pekeppp/2D_Rendering_Acceleration-deprecated-v3.2/doc/赛题二_设计实现与测试报告.md

# 【赛题二】基于 RISC-V 与 FPGA 异构架构的 2D 图形渲染加速引擎
## —— 设计、实现与测试报告

> **作品名称**：《芯绘 · CHIPPAINT》
> **目标平台**：易灵思 Titanium **Ti60F225I3**（16nm，60K LE，F225 BGA）+ Sapphire RISC-V SoC + 256MB DDR3
> **报告口径**：本文所有数字都标了来源 —— **【板测】** = 已在真板上量到；**【仿真】** = 只有 iverilog/QEMU 数据；
> **【模型】** = 由板测数据拟合出来的推算值。凡是"应该"、没有证据的，一律写进第 11 章"已知限制"，不混进结论。

---

## 0. 摘要

本作品在 RISC-V + FPGA 异构平台上实现了一款**自研的 2D 位块传输（BitBlt）硬件加速引擎**，
把"逐像素搬运"这件事从 CPU 手里彻底拿走：RISC-V 只负责高层逻辑与指令下发，
像素级的搬运、Alpha 混合、颜色键控抠图全部由 FPGA 硬件完成。

工程从 v1 迭代到 **v3.2**，中间经历了 **14 次板级问题定位与修复**（非对齐 lane、
指令 FIFO 满丢字、Alpha 定点抽头取错、写仲裁器 AW 握手漏计数、扫描输出饿死 CPU、
读仲裁 `cnt_s` 泄漏、引擎"假完成"导致的 z 序乱跳……），
每一步都留下了 testbench 与 A/B 对照，最终 **44 项 RTL 回归 0 失败**。

三项赛题高阶挑战全部落地：

| 挑战 | 实现 | 证据 |
| --- | --- | --- |
| **硬件 Alpha 混合** | `pixel_path.v` 用 DSP 做定点乘加，支持 alpha / 加算 / 乘法三种混合模式 + 逐像素 ARGB4444/1555 + 全局 alpha | `tb_attr_blend` 32 条判据（含 7 条手算期望值）全过 |
| **颜色键控去背** | 16bit 比较器，整词全键色不提交（省写）；另有 4×4 透明块掩码进一步跳过整块 | `tb_px_path` / `tb_dl_mask` 逐像素比对金标准 |
| **高负载互动游戏 Demo** | `GameDemo`：纵版弹幕游戏，同屏元素（弹+机+火花+星空）全部由引擎绘制；串口 `g` 自动爬坡量化 60FPS 下的同屏极限 | 主机全固件仿真 74 项 + 上位机协议 53 项，0 失败；**基础版已上板跑通** |

**关键性能（板测，v2.16 单 lane 口径）**：

| 精灵尺寸 | FILL | KEY（色键） | ALPHA（混合） |
| --- | --- | --- | --- |
| 16×16 | **514.3** 拍/精灵 | **719.1** | **856.4** |
| 32×32 | 1263.8 | 1617.4 | 1969.0 |
| 64×64 | 4450.0 | 5537.5 | 6742.7 |

拟合式 `每块 = A + B×像素`：FILL `252 + 1.025·px`、KEY `398 + 1.255·px`、ALPHA `464 + 1.533·px`。
60fps 帧预算 1,666,667 拍（core 100MHz）⇒ 16×16 ALPHA 理论 **1946 只/帧**，
取 70% 预算做安全余量 **1362 只/帧**【模型】。

**与纯 CPU 的差距**：同一场景、同一份图集，CPU 逐像素直写 vs 引擎 BitBlt，
同屏几百个精灵时帧率差 **1~2 个数量级**（`FinalDemo` 左右分屏实时对比，`HW=` / `CPU=` 两个数同屏显示）。

---

## 1. 项目概述与交付清单

### 1.1 一句话架构

```
┌───────────────────────────────┐        ┌──────────────────────────────────────────┐
│  RISC-V（Sapphire SoC, 100MHz）│        │  FPGA 2D 加速引擎（自研 RTL）             │
│                               │        │                                          │
│  游戏 / GUI 逻辑              │        │  ① blt_regs_axi_lite  AXI-Lite 寄存器组   │
│  碰撞、生成、AI（只算不画）   │        │  ② cmd_fifo            256 条指令队列     │
│  ↓                            │  8 字  │  ③ blt_engine_fsm      主控状态机         │
│  下发渲染指令 ────────────────┼───────►│  ④ pixel_path         像素通路（双 lane） │
│                               │ APB→   │      · FILL / COPY / ALPHA / KEY          │
│  ↑                            │ AXI    │      · DSP 定点混合 + 色键抠图            │
│  FPS / 寄存器回读 ◄───────────┼───────►│  ⑤ axi_rd_master / axi_wr_master          │
│                               │        │  ⑥ dl_fetch           显示列表取指器       │
│  C 驱动 + 双/三缓冲           │        │                                          │
└───────────────────────────────┘        └──────────────┬───────────────────────────┘
         ▲                                              │ AXI4 突发
         │ UART 115200（串口上位机遥控）                 ▼
         │                                    ┌────────────────────┐
    PC（Web Serial 上位机）                    │ DDR3 256MB 16bit   │
                                              │  帧缓冲 / 图集 /  DL │
                                              └─────────┬──────────┘
                                                        │ 扫描输出
                                              ┌─────────▼──────────┐
                                              │ fb_scanout → HDMI   │
                                              │ 1920×1080 @60.1Hz   │
                                              └────────────────────┘
```

### 1.2 交付清单

| 类别 | 内容 | 位置 |
| --- | --- | --- |
| **加速器 RTL** | 12 个模块（≈4,000 行）+ **30 个 testbench**（≈13,600 行） | `rtl/`、`ARC_2DRA/rtl/video/tb/` |
| **板级集成 RTL** | APB 外设顶层、写仲裁器、扫描输出、HDMI 编码 | `ARC_2DRA/rtl/` |
| **位流** | v3.2 位流 + 两个"位流+应用"合一镜像 | `firmware/v3.2/` |
| **应用固件** | 7 个 demo（FinalDemo / AdDemo / GameDemo / fulltest / comptest / comptest2 / FBtest） | `ARC_2DRA/.../standalone/` |
| **上位机** | 4 个单文件 Web Serial 上位机（无外部依赖） | `tools/*.html` |
| **验证工具** | 主机全固件仿真（QEMU）、协议自检（Node）、一键流水线 | `tools/host_selfcheck_game/`、`tools/build_gamedemo.ps1` |
| **文档** | 设计/性能/问题记录/日志共 20+ 篇 | `doc/`、`rtl/功能清单.md` |

---

## 2. 赛题要求逐条对照

### 2.1 基础要求

#### 要求 1：硬件 2D 位块传输（BitBlt）引擎设计

| 赛题原文 | 本作品实现 | 证据 |
| --- | --- | --- |
| FPGA 端解析 RISC-V 发送的渲染指令（**操作类型、源地址、目的地址、宽度、高度**） | 每条形如 **8 个 32bit 字** 写 `CMD_FIFO_DATA(0x08)`：`op / src / dst / src_stride / dst_stride / {H,W} / alpha / color`。`op`：`0=COPY 1=FILL 2=ALPHA 3=KEY` | `rtl/cmd_fifo.v`、`rtl/blt_engine_fsm.v`；`tb_cmd_fifo`、`tb_blt_top` |
| 支持**图像块拷贝（Block Copy）** | `op=0`，源/目的各自带行距，支持任意地址、任意尺寸、非 16B 对齐 | `tb_blt_burst` / `tb_blt_unalign`（U1~U12，lane 0..7 全扫） |
| 支持**纯色填充（Solid Fill）** | `op=1`，`w7` 直接给 RGB565 填充色 | `tb_blt_top`、`tb_perf_probe` |
| 生成**标准 VGA/HDMI 时序**，输出到显示器（**≥640×480@60Hz**） | `fb_scanout.v` + `video_timing_1080p.v` 生成 CEA-861 **1920×1080** 时序（H 总 2200、V 总 1125）⇒ **实际 60.10Hz**，远高于 640×480@60Hz 的下限；帧缓冲 960×540 由扫描输出侧 `SCALE_SH` 放大到 1080p | `ARC_2DRA/rtl/video/video_timing_1080p.v`、`dvi_tx/`；`tb_fb_scanout`、`tb_scanout_scale` |

> **关于"最低分辨率"**：赛题下限是 640×480@60Hz。本作品用 **960×540 RGB565** 帧缓冲，
> 扫描输出到 **1080p@60.1Hz**。放大放在扫描输出侧（`SCALE_SH`），**DDR 带宽零增量**；
> 若把帧缓冲直接做成 1080p，DDR 流量会从 62MB/s 翻到 124MB/s —— 这是刻意避免的。

#### 要求 2：总线读写与存储器优化

| 赛题原文 | 本作品实现 | 证据 |
| --- | --- | --- |
| 加速器通过**系统总线**直接访问内存 | AXI4 主机读写（`axi_rd_master` / `axi_wr_master`），寄存器面走 **AXI-Lite**，板级经 `blt_apb_top.v` 挂在 APB 上（`0xF8100000`） | `rtl/blt_top.v`、`ARC_2DRA/rtl/blt/blt_apb_top.v` |
| 合理使用**突发传输（Burst Transfer）** | 内部按 **16B（128bit）一个词** 打包，`MAX_BURST=16` 的 AXI 突发；写主机做了**突发合并**（`burst_max` 从 1 提到 16，`burst_avg=16.0`） | `rtl/axi_wr_master.v`；`tb_perf_probe` 探针输出 `burst_max=16 burst_avg=16.0` |
| 使用**内部 FIFO 缓存**提高带宽利用率 | ① 256 条指令 FIFO（BRAM 可推断，见 §10 资源修复）；② 写数据 FIFO 深度 16；③ 源读取器**双词槽预取**；④ 扫描输出**四行缓冲环** | `rtl/cmd_fifo.v`、`rtl/sync_fifo.v`、`rtl/stream_reader.v`、`fb_scanout.v` |
| 提高内存带宽利用率 | 整屏 FILL 实测 **0.9958 px/拍**【板测，单 lane】；v3.1 双 lane 仿真 **1.983 px/拍**（**2.0×**） | `tb_perf_probe`：`cyc/px=0.504257 px/cyc=1.983114`（v3.1/v3.2） |

> **DDR 不是瓶颈，读延迟才是**。实测 DDR 占用只有峰值的 9%~28.5%，
> 但"非引擎读流"曾等待 **39,998 拍** —— 所以工程的优化重点一直放在**读仲裁公平性**上（见 §10 第 5、6 条）。

#### 要求 3：软件驱动与基础 Demo

| 赛题原文 | 本作品实现 | 证据 |
| --- | --- | --- |
| RISC-V 端 **C 语言驱动程序**配置寄存器 | `blt_wr/blt_rd` 薄封装 + 语义化 `e_fill/e_key/e_alpha/e_glow`，**所有绘制收敛到唯一出口 `blt_emit()`**（保证"每条命令恰好一个属性字"的配对纪律） | `FinalDemo.c` / `AdDemo.c` / `GameDemo.c` |
| 实现**双缓冲机制**避免画面撕裂 | v2.6 实现 **FLIP**（`FB_SEL` 请求 / `FB_STAT` 已生效，帧边界锁存）；v2.7 升级为**三缓冲**（显示 A / 画 B / 预清 C）+ 并发清屏引擎 + 帧边界中断 | `rtl/blt_regs_axi_lite.v:0x24/0x28/0x2C~0x48`；`tb_scanout_flip`、`tb_clear_engine` |
| 提供**基础测试 Demo**（大量方块随机移动 / 大图快速切换） | `FinalDemo`：N 可达 6000 个方块随机运动 + 弹跳，三条渲染路径任意切换 | `standalone/FinalDemo/src/FinalDemo.c`（2252 行） |
| 实时对比显示**纯软件 CPU 渲染**与**硬件加速渲染**的频率差异 | `FinalDemo`：**同屏分屏**——上半屏硬件引擎画、下半屏 CPU 逐像素画，同一颗种子、同一套推进规则 ⇒ 目标坐标逐位相同，差异只体现在"谁跟得上"；屏幕顶部同屏显示 `HW=nnn CPU=nnn SCR=nn` | 同上；`s/c/h` 三个键切换 SPLIT / 纯 CPU / 纯硬件 |

> **口径诚实性**是这一条的关键：CPU 侧**故意保留**"先擦后画 + 逐块擦旧矩形"的朴素语义、
> 不跟随硬件侧的"每趟整片重铺"优化 —— 否则对比就变成"两种不同工作量的对比"。

### 2.2 高阶挑战

#### 挑战 1：硬件 Alpha 混合

**赛题公式**：`输出像素 = 前景像素 × Alpha + 背景像素 × (1 – Alpha)`

**实现**（`rtl/pixel_path.v`）：

```verilog
// 通道 5/6/5 → 8bit 位复制展开
R8 = {fg[15:11], fg[13:11]};   // 5→8，位复制
G8 = {fg[10: 5], fg[ 8: 5]};   // 6→8
B8 = {fg[ 4: 0], fg[ 2: 0]};   // 5→8
// 定点混合（两积之和必须 18bit）
out = (fg8 * A + bg8 * (255 - A) + 127) >> 8;   // 再量化回 5/6/5
```

**三个层次的可编程性**（v3.2 属性侧口，`0x8C ATTR_PORT`）：

| 项 | 位域 | 说明 |
| --- | --- | --- |
| `blend_mode` | `[3:0]` | `0`=按算子默认 / `1`=alpha 混合 / `2`=加算饱和 / `3`=乘法 |
| `src_format` | `[5:4]` | `0`=RGB565 / `1`=ARGB1555 / `2`=**ARGB4444（逐像素 4bit alpha）** |
| `global_alpha` | `[13:6]` | 整条命令的全局淡入淡出系数 |
| `flags` | `[31:24]` | bit0 = alpha 测试（跳过完全透明像素）/ bit1 = 强制不透明 |

有效 alpha：`A = ⌊sprite_alpha · global_alpha / 255⌋`，
其中 `sprite_alpha` 可以来自**命令字**（`w6`，8bit）、**描述符**（`dw2[23:16]`，8bit）、
**属性字**（`global_alpha`，8bit）或**像素本身**（ARGB4444 的 4bit）。

**验证**：`tb_attr_blend.v`（545 行）32 条判据全过，其中 **7 条手算期望值**：

| 用例 | 输入 | 期望输出 |
| --- | --- | --- |
| L1 | `7BEF/C618 @ ga=128` | `A4F4` |
| L2 | 乘法模式 | `5AEB` |
| L3 | 加算 `1082/2945` | `39C7` |
| L4 | ARGB4444 `8ABC @ ga=128` | `BE18` |
| L5 | ARGB1555 `87E0 @ ga=64` | `B692` |
| L6 | `α=0` + alpha 测试 | 留孔（不写） |

> ★ L1~L6 这 7 条手算值**抓到过 TB 作者自己的位抽取错误**（把 `R8={r,r[4:2]}` 写成 `{r,r[2:0]}`）——
> 纠正后与 RTL 逐位一致。"表与 RTL 不一致时先怀疑表"这条经验也是那次留下的。

#### 挑战 2：颜色键控去背（Color Keying）

| 层 | 做法 | 收益 |
| --- | --- | --- |
| 像素级 | 16bit 比较器 `keep = (fg != key)`，键色由 `w7` 每命令可编程（软件约定洋红 `0xF81F`） | 不规则边缘精灵完美抠图 |
| **整词级** | 一个 128bit 词（8 个像素）**全部**等于键色 ⇒ **不提交这次写** | 省写带宽 |
| **块级（S3，v2.12）** | 4×4 网格覆盖整颗精灵，位 `rt*4+ct=1` 表示"这一块一个像素都不用碰"（不取数、不 blend、不写）。判据：该块**每一个**像素都等于色键才置 1 | 只收缩行两端 |

掩码生效条件（RTL 里显式限定）：`MASK_EN && OP==KEY && W≥4 && H≥4`；
FILL/ALPHA/COPY **显式忽略**掩码（测试台用全 1 掩码反证过）。

**实测收益**（`tb_dl_mask`）：收益完全取决于美术 —— 圆盘精灵 **0%**（每个 4×4 块都压着实体像素），
典型弹幕 **−4.5% / −21.4%**，小尺寸弹 **−68.1%**。

#### 挑战 3：高负载互动游戏 Demo

见第 7 章（完整展开）。

### 2.3 技术提示对照

| 提示 | 本作品 |
| --- | --- |
| 总线推荐 AXI4 或 Wishbone | **AXI4** 主机读写 + AXI-Lite 寄存器面（板级经 APB 桥） |
| 显存组织建议双帧缓冲 | 双缓冲 → **三缓冲 FLIP**（v2.7），上屏零 DDR 搬运 |
| 指令队列：设计指令 FIFO 允许批量下发 | `cmd_fifo` **256 条**；另有 **显示列表**（DDR 描述符表，硬件取指展开）作为更高阶的替代 |
| 性能测量：显示实时 FPS 并对比纯软件 | `FinalDemo` 同屏 `HW=` / `CPU=` / `SCR=` 三个数；成本行 `EV cmd path done: n=.. cycles=.. cyc/sprite=..`（1Hz 门控） |

---

## 3. 硬件平台与系统架构

### 3.1 平台参数

| 项 | 参数 |
| --- | --- |
| FPGA | 易灵思 Titanium **Ti60F225I3**，16nm FinFET，**60K LE**，F225 BGA，VCC 0.95V，4 个 PLL + 内置 OSC |
| DDR3 | **MT41J128M16JT-125**，256MB (2Gb)，**16bit**，最高 800Mbps |
| Flash | GD25LQ64，8MB QSPI（位流 ~3.5MB + 应用） |
| 视频 | HDMI TX（HSIO 直出 TMDS，支持 1080p@60）；另有 HDMI RX / MIPI D-PHY / LVDS |
| 下载调试 | 板载 FT4232HL Type-C 一线通（供电 / 下载 / **UART**） |
| 主频 | core_clk = **100MHz**（`pt.sdc: create_clock -period 10.000`），pclk = 148.75MHz |
| 时序余量 | V3.0 P&R：setup slack **1.063ns**、hold slack 0.026ns、最高可分析频率 **111.894MHz** |

> **为什么不做 112.5MHz**：V3.0 的 P&R 硬证据给出上限 111.894MHz，hold slack 只剩 0.026ns ⇒ 不可行。
> 本工程的所有优化都建立在 100MHz 之上，不依赖超频。

### 3.2 时钟与视频时序

```
25MHz 板载晶振 ──► PLL_BR0 ──► pclk = 148.75MHz = 25 × 119 ÷ 20
                                   │
                              1920×1080 CEA-861
                              H: 1920 + 88 + 44 + 148 = 2200
                              V: 1080 +  4 +  5 +  36 = 1125
                              ⇒ 148.75MHz / (2200×1125) = 60.10 Hz
                              行周期 2200 / 148.75MHz = 14.81µs = 1481 core 拍 @100MHz
```

扫描输出的取数预算：一行 1920B = **120 拍 128bit**。
优化前占行周期 73%（1080 拍），v2.5 后降到 **≈250~400 拍（约 20%）**，
余量从 0 提到约 27%。这是"左侧黑三角闪烁"问题的根因，见 §10 第 5 条。

### 3.3 DDR3 内存映射

`DDR_BASE = 0x00001000`（`soc.h: SYSTEM_DDR_BMB`）；解码窗 `0xE0000000`。

| 偏移 | 用途 | 大小 |
| --- | --- | --- |
| `+0x000000` | 程序镜像（bootloader 从 SPI Flash 搬入） | 1MB（linker `default.ld`） |
| `+0x100000` | （保留 / 备用精灵区） | 2MB |
| `+0x200000` | **精灵图集** `ATLAS_BASE` | 8KB 级 |
| `+0x300000` | **显示缓冲 0** `FB_BASE`（只由引擎/扫描输出写） | ~1.04MB |
| `+0x500000` | **后台缓冲 1** `FB_BACK` | ~1.04MB |
| `+0x600000` | 缓存写穿屏障临时区 `FLUSH_SCRATCH` | 8KB |
| `+0x700000` | **第三块缓冲 2** `FB_BUF2`（三缓冲用） | ~1.04MB |
| `+0x800000` | **显示列表几何表** `DL_GEOM` | 176B |
| `+0x820000` / `+0x840000` | **显示列表缓冲 A / B** | 各 128KB |

**选址的四条理由**：① 避开程序镜像与堆；② **1MB 对齐** ⇒ 自动满足 16B DDR 突发、64B D\$ 行、
AXI 突发；③ 行距 1920B = 120×16B ⇒ 行首 16B 对齐、无跨行碎块；
④ 两块缓冲隔 1MB ⇒ 减少 DRAM 行/bank 冲突。

### 3.4 读/写通路与仲裁

**优先级：扫描输出 > BitBlt 引擎 > CPU**（两级级联 `axi_rd_arb`）。
写通路经 `axi_wr_arb`，B 通道按 owner 分路。

这个优先级不是随便定的：扫描输出有**硬死线**（一行 1481 拍），错过就出黑行；
引擎次之（有帧预算）；CPU 没有死线（慢一点只是游戏逻辑慢）。实测最长等待：

| 场景 | 最长等待 | 出处 |
| --- | --- | --- |
| 优化前，扫描输出抢不到读通道 | **16,071 拍 ≈ 80 行** | `功能清单.md §13` |
| 加 `S_PRIO` 后 | **211 拍** | `功能清单.md §13.6` |

---

## 4. 加速器 RTL 设计

### 4.1 模块划分（`rtl/`，12 个模块 ≈4,000 行）

| 模块 | 行数 | 职责 |
| --- | --- | --- |
| `blt_top.v` | 446 | 引擎顶层：三块子模块 + 写仲裁 + 完成判据合成 |
| `blt_regs_axi_lite.v` | 660 | AXI-Lite 从机 + **完整寄存器组**（0x00~0xB0）+ 属性 FIFO + scissor + LUT 端口 |
| `blt_engine_fsm.v` | 524 | 主控状态机：`S_DEC → S_CHUNK → S_GEOM → S_FILL/S_PUSH → S_WDWAIT → S_DRAIN` |
| `blt_addr_gen.v` | 37 | 纯组合行地址 + 覆盖突发计算 |
| `axi_rd_master.v` | 156 | AXI4 主机读（含 `LEAK_TO` 泄漏看门狗、`AGE_MAX` 老化提权） |
| `axi_wr_master.v` | 219 | AXI4 主机写（突发合并 + `b_pending` 写提交屏障） |
| `pixel_path.v` | 825 | **像素通路**：FILL/COPY/ALPHA/KEY 四算子 + 双 lane + 三种混合模式 + 色键 + 掩码 |
| `stream_reader.v` | 131 | 源读取器：两词槽 + 载入即弹词（`0.889 → 2.0 px/拍`） |
| `cmd_fifo.v` | 75 | 指令 FIFO（BRAM 可推断，深 256 条） |
| `sync_fifo.v` | 76 | 参数化通用 FIFO |
| `clr_engine.v` | 280 | **并发清屏引擎**：后台把目标缓冲铺成背景色；与"正在显示/正在画"的缓冲**硬件互斥** |
| `dl_fetch.v` | 574 | **显示列表取指器（DFU）**：16B 描述符 → 展开成 8 字命令 → 推进同一个 cmd_fifo |

板级集成（`ARC_2DRA/rtl/`）：
`blt/blt_apb_top.v`（APB 外设）、`video/axi_wr_arb.v`、`video/axi_rd_arb.v`、
`video/fb_scanout.v`（666 行，含四行缓冲环 + 3×2×256 LUT）、`video/video_timing_1080p.v`、`video/dvi_tx/`。

### 4.2 指令与寄存器接口

#### 4.2.1 引擎指令：8 个 32bit 字

| 字 | 位 | 含义 |
| --- | --- | --- |
| `w0` | `[1:0]` | **op：0=COPY 1=FILL 2=ALPHA 3=KEY**（>3 ⇒ `STATUS.ERR`） |
| | `[2]` | `MASK_EN`（S3 透明块掩码使能） |
| | `[31:16]` | `MASK[15:0]`：4×4 透明块位图 |
| `w1` | `[31:0]` | `src` 源字节地址（FILL 忽略） |
| `w2` | `[31:0]` | `dst` 目的字节地址 |
| `w3` | `[31:0]` | 源字节行距 `src_stride` |
| `w4` | `[31:0]` | 目的字节行距 `dst_stride`（屏幕 = 1920） |
| `w5` | `[15:0]` / `[31:16]` | **W / H（像素）** |
| `w6` | `[7:0]` | alpha（仅 ALPHA） |
| `w7` | `[15:0]` | FILL 填充色 / KEY 键色（RGB565） |

写入方式：连续 8 次写 `0x08`。**不看 WSTRB**（整字入队）；FIFO 满时反压不丢字。

#### 4.2.2 寄存器映射（`BLT_BASE = 0xF8100000`，12bit 窗口）

| 偏移 | 名称 | R/W | 位域 / 说明 |
| --- | --- | --- | --- |
| `0x00` | `CTRL` | RW | bit0=GO，bit1=IRQ_EN(DONE)，bit2=**SOFT_RST**（脉冲；**会清空属性 FIFO**） |
| `0x04` | `STATUS` | R | bit0=BUSY，bit1=DONE（电平=FIFO空&&IDLE），bit2=**ERR（电平锁存，只有 SOFT_RST 能清）**，bit3=FIFO_EMPTY |
| `0x08` | `CMD_FIFO_DATA` | W | 连写 8 字 = 一条命令；满时 `awready/wready` 反压 |
| `0x0C` | `CMD_FIFO_COUNT` | R | **单位 = 指令条数**（`word_count/8`），深度 256 |
| `0x10` | `IRQ_STATUS` | W1C | bit0=DONE，bit1=**FRAME（每个场边界 1 拍）**，bit2=DL_DONE |
| `0x14` | `IRQ_EN` | RW | 同上三位 |
| `0x18` | `DBG_CUR_CMD` | R | 当前命令 `w0` |
| `0x1C` | `PERF` | R | **上一条命令的引擎周期数** |
| `0x20` | `SCAN_DBG` | R | `[15:0]` 扫描欠载行数，`[31:16]` 取数看门狗中止（正常恒 0） |
| `0x24` | `FB_SEL` | W | `[1:0]` **请求**显示缓冲（0/1/2），帧边界锁存 |
| `0x28` | `FB_STAT` | R | `[1:0]` **已生效**选择，`[31:16]` 场计数 |
| `0x2C` | `CLR_ADDR` | RW | 并发清屏引擎：起始字节地址 |
| `0x30` | `CLR_STRIDE` | RW | 字节/行 |
| `0x34` | `CLR_WH` | RW | `{h[31:16], w[15:0]}` |
| `0x38` | `CLR_COLOR` | RW | RGB565 背景色 |
| `0x3C` | `CLR_CTRL` | W | bit0=GO(脉冲)，`[3:2]`=目标缓冲，bit4=ERR_CLR(脉冲) |
| `0x40` | `CLR_STAT` | R | bit0=BUSY，bit1=目标已清，`[5:2]`=**四块 clean 位图**，bit6=ERR(sticky)，`[31:16]`=AW 突发数 |
| `0x44` | `DRAW_SEL` | RW | `[1:0]` 引擎正在画的缓冲（**写它会清该缓冲的 clean 位**） |
| `0x48` | `CLR_CYC` | R | 上次 clear 的周期数 |
| `0x4C`/`0x50` | `DL_BASE0/1` | RW | `[31:4]` 列表 A/B 基址（16B 对齐；**BUSY 期间写入被静默忽略**） |
| `0x54` | `DL_COUNT` | RW | `[15:0]` 描述符条数（0 = 合法空表，>4095 报错） |
| `0x58` | `DL_CTRL` | W | bit0=GO(脉冲)，bit1=ABORT，bit2=BUF_SEL，bit3=IRQ_EN，**bit4=AUTO_GO / bit5=STRICT_BOUNDS（复位为 1，每次写都要写回 1）** |
| `0x5C` | `DL_STATUS` | R | bit0=BUSY，bit1=DONE，bit2=ERR，bit3=ABORTED，bit4=**STALL（组合位）**，`[9:8]`=ACTIVE_BUF，`[31:16]`=CONSUMED |
| `0x60` | `DL_ERR` | W1C | `[0]`DESC_RANGE `[1]`GEOM_INDEX `[2]`GEOM_RANGE `[3]`SPRITE_BOUNDS `[4]`WATCHDOG `[5]`AXI_RRESP `[6]`DESC_COUNT `[7]`ZERO_SIZE `[23:16]`序号 `[24]`UNSUPPORTED |
| `0x64` | `DL_FAULT_ADDR` | R | 出错地址 |
| `0x68` | `DL_GEOM_BASE` | RW | `[31:4]` 几何表基址（16B/条） |
| `0x6C` | `DL_GEOM_MAX` | RW | `[15:0]` 条目数（**完整 16bit**；0 = 关表） |
| `0x70` | `DL_DST_BASE` | RW | 本列表目标缓冲基址 |
| `0x74` | `DL_CFG` | RW | bit0=PREFETCH_EN，bit1=GEOM_CACHE_EN，`[7:4]`=CHUNK(8)，`[11:8]`=FIFO_WM(4)；复位 `0x483` |
| `0x78` | `DL_TIMEOUT` | RW | `[15:0]` **单描述符看门狗，单位 core 拍**，复位 4096(≈41µs)，0=关 |
| `0x7C` | `DL_PERF` | R | 上次列表 GO→DONE 周期数（**仅 BUSY=0 后有效**） |
| `0x80` | `DL_VERSION` | R | 读回 `32'h0210_0002` |
| `0x84` | `DL_DST_STRIDE` | RW | `[15:0]` 目标字节行距 |
| `0x88` | `DL_FB_WH` | RW | `{h[31:16], w[15:0]}` |
| **`0x8C`** | **`ATTR_PORT`** | W | **属性 FIFO**（深 16 FWFT）。见 §2.2 挑战 1 的位域表；**只写不可读** |
| `0x90`/`0x94` | `CLIP_X0/X1` | RW | scissor 左(含)/右(**不含**)，**本条命令目的矩形的局部坐标** |
| `0x98`/`0x9C` | `CLIP_Y0/Y1` | RW | 上(含)/下(不含) |
| `0xA0` | `CLIP_CTRL` | RW | bit0=ENABLE（复位 0，**可回读**）；命令起始锁存 |
| `0xA4` | `LUT_ADDR` | RW | `[9:8]`=通道(0=R 1=G 2=B)，`[7:0]`=下标 |
| `0xA8` | `LUT_DATA` | W | `[7:0]`，写它产生 1 拍脉冲 |
| `0xAC` | `LUT_CTRL` | RW | bit0=ENABLE(立即生效)，bit1=**写 bank**（显示读的是帧边界锁存值的**反相**） |
| `0xB0` | `LUT_STAT` | R | bit0=正在显示的 bank |

### 4.3 像素通路

```
                ┌──────────── 双 lane（v3.1，只在 dst 偶 lane 上配对）─────────────┐
  16B/词 ──► 源读取器（两词槽预取，2.0 px/拍）
                │
                ├─► 色键比较器  keep = (fg != key)  ──► 整词全键色则不提交
                ├─► 4×4 块掩码（仅 KEY）           ──► 整块透明则跳过
                │
                └─► 【混合通路】唯一一份乘加单元，按 blend_mode 选式：
                        α混合   out = (fg·A + bg·(255−A) + 127) >> 8
                        加算     out = min(255, ⌊fg·A/255⌋ + bg)
                        乘法     out = (fg·bg) >> 8
                     └─► 量化回 5/6/5：{r8[7:3], g8[7:2], b8[7:3]}
                                    │
                            ┌───────▼────────┐
                            │ 128bit 打包器  │（打包乒乓：藏掉每词专属冲刷拍）
                            └───────┬────────┘
                                    ▼  AXI4 写突发（合并后 burst_max=16）
```

**关键性能改造（v3.x 三步走）**：

| 步 | 改动 | 收益 |
| --- | --- | --- |
| ① 像素打包乒乓 | 藏掉每 16B 词的专属冲刷拍 | 每词 9 拍 → 8 拍（**+11%**）**但依赖写主机也提到 8 拍/词** |
| ② 写突发合并真正生效 | 合并判据换口径 + `S_BUF` 愿意等 | 写主机从 **8 拍/词 → 1.13 拍/词** |
| ③ 命令末尾冲刷提示 | 给写主机"命令结束"显式输入 | 尾延迟三段收敛 |

> ★ 第 ① 步有一个值得记的教训：仿真里 `wd_full=0`、写主机 idle 66,988 拍，
> 看起来"写通路与像素通路打平、余量=0"；**板上 B 往返只要比仿真多 1 拍，这 11% 收益就会被吃光**。
> 所以第 ②③ 步不是"锦上添花"，而是第 ① 步能否兑现的前提。

### 4.4 显示列表（DFU 取指器，v2.11）

**动机**：板测"每块一次 CPU 下发"≈**190 拍/块**（1 读 COUNT + 8 写 DATA 走 APB 桥），
把 16×16 FILL 从引擎自身能到的 367 拍/块抬到 561 拍/块。

**做法**：DDR 里放**紧凑描述符表**，硬件取指器自己展开成与 CPU 逐位相同的 8 字命令，
推进**同一个** `cmd_fifo`（引擎 FSM / 像素通路一行未改）。

```
描述符 = 16B = 4 字 = 恰好 1 个 128bit AXI beat（小端）
  dw0 [15:0]=X(signed)  [31:16]=Y(signed)
  dw1 [15:0]=SPR_ID     [31:16]=FLAGS
  dw2 [15:0]=KEY(0xFFFF=用几何表默认) [23:16]=ALPHA [31:24]=PRIO
  dw3 [15:0]=MASK_ID    [23:16]=W_OVR [31:24]=H_OVR

FLAGS：[1:0]OP [2]MIRROR_X [3]MIRROR_Y [4]CLIP_EN [5]SIZE_OVR [6]SRC_OFF_EN
       [7]MASK_EN [9:8]MASK_MODE [10]END_OF_LIST [11]IRQ_AFTER [12]CHAIN
       （MIRROR / SRC_OFF / CHAIN / MASK_MODE≠01 未实现 ⇒ 报 DL_ERR.UNSUPPORTED）

几何表 = 16B/条（16 条直接映射 cache）
  gw0=ATLAS_BASE   gw1=[15:0]ATLAS_STRIDE [31:16]KEY_DEFAULT
  gw2=[15:0]W [31:16]H   gw3=[15:0]SX [31:16]SY
```

**板级现实**：ALPHA/KEY 场景的描述符取指会被 DDR 争用饿过 `DL_TIMEOUT`
（即使把看门狗从 4096 拍提到 65535 拍仍触发，`stall_seen=1`）。
固件写了**三条硬上界**的自动重试（一次事件最多 1 次、1s 窗口内第二次即停用、重试自身失败即停用），
避免退化成"同一帧反复重画整趟"的永久重试环。**结论：演示主力用逐条下发，列表路径作为可选加速。**

### 4.5 属性侧口 / scissor / 扫描输出 LUT（v3.2 / S5）

| 功能 | 关键设计 | 为什么这么做 |
| --- | --- | --- |
| **属性侧口** | 深 16 的 **FWFT** 属性 FIFO；引擎在**每条命令起始**（`S_DEC`，8 个命令字弹完后）按序弹一个 | 刻意**不用** `sync_fifo` 那种"同步读 + 假空窗口"——属性与命令按序配对，任何一次假空都会让后续属性整体错位（**静默错模式**） |
| **scissor** | 与 S3 的行窗口**求交**；整行在外则走"空窗口跳过"（不取数、不算、不写）。坐标是**本条命令目的矩形的局部坐标**，半开区间 `[x0,x1)×[y0,y1)`，命令起始锁存 | 完全不碰像素通路 ⇒ 关闭时**逐位原样返回**，零代价 |
| **扫描输出 LUT** | 3 通道 × 2 bank × 256 项 8bit→8bit，插在行缓冲之后、输出级之前；读地址由 `px1` 级组合给出 ⇒ **不新增流水级、不产生 1 像素相移** | 全屏淡入淡出/白闪**零 DDR 带宽** |

**兼容档保证**：`blend=0` 时属性字**整字惰性** ⇒ 四种算子与 v3.1 逐位相同。
默认字 `0x0000_3FC0` = 位域精确的"blend 0 / RGB565 / ga 255 / flags 0"。
**最强证据**：`tb_perf_probe` 的 310 行 `PROBE *` 输出与 v3.1 的日志**逐行完全一致**
（整屏 FILL 261,407 拍、`burst_max=16`/`burst_avg=16.0`、`wd_full_cyc=0`）⇒ **未使用时吞吐代价为零**。

### 4.6 资源与实现

| 项 | 数值 |
| --- | --- |
| 新增触发器（v3.2 S5） | ≈ +250（引擎侧属性/scissor ≈132，寄存器组侧 ≈99，scanout ≈8，**像素通路 0 个**，全是组合逻辑） |
| 新增存储 | 3 块 512×8 双口 RAM（LUT 三通道，各 1 个 18Kb BRAM 量级）+ 属性 FIFO 的 16×32 分布式 RAM |
| 时序 | V3.0 P&R 最紧路径**不在像素通路**（`u_eng.issue_r → u_dl.rd_beats`，slack 1.063ns @100MHz），上限 111.894MHz |

---

## 5. 软件层设计

### 5.1 驱动与 BSP

| 项 | 说明 |
| --- | --- |
| BSP | Efinity Sapphire SoC BSP（`bsp.h` → `soc.h/uart.h/clint.h/print.h`） |
| 时钟口径 | `SYSTEM_CLINT_HZ = 100000000`（core 域），`tick32()` 只读 CLINT mtime 低 32 位（1 次总线读，而不是 `clint_getTime` 的 3 次） |
| 寄存器访问 | `blt_wr(off,v) / blt_rd(off)` 两个薄封装（`BLT_BASE = 0xF8100000`） |
| 唯一命令出口 | `blt_emit(attr, op, src, dst, ss, ds, w, h, alpha, color)` —— 属性配对纪律靠它保证 |
| 缓存一致性 | `cache_evict()`：向 `FLUSH_SCRATCH` 写 8KB（**store 有序屏障**，D\$ 是写穿）。**禁用 `data_cache_invalidate_all()` 代替 flush**（写回模式下会丢脏行） |
| UART | 非阻塞轮询；**RX 占用 = `status[31:24]`**，TX 余量 = `status[23:16]`（早期用错 `>>16` 导致串口指令完全无效） |

### 5.2 双缓冲 → 三缓冲 → FLIP

| 版本 | 方案 | 代价 |
| --- | --- | --- |
| 早期 | 后台缓冲 → **整帧 COPY** → 显示缓冲 | 实测 ≈**1.89M 核拍 ≈ 19ms**/帧，**超过 16.7ms 场周期** ⇒ 上限被钉在 ~53fps |
| v2.6 | **FLIP**：写 `FB_SEL` 请求，扫描输出在帧边界锁存基址 | 一次 DDR 搬运都不做（省下 19ms 给内容） |
| v2.7 | **三缓冲**（显示 A / 画 B / 预清 C）+ **并发清屏引擎** + **帧边界中断** | 背景重铺也不进关键路径 |

**"不撕裂"的保证链**（每一条都有独立机理）：

1. 写 `FB_SEL` 只是**请求**，扫描输出在**垂直消隐起点**锁存 ⇒ 一场之内只读一个缓冲；
2. `FB_STAT[1:0]` 是**已生效**的选择，软件等它变成请求值才认为"这一帧上屏了"；
3. 有界超时（100ms ≈6 场）后**重发请求继续等**，绝不退化成"往可能正在上屏的缓冲里画"；
4. **硬件互斥**：清屏引擎的目标 == 正在显示 / 正在画的缓冲 ⇒ 一个像素都不写并置 ERR ——
   "清屏不会破坏正在上屏的缓冲"是**硬件保证**，不依赖软件正确性。

### 5.3 Demo 家族

| Demo | 行数 | 定位 |
| --- | --- | --- |
| **FinalDemo** | 2252 | **硬件 vs 纯 CPU 同屏实时对比**（赛题基础要求 3）。三条路径 SPLIT/纯CPU/纯硬件；场景 FILL/ALPHA/KEY；N 25~6000；三种精灵尺寸 16/32/64 运行时可切；显示列表路径开关 |
| **AdDemo** | 1980 | **纯硬件渲染**：屏幕上每一个像素（含信息条）都由引擎画。5 个场景：GLOW（ARGB4444 + 加算）/ FADE（LUT 淡入淡出，零带宽）/ CLIP（scissor）/ LAYER（COPY 背景 + 辉光 + 白闪）/ THRU（顶到帧预算） |
| **GameDemo** | 1886 | **高负载互动弹幕游戏**（赛题高阶挑战 3），输入全走串口，见第 7 章 |
| fulltest | 1916 | 引擎裸机功能/压测（上板自测簇 2/3/4 的载体） |
| comptest2 / comptest | 794 / 637 | CPU-vs-HW 对比的早期版本 |
| FBtest | 133 | 纯 CPU 写 DDR + HDMI 扫描输出（不用加速器） |

### 5.4 上位机与工具链

| 工具 | 说明 |
| --- | --- |
| `serial_console.html` | FinalDemo 上位机（单文件 Web Serial，离线可用） |
| `ad_demo_console.html` | AdDemo 上位机 |
| `game_console.html` | GameDemo 上位机：**PC 键盘 → `@HH\n` 按键包**（板载按键一个都不用）+ 虚拟手柄 + 4Hz 记分板 |
| `game_console1.html` | 上一项的**增强版**：多一个「敌弹显示模式」面板（FILL/ALPHA/ADD/KEY 切换）+ `OP=` 记分板格 |
| `host_selfcheck/` | AdDemo 主机自检（抽标记段 + 手写期望值） |
| `host_selfcheck_game/` | **GameDemo 主机全固件仿真**：把 `GameDemo.c` 原样 `#include` 进仿真宿主，只覆盖三个基址，在 QEMU riscv32 上跑真主循环 |
| `build_gamedemo.ps1` | 一键流水线：编固件 → 主机自检 → 协议自检 → 位流+应用合一镜像 |
| `make_soc_image.ps1` | 位流 + 应用 → 单个可直接烧写的 `.hex`（带回读校验） |

---

## 6. 性能测试与实测数据

### 6.1 测量口径（**先立口径，再看数字**）

| 指标 | 口径 |
| --- | --- |
| 单位 | **core 拍**（`DL_PERF` 是取指器在 core 域数的周期；逐条路径的秒表是 CLINT mtime，同在 core 域） |
| "每精灵拍数" | 该帧引擎总周期 ÷ 精灵数。**只数精灵**，但周期里含整片重铺；N 大时重铺占比 <3% |
| 帧预算 | 60fps = **1,666,667 拍** @100MHz |
| 报出的三个帧率 | `HW=` 纯硬件渲染趟率 / `CPU=` 纯 CPU 渲染趟率 / `SCR=` **真正上屏帧率**（整帧 COPY 或 FLIP 完成次数）。三者共用同一个 1Hz 窗口、同一次清零 |
| 1Hz 成本行 | `EV cmd path done: n=.. cycles=.. cyc/sprite=..`（逐条）/ `EV dl list done: ...`（列表），同口径可直接比大小 |

### 6.2 板级实测（v2.16 口径，`e` 开、逐条下发）【板测】

**每精灵拍数**：

| 尺寸 | N | FILL | ALPHA | KEY |
| --- | --- | --- | --- | --- |
| 16×16 | 2725 / 1725 / 2025 | **514.3** | **856.4** | **719.1** |
| 32×32 | 1200 / 775 / 950 | 1263.8 | 1969.0 | 1617.4 |
| 64×64 | 350 / 225 / 275 | 4450.0 | 6742.7 | 5537.5 |

（测量粒度：16/32 档 ±0.9%~±4%，64 档 ±7%~±11%）

**拟合式 `每块 = A + B×像素`**：

| 算子 | A（固定开销，拍） | B（每像素，拍） | 渐近吞吐 |
| --- | --- | --- | --- |
| FILL | **252** | **1.025** | 97.6 Mpx/s |
| KEY | 398 | 1.255 | 79.7 Mpx/s |
| ALPHA | 464 | 1.533 | 65.2 Mpx/s |

拟合残差：16×16 与 64×64 **逐拍精确**；32×32 有 **+3.3%** 残差（文档已如实记录 −2.9%/−3.9%/−3.2%）。

**结构性事实**：

- `A_FILL = 252` 拍在 64×64 只占 **5.7%**、在 16×16 占 **49%** ⇒ **尺寸档的杠杆已经用尽**；
- **命令之间零重叠**（`ST_WDWAIT` 写屏障；64 块背靠背只藏 63 拍 = 0.075%）⇒ 固定开销是**串行累加**的；
- 每条命令残留 **19 拍**合并固有代价（16×16 时占 4.4%，调 `TAIL_GRACE` 6~8 可解）。

**带宽**：DDR 实测占用只有峰值的 **9%~28.5%**（线速外推 37.5%）⇒ **带宽不是墙，像素通路才是**。

### 6.3 60FPS 容量表（v2.16 单 lane 板测口径）【模型】

| 场景 | 每精灵拍 | 理论满帧 | **建议 ≤70% 预算** |
| --- | --- | --- | --- |
| 16×16 FILL | 514 | ~3240 | **2270** |
| 16×16 KEY | 719 | ~2318 | **1622** |
| 16×16 ALPHA | 856 | ~1946 | **1362** |
| 32×32 FILL | 1264 | ~1319 | **920** |
| 32×32 KEY | 1617 | ~1030 | **720** |
| 32×32 ALPHA | 1969 | ~846 | **590** |
| 64×64 FILL | 4450 | ~375 | **260** |
| 64×64 ALPHA | 6743 | ~247 | **170** |

**v3.1 双 lane 之后按仿真倍数外推**【仿真】：
整屏 FILL **1.99×**、整屏 COPY **2.48×**、32×32 各算子 1.67~1.80×、16×16 FILL 1.53×
⇒ 上表可保守乘 1.5~1.8×。**但 v3.1/v3.2 未在板上复测，这个外推必须上板确认。**

### 6.4 优化项与实测收益汇总

| # | 优化 | 收益 | 口径 |
| --- | --- | --- | --- |
| 1 | 行级重叠 + 突发流水（§7） | 见 `功能清单.md §7.3` A/B | 仿真 |
| 2 | FIFO 改 BRAM 可推断（§9） | **解决了 PnR 资源爆掉**（改前 PnR 不过） | 板测 |
| 3 | 扫描输出取数加速 + 优先级（§13/§15） | 最长等读通道 **16,071 → 211 拍**；单行占用 **73% → 20%** | 板测 |
| 4 | 写提交顺序屏障（§19） | 重叠区 z 序乱跳消失；代价 = 命令尾一次写往返（T4a +2 / T4b +0 / T4d +38 拍） | 板测+仿真 |
| 5 | 整屏 COPY → FLIP（§20） | 省下 **1.89M 拍/帧**（≈19ms > 16.7ms 场周期） | 仿真 + 板测 |
| 6 | 三缓冲 + 清屏引擎 + 帧中断（§21） | 背景重铺（≈2.1ms）移出关键路径 | 仿真 |
| 7 | 像素打包乒乓（§22） | 每词 9→8 拍（+11%）**前提是写主机也 8 拍/词** | 仿真 |
| 8 | 写突发合并（§23） | 写主机 **8 → 1.13 拍/词** | 仿真 |
| 9 | 显示列表（§25） | 板测"列表 1231 vs 逐条 1286 拍/精灵"（**单次、非严格 A/B**） | 板测（弱证据） |
| 10 | 透明块掩码（§26） | 取决于美术：圆盘 0%、典型弹 −4.5%/−21.4%、小弹 **−68.1%** | 仿真 |
| 11 | 双 lane（§27） | 整屏 FILL **1.99×**、COPY **2.48×** | 仿真 |
| 12 | 属性侧口 / scissor / LUT（§28） | **未使用时吞吐零代价**（310 行探针逐行一致）；scissor 省拍 **1199→212 拍（−82.3%）** | 仿真 |

### 6.5 版本演进与性能轨迹

| 版本 | 主要内容 | 状态 |
| --- | --- | --- |
| v1.0 | 基础 BitBlt（COPY/FILL/ALPHA/KEY）+ 扫描输出 | 板测 |
| v2.5 | 显示通路修复（取数快 + 归属钉住 + 有界公平） | 板测 |
| v2.6 | **FLIP** 翻页 | 仿真 + 板测 |
| v2.7 | **三缓冲 + 帧边界中断 + 并发清屏引擎** | 仿真 |
| v2.8~v2.10 | 打包乒乓 / 写合并 / 命令尾冲刷 | 仿真 |
| v2.11 | **显示列表（DFU）** | 仿真 + 板测 |
| v2.12 | 透明块掩码（S3） | 仿真 |
| v2.13~v2.16 | 软件侧：待生效切换 / 看门狗诊断 / 止住重试风暴 / 64×64 档 | **板测（性能基线）** |
| v3.1 | **双 lane 像素通路（2 px/拍）** | **仅仿真** |
| **v3.2** | **属性侧口 + scissor + 扫描输出 LUT** | **仅仿真**（位流已生成并归档） |

---

## 7. 高负载互动游戏 Demo（高阶挑战 3）

### 7.1 与赛题的对应

| 赛题要求 | 实现 |
| --- | --- |
| 极高同屏元素数量 | 同屏 = 敌弹 + 自机弹 + 敌机 + 自机 + 爆点火花 + 星空，**全部走引擎**；N 上限 **2400** |
| Alpha 混合 | 敌弹/自机弹/火花走**加算混合**（`ATTR_PORT blend=ADD`），每颗弹的 `global_alpha` = 发光强度 |
| Color Keying | 图集统一用 **`0x0000`（纯黑）** 作键色；机体走 `op=KEY` 硬边抠图 |
| 60FPS 稳定 | 三缓冲 FLIP + 并发清屏引擎，**不做整屏 COPY** |
| **同屏数量极限** | 串口 `g` 自动爬坡：逐秒抬 N 直到帧率 <58，打印 `LIMIT N=… fps=… ON=…` |
| 与纯 CPU 对比 | `c`/`h` 键切换，`HW=` 与 `SW=` **两个数都留在屏幕上** |

### 7.2 输入：PC 键盘 → 串口（**板载按键一个都不用**）

```
PC → 板   '@' + 两位十六进制 + '\n'
           bit0 上(W/↑)  1 下(S/↓)  2 左(A/←)  3 右(D/→)
           bit4 开火(J/空格) 5 慢速(K/Shift) 6 炸弹(L/X) 7 暂停(P/回车)
           · 任一键变化立刻发；另外每 100ms 补发一包心跳
板 → PC   EV ...（命令回显）/ ST ...（4Hz 记分板）/ LIMIT ...（爬坡结论）
```

三条设计决定：

| 决定 | 为什么 |
| --- | --- |
| **整包替换语义**（每包携带完整 8 位位图，不是增量） | 丢一个包最多晚 100ms 生效，**永远不会卡住某个方向键** |
| **100ms 心跳** | 4 字节/包 = 40 B/s，串口开销 ~0.35ms/包；顺带喂饱看门狗 |
| **500ms 看门狗** | 标签切走 / 拔线 / 上位机崩了，自机都不会一直飞 |

输入延迟：串口轮询放在**每 4 圈**（不是 FinalDemo 的每 32 圈慢时间片），
主循环一圈 ≈ 一两百拍 ⇒ 轮询间隔 ≈ 几十 µs，**比一个 16.7ms 的帧快两个数量级**。

### 7.3 渲染架构（为什么能顶住几千个精灵）

| 手段 | 说明 |
| --- | --- |
| **三缓冲 FLIP** | 一趟画完只写一个寄存器换显示基址，**零 DDR 搬运** |
| **并发清屏引擎** | 下一块缓冲的背景由硬件后台铺（≈2.1ms），不进关键路径；目标冲突时硬件拒写 |
| **逐条下发** | v3.2 的属性字只有"每条命令配一个"这一种配对方式，16B 描述符装不下 ⇒ 要每精灵不同 alpha/混合就只能逐条（且板级记录里 DL 在 ALPHA/KEY 场景会被饿过看门狗） |
| **一张图集服务两条路径** | 透明处一律 `0x0000`：有属性侧口 ⇒ `op=ALPHA + blend=ADD`（黑像素加 0 = 天然透明，真辉光）；无属性侧口 ⇒ `op=KEY + w7=0`（硬边但完全正确）⇒ **位流能力只影响好不好看，不影响能不能跑** |
| **加算可交换** | 辉光弹之间**没有 z 序问题**，几百颗重叠不需要任何排序 |
| **裁剪** | 弹幕会飞出游戏区，`int16` 负数转 `uint32` 参与乘加会写到帧缓冲之外 ⇒ 每条精灵进清单前先裁成矩形并记源偏移 |

### 7.4 ★ 敌弹显示模式：FILL / ALPHA / ADD / KEY

串口 `5/6/7/8` 直选、`f` 循环。**只作用于敌机放出的弹**（自机弹与火花固定加算），
所以切档时只有弹幕的画法在变：

| 档 | 引擎算子 | 观感 | 16×16 @70% 预算容量 |
| --- | --- | --- | --- |
| **FILL** | `op=1` | 纯色方块，**没有源/键色/alpha** —— 最省，但会盖住底下 | **2269 颗/帧** |
| **ALPHA** | `op=2` + 命令字 `α=160` | 经典半透明；图集是矩形、四角纯黑 ⇒ 半透明把背景压暗，**每颗弹套一个暗方块** | **1362 颗/帧** |
| **ADD** | `op=2` + 属性字 `blend=ADD` | 加算辉光（默认档） | 1362 颗/帧 |
| **KEY** | `op=3`，色键 `0x0000` | 硬边抠图 | **1622 颗/帧** |

> **ALPHA 档的暗方块不是 bug，正是 Color Key 存在的理由** —— 把这条写进文档而不是"想办法抹掉它"，
> 因为它恰好是赛题要展示的"三种算子的差别"。切到 KEY 档方块感立刻消失。

**HUD 报的是"生效档"而不是"请求档"**：ADD 档在没有属性侧口时会降级成 KEY，
`bulm_eff_name()` 是唯一判定点，`OP=` 会如实显示 KEY（串口回包同时给两个值
`EV bulm=FILL (requested; effective=FILL)`）。这是刻意的 —— **"看起来成功了"的假成功是本工程反复踩过的坑**。

**怎么用它量极限**：`4` 拉满 N → `g` 自动爬坡 → 换一档重复 → 比较四次的 `LIMIT N=… ON=…`。
同一份弹幕下 FILL 能顶住的同屏数量明显高于 ALPHA（容量 2269 vs 1362，约 **1.67×**）。

### 7.5 生成器必须跟得上 N（踩过的坑）

主机仿真第一次跑出来的结论：把 N 从 256 跳到 2400，**同屏元素数只到 345**。
根因不是引擎，是**生成器**：老逻辑"每个生成节拍只补一架敌机"，铺满 27 架要 7 秒，
再等弹幕铺开又要几秒 ⇒ 用户按 `4` 之后要等半分钟才看见密集弹幕，
第一反应必然是"这加速器带不动"。

修法：`ENEMY_MAX 16 → 24`（它是"弹幕能不能被喂到 N"的天花板：24×22×240/46 ≈ 2750 > 2400）
+ 生成节拍 22 → 16 帧 + **每拍补到 want**（上限 4 架）+ 环弹发数也随 N 增长。
改完同一次仿真 `ON_max = 784`。

### 7.6 弹池与 O(1) 快路径

`bul_alloc_enemy()` 加了 `if (g_bul_live >= g_ncap) return -1;` 的快路径。
没有它的话池满时**每一次发射**都要扫 2400 个槽；一帧最多 24×24 = 576 次发射
⇒ 最坏 **138 万次循环 ≈ 3~4M 拍 > 一帧预算（1.67M 拍）** ⇒ 表现就是"弹幕铺满的一瞬间掉帧"。

---

## 8. 纯 CPU vs 硬件加速：差距有多大

### 8.1 对比的诚实性设计

| 项 | 硬件侧 | CPU 侧 |
| --- | --- | --- |
| 场景 | 同一颗种子初始化、同一套推进规则 ⇒ **目标坐标逐位相同** | 同 |
| 擦除语义 | 可用"每趟整片重铺"省掉逐块擦除 | **故意保留"先擦后画 + 逐块擦旧矩形"**（朴素语义），不跟随硬件侧优化 |
| 精灵图集 | 同一份 | 同一份 |
| 混合公式 | `pixel_path.v` 定点式 | `blend565()`/`add565()` **同式实现** |
| 显示通路 | 三缓冲 FLIP | 同（两边都用同一套上屏机制，隔离出"谁在画像素"这一个变量） |

### 8.2 观测方式

`FinalDemo` 默认 **SPLIT 模式**：上半屏硬件引擎画、下半屏 CPU 逐像素画，
顶部信息条同屏显示 `HW=nnn CPU=nnn SCR=nn`（三个数共用同一个 1Hz 窗口）。

`GameDemo` 里按 `c` 切到纯 CPU、`h` 切回硬件，`HW=` 与 `SW=` 两个数**同时留在屏幕上**，
按一下就能做实时对比；切换时 1Hz 窗口**重置**（避免读到"半个窗口"的假帧率）。

### 8.3 结论

- CPU 侧每像素要做 16bit 读 + 判色键/混合 + 16bit 写，16×16 精灵约 256 次这样的操作；
  硬件侧同尺寸 ALPHA **856 拍/精灵**（板测）。
- RISC-V 直写 DDR 的吞吐远低于引擎的 **65~98 Mpx/s**（板测渐近值），
  同屏几百个精灵时帧率差 **1~2 个数量级**。
- 更关键的是**CPU 被解放**：硬件模式下 CPU 只做游戏逻辑与指令下发（N=2400 时约
  **21,600 次 APB 写/帧** = 每条命令 1 个属性字 + 8 个命令字，摊到每圈 ≤64 条），
  碰撞/生成/AI 全部还在 CPU 上跑而帧率不掉。

---

## 9. 验证体系与测试结果

本工程的验证分四层，**每一层都能独立复现**。

### 9.1 RTL 仿真回归（`rtl/tb/` + `ARC_2DRA/rtl/video/tb/`，共 30 个 testbench）

```
cd doc/logs && pwsh -File ..\..\rtl\tb\run_regress.ps1
→ 44 项 ALL PASS，0 FAIL（末行 "==== regress failures: 0 ===="）
```

| TB | 覆盖 |
| --- | --- |
| `tb_blt_top` / `tb_blt_burst` / `tb_blt_unalign` | 基本算子、突发时序、**非对齐 src/dst（lane 0..7 × 单行/多行 × W 跨词边界）** |
| `tb_alpha` | **α 全档 6×256 穷举** + lane 0..7 逐像素比对金标准 |
| `tb_cmd_fifo` / `tb_fifo_full` | 指令 FIFO 满边界（**上板簇 3 的守门人**） |
| `tb_wr_order` / `axi_slave_mem_ord` | 写提交顺序屏障；H1 洞统计 `117/0`（屏障 ON）vs `117/55`（OFF） |
| `tb_arb_deadlock` | 写仲裁 AW 握手漏计数（**上板 BUSY 卡死的守门人**） |
| `tb_axi_rd_arb` / `tb_rd_arb_leak` | 读仲裁优先级与 `cnt_s` 泄漏（`57105 vs 0`） |
| `tb_scanout_*`（bw / scale / wd / flip / lut） | 扫描输出带宽、放大、看门狗、翻页、LUT 写表不撕裂 |
| `tb_dl_basic` / `_demo` / `_malformed` / `_mask` / `_arb` | 显示列表：基本、演示、畸形输入、掩码、三流读仲裁共存 |
| `tb_perf_probe` | **310 行探针**：每算子的周期/吞吐/突发统计（也是"未使用新功能时零代价"的证据） |
| `tb_regs_axi_lite` | 寄存器映射端到端（含 v3.2 新增 0x8C/0x90~0xA0/0xA4~0xB0 的落地与脉冲宽度） |
| `tb_attr_blend` / `tb_scissor` | v3.2 属性混合（7 条手算期望值）、scissor（关闭兼容/半开边界/命令起始锁存/省拍） |

**A/B 逃生门**：每个新功能都带 `-DXXX_OFF` 编译开关，回归脚本把"关掉后必须复现旧行为/旧 bug"也作为一个判据。

### 9.2 主机全固件仿真（`tools/host_selfcheck_game/`）

**做法**：把 `GameDemo.c` **原样 `#include`** 进仿真宿主，只覆盖三个基址
（`DDR_BASE`/`BLT_BASE`/`UART_TERM`），用一块 RAM 假装 DDR 和引擎寄存器，
在 **QEMU riscv32** 上把**真主循环**跑 600 个上屏帧。

| 假外设 | 实现 |
| --- | --- |
| 引擎 | `STATUS` 恒为 `DONE\|FIFO_EMPTY`，`CMD_FIFO_COUNT` 恒 0 |
| 时钟 | `clint_getTimeLow()` 每次调用推进 4096 拍（**仿真心跳**） |
| 场边界 | 每 1,666,667 拍把 `FB_STAT = FB_SEL` ⇒ FLIP 确认条件**真被满足** |
| 清屏引擎 | 每 7 个场强制报一次"不干净" ⇒ 命令式整片重铺的退化路径也跑到 |
| 退出 | 跑满 600 帧后写 SiFive test 设备 ⇒ QEMU 自行退出 |

**结果：74 项 0 失败**（A 属性字/定点混合/帧预算模型/信息条宽度 = 12 项；B 串口协议含 2058 条穷举 = 19 项；
C 游戏逻辑含 1800 帧长跑 = 15 项；E 敌弹显示模式 = 7 项；D 主循环仿真 = 15 项）。

观测量示例：`presented=600`、`fps_x10=600`、`ON_max=792`、
四档敌弹渲染帧数 `FILL=65 ALPHA=7 ADD=525 KEY=2`、`未知=0`。

### 9.3 上位机协议自检（Node）

```
node tools/game_console_selftest.js                          → 34 项 0 失败
node tools/game_console_selftest.js tools/game_console1.html → 53 项 0 失败
```

跨端一致性守门人：256 个按键包全部满足**固件 `kp_feed` 的语法**（参考实现）并解出同一位图；
从 `GameDemo.c` 里**现读** `N_MIN/N_MAX`、`KEY_*` 位定义、`BULM_*` 枚举、`g_bulm_name[]`、
`serial_cmd()` 的 `case`，与页面常量逐项对账。

### 9.4 上板自检（开机第一屏）

每次上电固件会打印一组自检读数，把"只能上板才知道"的那几类挡在第一秒：

| 自检 | 期望 |
| --- | --- |
| 未对齐存储 | `aligncheck 0xF800 0x7E0`（奇数 x / 奇数宽度各一次） |
| 边界夹紧 | `clampcheck x=0 y=524 vx=-8` |
| 属性字编解码 | `selfcheck attr: decode_err=0 default=0x3FC0 match=1` |
| 定点混合 | `selfcheck mix: blend=0x780F add=0xF81F addblack=0x1234` |
| 图集 | `selfcheck atlas: corner_err=0` |
| 信息条宽度 | `selfcheck osd: len=62 px=496 limit=512 missing_glyph=0` |
| 位流能力 | `feat: clip=1 lut=1 attr=1` + `bulm: default=ADD` |
| 引擎状态 | `selfcheck: STATUS=.. COUNT=.. SCAN=.. DL_VER=0x02100002` |

稳态运行时 `d` 诊断行的 `flipto / clr to / clr err / stto` **都应恒为 0**。

---

## 10. 版本演进：14 次板级问题的定位与修复

这一章是本工程最有价值的部分 —— **每一个都是"上板才知道"的问题，而且大多数在仿真里看不到**。

| # | 现象 | 根因 | 修复 |
| --- | --- | --- | --- |
| 1 | 串口指令完全无效 | `uart_poll_char` 用 TX 余量（`>>16`）当 RX 占用 ⇒ 判据恒真、读空 RX | 改 `>>24`；另发现 mini printf **只认 `%c %s %d %X %x`**（`%u`/宽度/`%%` 会错位消耗 va_arg 挂死） |
| 2 | 非对齐 dst 特定 lane 出错 | lane 处理边界 bug | `功能清单.md §10.1`，逐 lane 用例 |
| 3 | 指令 FIFO 写满时丢指令 | 满边界丢字 ⇒ 后续所有 8 字指令帧**整体错位 1 个字** | `§10.2`；上板"mis=240 却无 ERR"由此解释 |
| 4 | ALPHA 数值全错 | **绿通道位复制抽头取错**（`{p[10:5],p[8:5]}` 应为 `{p[10:5],p[7:6]}`） | `§11`；R/B 两通道与旧仿真逐位一致，只有绿差 —— 决定性线索 |
| 5 | 时序收敛但板子不启动 | §13 的读侧改动在 CPU 对抗 TB 下不成立 | `§14`，二分 + 回退 |
| 6 | 写仲裁让位那一拍 AW 握手漏计数 ⇒ B 错路 ⇒ **引擎 BUSY 不退** | `axi_wr_arb` 组合直通 + 强制让位不判握手 | `§12`：AW 受理与转发解耦（skid/守护），新 TB `tb_arb_deadlock` |
| 7 | 左侧黑三角闪烁 | 三因叠加：单行占行周期 73% + 抢不到读通道（最长等 **16,071 拍**）+ 仅 2 行缓冲 | `§13`：`S_PRIO`（→211 拍）+ 128bit 拍缓冲 + 连续 AR + **4 行缓冲环** + 重同步看门狗 |
| 8 | 整机跑 1~2 秒后彻底静止 | `S_FETCH` 唯一出口是"收满 120 拍"（**无超时**）⇒ `s_hold` 把 CPU 永久锁在 DDR 之外（程序全在 DDR ⇒ 取指失败） | `§17`：`FETCH_TO/DRAIN_TO/BACKOFF_TO=4096`、按突发持有、rlast 计数排空、`dbg_abort` 单比特 toggle 两级同步 |
| 9 | 第三次上板仍死 | 读仲裁 `cnt_s` 泄漏具有**永久否决权**（AR 已计入但 rlast 永不来） | `§18.8`：`LEAK_TO=256`；TB `57105 vs 0` |
| 10 | 重叠处 z 序高频乱跳 | 引擎**"假完成"**：`sync_fifo.empty = !out_v` ⇒ `BUSY=0` 比 AW 受理早 3~4 拍、比 B 早一次写往返 ⇒ 下条指令 RAW 抢跑 | `§19`：完成判据并上 `b_pending==0 && wd_count==0 && !wd_busy` |
| 11 | 整屏 COPY 19ms > 16.7ms 场周期 ⇒ 上限 53fps | 单帧固定开销超预算 | `§20`：**FLIP**（只换基址，零搬运） |
| 12 | 背景重铺仍在关键路径 | 每帧清屏 568k 周期 | `§21`：**并发清屏引擎**（后台铺）+ 三缓冲轮转 + 帧边界中断 |
| 13 | 帧率被诊断吃掉 | 周期像素扫描走共享读通路（**23,580 次读/帧，代价 2.4~4.7ms/帧**） | `§12`：停用周期扫描，改手动触发；优先用硬件计数器（`SCAN_DBG 0x20`） |
| 14 | **冻屏真根因** | **未对齐 32bit 存储**（`scene_step` 让 x 变奇数 ⇒ alignment 异常 ⇒ 默认 trap 死循环）。**前四次 RTL 修复（看门狗/CDC/LEAK_TO/预热）都是针对幻影** | 用 16bit 收头/收尾；删掉 `x & ~1` 补丁；加开机 `aligncheck` |

**贯穿全程的六条方法论**（都写进了 `doc/开发问题与解决记录.md`）：

1. **先验证测量通道，再采信任何观察结果**（串口方向、状态字段语义、printf 格式串都算通道）；
2. **硬件/TB 证据优于推理**，且"否定性证据"（A/B 两边都 PASS ⇒ 假设被证伪）与阳性结果一样值钱；
3. **A/B 没有差异时先查激励**（`28'h010_0000` 是 bit20 而不是 bit24 ⇒ 两边都 PASS，问题在 TB）；
4. **"完成/释放/归还"的每个条件都要问：它有独立上限吗？**（只修其中一个量，剩下的照样锁死系统）；
5. **现象相同不代表机制相同**：`"屏幕停在最后一帧 + 串口静默"` 至少有三种机制（CPU 对齐异常 / 取不到 DDR 读通道 / 引擎 BUSY 不退），它们被误判了四轮；
6. **每一类"静默失败"都要配一个开机自检**。

---

## 11. 已知限制与后续计划

### 11.1 已知限制（如实列出）

| # | 项 | 说明 |
| --- | --- | --- |
| 1 | **v3.1/v3.2 的性能数字只有仿真** | 功能清单 §27.7/§28.7 明确"未跑 Efinity、上板"；位流已生成并归档，但**板级吞吐读数未归档**。板上判据：整屏 FILL `PERF 0x1C` 应从 ~586k 降到 ~295k 量级 |
| 2 | 双 lane 容量是外推 | `1.5~1.8×` 来自仿真，必须上板用 `g` 自动爬坡确认 |
| 3 | 属性侧口只有仿真 | 若板上不生效，GameDemo 的 ADD 档会自动降级成 KEY（`OP=` 显示 KEY），**不会跑不起来** |
| 4 | 显示列表在 ALPHA/KEY 场景板级不可靠 | 描述符取指被 DDR 争用饿过看门狗（`stall_seen=1`），固件最多重试 1 次即退回逐条 |
| 5 | DDR 读延迟/公平性未根治 | 实测"非引擎读流"最长等 39,998 拍；`AGE_MAX=64` 是估的，`tb_dl_arb` 没做 desc+fg/bg+扫描输出的联合压测 |
| 6 | 32×32 档模型有 +3.3% 残差 | 线性拟合 `A+B×px` 在中间尺寸的固有残差，不是实现错误 |
| 7 | 命令间零重叠 | `ST_WDWAIT` 写屏障的代价（换来 z 序正确）；每条命令残留 19 拍合并代价 |
| 8 | 4bpp 调色板 / 读路径公平性 / 112.5MHz 未做 | 前两项在《性能优化成果与计划》§7 里列为 P2/P3；112.5MHz 有硬证据不可行（上限 111.894MHz） |
| 9 | 文档与代码的部分口径漂移 | 例如 FinalDemo.c 里仍写"列表净亏 43%"（实为 +4.3%）、部分超时文案仍写 87MHz（应为 100MHz）—— 以代码与本文为准 |

### 11.2 后续计划（按优先级）

> ★ **完整的提升清单见 `doc/后续提升方向_赛题对照.md`** —— 那篇按"对赛题评分的贡献 ÷ 成本"
> 排了 18 项，每项给出 依据 / 现状 / 怎么做 / 预期收益 / 代价与风险。下表是它的摘要。

| P | 项 | 验收判据 |
| --- | --- | --- |
| **P0** | **上板复测 v3.2 的四档容量与极限 N** | `g` 自动爬坡给出 `LIMIT N`；`d` 行的 `stto/err` 恒 0 |
| **P0** | **归档板级成本行** | `doc/logs/board_costline_*.txt`，同口径同 N 横比 |
| **P0** | **补「多张大图的快速切换」场景** | 赛题基础要求 3 的举例之一，**目前唯一没覆盖到的字面要求**；顺带给出纯 COPY 吞吐（px/拍） |
| P1 | 参数级调优（`TAIL_GRACE` 4→6~8、`DL_CFG.CHUNK/FIFO_WM`、`AGE_MAX`） | 每命令残留 19 拍合并代价下降；44 项回归仍全绿 |
| P1 | 读路径公平性（文档里的 P2） | 非引擎读流最长等待从 39,998 拍降到 1,000 拍量级 |
| P1 | GameDemo 加「同屏分屏」对比 | 上半屏引擎 / 下半屏 CPU 画同一份弹幕 |
| P1 | 指令下发通路 APB 单字写 → 突发写 | 190 拍/块 → 40~60 拍/块 |
| P1 | 三流联合压测 TB（desc + fg/bg + 扫描输出） | 为读仲裁改动提供前置验证；定出 `AGE_MAX` |
| P2 | 命令间重叠（藏掉 `A`） | 16×16 FILL 514→~390 拍；**必须先有**重叠/非重叠 × 随机提交延迟的新 TB |
| P2 | 寄存器映射抽公共头 | 消除"同一份寄存器表内联重复 6 份" |
| P2 | 修正文档口径漂移 | 把"列表净亏 43%"等作废结论更正 |
| P3 | 4bpp 调色板 | 图集读带宽 ÷2（但实测带宽只占峰值 9%~29% ⇒ 收益有限） |
| P3 | VGA 兼容模式说明 / FPS 历史曲线 / 上位机统一入口 / 自动化回归 | — |

---

## 12. 附录

### 12.1 复现命令

```powershell
# ---- RTL 回归（44 项）----
cd doc\logs; pwsh -File ..\..\rtl\tb\run_regress.ps1

# ---- 编译任一 demo 固件 ----
$env:PATH = "C:\Program Files\Git\usr\bin;<Efinity>\toolchain\bin;" + $env:PATH
make -C ARC_2DRA\par\ddr_demo_ti60\embedded_sw\soc\software\standalone\GameDemo `
     BSP=efinix/EfxSapphireSoc RISCV_BIN=<Efinity>/toolchain/bin/riscv-none-elf-

# ---- GameDemo 一键流水线（编译 → 主机自检 → 协议自检 → 合一镜像）----
powershell -ExecutionPolicy Bypass -File tools\build_gamedemo.ps1

# ---- 只跑主机全固件仿真自检（74 项）----
powershell -ExecutionPolicy Bypass -File tools\host_selfcheck_game\build_and_run.ps1

# ---- 只跑上位机协议自检（34 / 53 项）----
node tools\game_console_selftest.js
node tools\game_console_selftest.js tools\game_console1.html
```

### 12.2 烧写

```
方式 A（推荐）：Efinity Programmer → firmware\v3.2\GameDemo_v3.2_soc.hex
                Programming Mode = SPI Active → 烧完**断电重上电**
方式 B：位流 firmware\v3.2\ddr_demo_ti60_v3.2.bit + 应用 <demo>\build\<demo>.hex
```

### 12.3 关键文档索引

| 文档 | 内容 |
| --- | --- |
| `rtl/功能清单.md` | **RTL 功能的权威清单**，§1~§28 按版本演进，每节含改动清单/实测/残余风险 |
| `doc/赛题二_方案设计与原理讲解.md` | 架构选型与原理讲解 |
| `doc/加速器设计规划_RTL实现.md` | RTL 实现规划 |
| `doc/display_list_design.md` | 显示列表规格 |
| `doc/性能优化成果与计划.md` | 性能优化的历史与计划（**注意 §5 列了 5 条已作废结论**） |
| `doc/perf_probe_report.md` | 探针实测报告 |
| `doc/开发问题与解决记录.md` | **14 次板级问题的完整定位过程** + 15 章 GameDemo 的开发记录 |
| `doc/HDMI输出集成说明.md` | HDMI/扫描输出集成步骤 |
| `doc/DDR3内存分配分析.md` | DDR 映射分析（注意地址以代码为准） |
| `doc/板级集成接线清单.md` | 引脚与约束 |
| `doc/GameDemo_高负载互动弹幕游戏.md` | GameDemo 设计/协议/验收判据 |
| `doc/logs/` | 全部仿真与自检原始日志 |

### 12.4 一句话总结

> 本作品把"2D 渲染"这件事在 RISC-V + FPGA 上做成了**可测量、可复现、可解释**的工程：
> 引擎从 v1 到 v3.2 的每一次改动都有 A/B 与 testbench，
> 14 次上板问题都有"现象 → 根因 → 修复 → 守门人"的完整链条，
> 最终三项高阶挑战全部落地 —— 硬件 Alpha 混合、颜色键控、以及一个
> **同屏上千个精灵仍由硬件绘制、并用自动爬坡量化 60FPS 极限**的高负载互动游戏。
