pekeppp/2D_Rendering_Acceleration-deprecated-v3.2/doc/性能优化成果与计划.md

# 2D 渲染加速器：本批性能优化成果与下一步优化计划

> 覆盖范围：RTL v2.10 ~ v2.16（S1 命令尾冲刷 → S2 显示列表 → S3 透明块掩码 → 64×64 尺寸档）
> 与同时期落地的两件"前提性"改动（像素打包乒乓 v2.8、写突发合并 v2.9），
> 以及把上面全部数字量出来的**测量工具链**（1 Hz 成本行）。
>
> 证据纪律：本文每个数字都标注口径 —— **板上实测 / 仿真实测 / 模型推导 / 未验证**。
> 凡与我方口述数字不符之处，一律以仓库源码/日志/提交为准，并就地写"口径说明"。
> 本文档只写文档，不改任何 RTL/软件；未运行 Efinity（现有时序数据取自已提交的 V3.0 P&R 产物）。

---

## 1. 本批成果总览

### 1.1 一句话

**本批把"每像素 1 拍"这条像素通路地板之外的固定开销与读流量都往下压了一档**
（整屏 FILL −11.07%、AW 事务 −93.7%、32×32 命令尾 −33 拍、典型弹幕弹 KEY −21.4%），
并第一次把"列表路径到底赚不赚"变成了板上一行可读的数字；
但**像素通路本身仍是 1 像素/拍 —— 这一条没被动过，它才是当前唯一的墙**。

### 1.2 成果表

| 项目 | 类型 | 状态 | 关键实测数字（口径） |
| --- | --- | --- | --- |
| **1 Hz 成本行**（测量工具，提交 `725134c`） | 软件 | ✅ 已上板，本批全部数字的来源 | 三尺寸 × 三场景 9 组 `cyc/sprite`（514 ~ 6742 拍）；`EV cmd path done` / `EV dl list done` 各每秒最多一行（板上实测） |
| **像素打包乒乓**（v2.8，提交 `87d0f76` 内含） | RTL | ✅ 仿真 + 板上 | 整屏 960×540 FILL 585,387 → **520,588** 拍（**−11.07%**）；`max_px_run` 8 → **960**；`FLUSH_*` 桶全 0（仿真实测 + 板上 FILL 吻合 0.09%） |
| **写突发合并**（v2.9，提交 `87d0f76` 内含） | RTL | ✅ 仿真 + 板上 | 整屏 AW 64,800 → **4,050**（= ⌈64,800/16⌉，理论下限）；AXI 侧成本 8.0 → **1.13 拍/词**；32×32 命令尾 +52 拍（仿真实测） |
| **S1 命令末尾冲刷提示**（v2.10，`5b6b9a9`） | RTL | ✅ 已上板；目标兑现 **33/52 = 63%**，遗留 19 拍已解释 | 32×32 FILL 1,232 → **1,199** 拍/块；整屏 520,640 → **520,607**；`ENG_WDWAIT` 63 → **30**；回归 **27/27**（仿真实测） |
| **S2 显示列表 / 描述符表**（v2.11，`bba9a60` RTL + `904048f` 软件） | RTL + 软件 | ⚠️ **功能交付并验证；性能目标未达** | 仿真列表路径 367.2 vs 逐条 384.0 拍/精灵（**+4.4%**）；板上同口径一次读数 1,231 vs 1,286（**+4.3%**，单次、非严格 A/B）；ALPHA/KEY 场景仍被看门狗打断（仿真实测 + 板上实测） |
| **S3 透明块掩码**（v2.12，`7099faf` RTL + `e163d44` 软件） | RTL + 软件 | ✅ 功能交付 + 位精确（16 KB、0 mismatch）；收益**取决于美术** | demo 球 **0%**（几何必然）；典型弹 −4.5%（16×16）/−21.4%（32×32）；小弹 **−68.1%**（1,419 → 452 拍）（仿真实测） |
| **64×64 尺寸档**（v2.16，`f47222a`） | 软件 | ✅ 完成 + 双向交叉验证 | 板上 **6,742 拍/精灵**、**92.0 Mpx/s**（= 渐近线的 **94%**）；主机自检 **301/301**；`tb_dl_demo` **67 PASS / 0 FAIL / 0 字节差**（板上实测 + 仿真实测） |
| **回归 + A/B 纪律** | 工程/流程 | ✅ 制度化 | **35** 项 0 失败（含 3 项"预期失败"的 A/B 对照）；3 个 `ifdef` 逃生门下逐位一致（仿真实测） |

---

## 2. 测量方法与工具（本批最值钱的部分）

> 这一节比任何单项优化都重要：本批至少有 4 条结论是被这套工具**推翻**的（见 §5）。

### 2.1 1 Hz 成本行：把"感觉快了"换成"每秒一行数"

固件在两个路径上各打一行**同口径**的成本（`FinalDemo.c` 的 `dl_cost_report()` / `cmd_cost_report()`，
提交 `725134c`）：

```
EV cmd path done: n=<精灵数> cycles=<软件秒表> cyc/sprite=<cycles/n>
EV dl  list done: n=<精灵数> cycles=<DL_PERF>  cyc/sprite=<cycles/n>
```

| 要点 | 内容 |
| --- | --- |
| 门控 | 都是 **1 Hz 门控**（`DL_COST_TICKS = BSP_CLINT_HZ`）：不是每帧、更不是每条，串口不会被刷屏 |
| 单位 | 都是 **core 拍**。`DL_PERF(0x7C)` 由取指器在 core 域计数；逐条路径的秒表是 CLINT `mtime` 低 32 位，CLINT 就在 core_clk 域（`SYSTEM_CLINT_HZ=100000000`，`pt.sdc: create_clock -period 10.000 -name core_clk`） |
| 口径差（**必须知道**） | 列表那行是**纯硬件**（GO→done）；逐条那行是**墙钟**（含 8 次 MMIO/块的 CPU 下发）——后者正是按 `l` 想省掉的东西 |
| 已知污染 | 列表那行的 `n` 只数精灵，`cycles` 里却含同一张表里那条**整片重铺**描述符（W=960 的 FILL）⇒ 小 N 时 `cyc/sprite` 明显偏高；比大小要把 N 加大（N=976 时重铺只占 3%） |
| 为什么它值钱 | 本批**每一个**性能数字都出自这一行；它替换掉了此前几条靠"板上−仿真"反推出来的错误推断（§5 的 (a)(b)(c)） |

### 2.2 两点/三点拟合：从成本行到 `A + B × px` 模型

| 步骤 | 做法 |
| --- | --- |
| 采样 | 三种尺寸各测一趟：16×16（256 px）/ 32×32（1 024 px）/ 64×64（4 096 px） |
| 两点定参 | 用**两端点**（16×16 与 64×64）解 `A`（每精灵固定开销）与 `B`（每像素成本） |
| 三点验残差 | 中间点（32×32）不参与拟合，专门用来看模型对不对 |
| 外推 | 渐近线吞吐 = `1/B` 像素/拍（固定开销被摊薄到 0）；某尺寸的兑现率 = 实测吞吐 ÷ 渐近线 |
| 粒度 | 精灵数 N 由串口网页/命令按 **步进 25** 调（范围 25–6000）⇒ 相对不确定度 = 25/n |

### 2.3 仿真侧纪律：TB + `ifdef` A/B + 逐位一致性 + 回归清单

| 纪律 | 落地 |
| --- | --- |
| 只读探针 | `rtl/tb/tb_perf_probe.v`：不改任何 RTL/寄存器图/FSM，只做层次引用；每个用例给**逐拍直方图**，并要求 `hist_sum − PERF = 0`（不允许"其他"黑洞）；`-DPIXEL_PACK_PINGPONG_OFF` / `-DWR_MERGE_HOLD_OFF` / `-DWR_CMD_END_FLUSH_OFF` / `-DDL_OFF` / `-DMASK_SKIP_OFF` 逐字回到改前读数 |
| A/B 逃生门 | 每个行为改动都配一个 `ifdef`，**两侧都必须 PASS 且位精确读数逐字节相同**（不是"差不多"） |
| 逐位一致性 | FILL/COPY/KEY/ALPHA × 非对齐/行尾残余词：首末像素、写词数、掩码推出的写出像素数、AW/W/B 计数全部逐字节比对（`tb_blt_top` / `tb_alpha` / `tb_blt_unalign` / `tb_blt_burst`） |
| 软件↔RTL 交叉 | `tb_dl_demo`：把**固件 `dl_build()` 原样输出的描述符字节**喂进真实 RTL，比命令字 + 比像素；主机自检则在 PC 上把固件里被标记的源码段（`SPR_MASK_BEGIN/END`、`DL_ENC_BEGIN/END`、`SCENE_BOUNDS`、`DL_LAYOUT`）原样编译运行 ⇒ "被测的就是板上跑的" |
| 回归清单 | `rtl/tb/run_regress.ps1`：**35 项**（其中 `tb_wr_order_off` / `tb_scanout_flip_off` / `tb_clear_engine_off` 是**预期失败**的 A/B 对照项，必须复现旧 bug 才算对）；从 `doc\logs` 目录运行，产物不落仓库根 |
| 写序专项 | `tb_wr_order`：H1（DONE 时刻写通路彻底干净）/ H2（在飞写突发 ≤ 1）是每次改动的必过项 |

### 2.4 板级工具与人为因素

| 项 | 说明 |
| --- | --- |
| 网页串口上位机 | `tools/serial_console.html`（单文件、无外部依赖、Web Serial）：单字符命令 + `=N` 行命令，N 滑块**步进 25**；`l`（列表路径）、`k`（尺寸）、`e`（每趟整片重铺）、`1/2/3`（场景）都在这里 |
| `e` 的语义 | 本批全部读数都是在 **`e` 开**（每趟整片重铺）下取的；稳态下重铺由**清屏引擎在后台**做（`clr fb/to/err` 不涨），因此不在这趟的计时里 |
| 单变量 | 同一场景、同一 N、同一尺寸，只翻一个开关（`l` / `k` / `mask`）前后读两行 —— 这条纪律是 `l` 必须"延迟到帧边界生效"（`0abba96`）的直接原因：旧版一按 `l` 就切，列表在飞时永远切不回去，A/B 根本做不下去 |

### 2.5 口径陷阱清单（本批踩过的）

| 陷阱 | 后果 |
| --- | --- |
| 拿"纯硬件列表"和"含 CPU 的逐条墙钟"直接比大小 | 得到"列表净亏 43%"的错误结论（§5 (c)）；实际 CPU 下发**大部分与引擎重叠**，真正省下的只有 ~55 拍/精灵 |
| 用不同 N 的两行相减 | 每精灵固定开销 / 整片重铺摊薄比例不同，差值里混着 N 的差 |
| 在模式切换与回退重绘期间采样 | 那一趟里既有列表路径又有逐条路径的补画，`cycles` 不是任何一种路径的成本 |
| 把"板 − 仿真"整段当成本地归给某个模块 | 那条差里同时含 DDR 竞争、B 往返、CPU 重叠程度 —— 见 §5 (a) |
| 忘记测量粒度 | 64×64 只跑 350 个精灵、步进 25 ⇒ **±7%**；这一档的任何 3~4% 差异都落在一格之内 |

---

## 3. 实测性能模型（三尺寸 × 三场景）

### 3.1 原始读数（板上实测，`e` 开、60 fps 目标、每命令路径）

| 尺寸 | 场景 | n（精灵/趟） | 一趟拍数 | 拍/精灵 |
| --- | --- | --- | --- | --- |
| 16×16 | FILL | 2 725 | 1 401 490 | **514.3** |
| 16×16 | ALPHA | 1 725 | 1 477 314 | **856.4** |
| 16×16 | KEY | 2 025 | 1 456 264 | **719.1** |
| 32×32 | FILL | 1 200 | 1 516 527 | **1 263.8** |
| 32×32 | ALPHA | 775 | 1 525 961 | **1 969.0** |
| 32×32 | KEY | 950 | 1 536 525 | **1 617.4** |
| 64×64 | FILL | 350 | 1 557 516 | **4 450.0** |
| 64×64 | ALPHA | 225 | 1 517 100 | **6 742.7** |
| 64×64 | KEY | 275 | 1 522 820 | **5 537.5** |

> 口径说明：本表的原始串口日志**未入库**（板上 1 Hz 成本行没有归档到 `doc/logs/`），
> 是本文档首次把它们落成文字；`拍/精灵` 由 `一趟拍数 ÷ n` 复算，与成本行第三列一致。

### 3.2 两点拟合与三点残差（模型推导）

单位：拍/精灵。拟合只用两端点（16×16 与 64×64），32×32 留作检验。

| 场景 | A（拍/精灵） | B（拍/px） | 32×32 预测 | 32×32 实测 | 残差 | 渐近线 `1/B` |
| --- | --- | --- | --- | --- | --- | --- |
| FILL | **252** | **1.025** | 1 301.6 | 1 263.8 | **−2.9%** | 0.976 px/拍 |
| KEY | **398** | **1.255** | 1 683.1 | 1 617.4 | **−3.9%** | 0.797 px/拍 |
| ALPHA | **464** | **1.533** | 2 033.8 | 1 969.0 | **−3.2%** | 0.652 px/拍 |

两点上残差 ≤ 0.03%（它们是拟合锚点）。三个中间点全部**低于**拟合线 2.9%~3.9%，
方向一致、幅度一致 ⇒ 说明真实的 `B` 略小、`A` 略大（32×32 的固定开销比线性外推的要小），
不是随机的测量噪声。

> 口径说明（与口述"残差 3–6%"的差别）：按仓库这组读数复算，中间点残差是 **2.9% / 3.2% / 3.9%**，
> 说"3~4%"更准。它们**落在一格测量粒度之内**：64×64 档 ±7%（n=350、步进 25），
> 32×32 档 ±2.1%（约 2 格）。也就是说这条偏差**没有被单独证明**，只是与粒度相容。

### 3.3 派生指标（模型推导 + 实测混合）

帧预算 = 100 MHz ÷ 60 = **1 666 667 拍**。

| 尺寸 | 场景 | px/拍（实测） | Mpx/s（**瞬时**口径） | Mpx/s（**帧预算归一**口径） | 一趟占帧 | 帧内非本趟拍数 |
| --- | --- | --- | --- | --- | --- | --- |
| 16×16 | FILL | 0.4978 | **49.8** | **41.9** | 84.1% | 265 177（15.9%） |
| 16×16 | ALPHA | 0.2989 | **29.9** | **26.5** | 88.6% | 189 353（11.4%） |
| 16×16 | KEY | 0.3560 | **35.6** | **31.1** | 87.4% | 210 403（12.6%） |
| 32×32 | FILL | 0.8103 | **81.0** | **73.7** | 91.0% | 150 140（9.0%） |
| 32×32 | ALPHA | 0.5201 | **52.0** | **47.6** | 91.6% | 140 706（8.4%） |
| 32×32 | KEY | 0.6331 | **63.3** | **58.4** | 92.2% | 130 142（7.8%） |
| 64×64 | FILL | 0.9204 | **92.0** | **86.0** | 93.5% | 109 151（6.5%） |
| 64×64 | ALPHA | 0.6075 | **60.7** | **55.3** | 91.0% | 149 567（9.0%） |
| 64×64 | KEY | 0.7397 | **74.0** | **67.6** | 91.4% | 143 847（8.6%） |

- **FILL 的渐近线 = 1/1.025 = 0.976 px/拍 = 97.6 Mpx/s**；64×64 实测 92.0 Mpx/s = **渐近线的 94%**。
- 整屏 960×540 FILL（无命令边界）实测 **0.9958 px/拍**（1.0043 拍/px，520 607 拍 / 518 400 px），
  直方图里 518 400/520 607 = **99.58%** 的拍在推进像素 —— 这条独立印证了"B_FILL ≈ 1.0"。

> 口径说明（与口述"FILL 吞吐 41.9 / 73.7 / 92.0"的差别）：这三个数**混用了两种口径**。
> 复算后：`41.9` 与 `73.7` = `n × px ÷ 1 666 667`（**帧预算归一**，即 16×16/32×32 的值），
> 而 `92.0` = `px ÷ 拍`（**瞬时**，64×64 的值）。按帧预算归一，64×64 应是 **86.0**，不是 92.0。
> 本文因此把两列都给出来；引用单个数字时必须说明是哪一列。

> 口径说明（与口述"非通过帧开销 110–150k 拍 = 7–9%"的差别）：9 组读数的区间实际是
> **109k ~ 265k 拍（6.5% ~ 15.9%）**。"110–150k / 7–9%" 只覆盖 32×32 与 64×64 六组；
> 16×16 三组是 189k~265k（11.4%~15.9%），其中 16×16 FILL（n=2 725，精灵数最多）是离群点。

### 3.4 64×64 这一档说明了什么

- 每精灵固定开销 `A_FILL = 252` 拍，只占 64×64 一条命令的 **5.7%** ⇒ **尺寸档这个杠杆已经用尽**：
  继续加大精灵只会让 `Mpx/s` 无限逼近 97.6 的天花板，而那个天花板就是**像素通路自己**。
- 反过来，16×16 时 `A` 占 514 拍里的 **49%** ⇒ 小精灵场景的成本一半在"每条命令的固定动作"上，
  这解释了为什么 S2（想省掉命令下发）在 16×16 上被寄予厚望（也解释了它为什么没能兑现，见 §4.3）。
- 64×64 的价值不是"更快"，而是**给出了缩放律和本批最好的绝对吞吐数**（92.0 Mpx/s）。

---

## 4. 各子项详情

### 4.1 成本行（S0，提交 `725134c`，软件）

| 项 | 内容 |
| --- | --- |
| 做了什么 | 两条路径各一行 1 Hz 成本（格式见 §2.1）；同时止住"看门狗重试风暴"：**一次事件最多重试 1 次**、1 s 窗口内第二次事件**直接停用**列表路径（不再自动重臂，按 `l` 重开）；失败提示按 `idx / CONSUMED / stall_seen` 改说"取指被饿住"，不再一律甩给几何表 |
| 实测数字 | 全部 9 组读数（§3.1）；板上 ALPHA/16×16 同口径一次读数 list **1,231** vs cmd **1,286** 拍/精灵（**+4.3%**），与仿真预测的 +4.4% 吻合 |
| 是否符合预期 | ✅ 超预期：本条不是优化而是**工具**，却直接作废了三条旧结论（§5） |
| 遗留问题 | ① 原始串口日志未入库；② 边沿陷阱（§2.5）靠注释提醒，工具本身不能自动识别被污染的读数 |

### 4.2 S1 命令末尾冲刷提示（RTL v2.10，`5b6b9a9`）

| 项 | 内容 |
| --- | --- |
| 做了什么 | 引擎在进入 `ST_WDWAIT` 那一拍给出 `wr_cmd_end`（"本命令再也不会产出写词"）；写主机据此进**尾模式**：放宽 `word_here`（不再要求"队头之后还有货"）、等待判据由"等满 `HOLD_MAX=16`"改成"`wd_count==0` 后再等 `TAIL_GRACE=4` 拍就发车"。只改 `axi_wr_master`（+1 端口/+1 参数/+4 FF）、`blt_engine_fsm`（+1 组合输出）、`blt_top`（1 根线） |
| 实测数字（仿真） | 32×32 FILL **1 232 → 1 199** 拍/块（−33）；整屏 960×540 FILL **520 640 → 520 607**（−0.0063%）；`ENG_WDWAIT` **63 → 30**；AW **4 051 → 4 050**（= 理论下限）、`burst_avg` 15.996 → **16.000000**；COPY/ALPHA/KEY(32×32) 均 −33；回归 **27/27**；三个 `ifdef` 模式（默认 / `-DWR_CMD_END_FLUSH_OFF` / `-DPIXEL_PACK_PINGPONG_OFF`）下 PASS 行逐字节相同 |
| 是否符合预期 | ⚠️ **部分**：+52 拍里消掉 33 拍；剩下 **19 拍已解释** = 最后一整页 16 拍突发自身的 AW→W→B（写序保证要求引擎收到那笔 B 才许报完成，属"真实数据搬运"而非等待） |
| 遗留问题 | ① 每条命令仍有 19 拍的合并固有代价（整屏摊薄 0.01%，16×16 这种小命令占 4.4%）；② `TAIL_GRACE=4` 是按 `sync_fifo` 写→`dout` 3 拍流水 + 1 拍余量估的，**若上板发现尾词偶发被切**（AW 笔数比理论下限多）应调到 6~8（参数，无逻辑代价）—— 16×16 FILL 的 32 个词被切 16+15+1 三笔（理论 2 笔）就是这个边界的已知表现，CPU 路径与列表路径**逐项相同** |

> 口径说明（与口述"S1 兑现 84% 的目标"的差别）：按仓库复算，兑现率是 **33/52 = 63%**；
> 若以"尾延迟桶 63 → 目标回到不合并基线的 10"计，则是 **33/53 = 62%**。
> 仓库里找不到 84% 的出处，故本文一律写 **63%**。

### 4.3 S2 显示列表 / 描述符表（RTL v2.11 `bba9a60` + 软件 `904048f`）

| 项 | 内容 |
| --- | --- |
| 做了什么 | 新增 `rtl/dl_fetch.v`（DFU）：从 DDR 读 **16 B/条**描述符 → 查几何表（16 条直接映射 cache）→ **展开成现有 8 字命令** → 推进**现有 cmd_fifo**。引擎 FSM / 像素通路 / 地址生成**一行未改**。新寄存器 `0x4C~0x88`；desc 读复用 `axi_rd_master` 的第三个 tag（`rd_sel=10`，优先级 fg > bg > desc + `AGE_MAX=64`）；`axi_rd_arb` 一字未动 |
| 实测数字（仿真） | 列表路径 **367.2** vs 逐条（串行口径）**384.0** 拍/精灵 ⇒ **+4.4%**；列表 = 引擎地板（366 拍/精灵）；畸形列表 9 类全部在有限拍内 `BUSY=0` + 正确 `DL_ERR` 位 + 序号 + `DL_FAULT_ADDR`；回归 **32/32**；`-DDL_OFF` 逐字节一致；`tb_dl_demo` 把固件真实描述符喂进真实 RTL ⇒ **DL_ERR=0、渲染区逐字节相同**、67 PASS / 0 FAIL |
| 实测数字（板上） | 场景 1（FILL + SIZE_OVR + 不读几何表）：开关 `l` **测不出差别**；ALPHA / KEY 场景：描述符取指**偶发被饿过 `DL_TIMEOUT`**（看门狗在**随机序号**触发、`stall_seen=1` ⇒ 是"被饿住"不是"死了"）⇒ 固件现在**最多重试 1 次**，随后**停用列表路径**（不会帧率崩塌）。同口径一次读数 list **1,231** vs cmd **1,286**（+4.3%） |
| 是否符合预期 | ❌ **功能达标、性能目的未达**：设计文档 §2.3 的算术是"305 拍里 ~190 拍是 CPU 下发，S2 把它消掉"；实测 CPU 下发**大部分本来就与引擎重叠**（256 条深的命令 FIFO 把它藏住了），真正能省的只有 **~55 拍/精灵（≈4%）** |
| 遗留问题 | ① **列表路径的真实成本仍未被干净地测出来**：那次 1,231 vs 1,286 是**单次**读数，且取自模式切换、带路径回退补画的窗口，**不是有效 A/B**；② ALPHA/KEY 场景下取指会被饿到超时 ⇒ 列表路径在"读多的场景"里实际上拿不到任何好处；③ `FinalDemo.c:1172-1174` 与 `:1750-1751` 的注释**仍写着已被作废的"净亏 1232 vs ~863"结论**，会误导下一个读代码的人；④ 战略价值转移：它真正的用处是当**逐精灵字段的载体**，但按本次复盘的结论，那个载体应当是**属性侧口**而不是 DDR 描述符（见 §7.4） |

### 4.4 S3 透明块掩码（RTL v2.12 `7099faf` + 软件 `e163d44`）

| 项 | 内容 |
| --- | --- |
| 做了什么 | 4×4 块位图（16 bit）走描述符 `dw3[15:0]` + `FLAGS[7]=MASK_EN` + `FLAGS[9:8]=01`；进引擎走命令字 `w0[31:16]`（掩码）+ `w0[2]`（有效位）的**空位**。落地方式是**行窗口**：每行只取/只画 `[第一个非透明列块起点, 最后一个非透明列块终点]`；整条行带全透明 ⇒ **该行 0 取数、0 算、0 写**。`pixel_path.v` 一行未改 |
| 安全规则 | `msk_on = MASK_EN && OP==KEY && W≥4 && H≥4`；**FILL / ALPHA / COPY 显式忽略掩码**（用 `0xFFFF` 全透明掩码反证：读数逐位不变） |
| 实测数字（仿真） | demo 球（键色 61/256 与 229/1024）：**0%**（圆盘半径 = W/2 内切包围盒，**没有任何一个 4×4 块全透明** —— 几何必然，不是实现问题）；典型弹 **−4.5%**（16×16）/ **−21.4%**（32×32）；32×32 小弹 **−68.1%**（1 419 → 452 拍）；列表路径同批读数（`tb_dl_mask`）逐条吻合；位精确：16 KB FB **0 mismatch**；回归 **35/35** |
| 是否符合预期 | ✅ 符合（且**诚实**：任务书点名的 demo 精灵一点都省不了，这一条如实写进了榜单而不是藏起来） |
| 遗留问题 | ① **收益完全取决于美术**：只有 `R ≤ 0.442W`（16×16）或 `R ≤ 0.398W`（32×32）的精灵才标得上**第一块**；② 只收缩行**两端**窗口，**中间**的透明块仍会走一遍（要跳它必须把一行取数拆成多笔突发，属 S4）；③ 掩码由软件算（硬件的 `spr_mask_of()` 在固件 `build_atlas()` 里），**写错没有任何错误位可诊断**，只会少画 |

**阈值与收益对照（模型推导；本文按固件 `spr_color()` 的几何复算并逐条对齐）**

| R/W | 可跳过块数（/16） | 像素占比 | 说明 |
| --- | --- | --- | --- |
| ≥ 0.442（16×16）/ ≥ 0.398（32×32） | 0 | 0% | 四角块的内角仍被实体覆盖 ⇒ 一块都标不上 |
| 0.40 | 3 | 18.8% | 恰好跨过"第一块"的阈值 |
| 0.35 | 4 | 25% | 四角块全部透明 |
| 0.219 | 12 | 75% | 上下两条行带整带透明（32×32 r=7 小弹即此档，掩码 `0xf99f`） |

> 口径说明：这张表**仓库里没有留档**，是按固件几何（圆心 `(W/2, W/2)`、`d2 > r2` 判圆外）
> 独立复算得到的，与 `spr_mask_of()` 的块边界公式（列块起点 `floor(W·ct/4)`）一致；
> 因为 16 个块**等面积**，"块数占比"就等于"像素占比"。
> 另：口述的"图集工具算掩码"在仓库里对应的是**固件的 `build_atlas()`**，
> 离线的 `atlas/`（`convert_rgb565.ps1`）不涉及掩码。

### 4.5 64×64 尺寸档（软件 v2.16，`f47222a`）

| 项 | 内容 |
| --- | --- |
| 做了什么 | `k` 键循环由 16→32 改为 **16 → 32 → 64 → 16**；几何表 8 → **11** 条（三个场景各一条 64×64）；场景初始化边界改成**尺寸感知**；白环厚度由写死的 `SPR_W/2-4` 改成 `SPR_W/8`（16→2px、32→4px、64→8px，观感不随尺寸变） |
| 容量是查过 RTL 的 | `0x6C GEOM_MAX` 是**完整 16 bit RW**（`blt_regs_axi_lite.v:488` 写 `wd[15:0]`、`:616` 读回 `{16'd0, dl_geom_max}`；`dl_fetch` 的 `GEOM_MAXN=1023` 只是文档参数、**未参与比较**，真正的判据是 `spr_id >= s_geom_max`）；几何表 cache 是 **16 条直接映射**（索引 `spr_id[3:0]`、标签 `spr_id[15:4]`，`dl_fetch.v:171-173/251`）⇒ 11 条**零冲突、全部常驻** |
| 实测数字 | 板上 64×64 **6 742.7 拍/精灵**（ALPHA）/ 4 450.0（FILL）/ 5 537.5（KEY）；**92.0 Mpx/s**（FILL，= 渐近线 94%）；主机自检 **301/301**、`27 组（场景 × 尺寸 × 路径）× 64 块 × 4000 步` 越界 **初始 0 / 步中 0**；`tb_dl_demo` 扩到 9 例（含 64×64 + 11 条几何）：**67 PASS / 0 FAIL、0 字节差**；bin **26 930 B**、RAM **25.87%** |
| 是否符合预期 | ✅ 完全符合；并且顺带证实 `A_FILL=252` 只占 64×64 的 5.7% ⇒ **尺寸这个杠杆到头了** |
| 遗留问题 | ① 64×64 的图集是 8 192 B、掩码仍 **0/16**（同样的内切圆几何）；② 每趟精灵数掉到 225~350（像素太多），**测量粒度退化到 ±7%** ⇒ 这一档以后要靠"步进 1"或加长采样窗才能看小改动 |

### 4.6 两项前提性改动（不属于 S1/S2/S3，但它们的收益是建立在它们之上的）

| 项 | 做了什么 | 实测数字 | 是否符合预期 | 遗留问题 |
| --- | --- | --- | --- | --- |
| **像素打包乒乓**（v2.8） | `pixel_path` 加 177 bit staging（`h_acc/h_mask/h_addr/h_v`），词满当拍落 staging、下一拍由独立推词通路送 `wd` FIFO，打包器不再让出一整拍 | 整屏 FILL 585 387 → **520 588**（−11.07%）；`FLUSH_*` 桶全 0；`max_px_run` 8 → **960**；行周期 1 083 → **963** | ✅ 兑现（−0.08% 的读类算子未兑现，原因已解释：旧冲刷拍本来替 `stream_reader` 挡掉了 1 拍重装气泡） | 写侧余量当时为 0 ⇒ 必须先做写合并 |
| **写突发合并**（v2.9） | 合并判据拆成 `dout_v`（本拍 `dout` 上真有未被消费的新词）与 `cnt_more`（吃掉队头后还有货），再加 `HOLD_MAX=16` 的"愿意等"窗口；补 4 KB 跨页检查 | 整屏 AW 64 800 → **4 050**（理论下限）；`burst_max/avg` 1/1.000 → **16/15.996**；写主机 AXI 侧 **8.0 → 1.13 拍/词**；整屏总拍数 +52（+0.010%）、32×32 +52（+4.4%，全在命令尾） | ✅ 兑现，且**余量反转**：写侧不再是瓶颈 | 命令尾多 52 拍 ⇒ 直接催生 S1；AW/W 组合路径与在飞字节数变化需要板上复核（无专项向量） |

---

## 5. 修正与作废的结论（走过的弯路）

| # | 曾经的结论 | 出处 | 为什么错 | 修正后 | 现状 |
| --- | --- | --- | --- | --- | --- |
| (a) | 显示列表会把"稳定 60 的块数"提高 **41~48%** | `doc/display_list_design.md` §2.1/§14.2（可查到的原文是"5 300 块/帧 = +104%"与"S2 单独 ≈3 700 块/帧 = **+42%**"；仓库里没有"41~48%"这一对数字） | 把"板上 561 拍/精灵 − 仿真 366 拍/精灵 ≈ 195 拍"整段当成 CPU 下发成本，并假设它**完全不能与引擎重叠** | 实测 **≈ +4%**（仿真 367.2 vs 384.0 = +4.4%；板上 1 231 vs 1 286 = +4.3%）。真正没能重叠的只有 **~55 拍/精灵** —— 命令 FIFO 深 256 条，CPU 下发绝大部分被藏住了 | 已在本文更正；**代码注释未改**（§4.3 遗留 ③） |
| (b) | 每帧有 **~6.7 ms（40%）** 的固定开销在关键路径上 | 早期板级÷帧率反推 | 把"帧率没到 60"整段归给固定开销，没有区分"引擎在跑"与"帧边界在等" | 实测帧内**非本趟**拍数 **109k~265k 拍 = 6.5%~15.9%**（主流档位 110~150k = 7~9%） | 已作废 |
| (c) | 列表路径在板上是 **净亏 43%**（列表 1 232 vs 逐条 ~863 拍/精灵） | `FinalDemo.c:1172-1174`、`:1750-1751`（注释至今仍在） | **污染的 A/B**：两侧 n 不同、取自模式切换与路径回退重绘的窗口；且拿"纯硬件列表"比"含 CPU 的逐条墙钟" | 同口径 1 231 vs 1 286 ⇒ 列表 **+4.3%**（且这一次也仍不是严格的 A/B，只是口径正确） | **作废**；注释待改 |
| (d) | 整片重铺在列表模式下回到了关键路径 | S2 落地时的推测 | 读代码即否证：两条路径都调用同一个 `hw_pass_arm()`，重铺的触发条件与列表模式无关 | 不成立 | 已作废 |
| (e) | 仿真每精灵成本可以直接搬到板上 | `perf_probe_report.md` §6 的"存储模型仅 32 KB、行为从机无 DDR 争用" | 仿真的存储器模型**没有 DDR 竞争/换页/刷新**，读多的算子绝对值系统性偏乐观 | 仿真列表路径 16×16 **367 拍/精灵** vs 板上 ALPHA/16×16 一次列表读数 **1 232 拍/精灵**（≈3.4×）；同尺寸同场景下仿真单条 ALPHA **464 拍** vs 板上成本行 **856 拍/精灵**（+84%）。**FILL 例外**：整屏 FILL 仿真与板差 0.09% ⇒ FILL 结论可信，读类读数只做相对比较 | 已作废其外推用法 |

> **一条方法论教训**（写进本节而不是藏起来）：本批 5 条作废结论里有 4 条的根因是**口径**，
> 而它们的共同解药就是 §2.1 的那一行成本读数 —— **先造仪表，再下结论**。
> 另一条：`ifdef` A/B + 逐位一致性只能证明"改动没弄坏东西"，**证明不了"改动有收益"**；
> 收益必须在**同一口径、同一 N、同一场景**下比两行数。

---

## 6. 当前瓶颈的根本判断

### 6.1 墙是像素通路自己的 1 像素/拍

| 证据 | 数字 | 口径 |
| --- | --- | --- |
| 每像素成本（两点拟合） | `B_FILL = 1.025` 拍/px = **0.976 px/拍** | 模型推导（§3.2） |
| 整屏 FILL（无命令边界的最好情形） | **1.0043 拍/px = 0.9958 px/拍** | 仿真实测（`tb_perf_probe` T1） |
| 直方图对账 | 518 400/520 607 = **99.58%** 的拍在推进像素，`FLUSH_*` 桶全 0 | 仿真实测 |
| 单 lane 结构 | `pixel_path` 只有一路 16 bit 输出、每拍只装一个 lane；16 B 词 = 8 px | RTL 结构 |
| 每精灵固定开销的位置 | `A_FILL = 252` 拍只占 64×64 的 **5.7%**、占 16×16 的 **49%** | 模型推导 + 板上实测 |

⇒ 64×64 已经跑到渐近线的 94%，**再优化固定开销或读流量都不会把 FILL 顶过 97.6 Mpx/s**
（ALPHA/KEY 更低，因为 `B` 更大）。**唯一能动 `B` 的改动是把像素通路加宽**（§7.1）。

### 6.2 DDR 带宽**不是**限制（含推导）

前提：DDR3 16 bit × 800 Mbps = **1.6 GB/s** 峰值（《赛题二_方案设计与原理讲解.md》§2.2）；
扫描输出 960×540×2 B×60 = **62.2 MB/s**；每趟整片重铺 960×260×2 B ≈ 30 MB/s（`e` 开）。

| 场景 | 每像素访存 | 按**瞬时**吞吐算的流量 | 占 1.6 GB/s |
| --- | --- | --- | --- |
| 16×16 FILL（最低） | 写 2 B | 49.8 Mpx/s × 2 B = 99.6 MB/s；+ 扫描输出 + 重铺 = 192 MB/s | **12.0%**（帧预算归一口径 11.0%；再扣掉重铺 ⇒ **9.1%**） |
| 64×64 FILL | 写 2 B | 92.0 × 2 = 184 MB/s；+ 92 = 276 MB/s | **17.3%** |
| 16×16 KEY | 读 2 B + 写 2 B | 35.6 × 4 = 142 MB/s；+ 92 = 234 MB/s | **14.6%** |
| 64×64 KEY | 读 2 B + 写 2 B | 74.0 × 4 = 296 MB/s；+ 92 = 388 MB/s | **24.3%** |
| 16×16 ALPHA | 读 fg + 读 bg + 写 = 6 B | 29.9 × 6 = 179 MB/s；+ 92 = 271 MB/s | **17.0%** |
| 64×64 ALPHA（最高） | 6 B | 60.7 × 6 = 365 MB/s；+ 92 = 457 MB/s | **28.5%** |
| 线速上界（ALPHA，100 Mpx/s × 6 B） | 6 B | 600 MB/s | **37.5%**（外推，不是实测） |

⇒ 实测口径下 DDR 占用 **9%~29%**，即使按线速外推也只有 37.5%：**带宽不是限制**。
（模型推导；写侧另有独立证据：AW 合并后写主机 AXI 侧成本 1.13 拍/词 ⇒ 可持续 14.2 B/拍 ≈ 1.42 GB/s，
接近峰值，说明**写通道本身**也不是瓶颈。）

> 口径说明（与口述"DDR 带宽在峰值的 9–35%"的差别）：低端 **9.1%** = 16×16 FILL 在**帧预算归一**口径下
> 再扣掉整片重铺（若按瞬时口径、含重铺则是 12.0%）；高端本文实测最高 **28.5%**（64×64 ALPHA），
> **35% 只在"每像素 3 次访存 × 100 Mpx/s 线速"的外推下成立**（37.5%）。
> 上表的假设（2 B/px/流、扫描输出 62.2、重铺 30）已在表内列明；换假设请重算。

### 6.3 DDR 延迟 / 公平性是真弱点

| 证据 | 数字 | 口径 |
| --- | --- | --- |
| 描述符读的最长等待（仿真） | **64 拍 = `AGE_MAX`**（提权生效） | 仿真实测（`tb_dl_arb`） |
| 非引擎读流（CPU）在引擎压满读口时的等待 | **39 998 拍**（窗口 40 000 拍，`WAIT_MAX=32` 兜底） | 仿真实测（`tb_dl_arb` P1） |
| 板上描述符读被饿过 `DL_TIMEOUT` | 看门狗在**随机序号**触发、`stall_seen=1`（=被饿住，不是死了）；超时值已提到字段上界 **65 535 拍**仍会触发 | 板上实测（串口日志；示例行见 `tools/README.md` §3.4） |
| 极端情形 | 引擎把 AR 队列一直压满时，L1 的归还判据 `s_quiet` 让 CPU 整段轮不到（引擎一停立刻放行 98 笔） | 仿真实测（§18 的既有取舍） |

⇒ 判断：**"带宽够、延迟/公平性不够"**。描述符取指是**短突发（≤8 拍）、低频率**的流量，
占用比例只有 18.3% 的授权份额，却会因为引擎长突发把读口压满而被排到 65 535 拍之外。
这条不是吞吐问题，而是**列表路径能不能用**的问题。

### 6.4 结论

1. **吞吐的墙 = 单 lane 像素通路的 1 px/拍**（要动 `B`，只能加宽通路）。
2. **带宽不是墙**（实测 9%~29%，最高外推 37.5%）。
3. **`A`（每精灵固定开销）已经在 64×64 上摊到 5.7%**，只在 16×16 这种小精灵上还占 49% ——
   但小精灵场景同时被读流量与延迟卡住，所以"继续压 `A`"的边际收益有限。
4. **读路径的公平性是现在就妨碍演示的缺陷**（ALPHA/KEY 场景里列表路径会被看门狗打断）。

---

## 7. 接下来的优化计划（按优先级）

### 7.1 P1 双 lane 像素通路（最后一个大杠杆）

| 项 | 内容 |
| --- | --- |
| **依据** | §6.1：`B_FILL = 1.025` 拍/px、整屏 0.9958 px/拍、`A` 只占 5.7%；S1/S2/S3 全部只在压 `A` 或读流量，**没有一条动过 `B`** |
| **预期收益**（模型推导，`A` 不变） | 64×64 FILL 4 450 → **2 302** 拍/精灵（92.0 → **177.9 Mpx/s**，1.93×）；32×32 1 264 → **777**（81.0 → **131.8**，1.63×）；16×16 514 → **383**（49.8 → **66.8**，1.34×）。按 **85% 兑现率**（打包/lane 边界/双掩码的额外拍）⇒ 约 **160 / 120 / 60 Mpx/s**。**不是干净的 2×** —— 因为 Amdahl：`A` 不会跟着减半 |
| **代价** | `pixel_path` 大改（两路 acc/掩码、32 B/词或"两拍一词"、`lane0` 的两种非对齐起点）；`blt_addr_gen`/`blt_engine_fsm` 的行尾与窗口口径（`pp_width`/`pp_dbase`/`pp_dlane0`）；两套 `ifdef` A/B；一次综合 + 板上复核 |
| **风险** | ① **位精确性**：ALPHA 的 `(fg·α+bg·(255−α)+127)>>8` 与 CPU 参考实现必须逐位不变（6 个组合乘法器 → 12 个，四路 8 bit 乘加 + 32 bit 移位/或，**这是新增的最长组合锥**；当前 `core_clk` 最紧 setup 路径其实在 `u_eng.issue_r → u_dl.rd_beats` 的使能锥上、slack 1.063 ns，**不在乘法器上**，所以现在还有余量，但要综合后重看）；② **背压下丢像素**（§22 的 skid 教训：`wd_wr` 寄存一拍 ⇒ 两次推词决定必须至少隔 1 拍）；③ **非对齐 / 行尾**：`tb_blt_unalign` 的 U1~U12（lane 2/3/4/5/7、W=1/8/9/13/20/32、1×64 竖条、行尾残余词）必须全过；④ **写序**：AW→W→B 串行 + 单笔在飞是结构保证，双 lane 不得打破；⑤ ALPHA 的 DDR 流量翻倍到 **~960 MB/s ≈ 60% 峰值**（模型推导）—— 到那时带宽才开始变成需要考虑的东西 |
| **验收标准** | ① `tb_alpha`（α=0/32/64/128/160/255，含 `9B46/FD20/7BEF/0010/C618` 金标准）、`tb_blt_unalign`（U1~U12）、`tb_blt_burst`、`tb_wr_order`（H1/H2）全部 PASS；② 新增 `-DPIXEL_DUAL_LANE_OFF` A/B 项**必须 PASS**，且 OFF 模式读数与今天**逐字节相同**；③ 探针 `max_px_run` 由 960 变 **1 920**（或整行一次）、`FLUSH_*` 桶仍全 0、`hist_sum − PERF = 0`；④ 整屏 960×540 FILL ≤ **275 000** 拍；⑤ 板上 64×64 FILL `cyc/sprite` ≤ **2 600**（对应 ≥ 157 Mpx/s），且 `EV cmd path done` 的 n 与场景不变 |

> **口径说明（重要，与口述"写路径把双 lane 封顶在 ~1.77 px/拍"的差别）**：
> 写路径的**实测**能力是 **1.13 拍/词**，此处的"词"是 `words16B` 计数的 **16 B 词**
> ⇒ 0.885 个 16 B 词/拍 = **14.2 B/拍 = 7.1 px/拍**，**远高于**双 lane 需要的 0.25 词/拍（2 px/拍 × 2 B）。
> 口述的 "0.88 词/拍 = 1.77 px/拍" 只有在把"词"理解成 **32 bit 字**时才自洽（0.88 × 4 B = 3.52 B/拍 = 1.77 px/拍），
> 这与仓库里 `words16B` 的口径矛盾。**结论：写路径不是双 lane 的封顶项**；
> 双 lane 的 1.6~1.9×（而不是 2×）来自 **Amdahl（`A` 不减半）**，最终封顶项是 **ALPHA 的 DDR 流量**与**乘法器锥的时序**。

### 7.2 P2 读路径公平性 / 描述符预取（修"被饿死"）

| 项 | 内容 |
| --- | --- |
| **依据** | §6.3：板上 ALPHA/KEY 场景描述符读被饿过 65 535 拍（`stall_seen=1`）；`tb_dl_arb` 里非引擎读流等 39 998 拍 |
| **预期收益** | 让列表路径在 **ALPHA/KEY 场景真正可用**（现在会被看门狗打断并停用 ⇒ 那些场景拿到的收益是 0）。对 `A` 本身无收益 |
| **代价** | `axi_rd_master` 的 desc 侧权重/ageing + `dl_fetch` 的预取深度（`DL_CFG.CHUNK` 8→16/32、`FIFO_WM`）；寄存器语义微调；一个新的饥饿边界 TB |
| **风险** | 给 desc 加权会挤占 fg/bg（像素读有**硬死线**）⇒ 必须双向验证；改寄存器语义要同步改软件与文档 |
| **具体四件小事** | ① 加深描述符预取（现在一块 `CHUNK=8` 条、水位 `WM=4`）；② 给 desc 流更强的 ageing（现在要等满 `AGE_MAX=64` 才提权，可降到 16~32）；③ **`DL_STATUS.STALL` 做成粘住位**（它现在是组合位，`S_ERR` 之后恒 0，固件只能自己在轮询里粘）；④ **`DL_PERF` 在错误时刻也给"到目前为止"的拍数**（现在必须等 `BUSY=0` 才有效）；⑤ **BUSY 期间写 `0x4C~0x88` 不要静默丢**（现在 `if (ws[0] && !dl_busy)` ⇒ 写进去读回旧值，`7bdd307` 那个"GEOM_MAX 被丢"的坑就是这么来的；应改成反压或至少置一个 ERR 位） |
| **验收标准** | ① `tb_dl_arb` 新增"desc 权重可配 + fg 饥饿拍数 = 0 + desc 最长等待有界"用例；② 板上 ALPHA/16×16 连续 60 s 无 `DL_ERR`，且 `EV dl list done` 与 `EV cmd path done` **两行都稳定出现**；③ 健康表的 `stall_seen` 恒 0；④ `-DDL_OFF` 与 `tb_wr_order_dloff` 读数逐字节不变 |

### 7.3 P3 降低精灵场景的读流量

| 项 | 内容 |
| --- | --- |
| **依据** | §6.2：ALPHA 每像素 3 次访存（6 B/px）是 DDR 占用的最大项（64×64 ALPHA 实测 28.5% 峰值）；KEY/COPY 的源读也是 2 B/px |
| **做法** | ① **调色板 + 4bpp 索引纹理**（源读 2 B/px → **0.5 B/px** + 一次调色板查表）；② **打开 S3 掩码**（已经能用，缺的是"四角留空"的美术：新弹型按 §4.4 的阈值设计） |
| **预期收益**（模型推导） | ALPHA 6 B/px → **4.5 B/px（−25% DDR 流量）**；KEY/COPY 源读 −75%（KEY 4 B/px → 2.5 B/px）；S3 在 32×32 小弹上**已实测 −68.1%**、典型弹 −21.4% |
| **代价** | `pixel_path` 加 4bpp 解包器 + 调色板（16×RGB565 = 32 B，寄存器或 BRAM）；`blt_addr_gen` 的 4bpp 行跨度/非对齐口径（**一个 16 B 词 = 32 个像素**，与现在的 8 px/词完全不同）；美术侧量化 |
| **风险** | ① 4bpp 量化会改变颜色 ⇒ **ALPHA 的位精确基线必须重建**（现在 `tb_alpha` 的金标准是 16bpp 的），要么就严格限制"只有 KEY/COPY 支持 4bpp"；② 解包器加进 ALPHA 的组合锥（时序）；③ S3 的收益全靠美术，**不能算进 KPI 的确定项** |
| **验收标准** | ① 新增 `tb_pal4`：4bpp 解包 + 调色板 + 同一张图在 16bpp/4bpp 两条路径下**像素完全一致**（图案取自调色板）；② `tb_alpha`/`tb_blt_unalign` 在 16bpp 路径上读数逐字节不变；③ 探针新增用例（4bpp ALPHA）的**源读 beat 数 −75%**、写词数不变 |

### 7.4 P4 逐像素 alpha + 可编程混合（走**属性侧口**，不是显示列表）

| 项 | 内容 |
| --- | --- |
| **依据** | S2 的初衷是"把每精灵一次 CPU 下发换掉"，板上只拿到 +4.3%（§4.3）；但"每精灵参数不同"这个需求是真实的。设计文档 §13 原本要用**平行 ATTR FIFO**，被 S2 否掉（两个 FIFO 必须严格同步，错位即**静默错掩码**）；S3 已经证明**命令字空位**（`w0[31:16]`）能承载 16 bit 掩码 ⇒ **侧口应当是"每精灵一次 32 bit 寄存器写"**（CPU 直接写、不经 DDR 取指），而不是再加一条 DDR 取指流 |
| **做法** | 新增 `0x8C ATTR` 寄存器（`{MODE[1:0], ALPHA[7:0], …}`）+ 命令位"本命令取 ATTR"；引擎在 `ST_DEC` 锁存并使用 |
| **预期收益** | **新增表现力**而不是吞吐：逐像素 alpha（弹幕发光/爆炸）、加算/乘法混合（把 ALPHA 从"整精灵常数 α"升级到"纹理自带 α"）；一次 MMIO（~15~25 拍）比一条 DDR 描述符 + 取指风险便宜得多 |
| **代价** | `pixel_path` 的混合模式多选一；"CPU 写 ATTR → 引擎读 ATTR"必须定死配对规则（**先写 ATTR 再写命令**，或用序号配对）；软件每精灵多 1 次外设写 |
| **风险** | ① ATTR 与命令错位 ⇒ 必须像 S2 的 `I2` 一样做整条命令粒度的互斥；② 加算混合会破坏 ALPHA 的金标准 ⇒ 需要一套新金标准并保留旧模式的 A/B |
| **验收标准** | ① 新增 `tb_attr`：配对 / 乱序 / 缺省 / `MODE` 非法编码报错；② `tb_alpha` 在 `MODE=正常混合` 下读数**逐字节不变**；③ 主机自检新增 ATTR 编码用例；④ 板上：同一场景切换 `MODE` 只改观感，`cyc/sprite` 变化 ≤ 1% |

### 7.5 P5 扫描输出颜色 LUT + scissor 裁剪（两件便宜且互不依赖的事）

| 项 | 内容 |
| --- | --- |
| **依据** | 全屏渐变/闪白/受击闪红现在只能靠 CPU 逐像素写，而"诊断/效果代码与被测对象共用一条 DDR 读通路"已经吃过一次大亏（`开发问题与解决记录.md` 第 12 章：1/4 抽样的回读把帧率直接压低）；scissor 则能让"局部重绘"不再依赖整片重铺 |
| **做法** | ① `fb_scanout` 加 **3×256 项 RGB565→RGB565 LUT**（或 32 级亮度 LUT），只改 LUT 寄存器即得到全屏淡入淡出/闪白/染色；② 加 **scissor 寄存器**（`x0/y0/x1/y1`）限制引擎写区域 |
| **预期收益** | 全屏效果**零带宽**（不碰 DDR）；scissor 一次寄存器写代替一次整片重铺（省 ~30 MB/s 与一趟 pass） |
| **代价** | 扫描输出侧一个小 LUT（3×512 B BRAM）+ 引擎侧地址裁剪判据；各一个 TB |
| **风险** | ① LUT 在 `pixel_clk` 域、寄存器在 core 域 ⇒ 需要跨域同步（工程里已有成熟做法，但必须显式做）；② scissor 与 `CLIP_EN`/`STRICT_BOUNDS` 的语义要定清楚（报错还是裁剪） |
| **验收标准** | ① 新增 `tb_scanout_lut`：LUT 全 0 / 全 1 / 阶梯 / 对角线，逐像素比对；② 新增 `tb_scissor`：裁剪边界 × 非对齐 × 越界，且 `-DSCISSOR_OFF` 逐字节回到今天；③ 板上：切换 LUT 时 `SCAN_DBG(0x20)` 不变差 |

### 7.6 P6 主频 112.5 MHz（+12.5%）

| 项 | 内容 |
| --- | --- |
| **依据** | 吞吐 = 像素率 × 频率，`B` 不变 ⇒ 理论上 +12.5% 线性 |
| **预期收益** | 92.0 → **103.5 Mpx/s**（64×64 FILL，模型推导）；与 P1 叠加时按乘法叠（但 P1 之后 DDR 流量会先成为新约束） |
| **代价** | 一次 P&R + 一次上板；`pixel_clk`/DDR 域不变，但所有 core 域路径重新计时 |
| **风险** | ★ **按已提交的 V3.0 P&R 报告，112.5 MHz 收不了**：`core_clk` 10 ns 约束下 setup slack **1.063 ns**，工具算出的 **`Maximum possible analyzed clocks frequency = 111.894 MHz`（周期 8.937 ns）**；112.5 MHz 对应 8.889 ns，比这个上限还紧 0.048 ns。另外 `core_clk` 的 hold slack 只有 **0.026 ns**（≈0，与"hold 余量 ~0"的说法一致）⇒ 频率上探是**掷骰子**。而且最紧 setup 路径现在是 `u_blt/u_eng/issue_r[*] → u_dl/rd_beats[*]/d_addr_r[*]`（S2 新增的取指器使能锥），不是像素通路 |
| **验收标准** | ① P&R 报告 `core_clk` WNS ≥ 0 且 hold ≥ 0（**先证明 111.894 MHz 的上限被推高**，再谈 112.5）；② 上板同一 N / 同一场景下 `cyc/sprite` **不变**（证明"拍"的语义没变）、`Mpx/s` 提高 ≈12.5%；③ 全量回归 + 三个 `ifdef` 逃生门全过 |

### 7.7 P7 明确降级 / 搁置

| 项 | 为什么搁置 |
| --- | --- |
| **S4 命令内多精灵** | 依据是"每精灵固定开销"：`A=252` 只占 64×64 的 5.7%、占 16×16 的 49%。但 S2 已经把"命令下发"换成硬件（只省 4%），而 16×16 场景真正卡住它的是**读流量与延迟**（§4.3 遗留 ②）。⇒ 在 `B` 没降、读路径没修之前，S4 的收益上限很低，且它与写序屏障（`ST_WDWAIT` + `wr_commit_idle`）的交互是全新风险面 |
| **"内部块跳过"（S3 的延伸）** | 现在只收缩行两端；要跳中间的块必须把一行取数拆成多笔突发 —— 那属于 S4 的活。典型弹幕弹的中间块大多压着实体像素，收益未知 |
| **显示列表 RTL 的进一步改进（P2 之外）** | 已实测 +4.3%（且这一次读数仍不干净）；在 `B` 没降之前继续投入只会摊薄人力 |

### 7.8 待办杂项（都不改行为，但都会误导人）

| 项 | 现状 | 要做的事 |
| --- | --- | --- |
| `rtl/dl_fetch.v` 的 Efinity 注册 | **已解决**：`16d6ba8 V3.0` 已把 `ddr_demo_ti60.xml` 的那一行（`<efx:design_file name="../../../rtl/dl_fetch.v" …/>`）连同一次完整综合/P&R 产物与 bitstream 一起提交 | 无需动作；本文的时序数字就取自这次产物 |
| 串口/文档里的超时文案 | **仍写着 `~753us@87MHz`**（`FinalDemo.c:184/186/1148/1557`、`tools/README.md:122-123`），但 core_clk 是 **100 MHz**（`pt.sdc -period 10.000`、`SYSTEM_CLINT_HZ=100000000`、`功能清单.md` §0） | 改成 `~655us@100MHz`（65 535 拍 ÷ 100 MHz = **655.35 µs**）；复位值 4 096 拍同理：47µs@87MHz → **41 µs** |
| `tools/README.md` 的示例读数 | `EV dl arm ok: … GEOM_MAX=8` 是 v2.15 之前的（现在是 **11** 条） | 与下一次固件改动一并更新 |
| 代码里被作废的注释 | `FinalDemo.c:1172-1174` / `:1750-1751` 仍写"列表净亏 43%" | 改为"同口径 1 231 vs 1 286 = +4.3%；旧结论是污染的 A/B，已作废（见 `doc/性能优化成果与计划.md` §5 (c)）" |
| 上板原始日志 | 本批全部板级读数（含 §3.1 九组）**没有归档** | 建议把 1 Hz 成本行按"场景 / 尺寸 / 路径 / N / cyc/sprite"存成 `doc/logs/board_costline_*.txt`，让每个数字都可追溯 |

---

## 8. 附：证据文件索引

### 8.1 提交（`git log --oneline`，新→旧）

| 提交 | 内容 | 对应本文 |
| --- | --- | --- |
| `16d6ba8` | **V3.0**：`dl_fetch.v` 注册进 `ddr_demo_ti60.xml` + 完整综合/P&R 产物（含 bitstream、`ddr_demo_ti60.timing.rpt`） | §7.6 的时序依据、§7.8 第 1 条 |
| `f47222a` | 64×64 尺寸档（`k` 循环 16→32→64、几何表 11 条、尺寸感知边界、自检 301/301、`tb_dl_demo` 9 例 67 PASS） | §3.1、§4.5 |
| `725134c` | **1 Hz 成本行**（`EV cmd path done` / `EV dl list done`）+ 止住看门狗重试风暴 + 诚实的"被饿住"提示 | §2.1、§3.1、§4.1 |
| `ecf2348` | 看门狗诊断与恢复（超时提到 `0xFFFF`、轮询期粘住 `STALL`、post-mortem）、有界重试 ≤2 | §4.1、§6.3 |
| `7bdd307` | 修"ALPHA/KEY 场景列表不可用"（根因：精灵描述符要查几何表 + BUSY 期间 0x4C~0x88 写被静默丢）、新增 `tb_dl_demo` | §4.3、§7.2 ⑤ |
| `0abba96` | `l` 延迟到帧边界生效（否则永远切不回去 ⇒ A/B 做不下去）+ 清屏引擎累计计数 `clr fb/to/err` | §2.4、§2.5 |
| `e163d44` | S3 软件使能：`build_atlas()` 里算 4×4 透明块掩码 | §4.4 |
| `7099faf` | S3 RTL（v2.12）：行窗口 + 整带跳过、`pixel_path` 零改动、`tb_dl_mask` 位精确、`tb_dl_arb` | §4.4 |
| `904048f` | S2-b 软件：几何表 + 16 B 描述符 + 列表乒乓 + `DL_ERR` 回退 | §4.3 |
| `bba9a60` | S2 RTL（v2.11）：`dl_fetch.v` + 寄存器 `0x4C~0x88`、9 类畸形列表 | §4.3 |
| `5b6b9a9` | S1（v2.10）：命令尾冲刷提示、AW→4 050、32×32 1 232→1 199；**S2 设计规格**（`doc/display_list_design.md`） | §4.2、§5 (a) |
| `87d0f76`（V2.5 桶提交） | 内含 **v2.8 像素打包乒乓**与 **v2.9 写突发合并** | §4.6 |

### 8.2 仿真 / 回归日志（`doc/logs/`）

| 文件（节选） | 用途 |
| --- | --- |
| `final_regress_v210_cmdtail.txt` | S1 回归 27 项 0 失败 |
| `final_regress_v211_displaylist.txt` | S2 回归 32 项 0 失败 |
| `final_regress_v212_s3mask.txt` | S3 回归 35 项 0 失败 |
| `final_regress_v213_dlfix.txt` | v2.14 回归（**35 项** 0 失败；提交信息写的是 36/36 —— 口径见 §5 备注） |
| `log_tb_perf_probe*.txt` | 只读探针的全部读数与逐拍直方图（含 `_cmdtail_on/off`、`_merge_on/off`、`_dl`、`log_probe_s3_mask_on/off`） |
| `log_tb_dl_demo.txt` | 固件真实描述符 → 真实 RTL 的交叉验证（**67 PASS / 0 FAIL / 累计不一致字节 0**） |
| `log_tb_dl_mask.txt`、`log_tb_dl_arb.txt` | S3 位精确与收益；三流读仲裁共存（desc 最长等待 64 拍、CPU 等 39 998 拍、desc 授权 18.3%） |
| `log_tb_alpha*.txt`、`log_tb_blt_unalign*.txt` | ALPHA 金标准与非对齐/行尾向量（三个 `ifdef` 模式下 PASS 行逐字节相同） |
| `host_selfcheck_v216_64x64.txt` | 主机自检 **301 项通过 / 0 项失败**（含 `k` 循环、27 组越界断言、图集与掩码、几何表 11 条、描述符字节） |
| `build_v216_64x64.txt` | v2.16 编译：RAM **271 264 B / 25.87%**，链接 0 错误 |

> 缺失项：**板上原始串口日志（§3.1 的九组成本行）未入库** —— 这是本文档唯一"数字在、证据不在"的地方，
> 建议按 §7.8 最后一条补档。

### 8.3 测试台与工具

| 文件 | 说明 |
| --- | --- |
| `rtl/tb/tb_perf_probe.v` | 只读探针（T1~T17：整屏/32×32/16×16、背靠背、掩码 A/B），每个用例 `hist_sum − PERF = 0` |
| `rtl/tb/tb_dl_basic.v` / `tb_dl_malformed.v` / `tb_dl_demo.v` / `tb_dl_mask.v` / `tb_dl_arb.v` | S2/S3 的逐像素等价、9 类畸形、固件描述符交叉、掩码位精确、五路读仲裁 |
| `rtl/tb/tb_alpha.v` / `tb_blt_unalign.v` / `tb_blt_burst.v` / `tb_wr_order.v` | 位精确与写序的四根支柱（每个都配 `ifdef` A/B 对照项） |
| `rtl/tb/run_regress.ps1` | 回归清单（**35 项**，含 3 项预期失败）；从 `doc\logs` 运行，产物不落仓库根 |
| `tools/serial_console.html` + `tools/README.md` | 板级上位机与命令参考（含看门狗判读表、`STALL` 粘住位的用法） |
| `ARC_2DRA/par/ddr_demo_ti60/outflow/ddr_demo_ti60.timing.rpt` | V3.0 P&R 时序：`core_clk` setup slack 1.063 ns / hold 0.026 ns / 最高可分析频率 **111.894 MHz** |
| `ARC_2DRA/par/ddr_demo_ti60/outflow/ddr_demo_ti60.res.csv` | 资源：全片 17 858 FF（23%）、18 111 LUT（31%）、116 RAM、21 DSP；其中 `u_blt` 9 038 FF / 6 970 LUT / 37 RAM / 16 DSP，`u_dl:dl_fetch` 3 208 FF / 2 676 LUT / 7 RAM / 2 DSP |

### 8.4 文档

| 文件 | 用途 |
| --- | --- |
| `rtl/功能清单.md` §22~§26 | 乒乓打包、写合并、S1、S2、S3 的第一手记录（含逐拍根因、残差风险） |
| `doc/perf_probe_report.md` | 探针报告：整屏各部开销、三个 what-if 的算术、2026-09 的三次更新 |
| `doc/display_list_design.md` | S2 设计规格（含被作废的 §2.1/§14.2 外推 —— 见 §5 (a)） |
| `doc/开发问题与解决记录.md` | 第 12 章"诊断把帧率吃掉"、第 13 章"一帧 16.7ms，整屏 COPY 要 19ms" |
| `doc/赛题二_方案设计与原理讲解.md` §2.2 | DDR3 1.6 GB/s 峰值与"带宽不是瓶颈"的原始论证 |
| `doc/logs/README.md` | 日志目录约定 |

### 8.5 本文档自身的不确定项（如实列出）

| 项 | 状态 |
| --- | --- |
| §3.1 九组成本行的原始串口日志 | **未验证**（数字来自口述 + 与 §3.2/§3.3 的内部一致性校验；日志未入库） |
| §5 (a) 里"41~48%"这一对数字 | **未验证**：仓库里能查到的原文是 `display_list_design.md` §14.2 的"+42%"与 §2.1 的"+104%"（5 300 块/帧），没有"41~48%" |
| §4.3 "场景 1 开关 `l` 测不出差别" | **板上实测，但原始日志未入库** |
| §4.4 的阈值/收益对照表（R/W → 块数） | **模型推导**：本文按固件几何独立复算，与 `spr_mask_of()` 同公式，仓库里没有留档 |
| §7.1 的 1.6~1.9× 与 85% 兑现率 | **模型推导**：`A` 不变 + `B` 减半的 Amdahl 算术，尚未实现 |
| §7.6 的 112.5 MHz | **已有一条硬证据说不行**：V3.0 P&R 的 `Maximum possible analyzed clocks frequency = 111.894 MHz` |
| S1 目标兑现率 | 本文按 **33/52 = 63%** 记；口述的 84% 在仓库里查不到出处 |
| 回归项数 | 本文按 **35 项** 记（`run_regress.ps1` 35 个表项，`final_regress_v213_dlfix.txt` 35 行）；`7bdd307` 的提交信息写 36/36，是**提交信息的偏差**，不影响任何结论 |
