pekeppp/2D_Rendering_Acceleration-deprecated-v3.2/doc/logs/research_notes_perf.md

# 2D 渲染加速器 · 性能 / 接口研究笔记（面向"新高负载交互式游戏 Demo"设计）

> 本文是**二手整理**，不是原始实验记录。主体来自两份被指定的文档：
>
> - `doc/性能优化成果与计划.md`（下称 **[成果]**，497 行，覆盖 RTL v2.10~v2.16 + v2.8/v2.9，2026 批次）
> - `doc/perf_probe_report.md`（下称 **[探针]**，240 行，只读探针报告 + 5 次"2026-09 更新"，已含 v3.1 双 lane）
>
> 补充部分（寄存器图逐位、命令字/描述符格式、固件 demo 与串口命令、v3.2/S5 现状）取自仓库一手材料，
> 每条**都标了来源**：`rtl/blt_regs_axi_lite.v` 头注释（= 寄存器地图权威）、`rtl/功能清单.md` §22~§28、
> `tools/README.md`、`firmware/README.md`、`ARC_2DRA/.../standalone/FinalDemo/src/FinalDemo.c`、
> `ARC_2DRA/.../standalone/AdDemo/src/AdDemo.c`、`doc/加速器设计规划_RTL实现.md`、`doc/logs/*`。
>
> **口径纪律（沿用 [成果] §"证据纪律"）**：每个数字必须带口径 ——
> **板上实测 / 仿真实测 / 模型推导 / 未验证**。凡与口述数字不符，一律以仓库源码/日志为准，并就地写"口径说明"。

---

## 0. 版本坐标（先看这一节，否则会拿过时结论做设计）

| 版本 | 关键内容 | 文档覆盖情况 |
| --- | --- | --- |
| v2.8 | 像素打包乒乓（藏每 16B 词的冲刷拍） | [成果] §4.6、[探针] §4(a) 已兑现 |
| v2.9 | 写突发合并真正生效（AW 64,800 → 4,050） | [成果] §4.6、[探针] ★2026-09 更新 |
| v2.10 (S1) | 命令尾冲刷提示（`wr_cmd_end` + `TAIL_GRACE=4`） | [成果] §4.2、[探针] ★更新之二 |
| v2.11 (S2) | 显示列表 / 描述符表（`rtl/dl_fetch.v`，寄存器 0x4C~0x88） | [成果] §4.3、[探针] §7 |
| v2.12 (S3) | 透明块掩码（4×4 块位图，行窗口 + 整带跳过） | [成果] §4.4、[探针] §8 |
| v2.16 | 64×64 尺寸档（几何表 11 条） | [成果] §4.5 |
| **v3.1** | **双 lane 像素通路（2 px/拍）+ `stream_reader` 双词槽预取** | **[探针] §9（已落地，非计划）** |
| **v3.2 (S5)** | **属性侧口 ATTR(0x8C) + scissor(0x90~0xA0) + 扫描输出 LUT(0xA4~0xB0)** | `rtl/功能清单.md` §28；[成果] §7.4/§7.5 只当作"计划" |

> ★ **最重要的一条提醒**：[成果] §7 的"下一步优化计划"里，**P1（双 lane）、P4（属性侧口）、P5（LUT+scissor）
> 已经在 v3.1/v3.2 落地并有实测**（[探针] §9、功能清单 §27/§28，回归 47 项 0 失败）。
> 只有 **P2（读路径公平性）、P3（4bpp 调色板）、P6（112.5 MHz）仍未做**。
> 拿 [成果] §7.1 的"预期收益"当"待做项"会重复劳动；拿它当"已实现能力"则会高估（P1 实测 1.67~2.48× 但按尺寸不同）。
>
> 另一条：`doc/性能优化成果与计划.md` 自身的 §8.5 明确列出**"§3.1 九组成本行的原始串口日志未入库"**，
> 即 [成果] 里最核心的九组板上数字**是本文档首次落成文字、无原始日志可查**。设计时按"参考量级"用，
> 不要当逐位可复现的基线。

---

## 1. 平台固定前提（做预算时的不变量）

| 项 | 值 | 来源 |
| --- | --- | --- |
| core 时钟 | **100 MHz**（`pt.sdc: create_clock -period 10.000 -name core_clk`；`SYSTEM_CLINT_HZ=100000000`） | [成果] §2.1；`功能清单.md` §0 |
| 帧预算 | 100 MHz ÷ 60 fps = **1 666 667 拍/帧** | [成果] §3.3 |
| 帧缓冲（FB） | **960×540，RGB565，stride 1920 B/行**（= 120×16B） | FinalDemo.c / AdDemo.c |
| FB 基址（FinalDemo） | 显示 `DDR_BASE+0x00300000`、后台 `+0x00500000`、第三块 `+0x00700000` | FinalDemo.c:82-84 |
| FB 基址（AdDemo） | 同上三块；另 `ATLAS_BASE=+0x00200000`、`GLOW_BASE=+0x00210000`、`FONT_BASE=+0x00220000`、`BG_BASE=+0x00604000`（960×524 背景）、`FLUSH_SCRATCH=+0x00600000` | AdDemo.c:128-139 |
| 加速器寄存器窗口 | `BLT_BASE = 0xF8100000`（APB/AXI-Lite 桥后） | AdDemo.c:141 |
| DDR3 峰值带宽 | 16 bit × 800 Mbps = **1.6 GB/s**（《赛题二_方案设计与原理讲解.md》§2.2） | [成果] §6.2 |
| 命令 FIFO | **深 256 条**（= 2048 字），`CMD_FIFO_COUNT` 以**完整指令条数**计 | 功能清单 §1 / R2.2 |
| 时间基准 | CLINT `mtime` 低 32 位，`BSP_CLINT_HZ = 100 MHz`（同 core 域） | [成果] §2.1 |
| 上板串口 | 115200 8N1，单字符命令 + `=N` 行命令，上位机 `tools/serial_console.html`（Web Serial） | tools/README.md |

---

## 2. 测量工具链（[成果] §2 自称"本批最值钱的部分"）

### 2.1 1 Hz 成本行（唯一的板级仪表）

固件在两条路径上各打一行**同口径**成本（`FinalDemo.c` 的 `dl_cost_report()` / `cmd_cost_report()`，提交 `725134c`）：

```
EV cmd path done: n=<精灵数> cycles=<软件秒表> cyc/sprite=<cycles/n>
EV dl  list done: n=<精灵数> cycles=<DL_PERF>  cyc/sprite=<cycles/n>
```

| 要点 | 内容 |
| --- | --- |
| 门控 | **1 Hz**（`DL_COST_TICKS = BSP_CLINT_HZ`）——不是每帧、更不是每条，串口不会被刷屏 |
| 单位 | 都是 **core 拍**。列表那行用 `DL_PERF(0x7C)`（取指器在 core 域计数）；逐条那行是 CLINT `mtime` 秒表 |
| 口径差（**必须知道**） | 列表行 = **纯硬件**（GO→DONE）；逐条行 = **墙钟**（含每块 8 次 MMIO 的 CPU 下发）——后者正是按 `l` 想省掉的东西 |
| 已知污染 | 列表行的 `n` 只数精灵，`cycles` 里却含同一张表里那条**整片重铺**描述符（W=960 的 FILL）⇒ 小 N 时 `cyc/sprite` 明显偏高；比大小要把 N 加大（N=976 时重铺只占 3%） |
| 价值 | 本批**每一个**性能数字都出自这一行；它推翻了 4 条旧结论（§9.1） |

### 2.2 两点 / 三点拟合：`A + B × px` 模型

| 步骤 | 做法 |
| --- | --- |
| 采样 | 三尺寸各测一趟：16×16（256 px）/ 32×32（1 024 px）/ 64×64（4 096 px） |
| 两点定参 | 用**两端点**（16×16 与 64×64）解 `A`（每精灵固定开销）与 `B`（每像素成本） |
| 三点验残差 | 中间点（32×32）不参与拟合，专门验模型 |
| 外推 | 渐近线吞吐 = `1/B` px/拍；兑现率 = 实测吞吐 ÷ 渐近线 |
| 粒度 | N 由串口/网页按 **步进 25** 调（范围 **25–6000**）⇒ 相对不确定度 = 25/n |

### 2.3 仿真侧纪律

| 纪律 | 落地 |
| --- | --- |
| 只读探针 | `rtl/tb/tb_perf_probe.v`（**不改任何 RTL/寄存器图/FSM**，只做层次引用）；每用例给逐拍直方图，且要求 `hist_sum − PERF = 0`（不允许"其他"黑洞） |
| A/B 逃生门 | 每个行为改动配一个 `ifdef`，**两侧都必须 PASS 且位精确读数逐字节相同**：`-DPIXEL_PACK_PINGPONG_OFF` / `-DWR_MERGE_HOLD_OFF` / `-DWR_CMD_END_FLUSH_OFF` / `-DDL_OFF` / `-DMASK_SKIP_OFF` / `-DPIXEL_PIXELS2_OFF` / `-DATTR_PORT_OFF` / `-DSCISSOR_OFF` / `-DLUT_OFF` / `-DBLEND_OFF` |
| 逐位一致性 | FILL/COPY/KEY/ALPHA × 非对齐/行尾残余词：首末像素、写词数、掩码推出的写出像素数、AW/W/B 计数全部逐字节比对 |
| 软件↔RTL 交叉 | `tb_dl_demo` 把**固件 `dl_build()` 原样输出的描述符字节**喂进真实 RTL；主机自检在 PC 上把固件里被标记的源码段（`SPR_MASK_BEGIN/END`、`DL_ENC_BEGIN/END`、`SCENE_BOUNDS`、`DL_LAYOUT`）原样编译运行 ⇒ "被测的就是板上跑的" |
| 回归清单 | `rtl/tb/run_regress.ps1`：v2.13 时 **35 项**（含 3 项**预期失败**的 A/B 对照）；**v3.2 为 47 项、0 失败**，末行 `==== regress failures: 0 ====` |
| 写序专项 | `tb_wr_order`：H1（DONE 时刻写通路彻底干净）/ H2（在飞写突发 ≤ 1）是每次改动的必过项 |
| 编译/仿真 | iverilog `-g2001` + vvp；探针编译 ~6 s、仿真 ~62 s，输出逐字节可复现 |

### 2.4 口径陷阱清单（[成果] §2.5，"本批踩过的"）

| 陷阱 | 后果 |
| --- | --- |
| 拿"纯硬件列表"与"含 CPU 的逐条墙钟"直接比大小 | 得到"列表净亏 43%"的错误结论；实测 CPU 下发**大部分与引擎重叠**，真正省下的只有 ~55 拍/精灵 |
| 用不同 N 的两行相减 | 每精灵固定开销 / 整片重铺摊薄比例不同，差值里混着 N 的差 |
| 在模式切换与回退重绘期间采样 | 那一趟里既有列表路径又有逐条补画，`cycles` 不是任何一种路径的成本 |
| 把"板 − 仿真"整段当本地归给某个模块 | 那条差里同时含 DDR 竞争、B 往返、CPU 重叠程度 |
| 忘记测量粒度 | 64×64 只跑 350 个精灵、步进 25 ⇒ **±7%**；这一档任何 3~4% 的差异都落在一格之内 |
| **双 lane 下按拍统计的探针量** | `px_cons/px_skipped/max_px_run` 在 v3.1 后 1 拍 = 2 像素 ⇒ `px_cons` 518,400→259,200、`max_px_run` 960→480；**像素数一律看 `px_written`**（[探针] §9、功能清单 §27.5） |

### 2.5 板级工具

| 项 | 说明 |
| --- | --- |
| 网页串口上位机 | `tools/serial_console.html`（单文件、无外部依赖、Web Serial）；单字符命令 + `=N` 行命令，N 滑块步进 25 |
| `e` 的语义 | [成果] 全部读数都是在 **`e` 开**（每趟整片重铺）下取的；稳态下重铺由**清屏引擎在后台**做（`clr fb/to/err` 不涨），因此不在这趟计时里 |
| 单变量纪律 | 同一场景、同一 N、同一尺寸，只翻一个开关前后读两行 —— 这条纪律是 `l` 必须"延迟到帧边界生效"（`0abba96`）的直接原因：旧版一按 `l` 就切，列表在飞时永远切不回去，A/B 根本做不下去 |
| 看门狗判读表 | `tools/README.md` §3.4（三种结局对应三种结论：太短 / 被饿住 / 真死） |

---

## 3. 板上实测性能数字（[成果] §3，口径 = 板上实测）

### 3.1 九组原始读数（`e` 开、60 fps 目标、**每命令（逐条）路径**）

| 尺寸 | 场景 | n（精灵/趟） | 一趟拍数 | 拍/精灵 | 相对不确定度 |
| --- | --- | --- | --- | --- | --- |
| 16×16 | FILL | 2 725 | 1 401 490 | **514.3** | ±0.9% |
| 16×16 | ALPHA | 1 725 | 1 477 314 | **856.4** | ±1.4% |
| 16×16 | KEY | 2 025 | 1 456 264 | **719.1** | ±1.2% |
| 32×32 | FILL | 1 200 | 1 516 527 | **1 263.8** | ±2.1% |
| 32×32 | ALPHA | 775 | 1 525 961 | **1 969.0** | ±3.2% |
| 32×32 | KEY | 950 | 1 536 525 | **1 617.4** | ±2.6% |
| 64×64 | FILL | 350 | 1 557 516 | **4 450.0** | ±7% |
| 64×64 | ALPHA | 225 | 1 517 100 | **6 742.7** | ±11% |
| 64×64 | KEY | 275 | 1 522 820 | **5 537.5** | ±9% |

> 口径说明：原始串口日志**未入库**（[成果] §8.5 列为"未验证"）；`拍/精灵` 由 `一趟拍数 ÷ n` 复算。

### 3.2 两点拟合与三点残差（模型推导；只用 16×16 与 64×64 定参）

| 场景 | A（拍/精灵） | B（拍/px） | 32×32 预测 | 32×32 实测 | 残差 | 渐近线 `1/B` |
| --- | --- | --- | --- | --- | --- | --- |
| FILL | **252** | **1.025** | 1 301.6 | 1 263.8 | **−2.9%** | 0.976 px/拍（= **97.6 Mpx/s**） |
| KEY | **398** | **1.255** | 1 683.1 | 1 617.4 | **−3.9%** | 0.797 px/拍 |
| ALPHA | **464** | **1.533** | 2 033.8 | 1 969.0 | **−3.2%** | 0.652 px/拍 |

- 两点上残差 ≤ 0.03%（它们是锚点）。三个中间点全部**低于**拟合线 2.9%~3.9%，方向/幅度一致 ⇒ 真实 `B` 略小、`A` 略大。
- 但该偏差**落在一格测量粒度内**（64×64 档 ±7%、32×32 档 ±2.1%），**没有被单独证明**。
- 派生：`A_FILL = 252` 拍只占 64×64 一条命令 **5.7%**，却占 16×16 一条命令 **49%** ⇒ "尺寸档这个杠杆已经用尽"。

### 3.3 派生指标（帧预算 = 1 666 667 拍）

| 尺寸 | 场景 | px/拍（实测） | Mpx/s（**瞬时**） | Mpx/s（**帧预算归一**） | 一趟占帧 | 帧内非本趟拍数 |
| --- | --- | --- | --- | --- | --- | --- |
| 16×16 | FILL | 0.4978 | **49.8** | **41.9** | 84.1% | 265 177（15.9%） |
| 16×16 | ALPHA | 0.2989 | **29.9** | **26.5** | 88.6% | 189 353（11.4%） |
| 16×16 | KEY | 0.3560 | **35.6** | **31.1** | 87.4% | 210 403（12.6%） |
| 32×32 | FILL | 0.8103 | **81.0** | **73.7** | 91.0% | 150 140（9.0%） |
| 32×32 | ALPHA | 0.5201 | **52.0** | **47.6** | 91.6% | 140 706（8.4%） |
| 32×32 | KEY | 0.6331 | **63.3** | **58.4** | 92.2% | 130 142（7.8%） |
| 64×64 | FILL | 0.9204 | **92.0** | **86.0** | 93.5% | 109 151（6.5%） |
| 64×64 | ALPHA | 0.6075 | **60.7** | **55.3** | 91.0% | 149 567（9.0%） |
| 64×64 | KEY | 0.7397 | **74.0** | **67.6** | 91.4% | 143 847（8.6%） |

- **64×64 FILL 实测 92.0 Mpx/s = 渐近线（97.6）的 94%**。
- **整屏 960×540 FILL（无命令边界）**：520 607 拍 / 518 400 px = **1.0043 拍/px = 0.9958 px/拍**（仿真实测，[探针] §4 更新之二），直方图 99.58% 的拍在推进像素。
- 口径警告：口述的"FILL 41.9 / 73.7 / 92.0"**混用了两种口径**（前两个是帧预算归一，第三个是瞬时）；按帧预算归一，64×64 应是 **86.0**。引用单个数字必须说明是哪一列。
- 帧内非本趟拍数区间实际是 **109k~265k（6.5%~15.9%）**，不是"110–150k / 7–9%"（后者只覆盖 32×32 与 64×64 六组；16×16 FILL 是离群点）。

### 3.4 板上唯一一次"列表 vs 逐条"同口径读数

| 项 | 数字 | 口径 |
| --- | --- | --- |
| 板 ALPHA/16×16：list **1 231** vs cmd **1 286** 拍/精灵 | **+4.3%** | 板上实测，**单次**读数，取自模式切换/带路径回退补画的窗口 ⇒ **不是有效 A/B** |
| 仿真：列表 367.2 vs 逐条（串行口径）384.0 拍/精灵 | **+4.4%** | 仿真实测 |
| 场景 1（FILL + SIZE_OVR + 不读几何表）开关 `l` | **测不出差别** | 板上实测，原始日志未入库 |

---

## 4. 仿真实测数字（[探针]，只读探针 `PERF 0x1C`，单位 core 拍）

### 4.1 改前基线（单 lane、无写合并、无尾冲刷）

| 算子 | cycles | 写出像素 | cycles/px | 16B 词 | AW | 行周期 |
| --- | --- | --- | --- | --- | --- | --- |
| 960×540 FILL | **585 387**（板 585 941，+0.09%） | 518 400 | 1.1292 | 64 800 | 64 800 | 1083（min=max） |
| 960×540 COPY | 650 275 | 518 400 | 1.2544 | 64 800 | 64 800 | 1203 |
| 32×32 FILL（stride 64） | 1 307 | 1 024 | 1.2764 | 128 | 128 | 39 |
| 32×32 COPY | 1 460 | 1 024 | 1.4258 | 128 | 128 | 43 |
| 32×32 ALPHA α=128 | 1 464 | 1 024 | 1.4297 | 128 | 128 | 43 |
| 32×32 KEY | 1 460 | 713（键色跳 311） | 2.0477 | 124 | 124 | 43 |

- 改前的限速项：**单 lane 打包器每个 16B 词强制 1 拍冲刷**（整屏 64 800 拍 = 11.07%）；FSM 开销仅 2 187 拍（0.37%）。
- 背靠背（T8=64 块、T9=32 块、T10=16 块）实测与**孤立值逐拍相同**（1307/1307/1464）⇒ **`ST_WDWAIT` 写提交屏障把命令完全串行化，不存在可利用的命令间重叠**（64 块只藏住 63 拍 = 0.075%）。
- 写主机状态分布（FILL）：IDLE 131 787 / BUF 64 800 / AW 64 800 / W 64 800 / B 259 200 = **8 拍/词**（改前）。
- "帧级 947 拍/块"**无法复现**：探针只能证明它低于结构下限 1152 拍、且背靠背零重叠（[探针] §6）。

### 4.2 逐轮优化的仿真读数

| 轮次 | 数字（仿真） |
| --- | --- |
| v2.8 像素打包乒乓 | 整屏 FILL 585 387 → **520 588**（**−11.07%**）；`max_px_run` 8 → **960**；`FLUSH_*` 桶全 0（板 FILL 吻合 0.09%）；行周期 1083 → **963** |
| v2.9 写突发合并 | AW 64 800 → **4 050**（= ⌈64 800/16⌉ 理论下限）；`burst_max/avg` 1/1.000 → **16/15.996**；写主机 AXI 侧 **8.0 → 1.13 拍/词**；整屏总拍 +52（+0.010%）、32×32 +52（+4.4%，全在命令尾） |
| v2.10 S1 命令尾冲刷 | 32×32 FILL 1 232 → **1 199**（−33）；整屏 520 640 → **520 607**（−0.0063%）；`ENG_WDWAIT` 63 → **30**；AW 4 051 → **4 050**；`burst_avg` → **16.000000** |
| v2.11 S2 显示列表 | 列表路径 **367.2** vs 逐条（串行）**384.0** 拍/精灵 = **+4.4%**；列表 = 引擎地板（**366** 拍/精灵）；畸形列表 9 类全部 `BUSY=0` + 正确 `DL_ERR` + 序号 + `DL_FAULT_ADDR` |
| v2.12 S3 掩码 | 见下表（取决于精灵形状） |
| v3.1 双 lane | 见 §4.4 |
| v3.2 S5 | 探针 **310 行输出与 v3.1 逐行完全一致**（零吞吐代价）；scissor 省拍 1199 → **212**（只留 4/32 行） |

**S3 掩码 A/B（单条孤立命令，CPU 路径）**

| 用例 | 形状（键色/总像素） | op | 无掩码 | 带掩码 | Δ | 掩码值 |
| --- | --- | --- | --- | --- | --- | --- |
| T13a | 16×16 demo 球 61/256 | KEY | 445 | 445 | **0（0.0%）** | 0x0000 |
| T13b | 同上 | ALPHA | 464 | 464 | 0（掩码无效） | 0x0000 |
| T13c | 同上 | FILL | 361 | 361 | **0（FILL 不变）** | 0x0000 |
| T14a | 32×32 demo 球 229/1024 | KEY | 1 433 | 1 433 | **0（0.0%）** | 0x0000 |
| T15a | 16×16 典型弹 143/256 | KEY | 425 | 406 | **−19（−4.5%）** | 0x9008 |
| T16a | 32×32 典型弹 647/1024 | KEY | 1 419 | 1 115 | **−304（−21.4%）** | 0x9009 |
| T17a | 32×32 小弹 875/1024 | KEY | 1 419 | 452 | **−967（−68.1%）** | 0xf99f |
| T17b | 同上 | ALPHA | 1 451 | 1 451 | 0 | 0xf99f |

- **任务书点名的 demo 精灵一点都省不了**（圆盘半径 8 几乎内切 16×16 包围盒 ⇒ 没有任何 4×4 块整块透明；32×32 同形状也 0）——几何必然，不是实现问题。
- 掩码真正兑现的是**覆盖率 35~50% 的弹幕弹**与**小弹放在大图集格子里**（上下两条行带整带透明 ⇒ 那些行 0 取数）。

### 4.3 S2 每块开销拆分（16×16 FILL = 256 px，[探针] §7）

| 组成 | 拍/块 | 说明 |
| --- | --- | --- |
| 像素推进 `PIX_KEEP` | **256** | 1 px/拍（v2.8 之后 8 拍/词，16×16 恰好 32 个词） |
| 引擎自身（POP 15 + DEC 1 + INIT 1 + ROW_GAP 48 + DRAIN 16 + WDWAIT 29） | **110** | 与设计文档 §2.3 的"16 行 ≈111 拍"逐桶吻合；S2 **不动 FSM** ⇒ 这 110 拍拿不掉 |
| CPU 侧下发/喂 FIFO（测试台） | **16.5**（T12a 直接量到 16.0） | 本 TB 的 AXI-Lite 主机每次事务 ≈2 拍 |
| 合计（改前，串行口径） | **384.0** | 366 引擎/像素 + 16.5 CPU |
| 合计（列表路径，S2） | **367.2** | `tb_dl_basic` 73448/200，`DL_PERF=73443` |

- **板上那 ~190 拍 CPU 下发仿真测不到**（只能由"板上 561 − 仿真 366 ≈ 195 拍"反推）；列表路径消掉的正是这一整块，**引擎自身 110 拍一分没动**。
- 16×16 的 32 个连续词被切成 **16+15+1 三笔 AW**（理论 2 笔），因为 `TAIL_GRACE=4` 恰好卡在边界；**CPU 路径逐项相同**（AW-len 1/15/16 = 200/200/200），不是 S2 引入的。

### 4.4 v3.1 双 lane A/B（[探针] §9，同一份探针一行未改，只差 `-DPIXEL_PIXELS2_OFF`）

| 用例 | 拍数 OFF → ON | px/拍 OFF → ON | 倍数 |
| --- | --- | --- | --- |
| T1 960×540 FILL | 520 607 → **261 407** | 0.995761 → **1.983114** | 1.99× |
| T2 960×540 COPY | 649 755 → **262 035** | 0.797839 → **1.978362** | **2.48×** |
| T3 32×32 FILL | 1 199 → **687** | 0.854045 → 1.490539 | 1.75× |
| T4 32×32 COPY | 1 447 → **804** | 0.707671 → 1.273632 | 1.80× |
| T5 32×32 ALPHA α=128 | 1 451 → **868** | 0.705720 → 1.179724 | 1.67× |
| T6 32×32 KEY | 1 443 → **800** | 0.494109 → 0.891250 | 1.80× |
| T7 32×32 FILL @FB stride | 1 187 → **681** | 0.862679 → 1.503671 | 1.74× |
| T8 背靠背 ×64 | 1 199 → **687** 拍/块 | — | 1.75× |
| T11 16×16 FILL | 366 → **239** | — | 1.53× |
| T13a/b/c 16×16 demo KEY/ALPHA/FILL | 445/464/361 → **355/374/233** | — | 1.25/1.24/1.55× |
| T16a 32×32 弹 KEY | 1 419 → **775** | — | 1.83× |

- 写侧不变：AW 4050、`burst_max=16`、`burst_avg=16.000000`、`wd_full_cyc=0`、`wd_peak` 4 → 7（深 16）；T1 直方图 `PIX_KEEP 259 200`（99.16%）+ FSM 桶，**无 FLUSH_\* 桶、无新桶、`delta=0`**。
- 整屏 FILL 261 407 拍与 §4(b) 外推"261 400"误差 **+7 拍（0.003%）**。
- 读类不再是 0.889 px/拍：`stream_reader` 双词槽预取消掉了每词 1~2 拍重装气泡。
- **§4.3 P2（读路径公平性）仍未做**；`axi_rd_master` 的受理标志 bug（`dl_ready` 与入队不同源）在 v3.1 顺带修掉（功能清单 §27.4），代价仅"引擎上一拍赢过 + 本拍空闲"时最多再等 `AGE_MAX=64` 拍。
- 残余风险：双 lane 新增 ≈ +284 FF（两个 `stream_reader` 词槽）；ALPHA 乘法器 6 → 12 个 8×8（组合深度不变、面积/DSP 翻倍）；**未跑 Efinity、未上板**（v3.1/v3.2 的板上判据都还是"应该"）。

### 4.5 v3.2 (S5) 实测摘要（功能清单 §28.5）

| 项 | 数字 |
| --- | --- |
| 探针零代价 | `log_probe_s5_on.txt` 与 v3.1 `log_probe_px2on.txt` **310 行逐行完全一致**（T1 = 261 407 拍、AW 4050、T3/T4/T5/T6/T7 = 687/804/868/800/681） |
| scissor 省拍 | `tb_scissor` S7：64×32 FILL `PERF 0x1C` **1199 → 212 拍（−82.3%）**（只留 4/32 行）；`-DSCISSOR_OFF` 两次逐拍相同（1199/1199） |
| LUT 写表不撕裂 | `tb_scanout_lut` T5 整表写入期间监视 2339 个 DE 像素、异常 **0** |
| 属性/混合 | `tb_attr_blend` 32 条判据全过，含 **7 条手算期望值**（L1 `7BEF/C618@ga128 → A4F4`、L2 乘法 `→ 5AEB`、L3 加算 `1082/2945 → 39C7`、L3b `39E7/2945 → 632C`、L4 ARGB4444 `8ABC@ga128 → BE18`、L5 ARGB1555 `87E0@ga64 → B692`、L6 a=0 + alpha 测试 ⇒ 留孔） |
| 全量回归 | **47 项，0 失败**（`doc/logs/final_regress_v32_s5.txt`） |
| AdDemo 主机自检 | **156 passed / 0 failed**（`doc/logs/host_selfcheck_AdDemo.txt`，2026-09-16，针对两处上板 bug 修复后） |

---

## 5. 硬件寄存器映射与命令接口（逐位）

> 权威来源：`rtl/blt_regs_axi_lite.v` 头注释（第 1–114 行）+ `rtl/功能清单.md` §25。**0x00~0x88 一位没动、无重编号**；
> 0x8C~0xB0 是 v3.2 新增。基址 = `0xF8100000`（AdDemo 用 `BLT_BASE`）。

### 5.1 BitBlt 引擎 / 核心寄存器 0x00~0x48

| 偏移 | 名称 | R/W | 位定义 |
| --- | --- | --- | --- |
| **0x00** | `CTRL` | RW | bit0=GO（写 1 使能自动消费，置 `run_en`；写 0 不停止在途指令）bit1=IRQ_EN(DONE) bit2=SOFT_RST（写 1 清 FIFO/FSM 回 IDLE、清 DONE/ERR） |
| **0x04** | `STATUS` | R | bit0=BUSY bit1=DONE（电平：FIFO 空 && 引擎空闲）bit2=ERR bit3=FIFO_EMPTY |
| **0x08** | `CMD_FIFO_DATA` | W | 指令字；**连写 8 字 = 一条**；满时 `awready/wready` 拉低反压（不丢字） |
| **0x0C** | `CMD_FIFO_COUNT` | R | 已排队**完整指令条数**（字计数 >>3），深 256 条 |
| **0x10** | `IRQ_STATUS` | W1C | bit0=DONE bit1=**FRAME**（扫描输出帧边界脉冲，每场 1 个 core 拍）bit2=**DL_DONE**（v2.11 追加） |
| **0x14** | `IRQ_EN` | RW | bit0=DONE bit1=FRAME bit2=DL_DONE（CTRL.bit1 只动 bit0） |
| **0x18** | `DBG_CUR_CMD` | R | 当前执行指令 word0 |
| **0x1C** | `PERF` | R | **性能计数**（二期实现）：引擎 core 周期数（GO→DONE 同风格） |
| **0x20** | `SCAN_DBG` | R | [15:0]=扫描输出**欠载行数** [31:16]=取数看门狗中止次数（正常恒 0） |
| **0x24** | `FB_SEL` | W | [1:0] 希望显示的缓冲（0=FB_BASE 1=FB_BASE1 2=FB_BASE2，3→0）。**只是请求**，扫描输出在**帧边界**才锁存 |
| **0x28** | `FB_STAT` | R | [1:0]=**已生效**的显示缓冲 [31:16]=`frame_cnt`（场计数） |
| **0x2C** | `CLR_ADDR` | RW | 清屏起始字节地址 |
| **0x30** | `CLR_STRIDE` | RW | 字节/行 |
| **0x34** | `CLR_WH` | RW | (h<<16)\|w |
| **0x38** | `CLR_COLOR` | RW | RGB565 常量色 |
| **0x3C** | `CLR_CTRL` | W | bit0=GO(1 拍脉冲) [3:2]=目标缓冲号 bit4=ERR_CLR(1 拍脉冲) |
| **0x40** | `CLR_STAT` | R | bit0=BUSY bit1=目标缓冲已清干净 [5:2]=四块 clean 位图 bit6=ERR(sticky) [31:16]=上次 clear 的 AW 突发数 |
| **0x44** | `DRAW_SEL` | RW | [1:0] = 引擎**正在画**的缓冲（写它会清 clean 位）；**清屏目标 == 本值 ⇒ 拒绝写**（硬件互斥） |
| **0x48** | `CLR_CYC` | R | 上一次 clear 的 core 周期数（不饱和） |

### 5.2 显示列表 DFU 寄存器 0x4C~0x88（S2）

| 偏移 | 名称 | R/W | 位定义 / 备注 |
| --- | --- | --- | --- |
| **0x4C** | `DL_BASE0` | RW | [31:4] 列表 A 基地址（16B 对齐；未对齐写**被忽略** + `DL_ERR.DESC_RANGE`） |
| **0x50** | `DL_BASE1` | RW | [31:4] 列表 B 基地址（乒乓的另一张） |
| **0x54** | `DL_COUNT` | RW | [15:0] 条数（0 = 合法空列表；>4095 ⇒ `DESC_COUNT`） |
| **0x58** | `DL_CTRL` | W | bit0=GO(1 拍脉冲，BUSY 时忽略) bit1=ABORT bit2=BUF_SEL bit3=IRQ_EN bit4=AUTO_GO(复位 1) bit5=STRICT_BOUNDS(复位 1) |
| **0x5C** | `DL_STATUS` | R | bit0=BUSY bit1=DONE bit2=ERR bit3=ABORTED bit4=STALL [9:8]=ACTIVE_BUF [31:16]=CONSUMED |
| **0x60** | `DL_ERR` | R/W1C | [7:0]=DESC_RANGE/GEOM_INDEX/GEOM_RANGE/SPRITE_BOUNDS/WATCHDOG/AXI_RRESP/DESC_COUNT/ZERO_SIZE [23:16]=出错序号 [24]=UNSUPPORTED（MIRROR/CHAIN 等） |
| **0x64** | `DL_FAULT_ADDR` | R | 出错时正在访问的地址 |
| **0x68** | `DL_GEOM_BASE` | RW | [31:4] 几何表基地址（**16B/条**） |
| **0x6C** | `DL_GEOM_MAX` | RW | [15:0] 几何表条目数（0 = 关闭几何表）；**完整 16 bit RW**（`blt_regs_axi_lite.v:488/616`），`dl_fetch` 的 `GEOM_MAXN=1023` 只是文档参数未参与比较 |
| **0x70** | `DL_DST_BASE` | RW | [31:0] 本列表的目标缓冲基地址；硬件**不从 `DRAW_SEL` 推导** |
| **0x74** | `DL_CFG` | RW | bit0=PREFETCH_EN(1) bit1=GEOM_CACHE_EN(1) [7:4]=CHUNK(8) [11:8]=FIFO_WM(4)；复位默认 `0x0000_0483` |
| **0x78** | `DL_TIMEOUT` | RW | [15:0] 单条描述符看门狗（**core 拍**，复位 **4096**；0=关）。板级常用值 **65535** |
| **0x7C** | `DL_PERF` | R | 上一次列表的 core 周期数（GO→DONE）；**只在 BUSY=0 后有效** |
| **0x80** | `DL_VERSION` | R | `32'h0210_0002`（[7:0]=0x02 S2、[31:16]=0x0210）；能力探测用 |
| **0x84** | `DL_DST_STRIDE` | RW | [15:0] 目标字节行距 |
| **0x88** | `DL_FB_WH` | RW | [15:0]=FB_W [31:16]=FB_H（SPRITE_BOUNDS/CLIP_EN 用） |

**读写语义（功能清单 §25.2）**：`DL_BASE*/COUNT/GEOM_*/DST_*/CFG/TIMEOUT` 只在 `BUSY=0` 时被 DFU 采样，
**BUSY 期间写入被忽略（读回旧值，不报错）**；`GO`/`ABORT` 写 1 产生 1 拍脉冲；`DL_ERR` 是 W1C 且 `DL_STATUS.ERR = |DL_ERR`；
写 `DL_BASE*` 会清 `DL_STATUS.DONE`。

**几何表 16B/条**：`gw0=ATLAS_BASE`、`gw1=[15:0]ATLAS_STRIDE [31:16]KEY_DEFAULT`、`gw2=[15:0]W [31:16]H`、`gw3=[15:0]SX [31:16]SY`。
cache 是 **16 条直接映射**（索引 `spr_id[3:0]`、标签 `spr_id[15:4]`）⇒ **≤16 条零冲突全常驻**（demo 用 11 条）。

### 5.3 v3.2 (S5) 新增寄存器 0x8C~0xB0

| 偏移 | 名称 | R/W | 位定义 / 协议 |
| --- | --- | --- | --- |
| **0x8C** | `ATTR_PORT` | W | 每写 1 次 = 往**属性 FIFO（深 16、FWFT）**压 1 个 32bit 属性字；引擎在**每条命令起始（ST_DEC）按序弹 1 个** ⇒ 严格"先写属性、再写命令"。FIFO 空 ⇒ 默认字（blend 0 / RGB565 / ga 255 / flags 0 = `0x0000_3FC0`）。位域：**[3:0] blend_mode**（0=按算子默认 1=alpha 混合 2=加算饱和 3=乘法，4~15 保留→按 0）**[5:4] src_format**（0=RGB565 1=ARGB1555 2=ARGB4444，3 保留→按 0）**[13:6] global_alpha**（255=不淡）[15:14]/[23:16] 保留 **[31:24] flags**（bit0=alpha 测试：alpha=0 不写；bit1=强制不透明按 255 算）。**不看 WSTRB**，整字入队 |
| **0x90 / 0x94 / 0x98 / 0x9C** | `CLIP_X0 / X1 / Y0 / Y1` | RW | scissor 边界，**半开区间** `X0 ≤ x < X1`、`Y0 ≤ y < Y1`。坐标是**本条命令目的矩形的局部坐标**（原点 = 该行 `dst_base` 第一个像素） |
| **0xA0** | `CLIP_CTRL` | RW | bit0=ENABLE（**复位 0**）。引擎在**命令起始锁存** ⇒ 命令中途改不会撕裂本命令。启用后：矩形外像素不写；**整行在矩形外的行不取数、不算**（走 S3 的"空窗口跳过"分支） |
| **0xA4** | `LUT_ADDR` | RW | [9:8]=通道（0=R 1=G 2=B，3 保留→该次写忽略）[7:0]=表内下标 |
| **0xA8** | `LUT_DATA` | W | [7:0] 写入当前下标/bank 的输出值（**写它就产生 1 拍写脉冲**） |
| **0xAC** | `LUT_CTRL` | RW | bit0=ENABLE（请求，**立即**生效）bit1=**`LUT_DATA` 写进哪个 bank**。bit0/bit1 只在**帧边界**被锁存成"显示用的值"；**显示读的是锁存 bit1 的反相** ⇒ 写口与显示口永远指向不同 bank |
| **0xB0** | `LUT_STAT` | R | bit0 = **正在显示**的 bank |

> ★ **LUT 发布序列（AdDemo 头注释把它列为"实测标定"的坑）**：① 读 `0xB0` 得 D；② `0xAC bit1 = ~D`
> （新表整张写进非显示 bank）；③ 写 3×256 项；④ `0xAC bit1 = D` ⇒ 帧边界锁存后显示 = ~D = 刚写的表。
> 早期规格写的"bit1 = 刚写的 bank"**差一个反相**，照它做显示 bank 永远不动（表写进去却一辈子不上屏）。
> 另：开 LUT 前必须把整张表写完（RAM 上电为 0 ⇒ 未写的表 = 全黑）；写表期间**不要翻 `0xAC bit1`**。

### 5.4 8 字命令格式（`CMD_FIFO_DATA` 连写 8 字；`blt_cmd_t` 布局）

| 字 | 字段 | 说明 |
| --- | --- | --- |
| **w0** | `op[1:0]` + 掩码空位 | `0=COPY 1=FILL 2=ALPHA 3=KEY`（其它值 → ERR，跳过本条）。**S3 之后**：`w0 = {MASK[15:0], 13'd0, MASK_EN, OP[1:0]}` ⇒ `w0[31:16]` = 4×4 透明块位图、`w0[2]` = 掩码有效位。CPU 侧写 0 ⇒ 行为与之前逐位相同 |
| **w1** | `src_addr[31:0]` | 字节地址（FILL 忽略） |
| **w2** | `dst_addr[31:0]` | 字节地址 |
| **w3** | `src_stride[31:0]` | 源行距字节（FILL 忽略） |
| **w4** | `dst_stride[31:0]` | 目的行距字节 |
| **w5** | `width[15:0]` / `height[31:16]` | 像素宽 / 行高 |
| **w6** | `alpha[15:0]` | 0~255（仅 ALPHA） |
| **w7** | `color[31:0]` | FILL 填充色 / KEY 键色 |

**状态语义（不可改）**：`run_en(GO)=1` 时引擎 FIFO 非空即 POP 执行，执行完再查 FIFO；`FIFO 空 && 引擎 IDLE` → `DONE=1`（电平）。
CPU 批量下发可超 FIFO 深度而不死锁的前提正是这个语义。

**S3 掩码安全规则**：`msk_on = MASK_EN && OP==KEY && W≥4 && H≥4`；**FILL / ALPHA / COPY 显式忽略掩码**
（用 `0xFFFF` 全透明掩码反证：读数逐位不变）。掩码由软件算（固件 `build_atlas()` 里的 `spr_mask_of()`），
**写错没有任何错误位可诊断，只会少画**。

### 5.5 显示列表描述符 16B = 4 字 = 恰好 1 个 128bit AXI beat（小端）

```
dw0 [15:0] X(signed)   [31:16] Y(signed)
dw1 [15:0] SPR_ID      [31:16] FLAGS
dw2 [15:0] KEY(0xFFFF=用几何表默认键色) [23:16] ALPHA [31:24] PRIO
dw3 [15:0] MASK_ID(S3) [23:16] W_OVR [31:24] H_OVR
FLAGS: [1:0]OP(00COPY/01FILL/10ALPHA/11KEY，与 w0[1:0] 逐位一致) [2]MIRROR_X [3]MIRROR_Y
       [4]CLIP_EN [5]SIZE_OVR [6]SRC_OFF_EN [7]MASK_EN [9:8]MASK_MODE(01=该块全透明⇒跳过)
       [10]END_OF_LIST [11]IRQ_AFTER [12]CHAIN [15:13]保留
```

展开（`dl_fetch.v` 纯组合）：`w0={30'd0,OP}`（**注意：S3 掩码经 `x_w0 = {MASK_ID,13'd0,MASK_EN,OP}`**）、
`w1 = FILL?0 : ATLAS_BASE + SY*STRIDE + SX*2`、`w2 = DL_DST_BASE + Y*DST_STRIDE + X*2`（带符号）、
`w3=ATLAS_STRIDE`、`w4=DST_STRIDE`、`w5={H,W}`、`w6={24'd0,ALPHA}`、`w7 = FILL?COLOR:(KEY==0xFFFF?KEY_DEFAULT:KEY)`。
DFU 从 DDR 读 16 B/条 → 查几何表 → 展开成**现有 8 字命令** → 推进**现有 cmd_fifo**；**引擎 FSM / 像素通路 / 地址生成一行未改**。
desc 读复用 `axi_rd_master` 的第三个 tag（`rd_sel=10`，优先级 fg > bg > desc + `AGE_MAX=64`）。

---

## 6. 当前固件 demo

### 6.1 两版应用固件的定位（firmware/README.md + 源码头注释）

| 固件 | 定位 | 关键结论 |
| --- | --- | --- |
| **FinalDemo**（2840 行） | **"硬件加速 vs 纯 CPU 同屏对比"**：SPLIT 时右半屏由 CPU 逐像素直写 | 有 CPU 像素通路；场景 FILL/ALPHA/KEY；尺寸 16/32/64 |
| **AdDemo**（2310 行，**v3.2 的主 demo**，随 `firmware/v3.2/AdDemo_v3.2.bin`、`ddr_demo_ti60_v3.2.bit` 发布） | **"纯硬件渲染"**：屏幕上**每一个像素**（含信息条每个字）都由加速器写；渲染路径上没有任何 `fb[x]=c` | 5 个场景（GLOW/FADE/CLIP/LAYER/THRU），用 ATTR/scissor/LUT；**只用逐条下发路径**（DL 描述符没有 ATTR 槽位） |
| `FinalDemo_allon.hex` / `FinalDemo_default.hex` | 全开（换页+三缓冲+预清屏+中断节奏）/ 双缓冲等价 V2.0 | allon **必须是新位流**；default 新旧位流都能用 |

FinalDemo 源码开关（`FinalDemo.c`）：`FB_FLIP_PUBLISH=1`、`FB_TRIPLE_BUFFER=1`、`FB_IRQ_PACING=1`（当前默认**全开**）。

### 6.2 FinalDemo：场景 / 路径 / 命令集

| 维度 | 取值 | 说明 |
| --- | --- | --- |
| 场景（**数字键 1/2/3**） | `SC_FILL`=1、`SC_ALPHA`=2、`SC_KEY`=3（源码宏 `SC_FILL/SC_ALPHA/SC_KEY`；回包 `EV scene=1 (0=FILL 1=ALPHA 2=KEY)`） | FILL 不透明色块 / ALPHA 半透明混合 / KEY color-key 精灵 |
| 路径（**s / c / h**） | `PATH_SPLIT=0`（同屏对比：**左硬件 / 右纯 CPU**）、`PATH_CPU=1`（纯 CPU）、`PATH_HW=2`（纯硬件） | 切换即 `repaint_hw = repaint_cpu = 1`（双侧全重铺） |
| N | **25–6000，步进 25**；`n`/`+` 加 25、`-` 减 25（越界回绕）、`=N` 精确设置（行命令，需 `\n`） | 回包 `EV N=<值>` |
| alpha | `a` 减 32 / `A` 加 32（限幅 0~255）；回包 `EV alpha=<值>` | |
| 尺寸 | `k` 循环 **16 → 32 → 64 → 16**（固件按新尺寸重建图集 + 4×4 掩码 + 重初始化场景并重铺两侧）；回包 `EV size=16/32/64` | 几何表 8 → **11 条**（三场景各一条 64×64） |
| 清屏模式 | `e` = 每趟**整片重铺**开关；回包 `EV clear_per_pass=1 ...` | [成果] 所有板级读数都在 `e` 开下取 |
| 推进模式 | `t` = 按帧推进 ⇄ 按时间推进（默认时间：**40 ms/步 = 25 步/秒**，`SCENE_TICKS = BSP_CLINT_HZ/25`）；回包 `EV advance=1 ...` | |
| 显示列表 | `l` 开关（**默认关**）；回包两段：`EV dl on/off pending` → 帧边界生效 `EV dl on/off`；信息条出现 `L` 标记 | 见 §6.4 |
| 其它 | `r` 重置场景（换种子，回包 `EV reset`）、`?` 帮助 | |

**1 Hz 帧率统计**：屏幕上 `HW=` 硬件路径帧/秒、`CPU=` 纯 CPU 帧/秒、`SCR=` 已发布帧/秒 —— **三个计数在同一窗口一起清零**，
可以直接横向对比（FinalDemo.c:2188-2196）。场景推进与 OSD 刷新共用一个 tick。

### 6.3 AdDemo：场景 / 命令集（v3.2 现状，做新 demo 的最佳模板）

屏幕布局：`y 0..16` 信息条（**在渲染区之外**，每趟整片重铺不会碰它）、`y 16..540` 渲染区 960×524。
信息条本身也是引擎画的（先 FILL 黑底，再把每个字符当 8×8 KEY 精灵从字形图集抠出来）。

| 键 | 功能 |
| --- | --- |
| `1`..`5` | 场景 **GLOW**（ARGB4444 辉光 + **加算混合** + 每精灵独立 alpha，走 ATTR 侧口）/ **FADE**（扫描输出 LUT 全屏淡入淡出，**零 DDR 带宽**）/ **CLIP**（scissor 把 playfield 锁在中央矩形，矩形外 HUD 照画）/ **LAYER**（整幅背景 COPY + 大量加算辉光 + 周期性白闪）/ **THRU**（把精灵数顶到帧预算边缘，直接读 FPS/N/MPX/引擎占用） |
| `n`/`+`、`-`、`=N` | N 步进 **32**，**16–6000** |
| `k` | 精灵尺寸循环 |
| `t` | 时间（25 步/秒）⇄ 按已发布帧推进 |
| `a`/`A` | master alpha 减/加 |
| `f` / `b` | LUT fade/flash 总开关 / 立刻白闪一次 |
| `x` | **scissor 开关（A/B，场景 3）** |
| `y` | **属性侧口开关**（关掉 ⇒ 逐位回到 FinalDemo 语义） |
| `q` | 场景 5 的自动 N 爬升 |
| `r` / `?` | 重置场景 / 帮助 |
| `d` | 立刻打一行 `EV diag`（也 1 行/秒）：`fps n sz \| scn/ab/un`（欠载/看门狗）`st=STATUS clip=CLIP_CTRL lut=LUT_CTRL lbank=LUT_STAT stto flp flpt` |

信息条字段：`FPS=nn N=nnnn SZ=nn MPX=nnnn SCd:NAME A=nnn B=nnn [FR][F][X][Y][Q]` + 右侧 `HW ONLY`。
- **FPS = 真正上屏的帧率** = 翻转被扫描输出**确认生效**的次数/秒（FLIP 口径）；
- **MPX = N × SZ × SZ × FPS / 1e6**（由精灵数与尺寸算出的等效像素吞吐，Mpx/s）；
- **B = 引擎 busy 百分比（采样）**；`FR F X Y Q` = 模式标志位。
- 信息条最坏宽度已被主机自检约束：`"FPS=99 N=6000 SZ=64 MPX=9999 SC4:LAYER A=255 B=100 FR F X Y Q"` = 61 字符 = 488 px（文本 x=[8,496)，标签 x=[896,960)）。

**AdDemo 的"配对纪律"（新 demo 必须照抄的一条）**：ATTR 是**一条 FIFO**，引擎只是"每条命令弹一个"，它**不知道你写了几个**。
⇒ 一旦开始用属性，就必须**每条命令都写且只写一个**（想要默认行为的那条也要写 `ATTR_DEFAULT=0x00003FC0`）；
不用属性时**一条都不写**（按 `y` 关掉侧口）。混合"写了/没写"必然错位（后写的属性被前面那条没写属性的命令吃掉）。
AdDemo 把这件事收敛到**唯一一个函数 `blt_emit()`**，没有命令绕过它 ⇒ 结构上不可能错位。

**AdDemo 的两处上板 bug（对写新固件是直接教训）**：
1. 字形图集的"源行跨度（16 B）"与"字形间距（128 B）"被当成同一个数 ⇒ 信息条糊；
2. `FADE_PERIOD_MS`/`FLASH_MS` 是**毫秒**却被当 CLINT **拍数**用（100 MHz ⇒ 1 ms = 100,000 拍）⇒ "场景 2 不淡、场景 4 惨白"。
3. 另修：所有"等引擎"的等待改为**有界**（`ST_WAIT_TICKS=200 ms`，超时打印诊断 + 软复位引擎 + 重开本趟）——
   引擎一旦进去 `STATUS.ERR`（电平锁存，只有软复位能清），原来的无限空转会让屏幕冻死、切场景也切不回去。

### 6.4 FinalDemo 的显示列表（DL）错误处理与降级（tools/README.md §3.4）

| 机制 | 行为 |
| --- | --- |
| 能力探测 | 打开 `l` 先读 `DL_VERSION(0x80)`；若 <2（老位流读回 0）⇒ `EV dl not supported`，开关**保持关闭**（避免"以为在跑列表其实没下发"的假成功） |
| 超时编程 | 每次 arm 把 `DL_TIMEOUT(0x78)` 写成 **65535** 并回读打印（`EV dl arm ok: timeout=65535/65535 ticks ... GEOM_MAX=11`） |
| 出错现场 | `EV DL_ERR code=.. idx=.. unsup=.. fault=..` + `DL_STATUS` 解码 + `stall_seen`（**把组合位 STALL 在轮询期粘住**）+ `clr fb/to/err` + 提示行；DFU 落 BUSY=0 后补 `EV dl post-mortem: perf=..` |
| 重试 | **只对 WATCHDOG 重试，最多 1 次**（[成果] §4.1；早期为 ≤2）；1 s 窗口内第二次事件 ⇒ **直接停用列表路径**（不再自动重臂，按 `l` 重开） |
| 降级 | 自动退回逐条下发：`EV list path OFF, fallback to per-command`，画面继续刷新 |
| 诚实的提示 | 失败提示按 `idx / CONSUMED / stall_seen` 改说"取指被饿住"（`stall_seen=1`）而不是一律甩给几何表 |
| 清屏计数 | `clr fb=<n> to=<n> err=<n>`：`fb` = 目标缓冲不干净/本趟整片重铺退回引擎关键路径的次数；`to`/`err` = 等清屏超时 / 硬件互斥拒绝。稳态下三个数都不该增长 |

---

## 7. 已做优化与实测效果（一览）

| # | 优化 | 提交/版本 | 做了什么 | 实测效果 |
| --- | --- | --- | --- | --- |
| 1 | **像素打包乒乓** | v2.8（`87d0f76` 内含） | `pixel_path` 加 177 bit staging（`h_acc/h_mask/h_addr/h_v`）：词满当拍落 staging、下一拍由独立推词通路送 `wd` FIFO | 整屏 FILL 585 387 → **520 588**（**−11.07%**）；`max_px_run` 8→960；`FLUSH_*` 全 0；行周期 1083→**963** |
| 2 | **写突发合并** | v2.9 | 合并判据拆成 `dout_v`（本拍真有新词）与 `cnt_more`（吃掉队头还有货）+ `HOLD_MAX=16` 愿意等 + 4 KB 跨页检查 | AW 64 800 → **4 050**（理论下限）；`burst_avg` 1.000→**15.996**；写主机 AXI 侧 **8.0→1.13 拍/词**；代价：命令尾 +52 拍 |
| 3 | **S1 命令尾冲刷提示** | v2.10 `5b6b9a9` | 引擎在进 `ST_WDWAIT` 那拍给 `wr_cmd_end`；写主机进尾模式（放宽 `word_here`，判据改 `wd_count==0` 后再等 `TAIL_GRACE=4` 拍） | 32×32 FILL 1 232 → **1 199**（−33）；整屏 520 640 → **520 607**；`ENG_WDWAIT` 63→30；AW 4 051→**4 050**；兑现率 **33/52 = 63%**（不是口述的 84%），余 19 拍是最后一页 16 拍突发的 AW→W→B（真实搬运） |
| 4 | **S2 显示列表 / 描述符表** | v2.11 RTL `bba9a60` + 软件 `904048f` | 新增 `rtl/dl_fetch.v`（DFU）：DDR 读 16 B/条 → 查几何表（16 条直接映射 cache）→ 展开成现有 8 字命令 → 推进现有 cmd_fifo | 仿真列表 **367.2** vs 逐条（串行）**384.0** = **+4.4%**；**功能达标、性能目的未达**（原设计算术以为能省 ~190 拍，实测 CPU 下发大部分本来就被 256 条命令 FIFO 藏住，真正能省 ~55 拍/精灵 ≈4%） |
| 5 | **S3 透明块掩码** | v2.12 RTL `7099faf` + 软件 `e163d44` | 4×4 块位图（16 bit）走 `dw3[15:0]` + `FLAGS[7]=MASK_EN` + `FLAGS[9:8]=01`；进引擎走 `w0[31:16]`+`w0[2]` 空位；落地为**行窗口**（每行只取/只画 [第一个非透明列块起点, 最后一个非透明列块终点]；整条行带全透明 ⇒ 该行 0 取数/0 算/0 写） | demo 球 **0%**（几何必然）；典型弹 −4.5%（16×16）/**−21.4%**（32×32）；小弹 **−68.1%**（1 419→452）；`pixel_path.v` 一行未改；16 KB FB 位精确 0 mismatch |
| 6 | **64×64 尺寸档** | v2.16 `f47222a` | `k` 循环 16→32→64→16；几何表 8→11 条；场景初始化边界尺寸感知；白环厚度 `SPR_W/8` | 板上 64×64 **6 742.7 拍/精灵**（ALPHA）/4 450.0（FILL）/5 537.5（KEY）；**92.0 Mpx/s**（FILL = 渐近线 94%）；主机自检 301/301；`tb_dl_demo` 67 PASS/0 FAIL/0 字节差；bin 26 930 B、RAM 25.87% |
| 7 | **双 lane 像素通路** | v3.1（功能清单 §27） | `pixel_path` 一拍吃 2 像素（配对**只在 dst 偶 lane 上做** ⇒ 一对永不跨 16B 词、一拍最多成 1 词）；`stream_reader` 两个 128bit 词槽 + **载入即弹词**预取 | 整屏 FILL **520 607 → 261 407 拍（1.99×）**；整屏 COPY 649 755 → **262 035（2.48×）**；32×32 各算子 1.67~1.80×；16×16 FILL 366→239；写侧不受拖累（AW 4050 不变、`wd_full=0`）；新增 `tb_px_path` 26 880 用例 |
| 8 | **S5（v3.2）属性侧口 + scissor + LUT** | 功能清单 §28 | 0x8C（深 16 FWFT 属性 FIFO，命令起始按序弹 1）+ 0x90~0xA0 scissor（半开区间、命令起始锁存）+ 0xA4~0xB0 双 bank 扫描 LUT | 探针 **310 行零代价**（与 v3.1 逐行一致）；scissor 省拍 **1199→212（−82.3%）**；LUT 整表写入期间 2339 DE 像素异常 0；回归 **47 项 0 失败** |
| 9 | 三缓冲 FLIP + 帧边界中断 + 并发清屏引擎 | v2.7（功能清单 §21） | `FB_SEL` 请求 + 帧边界锁存；`IRQ_STATUS[1]` 帧中断；`clr_engine` 后台清屏 + `DRAW_SEL` 硬件互斥 | FinalDemo 默认全开；"整屏 COPY → FLIP"后**不再每帧搬一次屏**（模板：`hw_pass_arm()` ① 等清屏空闲 → ② arm 本趟） |
| 10 | 命令尾 `TAIL_GRACE` 已知残留 | — | 32 词被切 16+15+1 三笔 AW（理论 2 笔） | 调 `TAIL_GRACE` 到 6~8 即可（参数、无逻辑代价） |

**流程侧成果**：`ifdef` A/B + 逐位一致性 + 回归清单制度化（**35 项** → v3.2 **47 项**，含 3 项**预期失败**的 A/B 对照）；
"先造仪表再下结论"被显式写成方法论教训（本批 5 条作废结论里 4 条根因是口径）。

---

## 8. 软件 vs 硬件渲染对比是怎么做的

| 手段 | 说明 | 来源 |
| --- | --- | --- |
| **SPLIT 同屏对比** | `s` 键进入 `PATH_SPLIT`：**左半屏硬件画、右半屏 CPU 逐像素直写**，同一屏、同一帧、同一场景数据 ⇒ 肉眼与计数都能直接比 | tools/README.md §3.1、FinalDemo.c |
| **三计数器共享窗口** | 屏幕信息条 `HW=` / `CPU=` / `SCR=`（published frames/s），1 Hz 一起清零 ⇒ 横向可比 | FinalDemo.c:2188-2196 |
| **同口径成本行** | 两条路径各打 `cycles` + `cyc/sprite`（1 Hz，串口） | [成果] §2.1 |
| **单变量 A/B 纪律** | 同场景、同 N、同尺寸，只翻一个开关（`l`/`k`/掩码/`e`/`x`/`y`）读前后两行 | [成果] §2.4 |
| **作废的错误做法** | ① 拿"纯硬件列表"比"含 CPU 的逐条墙钟"；② 用不同 N 的两行相减；③ 在模式切换/回退重绘窗口采样；④ 把"板−仿真"整段归给某模块 | [成果] §2.5、§5 |
| **软硬件位精确对照** | `tb_dl_demo` 把固件真实描述符字节喂进真实 RTL 比命令字 + 比像素；主机自检在 PC 上跑固件被标记的源码段 | [成果] §2.3 |

> **`软/硬件` 对比的三个数字口径要分清**：
> (1) 列表行 = **纯硬件** GO→DONE（`DL_PERF`）；(2) 逐条行 = **墙钟**（含 CPU 下发）；
> (3) 屏幕 `FPS` = **真正上屏（FLIP 确认）** 的帧率；`MPX` 是由 N/SZ/FPS **算出来**的等效吞吐，不是实测带宽。

---

## 9. 已知限制、瓶颈、TODO、未决问题

### 9.1 已作废的旧结论（**不要再引用**）

| # | 曾经的结论 | 为什么错 | 修正后 |
| --- | --- | --- | --- |
| (a) | 显示列表把"稳定 60 的块数"提高 **41~48%**（设计文档原文 "+104%" / "+42%"） | 把"板上 561 − 仿真 366 ≈ 195 拍"整段当 CPU 下发成本，并假设完全不能与引擎重叠 | 实测 **≈+4%**（仿真 +4.4%、板上 +4.3%）；真正没重叠的只有 **~55 拍/精灵**（命令 FIFO 深 256） |
| (b) | 每帧有 **~6.7 ms（40%）** 固定开销在关键路径上 | 把"帧率没到 60"整段归给固定开销，没区分"引擎在跑"与"帧边界在等" | 帧内非本趟拍数 **109k~265k = 6.5%~15.9%** |
| (c) | 列表路径在板上 **净亏 43%**（1 232 vs ~863 拍/精灵） | **污染的 A/B**：两侧 n 不同、取自模式切换/回退重绘窗口，且拿纯硬件比含 CPU 墙钟 | 同口径 1 231 vs 1 286 ⇒ 列表 **+4.3%**（这一次也仍不是严格 A/B） |
| (d) | 整片重铺在列表模式下回到关键路径 | 读代码即否证：两条路径都调用同一个 `hw_pass_arm()` | 不成立 |
| (e) | 仿真每精灵成本可直接搬到板上 | 仿真存储器模型仅 32 KB、**无 DDR 竞争/换页/刷新** | 仿真列表 16×16 367 拍/精灵 vs 板上一次列表读数 1 232（**≈3.4×**）；同尺寸 ALPHA 仿真 464 vs 板上 856（+84%）。**FILL 例外**（整屏仿真 vs 板差 0.09%）⇒ **FILL 结论可信，读类只做相对比较** |

### 9.2 瓶颈的根本判断（[成果] §6）

1. **吞吐的墙 = 像素通路**（v2.16 时是单 lane 1 px/拍；v3.1 已加宽到 2 px/拍）。
   `B_FILL = 1.025` 拍/px（= 0.976 px/拍 = 97.6 Mpx/s 渐近线）；整屏 FILL 实测 0.9958 px/拍；
   `A_FILL = 252` 拍只占 64×64 的 5.7%、占 16×16 的 49% ⇒ **尺寸档杠杆用尽**。
2. **DDR 带宽不是限制**：实测口径下占用 **9%~29%**（最高 64×64 ALPHA 28.5%），按线速外推也只有 37.5%；
   写侧独立证据：AW 合并后 1.13 拍/词 ⇒ 可持续 ~1.42 GB/s。
3. **DDR 延迟 / 公平性是真弱点**：描述符读最长等待 **64 拍 = `AGE_MAX`**（提权生效）；
   **非引擎读流（CPU）在引擎压满读口时等 39 998 拍**（窗口 40 000 拍）；板上描述符读被饿过 `DL_TIMEOUT`
   （看门狗在**随机序号**触发、`stall_seen=1` = 被饿住不是死了），**超时值已提到字段上界 65 535 拍仍会触发**。
   ⇒ 判断：**"带宽够、延迟/公平性不够"**；描述符取指只占 18.3% 授权份额，却会被引擎长突发排到 65 535 拍之外。
4. **读路径公平性是现在就妨碍演示的缺陷**（ALPHA/KEY 场景列表路径会被看门狗打断并停用 ⇒ 那些场景收益为 0）。

### 9.3 TODO / 计划项状态（[成果] §7 + 功能清单）

| 优先级 | 项 | 文档里的预期 | **实际状态** |
| --- | --- | --- | --- |
| P1 | 双 lane 像素通路 | 64×64 FILL 92.0 → 177.9 Mpx/s（按 85% 兑现 ≈160） | **已落地（v3.1）**：整屏 FILL 1.99×、COPY 2.48×；**未上板验证** |
| P2 | 读路径公平性 / 描述符预取 | 让列表路径在 ALPHA/KEY 真正可用 | **未做**。具体 4+1 件小事：加深描述符预取（`CHUNK` 8→16/32、`FIFO_WM`）；desc ageing `AGE_MAX` 64→16~32；`DL_STATUS.STALL` 做成**粘住位**（现在是组合位，`S_ERR` 后恒 0，固件只能自己粘）；`DL_PERF` 在错误时刻也给"到目前为止"拍数；**BUSY 期间写 0x4C~0x88 不要静默丢**（现在 `if (ws[0] && !dl_busy)` ⇒ 写进去读回旧值，`7bdd307` 的"GEOM_MAX 被丢"坑就是这么来的；应反压或至少置 ERR 位） |
| P3 | 降低读流量（调色板 + 4bpp 索引纹理） | ALPHA 6 → 4.5 B/px（−25%）；KEY/COPY 源读 −75% | **未做**。风险：4bpp 量化会改变颜色 ⇒ ALPHA 位精确基线必须重建；解包器加进组合锥；S3 收益全靠美术 |
| P4 | 逐像素 alpha + 可编程混合（**走属性侧口，不是显示列表**） | 新增表现力而非吞吐 | **已落地（v3.2，0x8C `ATTR_PORT`）** |
| P5 | 扫描输出颜色 LUT + scissor | 全屏效果零带宽；scissor 一次寄存器写代替整片重铺 | **已落地（v3.2，0xA4~0xB0 / 0x90~0xA0）** |
| P6 | 主频 112.5 MHz | +12.5%（92.0 → 103.5 Mpx/s） | **有硬证据说不行**：V3.0 P&R 报 `core_clk` setup slack **1.063 ns**、hold slack **0.026 ns**、`Maximum possible analyzed clocks frequency = **111.894 MHz**`（周期 8.937 ns）；112.5 MHz = 8.889 ns 比上限还紧 0.048 ns ⇒ **掷骰子**。最紧 setup 路径**不在像素通路**，是 `u_blt/u_eng/issue_r[*] → u_dl/rd_beats[*]/d_addr_r[*]`（S2 取指器使能锥） |
| P7 | 明确降级/搁置 | S4 命令内多精灵；S3 的"内部块跳过"；显示列表 RTL 进一步改进 | 搁置理由：在 `B` 没降、读路径没修之前收益上限低，且与写序屏障（`ST_WDWAIT` + `wr_commit_idle`）的交互是全新风险面 |

### 9.4 资源与时序现状（V3.0 P&R 产物，**v3.1/v3.2 之后未重新 P&R**）

| 项 | 数字 |
| --- | --- |
| 全片 | 17 858 FF（23%）、18 111 LUT（31%）、116 RAM、21 DSP |
| `u_blt` | 9 038 FF / 6 970 LUT / 37 RAM / 16 DSP |
| `u_dl:dl_fetch` | 3 208 FF / 2 676 LUT / 7 RAM / 2 DSP |
| v3.1 新增 | ≈ **+284 FF**（两个 `stream_reader` 词槽）；ALPHA 乘法器 6→12 个 8×8（组合深度不变、面积/DSP ×2） |
| v3.2 新增 | ≈ **+250 FF** + 3 块 512×8 双口 RAM（LUT 三通道）+ 属性 FIFO 16×32 分布式 RAM；**像素通路多一级串联乘法器**（`展开 → sprite_alpha·global_alpha → ÷255 → mux → fg·A → +127 → >>8 → 5/6/5`），且该锥由运行期信号 `blend` 门控 ⇒ **综合器无法按模式剪掉**，即使用户从不写属性也在网表里 |
| 固件 v2.16 | bin **26 930 B**、RAM **271 264 B / 25.87%**、链接 0 错误 |

### 9.5 文档/代码里的已知不一致（会误导下一个读代码的人）

| 项 | 现状 | 应做 |
| --- | --- | --- |
| `FinalDemo.c:1172-1174` / `:1750-1751` 注释 | 仍写"列表净亏 43%"（已被 [成果] §5(c) 作废） | 改为"同口径 1 231 vs 1 286 = +4.3%；旧结论是污染的 A/B，已作废" |
| 串口/文档超时文案 | 仍写 `~753us@87MHz`（`FinalDemo.c:184/186/1148/1557`、`tools/README.md:122-123`），但 core_clk 是 **100 MHz** | 改成 **~655 µs@100 MHz**（65 535 拍 ÷ 100 MHz）；复位值 4096 拍同理：47 µs@87MHz → **41 µs** |
| `tools/README.md` 示例读数 | `GEOM_MAX=8`（v2.15 之前） | 现为 **11** 条 |
| 上板原始日志 | **本批全部板级读数（含九组成本行）没有归档** | 建议按"场景/尺寸/路径/N/cyc/sprite"存成 `doc/logs/board_costline_*.txt` |
| 回归项数 | [成果] 按 **35 项**记（`run_regress.ps1` 35 个表项）；`7bdd307` 提交信息写 36/36（提交信息偏差，不影响结论） | v3.2 已是 **47 项** |
| [成果] §5(a) "41~48%" | 仓库里查不到出处（只有 "+104%" 与 "+42%"） | 已标注未验证 |

### 9.6 其他实测限制（做设计时的硬边界）

| 限制 | 数字/事实 |
| --- | --- |
| 命令间**零重叠** | `ST_WDWAIT` 写提交屏障把命令完全串行化（64 块背靠背只藏住 63 拍 = 0.075%）⇒ 每个精灵的固定开销 `A` 是**串行**加在帧时间上的 |
| 每条命令仍有 **19 拍**合并固有代价 | 整屏摊薄 0.01%，但 16×16 这种小命令占 **4.4%** |
| `TAIL_GRACE=4` 边界 | 若上板发现尾词偶发被切（AW 笔数比理论下限多）应调到 6~8（参数，无逻辑代价） |
| 掩码收益取决于美术 | 只有 `R ≤ 0.442W`（16×16）或 `R ≤ 0.398W`（32×32）的精灵才标得上**第一块**；中间透明块仍会走一遍（要跳必须把一行取数拆成多笔突发 = S4） |
| 64×64 测量粒度退化 | N 只有 225~350，步进 25 ⇒ **±7%~±11%**；这一档以后要看小改动得靠"步进 1"或加长采样窗 |
| S3 掩码无诊断 | 由软件（`build_atlas()` 的 `spr_mask_of()`）算，**写错没有错误位可查，只会少画** |
| DL 无属性槽位 | 16B 描述符 4 个字全占满 ⇒ **AdDemo 只用逐条路径**；要让 DL 支持属性需先在 RTL/接口定义"属性从哪来" |
| scissor 的骨架不变量 | 信息条 / HUD / 边框 / 场景底图（dst 在 (8,4) 这类位置）**只能在 `CLIP_CTRL` 关着时下发**，否则平移后与窗口无交集 ⇒ 整条消失（上板症状 = 场景 3 信息条与 HUD 不见了） |
| printf 雷区 | BSP 的 `print.h` 只认 `%c %s %d %X %x`；用 `%u`/宽度/`%%` 会错位消耗 `va_arg`，后面的 `%s` 拿整数当指针**直接挂死** |
| Efinity/上板缺口 | v3.1/v3.2 的功能**都只到仿真**（探针零代价、位精确、47 项回归），板上判据在功能清单 §27.7/§28.7 里写成"应该"；v3.2 的 bitstream 与 AdDemo_v3.2 已归档但**本笔记未找到 v3.1/v3.2 的板级性能读数** |

---

## 10. 面向"新高负载交互式游戏 Demo"的设计要点（把上面变成可执行约束）

### 10.1 容量预算（用 [成果] 的 `A + B×px` 模型，单位 = 精灵/帧 @60 fps）

按 **1 666 667 拍/帧**，且假设能用满**整帧**（现实中要留出扫描输出/清屏/OSD/翻转的余量）：

| 场景 | 每精灵拍数（板上 v2.16 口径） | 理论容量/帧 | 建议设计余量（≤70% 帧预算） |
| --- | --- | --- | --- |
| 16×16 FILL | 514.3 | ~3 240 | **≤2 270** |
| 16×16 KEY | 719.1 | ~2 318 | **≤1 620** |
| 16×16 ALPHA | 856.4 | ~1 946 | **≤1 360** |
| 32×32 FILL | 1 263.8 | ~1 319 | **≤920** |
| 32×32 KEY | 1 617.4 | ~1 030 | **≤720** |
| 32×32 ALPHA | 1 969.0 | ~846 | **≤590** |
| 64×64 FILL | 4 450.0 | ~375 | **≤260** |
| 64×64 ALPHA | 6 742.7 | ~247 | **≤170** |

- **v3.1 双 lane 之后的同口径数字尚未上板**：仿真上 32×32 FILL 1 199→687（1.75×）、16×16 FILL 366→239（1.53×）、
  KEY/COPY 类 1.67~2.48× ⇒ 上表可以按 **1.5~1.8×** 放宽估计（保守），但**必须自己上板复测**再定 KPI。
- 帧内**非本趟**开销实测 6.5%~15.9%（16×16 FILL 是离群点 15.9%）⇒ 不要把帧预算算满。
- **60 fps 之外的另一条口径**：屏幕 `FPS` 是"发布上屏"帧率；设计目标建议直接盯 `MPX = N·SZ²·FPS/1e6` 与 `B`（引擎 busy%）。

### 10.2 必须遵守的接口契约（新固件按这份清单写）

1. **命令 = 8 个 32bit 字连写 `0x08`**；`op = w0[1:0]`（0 COPY / 1 FILL / 2 ALPHA / 3 KEY）；非法 op ⇒ `STATUS.ERR` **电平锁存，只有软复位能清**。
2. **`CTRL.GO` 必须先写 1**（使能自动消费）；`STATUS.DONE = FIFO 空 && 引擎 IDLE`（**电平，不是脉冲**）；批量下发可超 FIFO 深度。
3. **上屏用 FLIP，不要每帧整屏 COPY**：写 `FB_SEL(0x24)` → 轮询 `FB_STAT(0x28)[1:0]`（**有界超时**）或按 `FB_IRQ_PACING` 用 `IRQ_STATUS[1]` 帧中断驱动；请求只在**帧边界**生效。
4. **清屏交给 `clr_engine`（0x2C~0x48），并遵守 `DRAW_SEL(0x44)` 互斥**：每趟开画前写 `DRAW_SEL` = 本趟目标；`CLR_STAT[6]` sticky ERR 要清；`CLR_WAIT_TICKS` 建议 10 ms（实测整片清 ≈ **2.1 ms**）。
5. **用 `ATTR_PORT(0x8C)` 就必须"每条命令恰好写一个属性字"**，收敛到唯一 emit 函数；不用就一条都不写。FIFO 深 16 ⇒ 最多领先 16 条。软复位清空属性 FIFO。
6. **scissor 坐标是本条命令目的矩形的局部坐标**（半开 `[x0,x1)×[y0,y1)`）；引擎在命令起始锁存 ⇒ 换窗口要在**引擎空闲**时写；屏幕骨架（HUD/信息条）只在 `CLIP_CTRL=0` 时下发。
7. **LUT 发布四步**（读 0xB0 → `0xAC bit1 = ~D` → 写 3×256 → `0xAC bit1 = D`）；开 LUT 前把表写完；写表期间不要翻 bank。
8. **掩码（S3）只能配 KEY，且 `W≥4 && H≥4`**；FILL/ALPHA/COPY 显式忽略；掩码错没有错误位。
9. **DL（显示列表）在当前板上不可靠**：ALPHA/KEY 场景描述符取指会被饿过 `DL_TIMEOUT`（65535 拍）⇒
   固件最多重试 1 次就停用。**新 demo 建议只用逐条下发路径**（也是 AdDemo 的选择），或只对"少读几何表/FILL 为主"的列表用 DL。
10. **1 Hz 成本行必须保留并归档**（`doc/logs/board_costline_*.txt`）：同口径、同 N、同场景比两行，这是唯一能证收益的仪表。
11. **`%d/%x/%s/%c` only** 的 printf 约束；所有"等引擎"的等待都要**有界 + 超时可恢复**（软复位 + 重开本趟）。
12. 高负载交互（按键/输入）的响应路径不要放在"等引擎"的循环里：AdDemo 的做法是"任何时刻都能切场景，串口命令循环绝不被阻塞"。

### 10.3 建议直接复用的模板

| 需求 | 复用对象 |
| --- | --- |
| 帧结构 / 三缓冲 FLIP / 清屏引擎 / OSD 信息条 | `AdDemo.c`（纯硬件路径，无 CPU 像素）与 `FinalDemo.c`（SPLIT 对比 + 成本行 + DL 降级） |
| 每精灵独立 alpha / 加算辉光 / 混合模式 | AdDemo 场景 1（GLOW）+ `blt_emit()` 配对纪律 |
| 全屏闪白/受击闪红/淡入淡出 | AdDemo 场景 2/4 的 LUT 四步发布 |
| 局部重绘（不整片重铺） | `scissor`（`CLIP_*`）+ AdDemo 的 `CLIP_GUARD`/`clip_off_verified()` |
| 板级性能仪表 | `FinalDemo` 的成本行 + AdDemo 的 `d` 诊断行（`fps n sz / scn ab un / st clip lut lbank`） |

---

## 11. 证据索引

| 类别 | 文件 |
| --- | --- |
| 本文主要来源 | `doc/性能优化成果与计划.md`、`doc/perf_probe_report.md` |
| 寄存器权威 | `rtl/blt_regs_axi_lite.v`（头注释 1–114 行）、`doc/加速器设计规划_RTL实现.md` §4（0x00~0x1C + 8 字命令表） |
| 一手功能记录 | `rtl/功能清单.md` §21（三缓冲/清屏/帧中断）、§22（打包乒乓）、§23（写合并）、§24（尾冲刷）、§25（S2，含 16B 描述符/几何表/DFU 状态机）、§26（S3）、§27（双 lane）、§28（S5） |
| 探针日志 | `doc/logs/log_tb_perf_probe*.txt`（含 `_dl`、`_cmdtail_on/off`、`_merge_on/off`）、`log_probe_px2on/off.txt`、`log_probe_s3_mask_on/off.txt`、`log_probe_s5_on.txt` |
| 回归 | `doc/logs/final_regress_v210_cmdtail.txt`（27 项）、`_v211_displaylist.txt`（32）、`_v212_s3mask.txt`（35）、`_v213_dlfix.txt`（35）、`final_regress_v31_px2.txt`、**`final_regress_v32_s5.txt`（47 项，末行 `==== regress failures: 0 ====`）** |
| 交叉验证 | `log_tb_dl_demo.txt`（固件真实描述符→真实 RTL，67 PASS/0 FAIL/0 字节差）、`host_selfcheck_v216_64x64.txt`（301/301）、**`host_selfcheck_AdDemo.txt`（156/0）**、`build_v216_64x64.txt`（RAM 25.87%） |
| 时序/资源 | `ARC_2DRA/par/ddr_demo_ti60/outflow/ddr_demo_ti60.timing.rpt`（core_clk setup 1.063 ns / hold 0.026 ns / 最高 **111.894 MHz**）、`...res.csv` |
| 固件 | `.../standalone/FinalDemo/src/FinalDemo.c`（2840 行，对比 demo）、`.../standalone/AdDemo/src/AdDemo.c`（2310 行，v3.2 纯硬件 demo）、`firmware/README.md` |
| 上位机 | `tools/serial_console.html` + `tools/README.md`（命令表、看门狗判读、`EV` 回包格式）、`tools/ad_demo_console.html` |

---

## 12. 本笔记自身的不确定项（如实列出）

| 项 | 状态 |
| --- | --- |
| [成果] §3.1 九组成本行的原始串口日志 | **未验证**（数字来自 [成果] 复述 + 与 §3.2/§3.3 的内部一致性校验；日志未入库） |
| [成果] §4.4 的阈值/收益对照表（R/W → 块数） | **模型推导**（按固件几何独立复算，仓库无留档） |
| [成果] §7.1 的 1.6~1.9× 与 85% 兑现率 | **模型推导**；但 v3.1 已实测（1.53~2.48×，随算子不同） |
| v3.1 / v3.2 的**板级**性能读数 | **本笔记未找到**。功能清单 §27.7/§28.7 明确"未做 Efinity 综合/P&R、上板"；所有 v3.1/v3.2 数字都是仿真 |
| AdDemo 的板上 FPS/N 实测值 | **未找到归档**（`host_selfcheck_AdDemo.txt` 只有主机自检 156 项） |
| AdDemo 的 `k` 尺寸档具体取值 | **已核实**：`BLK_LO=16 / BLK_MID=32 / BLK_HI=64`（与 FinalDemo 同档）；`N_MIN=16 N_MAX=6000 N_STEP=32`；`SCENE_TICKS = BSP_CLINT_HZ/25`（40 ms/步） |
| [成果] §5(a) "41~48%" | 仓库里查不到出处（只有 "+104%"/"+42%"） |
| `git log` 证据 | **本工作区不含 `.git`**（`git log` 报 "not a git repository"）⇒ 提交号只能按文档转述，无法就地复核 |
