pekeppp/2D_Rendering_Acceleration-deprecated-v3.2/rtl/功能清单.md

# BitBlt 2D 加速器 RTL 功能清单（讨论稿 v0.2 · 决策已定）

> 依据：《加速器设计规划_RTL实现.md》（960×540@60 主线）、《赛题二_方案设计与原理讲解.md》、
> 软硬件契约 `software/blt_regs.h` / `software/README.md`、行为金标准 `simulator/sim_model.py`。
> 用途：写代码前逐条对齐；每条前面打勾/打叉/加备注。

---

## 0. 范围与主线参数（已确认）

- 输出图像规模：960×540@60（qHD）；像素 RGB565；行距 1920B（=120×16B）。
- 帧缓冲双缓冲：FB0/FB1 = DDR_BASE+0x300000/+0x400000（每张 0xFD200 < 1MB）。
- 引擎：core_clk 100MHz 单时钟域；扫描输出另配 pixel_clk 37.36MHz（跨域仅行 FIFO）。
- 总线：AXI-Lite 从机（寄存器）+ AXI4 主机（数据，INCR 突发，128bit 口 → 1 拍 16B = 8px）。
- 指令契约：8×32bit 一字条，字段与 `blt_cmd_t` 一致；GO 自动消费；DONE 电平。

## 0b. 讨论结论（2026 讨论定稿，全部采纳推荐项）

1. **分期**：先引擎（M1~M9 + TB），扫描输出（M10）第二阶段。
2. **op 覆盖**：v1 直接实现 4 种 op：COPY / FILL / KEY / ALPHA。
3. **AXI 主机口**：参数化 `AXI_DATA_W`，默认 128bit；TB 可先用小宽度验证通道逻辑。
4. **ALPHA 读流**：段内双读流并行——fg 突发与 bg 突发同时发起，分别进 src_fifo / bg_fifo，
   像素通路混合后进 wd_fifo，攒够一段写回。
5. **端序**：像素按 16bit 小端连续存放，低地址像素在 128bit 拍的低 16bit lane（lane0=px0）
   ——与 C `uint16_t fb[y*W+x]` 和 `sim_model.py` 内存视图一致。

### 契约硬约束（编码必须遵守，从 blt_regs.h/blt_drv.c/README 反推）
- `CMD_FIFO_COUNT` 以**完整指令条数**计；深度 = `BLT_CMD_FIFO_DEPTH`=256 条
  → 存储 **2048×32bit**（256 条 × 8 字）。
- `blt_fifo_avail = 256 − COUNT`；驱动满则自旋等待 → RTL 对 CMD 写满必须**反压（wready=0）不丢字**。
- GO 后引擎自动消费直到 FIFO 空且空闲 → DONE=1（电平）；BUSY 在 GO 后/执行中置位。
- CTRL 写：bit0=GO、bit1=IRQ_EN、bit2=SOFT_RST；`blt_init` 顺序：SOFT_RST→0→清 IRQ→IRQ_EN=0→GO。
- 错误恢复路径：驱动在 ERR 时写 SOFT_RST → 0（RTL 须能清 DONE/ERR/FSM、清 FIFO）。

## 1. 模块与功能（按 RTL 文件划分）

### M1 `blt_top.v` — 引擎顶层 ✅ 已编码+集成仿真通过
- [x] T1.1 例化：regs / cmd_fifo / engine_fsm / addr_gen / axi_rd_master / axi_wr_master / pixel_path / 数据 FIFO
- [x] T1.2 对外只有 AXI-Lite 从机 + 两组 AXI4 主机 + clk/rst_n + irq_done
- [x] T1.3 参数：`AXI_DATA_W`（v1 板级固定 128）、`CMD_FIFO_DEPTH` 256

### M2 `blt_regs_axi_lite.v` — AXI-Lite 从机 + 寄存器组 ✅ 已编码+仿真通过
- [x] R2.1 寄存器集：CTRL 0x00 / STATUS 0x04 / CMD_FIFO_DATA 0x08(W) / CMD_FIFO_COUNT 0x0C(R) /
       IRQ_STATUS 0x10(W1C) / IRQ_EN 0x14 / DBG_CUR_CMD 0x18(R) / PERF 0x1C(R)
- [x] R2.2 CTRL：bit0=GO（写 1 → run_en 置位，自动消费）；bit2=SOFT_RST（清 FIFO/FSM/DONE/ERR）
- [x] R2.3 STATUS 位：BUSY / DONE(电平=FIFO空且IDLE) / ERR / FIFO_EMPTY —— 与 blt_regs.h 逐位一致
- [x] R2.4 中断：DONE 完成沿 / 使能沿补偿 → IRQ_STATUS[0] 置位；W1C 清除
- [x] R2.5 CMD_FIFO_DATA 写满时反压（wready=0），不丢字
- [ ] R2.6 握手：AW/W/AR/B/R 全通道正确；非法地址 SLVERR
- [ ] R2.7 wstrb 字节使能更新写寄存器

### M3 `cmd_fifo.v` — 指令 FIFO（BRAM）✅ 已编码+仿真通过
- [x] F3.1 深度 256 条 × 8 字 = 2048×32bit（可参数化）；字满/字空/word_count/cmd_count 输出
- [x] F3.2 引擎侧逐字 pop；cmd_count = word_count>>3（floor），与 blt_fifo_avail 语义一致

### M4 `blt_engine_fsm.v` — 主控状态机 ✅ 已编码+集成仿真通过
- [x] E4.1 状态：IDLE → POP(8字) → DEC → EXEC(逐行) → WDWAIT；BUSY/DONE/ERR
- [x] E4.2 POP 弹 8 字（进入 POP 即弹，字序对齐）；op 校验（0~3，否则 ERR 停机）
- [x] E4.3 行循环：height 计数；行首地址 = base + row×stride（blt_addr_gen 组合）
- [x] E4.4 **行级重叠**：发送指针 issue_r / 处理指针 proc_r 双指针；"发第 r+1 行"发生在
      "算第 r 行"期间；像素通路拿到本行第 1 个词即可启动（边到边算），不再等整行收满
- [x] E4.5 行缓冲边界 issue_r ≤ proc_r+1（FIFO 内最多 2 行）；命令级等 wd 排空且写主机空闲
- [x] E4.6 BUSY/DONE 电平语义；读请求改为**信用握手**（rd_ready/rd_req），行内/行间突发背靠背
- [x] E4.7 SOFT_RST 联动复位（顶层 int_rst_n 门控引擎域全部逻辑）
- [x] E4.8 **精确 drain**：行尾丢字数 = cover_beats − (px_skip+W)/8 ∈{0,1}（原版 drain 到空与预取不兼容）
- [x] E4.9 `perf_cycles`：锁存每条指令的引擎周期数 → PERF 寄存器（0x1C）供软件统计

### M5 `blt_addr_gen.v` — 行地址 + 覆盖突发（纯组合）✅
- [x] A5.1 行首/对齐基址/字节偏移/px_skip/cover_beats 计算
- [x] A5.2~A5.4 16B 粒度边界由像素通路（WSTRB 打包）+ 覆盖读 + 行尾丢弃处理（含 ≤8px 单拍等边界）

### M6 `axi_rd_master.v` — AXI4 主机读 ✅ 已编码+集成仿真通过
- [x] B6.1 AR 通道：INCR、ARSIZE=4（128bit）、ARLEN=拍数−1；**最多 OUTSTAND=4 笔在飞**
      （AR 队列 + R 队列双小队列，rd_ready 为信用，上层可背靠背发突发）
- [x] B6.2 R 通道收数据 + RLAST；rready 由**队头**目标 FIFO 可收性门控（反压）
- [x] B6.3 流控：信用 = OUTSTAND − (AR队列+R队列)；同 ID 保序回程 → 按队头 tag 分路即正确
- [x] B6.4 rd_done + rd_tag 完成握手（fg/bg 双流路由）

### M7 `axi_wr_master.v` — AXI4 主机写 ✅ 已编码+集成仿真通过
- [x] W7.1 消费 wd FIFO 词 {mask,addr,data}，相邻词合并 INCR 突发（≤16 拍）
- [x] W7.2 WSTRB 逐拍直通（键控留孔词可位于突发中间）；WLAST 对齐
- [x] W7.3 B 响应串行（一笔完成才收下一笔）；wready 低时保持 WVALID

### M8 `pixel_path.v` + `stream_reader.v` — 像素通路 ✅ 已编码+集成仿真通过
- [x] P8.1 128bit↔16bit：reader 按 skip 起逐像素取、lane7 弹词 1 拍气泡；写侧词打包；行间 reader 复位
- [x] P8.1a **流式供给**：reader 的 en 改为电平（本行处理中），缺词自动等待 → 支撑行级重叠
- [x] P8.1b **弹词时序修正**：rd_en 改为组合（与本拍消费同拍生效）。原版寄存一拍会导致
      "弹词与载词同拍、载回刚弹走的旧词" → 每行第 2 个 16B 词重复第 1 个词
      （即**每行超过 8 像素就花屏**，原 TB 用例恰好都是 1 词/行，长期未暴露；T7 用例抓出）
- [x] P8.2 COPY 直通（TB T3）
- [x] P8.3 FILL 常量（TB T1 对齐 / T2 非对齐首尾掩码）
- [x] P8.4 KEY 键色跳过、留孔掩码、全空词不写（TB T4）
- [x] P8.5 ALPHA 定点混合，金标准 0x7BEF@α128 / FFFF@α255（TB T5/T6）
- [x] P8.6 v1 组合乘加（优化项：加寄存器级后走 DSP 推断，公式不变）；非 ALPHA 旁路
- [x] P8.7 覆盖读 padding 丢弃（取 W 像素后 drain 剩余词）

### M9 `sync_fifo.v`（参数化通用件）✅
- [x] Q9.1 src_fifo 128bit×**256**（行级重叠需容纳 2 行：960 宽一行 121 词）
- [x] Q9.2 bg_fifo 128bit×**256**（ALPHA 用，同上）
- [x] Q9.3 wd_fifo 176bit×16
- 注：约束单行覆盖 ≤ ~1016 像素（两行 ≤ 256 词），即 FB 宽 960 安全

### M10 `scanout_top.v` + `vga_timing.v` + `line_fifo.v` — 扫描输出（第二阶段）
- [ ] S10.1 寄存器：FB_ADDR / FB_STRIDE / VSYNC(LATCH,W1C) / CTRL.EN
- [ ] S10.2 vga_timing：960×540@60（1120×556，37.36MHz），DE/HSYNC/VSYNC 输出
- [ ] S10.3 行预取 AXI 读（120 拍/行 @16B）+ line_fifo（异步 16bit×2048，≥2 行）
- [ ] S10.4 RGB565→888 + DE/HS/VS 送 HDMI TX（03 号 demo RTL 复用）

## 2. 验证（与功能同步写）
- [x] V2.1 单元 TB：tb_cmd_fifo / tb_regs_axi_lite（含 FIFO 满反压 fork）全 PASS
- [x] V2.2 集成 TB：AXI BFM 伪 DDR（128bit）→ 指令级验证 COPY/FILL/KEY/ALPHA 断言 DDR（tb_blt_top T1~T8 全 PASS）
- [x] V2.3 对齐用例：非对齐 x 偏移（T2）WSTRB 逐字节边界断言、多行 stride（T3）
- [x] V2.4 ALPHA 金标准值比对：α=128 → 0x7BEF、α=255 → 0xFFFF（T5/T6）
- [x] V2.6 多词/行与多行压力用例：T7（32×24，3 词/行）、T8（64×8，1 词/行），
      全区域逐像素比对 + PERF 周期测量；从机升级为**支持多笔 outstanding 的流水化读**（MAXO=4，AR_LAT=20）
- [x] V2.7 PERF 寄存器回读校验（0x1C 锁存引擎周期数）
- [ ] V2.5 待补：300 条批量压测、GO=0 静默、与 `sim_model.py` 逐像素全图比对（后续扩展）

## 3. 本期明确不做（v1 不实现，文档记一笔即可）
- 重叠拷贝方向检测（驱动约定不产生重叠指令）
- 像素级 α 通道（只用指令常量 α，constant alpha）
- 引擎 2px/clk / 多像素宽口（后期优化项）
- 扫描输出"非显示区才写"的撕裂加固（双缓冲已够）
- DDR 带宽计数器细节（PERF 现只锁存"上一条指令周期数"，字节/命中率统计二期再加）

## 4. 讨论结论（见 0b，均已确认，编码按此执行）
1. ✅ 分期：先引擎（M1~M9 + TB），扫描输出（M10）第二阶段。
2. ✅ op 覆盖：v1 一次性实现 4 种 op。
3. ✅ AXI 主机口参数化 `AXI_DATA_W`，默认 128bit。
4. ✅ ALPHA 段内双读流并行（src_fifo + bg_fifo）。
5. ✅ 端序：16bit 小端连续，低地址像素在低 lane。

## 5. 编码进度跟踪（iverilog 自测）
| 模块 | 状态 | 自测 |
| --- | --- | --- |
| `cmd_fifo.v`（M3） | ✅ 完成 | tb_cmd_fifo 全 PASS |
| `sync_fifo.v`（M9） | ✅ 完成 | 随引擎 TB 复用 |
| `blt_regs_axi_lite.v`（M2） | ✅ 完成 | tb_regs_axi_lite 全 PASS（含满时反压） |
| `axi_rd_master.v`（M6） | ✅ 完成 | tb_blt_top 集成验证 |
| `axi_wr_master.v`（M7） | ✅ 完成 | tb_blt_top 集成验证 |
| `blt_addr_gen.v`（M5） | ✅ 完成 | tb_blt_top 集成验证 |
| `stream_reader.v` / `pixel_path.v`（M8） | ✅ 完成 | tb_blt_top T1~T8（含多词/行回归） |
| `blt_engine_fsm.v`（M4） | ✅ 完成 | tb_blt_top 集成验证 |
| `blt_top.v`（M1） | ✅ 完成 | tb_blt_top 集成验证 |
| `tb/axi_slave_mem.v` + `tb/tb_blt_top.v` | ✅ 完成 | 8 项场景全 PASS + PERF 周期测量 |

> 复现自测（oss-cad-suite 的 bin 与 lib 需在 PATH）：
> ```
> iverilog -g2001 -s tb_cmd_fifo  -o sim.vvp rtl/cmd_fifo.v rtl/tb/tb_cmd_fifo.v && vvp sim.vvp
> iverilog -g2001 -s tb_regs_axi_lite -o sim.vvp rtl/blt_regs_axi_lite.v rtl/cmd_fifo.v rtl/tb/tb_regs_axi_lite.v && vvp sim.vvp
> iverilog -g2001 -s tb_blt_top -o sim.vvp rtl/sync_fifo.v rtl/cmd_fifo.v rtl/blt_regs_axi_lite.v rtl/blt_addr_gen.v rtl/axi_rd_master.v rtl/axi_wr_master.v rtl/stream_reader.v rtl/pixel_path.v rtl/blt_engine_fsm.v rtl/blt_top.v rtl/tb/axi_slave_mem.v rtl/tb/tb_blt_top.v && vvp sim.vvp
> ```
> 注意：仿真 TB 内存数组不宜过大（1<<17 会让 iverilog 展开很慢），默认 1<<15。

## 6. v1 已知简化（文档化，后续优化项）
- ALPHA 乘加为**组合**实现（无寄存器级）→ 当前由 LUT 吸收；要进 DSP 需加
  s0/s1/s2 寄存器流水（pixel_path.v 内有注释位点），公式不变。
- 每行**整行预取**进 FIFO 再处理 → ✅ **已被第 7 节的"行级重叠 + 突发流水"取代**
  （src/bg FIFO 由 128 词提到 256 词以容纳两行）。
- 剩余优化余地：T8（64 行 × 8 像素）实测约 19 周期/行，瓶颈已从"读延迟"转为
  **写侧与行状态开销**（每行 AW→W→B 串行约 8~10 周期）。要再快可做写侧多笔 outstanding，
  或去掉 dr=0 时仍要走一趟 RS_DRAIN 的空转。
- 写侧按"词连续"自动合并突发，非连续（键控整词跳过）拆笔——正确性优先。
- M2 R2.6：非法地址返回 SLVERR 未实现（返回 OKAY/读 0），如需严格可补。

---

## 7. 性能改造：行级重叠 + 突发流水（已完成，含 A/B 实测）

### 7.1 改了什么

| # | 改动 | 文件 |
| --- | --- | --- |
| 1 | **行级重叠**：发送指针 `issue_r` / 处理指针 `proc_r` 双指针；"发第 r+1 行"发生在"算第 r 行"期间；像素通路拿到本行**第 1 个词**就启动，后续词边到边算 | `blt_engine_fsm.v` |
| 2 | **突发流水**：读主机由"单笔 outstanding"改为**信用握手 + 最多 4 笔在飞**（AR 队列 + R 队列，按队头 tag 分路），行内/行间突发背靠背发出 | `axi_rd_master.v` |
| 3 | **精确 drain**：行尾丢字数 = `cover_beats − (px_skip+W)/8` ∈ {0,1}（原版"drain 到空"与预取不兼容） | `blt_engine_fsm.v` |
| 4 | **流式 reader**：`en` 由 1 拍脉冲改为电平，缺词自动等待（行级重叠的前提） | `stream_reader.v` / `pixel_path.v` |
| 5 | 行缓冲 128 → **256 词**（容纳 2 行：960 宽一行 121 词）；计数值位宽 8→9 | `blt_top.v` |
| 6 | `perf_cycles` → **PERF 寄存器（0x1C）**，软件可读每条指令的引擎周期数 | `blt_engine_fsm.v` / `blt_top.v` |

### 7.2 顺带抓出的原版 bug（重要）

**每行超过 8 像素（1 个 16B 词）时，第 2 个词会重复第 1 个词的内容** —— 即宽精灵会花屏。
根因：`stream_reader` 的 `rd_en` 是**寄存**输出，导致"弹词"与"载入新词"发生在同一拍，
而 FIFO 读指针要到那拍结束才步进，于是载回的是刚弹走的旧词。
原 TB 所有用例恰好都是 1 词/行（≤8 像素），所以长期未暴露；demo 里的 16×16 精灵（4 词/行）会中招。
修复：`rd_en` 改为**组合**输出（与本拍消费同拍生效）。

> 教训：测试用例的**形状**要和真实使用一致。原来 6 个用例全是 8 像素宽，
> 恰好绕过了"多词/行"这条最容易错的路。

### 7.3 A/B 实测（同一测试台、同一从机模型 AR_LAT=20，单位：周期）

| 用例 | 改造前 | 改造后 | 提速 |
| --- | --- | --- | --- |
| T1 FILL 16×2 | 66 | 66 | 1.00×（不取数，无可重叠） |
| T2 FILL 非对齐 | 72 | 72 | 1.00× |
| T3 COPY 8×2 | 98 | 72 | **1.36×** |
| T4 KEY 8×2 | 98 | 72 | **1.36×** |
| T5 ALPHA 8×2（fg+bg 双流） | 148 | 74 | **2.00×** |
| T6 ALPHA α=255 | 148 | 74 | **2.00×** |
| T7 COPY 32×24（768px，3 词/行） | 1908（**且结果错误**） | 1068 | **1.79×** |
| T8 COPY 64×8（512px，1 词/行） | 2516 | 1220 | **2.06×** |
| PERF 寄存器 0x1C | 0（未实现） | 1216 | — |

结论：
- **不取数的 FILL 完全不变**（说明改造没有引入额外开销）；
- **取数越多、行越多，收益越大**，ALPHA（双流）与"多行薄行"都到 **2 倍**；
- T8 已从"读延迟受限"转为"写侧/行状态受限"（19 周期/行），说明**读侧流水已经不再是瓶颈**。

### 7.4 复现

```
iverilog -g2001 -s tb_blt_top -o sim.vvp rtl/sync_fifo.v rtl/cmd_fifo.v rtl/blt_regs_axi_lite.v \
  rtl/blt_addr_gen.v rtl/axi_rd_master.v rtl/axi_wr_master.v rtl/stream_reader.v rtl/pixel_path.v \
  rtl/blt_engine_fsm.v rtl/blt_top.v rtl/tb/axi_slave_mem.v rtl/tb/tb_blt_top.v && vvp sim.vvp
```
输出：`T1~T8` 全 PASS + 每个用例的 `PERF ... cycles`（A/B 时把 5 个 RTL 文件换成改造前版本即可，
测试台与从机保持不变，这样对比才公平）。

---

## 8. 工程接入（ARC_2DRA / ddr_demo_ti60）：APB 外设 + 总线仲裁

加速器要挂进 SoC 才能跑通渲染链路，新增两块"接入层"RTL（加速器本体未改动）：

### M11 `ARC_2DRA/rtl/blt/blt_apb_top.v` — APB 外设顶层 ✅ 已编码+仿真通过

- [x] A11.1 APB3 从口（位宽对齐 SoC `io_apbSlave_0_*`：PADDR/PWDATA/PRDATA 32bit、PSEL[0:0]）
- [x] A11.2 APB→AXI-Lite 桥：写 = AW+W 同发 → 等 B → **单独 1 拍响应**；
      读 = AR → 等 R 落数据 → **单独 1 拍把 PRDATA+PREADY 同拍给出**（避免"写完立刻读"读到旧值）
- [x] A11.3 内部例化 `blt_top`，把引擎的 AXI4 读/写主机引出给仲裁器；`irq_done` 引出（当前未接到 PLIC）
- [x] A11.4 指令 FIFO 满时靠寄存器组的 awready/wready 反压 → APB 自动插等待周期，不丢字

### M12 `ARC_2DRA/rtl/video/axi_wr_arb.v` — AXI 写通道 2 选 1 仲裁 ✅ 已编码+仿真通过

- [x] W12.1 owner 归属 + 写突发计数（AW 加、B 减）；**在飞突发未收完绝不切换**（B 靠 owner 分路）
- [x] W12.2 CPU 优先；BitBlt 等满 32 拍强制插队（防饿死）；BitBlt 连发 4 笔后让回 CPU（防独占）
- [x] W12.3 awlock/awcache/awprot 由 CPU 直通（引擎侧恒 0，DDR 控制器忽略这些语义）

### 读通道：两级级联（不新写模块）

- 复用已验证的 `axi_rd_arb` 两级：**L1 = CPU/BitBlt → L2 = (L1)/扫描输出**
  ⇒ 优先级 **扫描输出 > BitBlt > CPU**（扫描输出最高，防显示断流）。

### 新增自测

| 测试台 | 覆盖 | 结果 |
| --- | --- | --- |
| `rtl/tb/tb_blt_apb.v` | **APB→寄存器→引擎→AXI→行为 DDR 全链路**（软件真实路径）：寄存器读写回环、FILL/COPY 断言、PERF/DBG/FIFO_COUNT | ALL PASS |
| `rtl/tb/tb_axi_wr_arb.v` | 写仲裁：两主机各 1250+ 笔、无饿死、B 不错路、数据逐字节一致 | ALL PASS |
| `ARC_2DRA/rtl/tb/stub_vendor.v` | `soc`/`ddr3_top` 空壳，用于顶层整体 elaboration（`-Wimplicit` → **0 error / 0 implicit**） | — |

### 接入时修掉的工程级 bug

`ARC_2DRA/rtl/ddr3_example_top.v` 里 `apb_paddr/apb_pwdata/apb_prdata` **原先没有声明**，
被 Verilog 当成 1 位隐式线网（32 位被截断）。原 `apb3_top` 只用 1 位数据且 `sig` 悬空，所以从未暴露；
现已显式声明为 32 位，并加入 `-Wimplicit` 检查作为回归项。

> 完整接线说明、软件 `fulltest` 工程说明与上板步骤见 `doc/HDMI输出集成说明.md` 第 9 节。

---

## 9. 资源修复：FIFO 改为 BRAM 可推断（解决了 PnR 资源爆掉）

**现象**：Efinity PnR 报 `Not enough physical locations: capacity=60800 usage=264403`（超 4.3 倍）。

**根因（已用用户自己的综合网表证实）**：三个 FIFO 用的是**异步读**（`assign dout = mem[rptr];`）。
Titanium 的块 RAM 不支持异步读 → 只能拆成寄存器阵列：

| 存储器 | 规模 | 寄存器位数 |
| --- | --- | --- |
| `cmd_fifo` | 2048×32 | 65,536 |
| `src_fifo` / `bg_fifo` | 256×128 ×2 | 65,536 |
| `wd_fifo` | 16×176 | 2,816 |

证据：`outflow/ddr_demo_ti60.dbg.map.v` 里**没有任何 BRAM 原语**，`u_src_fifo` 相关行数 36 万、
`u_cmd` 69 万；同时网表里有 **8 个 `EFX_DSP48`**（乘法其实已经自动进 DSP，不是资源问题的主因）。

**修复**：`sync_fifo.v` / `cmd_fifo.v` 改为**同步读 + 输出寄存器**（BRAM 可推断），并明确协议：

- `empty` 是"数据可用"的**权威标志**（同步读有 1 拍流水，`count != 0` 不代表 `dout` 有效）；
- 弹字用 `rd_ack` 确认；连续弹字约 **1 字/2 拍**（对"每 8 像素弹一词"的像素通路远远够用）；
- 新增写穿透旁路（空→非空时同拍写读同地址不会读到旧值）；
- 占用 = `mem 未取 + 在飞 + 输出寄存器`，`full`/`count` 按此计算。

**连带修改**：`stream_reader`/`pixel_path`/`blt_engine_fsm` 改用 `empty`；FSM 的 `cmd_pop` 改成
**组合**（否则 pop 晚一拍生效、同一个字被锁存两次）；行尾 drain 只在"确实有字"时计数。

**代价（实测，tb_blt_top）**：FILL/COPY/KEY 每条指令 +8 拍（指令 FIFO 8 字 ≈ 16 拍 vs 原来 8 拍）；
T7 1142 vs 1068（+7%）、T8 1292 vs 1220（+6%）—— 相对"根本放不下"完全值得。

**待办**：`tb_regs_axi_lite` 的 STEP7（fork 反压用例）与 `FIFO_EMPTY` 时序断言需按新握手适配；
FIFO 满/反压本身已由 `tb_cmd_fifo` 步骤 5（写满 2048 → full）覆盖并通过。
→ **已适配完成**，见第 10.3 节（`tb_regs_axi_lite` 现 ALL PASS）。

**结果（已上板证实）**：改完后 PnR 资源通过，`fulltest` 跑通，HDMI 上可见 BitBlt 引擎绘制的
深蓝背景 + 向右移动方块（= CPU→APB→引擎→DDR 帧缓冲→扫描输出 整条链路打通）。
关键推断规则（踩过一次坑，务必记住）：**要给 BRAM 推断机会，读数据寄存器必须是
`always @(posedge clk) rdata <= mem[addr];` 这种最干净形式——不能带异步复位，读数据路径上不要加 mux**，
否则工具直接放弃推断、把整块存储拆成寄存器阵列（实测 2048×32 的 FIFO 就吃掉 65,536 个 FF）。

---

## 10. 上板自测簇 2 / 簇 3 修复（非对齐 lane + 指令 FIFO 满边界丢字）

### 10.0 结论速览

| 簇 | 现象（上板） | 根因（一句话） | 改动文件 |
| --- | --- | --- | --- |
| 2 | A2 PASS；C4 mis=32、B2 mis=184、A4 mis=64 | `blt_addr_gen.px_skip` 只取了地址的 2 位（`row_s[2:1]`），凡是行首字节偏移 ≥ 8 字节（lane ≥ 4）都被算成 `lane-4`，整行水平错位 4 像素 | `rtl/blt_addr_gen.v`（+`rtl/pixel_path.v` 见 10.1.4） |
| 3 | 300 条 1×1 FILL 只有约 60 条生效、mis=240，PERF=24 无 ERR | 指令入队被**寄存化**（握手后第 2 拍才发 `fifo_wr_en`），反压用的却是握手那拍的 `fifo_full`；FIFO 恰好在"握手→入队"的空窗里被前一个字填满时，这个字被 `do_wr = wr_en && !full` **静默丢弃**，而 B 照样回 OKAY | `rtl/blt_regs_axi_lite.v` |

回归：`tb_blt_top` / `tb_blt_apb` / `tb_cmd_fifo` / `tb_regs_axi_lite` / 新增
`tb_blt_unalign` / `tb_fifo_full` / `tb_blt_burst` **全部 ALL PASS**。

---

### 10.1 簇 2：非对齐 dst/src 特定 lane 出错

#### 10.1.1 现象（上板 fulltest）

- A2 FILL 32×16 @dst x=3（字节偏移 6，lane 3）→ **PASS**
- C4 KEY 16×8 @dst x=7（字节偏移 14，lane 7）→ FAIL mis=32（键色位保留 64/64，非键色只写入 48/64）
- B2 COPY 20×8 src 行内 x=3 + dst x=13（字节偏移 26，lane 5）→ FAIL mis=184，整行错位 4 像素
  （`(13,60) got=0x3004 exp=0x3000`，即 `got(x)=exp(x+4)`）
- A4 FILL 1×64 竖条 @x=500（字节偏移 1000，lane 4）→ FAIL mis=64（整整 64 个像素全错）
  同组的 200×1 横条 @x=10（字节偏移 20，lane 2）PASS

共同点一眼可见：**只有 lane ≥ 4 的行首出错，lane ≤ 3 的全部正常**。

#### 10.1.2 定位过程

先写 `rtl/tb/tb_blt_unalign.v`（12 个用例、整幅 FB 影子镜像逐像素比对）复现，
原始 RTL 的失败形态与上板**逐条吻合**：

```
PASS: U1 FILL 32x16 @x=3 (lane 3)          <- 上板 A2 PASS
FAIL: U2 FILL 32x8 @x=7 (lane 7)  mis=64
      MISMATCH x=3 y=20 got=07e0 exp=dead   <- 本该写在 x=7..38，实际写到 x=3..34
      MISMATCH x=35 y=20 got=dead exp=07e0
PASS: U5 FILL 200x1 @x=2 lane2 (row)        <- 上板 A4b PASS
FAIL: U4 FILL 1x64 @x=4 lane4 (column) mis=256
```

U2 的形态是**整行向左错 4 个像素**（4 像素 = 8 字节 = 4 个 lane），
而 4 = 7 − 3 = 5 − 1 = 4 − 0 —— 正好是"lane 被减 4"。

于是回看 `blt_addr_gen.v`：

```verilog
assign px_skip = row_s[2:1];   // 只有 2 bit！值域 0..3
```

`px_skip`（= 行首在 16B 词内的像素序号 = `byte_off/2`）应该是 **3 bit、值域 0..7**，
正确写法是 `row_s[3:1]`。写成 `row_s[2:1]` 后赋值给 3 bit 线网会被零扩展，
等价于 `lane & 3` —— 只有 lane ≥ 4 的行首被截断成 `lane-4`。

对 C4（lane 7→3）可以手算预测：整行内容落在 `x-4`，于是
`x=8/10/12/14/16/18` 这 6 个非键色像素碰巧落对（6×8 行 = **48/64**），
`x=4/6` 写到矩形外、`x=20/22` 该写没写（4×8 行 = **mis=32**），键色位不写所以 64/64 保留
—— 与上板日志 `保留 64/64、写入 48/64、mis=32` **完全一致**，根因确认。

#### 10.1.3 修复 1：`blt_addr_gen.px_skip` 取满 3 位

```verilog
assign px_skip = row_s[3:1];   // byte_off/2，0..7
```

#### 10.1.4 修复 2：`pixel_path` 的写词序号 `jw` 必须每个词边界都进位（修复 1 暴露出来的第二个 bug）

只改 `px_skip` 后再跑，U1–U5/U8–U12 全 PASS，但 **U6/U7 出现新形态失败**：

```
FAIL: U6 KEY 16x8 @x=7 lane7 (1-lane)
      MISMATCH x=0 y=110 got=5001 exp=dead   <- 本该写在 x=8，实际写到 x=0
      MISMATCH x=8 y=110 got=5009 exp=5001
```

即整行**错位 8 像素（正好一个 16B 词）**。原因在 `pixel_path.v`：

```verilog
if (flush_ok) begin
    if (!aempty) begin
        wd_wr   <= 1'b1;
        wd_word <= {amask, wd_addr_c, acc};
        jw      <= jw + 16'd1;      // <== 放在 if 里面
    end
```

`jw` 是"本行第几个 16B 词"（写地址 = `d_base + jw*16`）。KEY 留孔时，
**整个词都是键色**（例如 lane7 行首那 1 个像素就是键色、或首词 8 个像素全键色）
时 `amask==0` → 该词不写，但 `jw` 也没进位 → 后面所有词都提前一个词（水平错位 8 像素）。
修复 1 之前 C4 的首词里混着非键色像素（lane 3/4/5），所以这个 bug 被掩盖了。

修法：把 `jw` 进位移到 `if (!aempty)` **外面**——词地址只与"跨过几个词边界"有关，
与"这个词有没有字节要写"无关：

```verilog
if (flush_ok) begin
    if (!aempty) begin
        wd_wr   <= 1'b1;
        wd_word <= {amask, wd_addr_c, acc};
    end
    jw      <= jw + 16'd1;          // 每个词边界都进位
    aempty  <= 1'b1;
    ...
```

#### 10.1.5 测试证据

改动顺序与结果（`tb_blt_unalign`，整幅 FB 逐像素比对）：

| RTL 状态 | U1..U5 | U6/U7(KEY) | U8..U12 | 结论 |
| --- | --- | --- | --- | --- |
| 原始 | U2/U3/U4 FAIL | FAIL | 全 FAIL | 复现上板簇 2 |
| 只修 `px_skip` | 全 PASS | FAIL（错位 8 像素） | 全 PASS | 暴露 `jw` bug |
| 修 `px_skip` + `jw` | 全 PASS | 全 PASS | 全 PASS | **ALL PASS** |

```
PASS: U1 FILL 32x16 @x=3 (lane 3)
PASS: U2 FILL 32x8 @x=7 (lane 7)
PASS: U3 FILL 32x8 @x=5 (lane 5)
PASS: U4 FILL 1x64 @x=4 lane4 (column)
PASS: U5 FILL 200x1 @x=2 lane2 (row)
PASS: U6 KEY 16x8 @x=7 lane7 (1-lane)
PASS: U7 KEY 16x8 @x=0 all-key word
PASS: U8 COPY 20x8 src x3 -> dst x13
PASS: U9 COPY 13x9 unaligned W%8!=0
PASS: U10 FILL 1x1 pixel (lane 7)
PASS: U11 COPY 8x1 aligned/unaligned
PASS: U12 KEY 32x4 @x=5 (lane 5)
========== tb_blt_unalign ALL PASS ==========
```

顺带确认"没被怀疑的方向"是干净的：`stream_reader` 的首词 skip、行尾 drain 公式
`dr = cover_beats − (px_skip+W)/8`、`W%8!=0`（U9/U11）、退化成 1 像素（U4/U5/U10）
在修复后都逐像素正确，不需要再动。

---

### 10.2 簇 3：指令 FIFO 写满时丢指令

#### 10.2.1 现象（上板 fulltest 5b/5c）

连续下发 300 条 1×1 FILL（8 字/条 = 2400 字 > cmd FIFO 2048 字），
回读只有约 60 条生效、**mis=240**；两条下发路径（裸写靠 APB 反压 / 带 `CMD_FIFO_COUNT` 等待）都失败；
引擎侧 `PERF=24`、**没有 ERR**。

#### 10.2.2 定位过程（先推翻再确认）

初始假设写在任务描述里：入队比握手晚、反压用的又是握手那拍的 `full`。先按"时序窗口"推导：

```
握手那拍 T     : awvalid&awready&wvalid&wready 成立，此刻 full(T)=0（否则 awready 会低）
T+1            : apply=1  → 寄存器块里 `fifo_wr_en <= 1'b1`（下一拍才有效）
T+2            : fifo_wr_en=1 → FIFO 求值 do_wr = wr_en && !full(T+2)
B 响应         : 握手后第 1 拍就给出（wst==W_RESP），早于入队
```

也就是说：**B（CPU 认为写成功）比真正入队早，反压判据（握手那拍的 full）与入队判据
（入队那拍的 full）不是同一拍**。若 T+2 时 full 已经变 1（前一个字刚好在这一拍落地把
FIFO 填满），`do_wr` 为 0 → **静默丢字**。要碰上这个窗口，需要两次握手间隔 ≤ 2 拍
（`W_RESP` 只挡 1 拍）。

为把窗口**确定性**地摆出来，写 `rtl/tb/tb_fifo_full.v`：`blt_regs_axi_lite` + `cmd_fifo`
（`CMD_DEPTH=2` → 16 字，小深度让"满"很快出现），AXI-Lite 主机**常驻 AW/W 有效、bready 常高**
= slave 允许的最快节奏（每 2 拍一次握手），握手全部在 **posedge** 采样。
原始 RTL 实测：

```
accepted-handshakes=17  word_count=16  maxocc=16  full=1 awready=0 wready=0
FAIL: P1 accepted == enqueued words
```

**受理了 17 个字，FIFO 只收到 16 个** —— 第 17 个字（CPU 已收到 B=OKAY）被丢掉了，
且 `awready` 之后一直为低（反压本身是对的，只差这一拍）。假设确认。

顺带解释上板"mis=240 却无 ERR"：丢 1 个字会让后面**所有 8 字指令帧整体错位 1 个字**，
错位后 `{H,W}` 字段取到的是 alpha（`0x000000FF`）→ `H=0` → 引擎按"空矩形跳过"静默跳过，
所以不会 ERR、PERF 还是正常的 24；FIFO 第一次冲满大约发生在引擎已消费 40~60 条之后，
于是"约 60 条生效、240 条丢失"。丢字点在哪条指令上取决于 DDR 写延迟，但形态与上板吻合。

#### 10.2.3 修复：入队与握手同拍（组合 `fifo_wr_en`）

`blt_regs_axi_lite.v` 不再寄存入队，改成组合通道：

```verilog
wire wr_hs = ((wst == W_IDLE) && s_axil_awvalid && s_axil_awready &&
                                 s_axil_wvalid  && s_axil_wready ) ||
             ((wst == W_AWON) && s_axil_wvalid  && s_axil_wready ) ||
             ((wst == W_WON ) && s_axil_awvalid && s_axil_awready);
wire [ADDR_W-1:0] wr_hs_addr = (wst == W_AWON) ? wa : s_axil_awaddr;
wire [31:0]       wr_hs_data = (wst == W_WON ) ? wd : s_axil_wdata;

assign fifo_wr_en   = wr_hs && (wr_hs_addr[8:2] == 7'h02);
assign fifo_wr_data = wr_hs_data;
```

（`apply` 仍保留，只服务 CTRL / IRQ_EN / W1C 这些真正的寄存器。）

**为什么这样就"结构上成立"**：三种状态下 ready 都把"目标是 0x08 且 `fifo_full`"挡在外面，
所以
`握手成立 ⟹ 本拍 full=0`，而 FIFO 内部 `do_wr = wr_en && !full` 用的是**同一个信号、同一拍**，
不存在"判据拍 ≠ 落字拍"的窗口 —— 与 master 快慢、AW/W 到达顺序都无关。

**为什么在 AXI-Lite 语义下安全**：

1. 写数据在握手那拍必须保持稳定（AXI 对 VALID/载荷的稳定性要求），组合 `din` 不会取到中途值；
2. B 仍在 `W_RESP`（握手后 1 拍）才拉高，**晚于**入队 —— "收到 B" ⟹ 数据已在 FIFO 里，
   语义比原来更强（原来 B 与入队同拍甚至更早）；
3. 满时行为不变：`awready` 拉低、APB 桥自然插等待周期、CPU 的 store 停顿（APB 反压）；
   W 在 `W_IDLE` 仍可被先锁存（`wst=W_WON`），等 AW 被受理后一起入队 —— 一个字都不会丢；
4. 没有引入新的组合环：`full/empty/count` 都只来自 FIFO 内部寄存器。

另外顺手把入队延迟从"握手 + 2 拍"缩到"握手当拍"，指令下发吞吐略好。

#### 10.2.4 测试证据

1) 单元台 `tb_fifo_full`（同一份 RTL 代码路径，2 拍握手节奏）：

| | 受理握手 | FIFO 实收 | 判定 |
| --- | --- | --- | --- |
| 修复前 | **17** | 16 | FAIL（丢 1 字） |
| 修复后 | 16 | 16 | **ALL PASS** |

修复后完整输出（P4a/P4b 还覆盖了"满边界上 AW 先到 / W 先到"两种顺序都不丢字、弹出顺序不乱）：

```
accepted-handshakes=16  word_count=16  maxocc=16  full=1 awready=0 wready=0
PASS: P1 accepted == enqueued words
PASS: P1b FIFO really reached full
PASS: P3 full => AW not accepted
PASS: P2 FIFO holds first N words
PASS: P5 pop order matches push order
PASS: P5b empty & count=0 after drain
PASS: P4a AW accepted after free
PASS: P4a AW-first order kept
PASS: P4b W-first order kept
========== tb_fifo_full ALL PASS ==========
```

> 说明（不夸大）：走 `blt_apb_top` 的 APB 桥时，两次 AXI-Lite 写握手之间至少隔 3 拍
> （`S_WAW→S_WB→S_WDONE→S_IDLE`），正好躲开 2 拍窗口，所以 **300 条突发那条链路在修复前也能过**。
> 能稳定复现丢字的是 `tb_fifo_full` 里"每 2 拍一次握手"的直连 AXI-Lite 主机
> （同一份 `blt_regs_axi_lite` 代码路径，只是 master 更快）；上板 CPU 的 store 流水
> 恰好能踩到该窗口，故上板暴露、仿真桥路径不暴露。

2) 全链路台 `tb_blt_burst`（`blt_apb_top` + 行为 DDR + 逐像素回读，
行为 DDR 写响应 `B_LAT=128` 模拟真实写回延迟）：

- **R1 裸写**：GO=0 先把 256 条（2048 字）灌到 FIFO 满 → 再 GO=1 边跑边灌完剩下 44 条
- **R2 带 COUNT 等待**：每条指令前轮询 `CMD_FIFO_COUNT < 200`

```
phase1 (GO=0) after fill-up: enq=2048 maxocc=2048 full_seen=1
PASS: R1 phase1: FIFO filled to 2048
  R1: APB writes=2400  B-resp(0x08)=2400  fifo_enq=2400  maxocc=2048  full_seen=1
PASS: R1 APB writes issued == 2400
PASS: R1 B resp == enq == 2400
PASS: R1 300x 1x1 FILL all effective
  R2: APB writes=2400  B-resp(0x08)=2400  fifo_enq=2400  maxocc=1373  full_seen=0
PASS: R2 APB writes issued == 2400
PASS: R2 B resp == enq == 2400
PASS: R2 COUNT wait: FIFO never full
PASS: R2 300x 1x1 FILL all effective
========== tb_blt_burst ALL PASS ==========
```

`2400 字 > 2048` 这件事有实测支撑：`maxocc=2048 && full_seen=1`（R1 阶段1 真的把 FIFO 顶满，
CPU 在那一段被 APB 反压挡住）；`B 响应数 == fifo_wr_en 脉冲数 == 2400`
说明"受理即入队"，一个字都没被静默吞掉；300 个像素各写一个唯一颜色、逐像素回读全对。

---

### 10.3 新增/修改的测试台与回归命令

| 文件 | 内容 |
| --- | --- |
| `rtl/tb/tb_blt_unalign.v`（新增） | U1–U12：dst lane 3/4/5/7、src+dst 双非对齐、`W%8!=0`、1×1 / 1×64 / 200×1 退化尺寸、KEY 整词留孔；整幅 FB 影子镜像逐像素断言 |
| `rtl/tb/tb_fifo_full.v`（新增） | 满边界"绝不丢字"结构性单测：受理数 vs 实收数、峰值占用、AW-first/W-first、弹出顺序 |
| `rtl/tb/tb_blt_burst.v`（新增） | 经 APB 连发 300 条 1×1 FILL（2400 字 > 2048），裸写与 COUNT 等待两条路径 + 逐像素回读 |
| `rtl/tb/tb_regs_axi_lite.v`（修） | STEP4 弹字与 STEP7 fork 反压改为按 `empty`/`rd_ack` 协议（原断言按异步读 FIFO 写，新协议下必然失败），看门狗 200us→2ms |

回归命令（与交付一致，三条全 ALL PASS）：

```powershell
$env:PATH = "C:\oss-cad-suite\bin;C:\oss-cad-suite\lib;$env:PATH"
$acc = "rtl/sync_fifo.v rtl/cmd_fifo.v rtl/blt_regs_axi_lite.v rtl/blt_addr_gen.v rtl/axi_rd_master.v rtl/axi_wr_master.v rtl/stream_reader.v rtl/pixel_path.v rtl/blt_engine_fsm.v rtl/blt_top.v".Split(' ')
iverilog -g2001 -s tb_blt_top  -o a.vvp @acc rtl/tb/axi_slave_mem.v rtl/tb/tb_blt_top.v;    vvp a.vvp | Select-String "ALL PASS|FAILED"
iverilog -g2001 -s tb_blt_apb  -o b.vvp ARC_2DRA/rtl/blt/blt_apb_top.v @acc rtl/tb/axi_slave_mem.v rtl/tb/tb_blt_apb.v; vvp b.vvp | Select-String "ALL PASS|FAILED"
iverilog -g2001 -s tb_cmd_fifo -o c.vvp rtl/cmd_fifo.v rtl/tb/tb_cmd_fifo.v;               vvp c.vvp | Select-String "ALL PASS|FAILED"
# 新增：
iverilog -g2001 -s tb_blt_unalign -o u.vvp @acc rtl/tb/axi_slave_mem.v rtl/tb/tb_blt_unalign.v; vvp u.vvp | Select-String "ALL PASS|FAILED"
iverilog -g2001 -s tb_fifo_full   -o f.vvp rtl/blt_regs_axi_lite.v rtl/cmd_fifo.v rtl/tb/tb_fifo_full.v; vvp f.vvp | Select-String "ALL PASS|FAILED"
iverilog -g2001 -s tb_blt_burst   -o s.vvp ARC_2DRA/rtl/blt/blt_apb_top.v @acc rtl/tb/axi_slave_mem.v rtl/tb/tb_blt_burst.v; vvp s.vvp | Select-String "ALL PASS|FAILED"
iverilog -g2001 -s tb_regs_axi_lite -o r.vvp rtl/blt_regs_axi_lite.v rtl/cmd_fifo.v rtl/tb/tb_regs_axi_lite.v; vvp r.vvp | Select-String "ALL PASS|FAILED"
```

**未改动**：`ralph`/`fulltest.c`、`ARC_2DRA/rtl/ddr3_example_top.v` 接线、`software/`；
`pixel_path.v` 的 ALPHA 绿分量展开（`{fg_px[10:5],fg_px[7:6]}`，簇 1 的修复）保持原样未回退。

---

## 11. 上板自测簇 4：ALPHA 定点混合的位复制抽头取错（数值错 + 非对齐 dst 专项排查）

### 11.0 结论速览

| 项 | 结论 |
| --- | --- |
| 现象 | ALPHA 全错（D1/D2/D4 FAIL），白/黑金标准 D3（α=128 白叠黑=0x7BEF）却是 PASS；D4 各 α 都比期望**小 1~3 个 LSB**（越往中间越明显），单调性趋势正确 |
| 根因（一句话） | `pixel_path.v` 三通道 8bit 展开的**位复制抽头取的是字段低位**（`px[13:11]`/`px[7:6]`/`px[2:0]`）而不是字段高位（`px[15:13]`/`px[10:9]`/`px[4:2]`），展开值最多小 7 个 LSB，经 `(fg*α+bg*(255−α)+127)>>8` 再量化回 5/6/5 后表现为输出字段小 1~3 个 LSB，且 **α=0/255 时连纯背景/纯前景都回不到原值** |
| 为什么长期潜伏 | 白（字段全 1）与黑（字段全 0）下"取低位"与"取高位"**完全等价** → D3/T5/T6 天生是盲的；tb_blt_top 原有 ALPHA 用例恰好只有白/黑 |
| 改动文件 | `rtl/pixel_path.v`（6 行展开表达式）、`rtl/tb/tb_alpha.v`（新增专项 TB）、`rtl/tb/tb_blt_top.v`（新增 T9 非盲 ALPHA 用例）、`rtl/tb/axi_slave_mem.v`（修 TB 从机模型丢计数，见 11.6）、`rtl/tb/run_regress.ps1`（新增回归脚本）、本文件 |
| 非对齐 dst 卡死专项 | **DUT 不卡**：新增 lane 0..7 × 单行/多行 × 行距 16B 对齐与非对齐 × `W` 压/越词边界 共 45 个 ALPHA 用例全部跑完且逐像素正确；ALPHA 的 `bg` 覆盖读/`px_skip` 对齐/行尾 drain 均验证干净。**上板 BUSY 不落的关键嫌疑不在这里**（详见 11.6 末段） |

### 11.1 现象与复现（`rtl/tb/tb_alpha.v`）

tb_alpha 直接复刻上板 D1/D2/D3/D4 的指令（`blt_top` + 行为 AXI 从机 + 逐像素金标准比对），
金标准模型 = 标准 RGB565→RGB888 位复制 + `(fg*α+bg*(255−α)+127)>>8` + `{r8[7:3],g8[7:2],b8[7:3]}`。

修复前（原始 RTL）：

```
FAIL: D1 α=0   fg=FFFF bg=C618 16x8 == C618     mism=128  实测整块 0xBDF7
FAIL: D2 α=255 fg=FD20 bg=0010 16x8 == FD20     mism=128  实测整块 0xFD00
PASS: D3 α=128 fg=FFFF bg=0000 16x8 == 7BEF              实测 0x7BEF  ← 盲区
FAIL: D4 1x1 fg=FD20 bg=0010  α=0/32/64/96/128/160/192/224/255  全部 mism=1
========== tb_alpha FAILED: 53 ==========    (62 PASS / 53 FAIL)
```

### 11.2 定位：逐级对比，把嫌疑一个个排除

tb_alpha 的 `[trace]` 逐拍打印 pixel_path 内部每一级（`+dbg` 打开，α=0 那一发）：

```
修复前：a=000 fg_px=fd20 bg_px=0010 | ar=ff ag=a4 ab=00 br=00 bg2=00 bb2=80 | m_r=0007f m_g=0007f m_b=07fff | r8=00 g8=00 b8=7f | out=000f
修复后：a=000 fg_px=fd20 bg_px=0010 | ar=ff ag=a6 ab=00 br=00 bg2=00 bb2=84 | m_r=0007f m_g=0007f m_b=083fb | r8=00 g8=00 b8=83 | out=0010
```

一次就能读出三件事：

1. **`fg_px`/`bg_px` 都是对的**（`fd20` / `0010`）→ ALPHA 的目的侧"从对齐基址读 `cover_beats` 个
   16B 词、按 `px_skip` 取像素"这条链（`blt_addr_gen` 的 `aligned_base/px_skip/cover_beats` +
   `stream_reader` 的 skip + `bg_take/bg_rdy`）**是干净的**，不是"bg 读回/对齐"问题；
2. **`m_*`/`r8/g8/b8` 与公式逐位吻合**（`m_b=132*223+127=0x7FFF` → `b8=0x7F`）→ 阶乘加与 `+127>>8`
   舍入**也没问题**；
3. 唯一的差异来源就是**展开值本身**：`ag` 应为 `0xA6` 却算成 `0xA4`、`bb2` 应为 `0x84` 却算成 `0x80`
   —— 全部因为位复制抽头取了字段低位。

**指纹比对**：把修复前的三条展开表达式逐字照抄成第二个模型 `model_blend_old()`，仿真结果与它
**逐位相同**（D1 `0xBDF7`、D2 `0xFD00`、D4 `0x20AD/414B/61E9/9B25/BBC3/DC61`）→ 排除 FIFO/对齐/舍入，
坐实"只差展开表达式"。

**与上板数据交叉验证**（R = `>>11`，G = `>>5&0x3F`，B = `&0x1F`）：

| 用例 | 上板实测 (R,G,B) | 修复前仿真 (R,G,B) | R/B 是否一致 |
| --- | --- | --- | --- |
| D1 α=0 bg=C618 | `0xB817` = (23, **0**, 23) | `0xBDF7` = (23, 47, 23) | ✅ 一致 / 仅绿不同 |
| D2 α=255 fg=FD20 | `0xFCC0` = (31, **38**, 0) | `0xFD00` = (31, 40, 0) | ✅ 一致 / 仅绿不同 |
| D4 α=32 | `0x208D` = (4, 4, 13) | `0x20AD` = (4, 5, 13) | ✅ |
| D4 α=64 | `0x412B` = (8, 9, 11) | `0x414B` = (8, 10, 11) | ✅ |
| D4 α=96 | `0x61C9` = (12, 14, 9) | `0x61E9` = (12, 15, 9) | ✅ |
| D4 α=160 | `0x9B05` = (19, 24, 5) | `0x9B25` = (19, 25, 5) | ✅ |
| D4 α=192 | `0xBB83` = (23, 28, 3) | `0xBBC3` = (23, 30, 3) | ✅ |
| D4 α=224 | `0xDC21` = (27, 33, 1) | `0xDC61` = (27, 35, 1) | ✅ |

**8 个上板用例的 R、B 两个通道与"修复前"仿真逐位一致**（R/B 这两处从来没被人改过），只有绿通道
比修复前仿真还低 1~3 个 LSB —— 说明**板上那份镜像的绿展开比仓库里"簇 1 修好"的版本还要旧**
（簇 1 只改了绿，R/B 一直是"取低位"）。即：仓库里绿字段抽头已经对了、复制抽头还错；板子上连字段
抽头都还是旧的。这解释了"上板 ALPHA 全错、但仓库里只有绿差 1 个 LSB"的落差。

### 11.3 根因

标准 RGB565→RGB888 的位复制是**把字段的高位复制到低位**：
`R8={r[4:0],r[4:2]}`、`G8={g[5:0],g[5:4]}`、`B8={b[4:0],b[4:2]}`。
原三处写成了取字段**低位**：

| 通道 | 原（错） | 正确 | 字段高位对应像素位 |
| --- | --- | --- | --- |
| R | `{px[15:11], px[13:11]}` | `{px[15:11], px[15:13]}` | `r[4:2]` = 位 15,14,13 |
| G | `{px[10:5],  px[7:6]}`  | `{px[10:5],  px[10:9]}`  | `g[5:4]` = 位 10,9 |
| B | `{px[4:0], px[2:0]}`  | `{px[4:0], px[4:2]}` | `b[4:2]` = 位 4,3,2 |

以 `bg=0xC618`（R5=0x18,G6=0x30,B5=0x18）为例：正确展开 (R,G,B)=(0xC6,0xC3,0xC6)，
错误展开得到 (0xC0,0xC0,0xC0)；α=0 时 `out = (bg8*255+127)>>8`，正确时回到原值
`(0xC6→0x18 …)`，错误时 `0xC0→0xBF→R5=0x17`（**正好就是上板 D1 的 R5=0x17、B5=0x17**）。

### 11.4 修复（`rtl/pixel_path.v`，公式与其余逻辑一律不动）

```verilog
wire [7:0] ar = {fg_px[15:11], fg_px[15:13]};
wire [7:0] ag = {fg_px[10:5],  fg_px[10:9]};
wire [7:0] ab = {fg_px[4:0],   fg_px[4:2]};
wire [7:0] br = {bg_px[15:11], bg_px[15:13]};
wire [7:0] bg2= {bg_px[10:5],  bg_px[10:9]};
wire [7:0] bb2= {bg_px[4:0],   bg_px[4:2]};
```

- **绿通道的字段抽头 `px[10:5]` 原样保留**（簇 1 的修复没有回退），改的只是它后面那个复制抽头；
- `a_inv`、`m_*`、`+127`、`>>8`、`{r8[7:3],g8[7:2],b8[7:3]}`、FIFO 读寄存器形式**全部未动**。

### 11.5 测试证据（A/B：修复前 vs 修复后）

`fg=0xFD20 / bg=0x0010`（1x1，逐像素比对金标准；上板列来自 fulltest D 组）：

| α | 金标准（=上板期望） | 修复前仿真 | 修复后仿真 | 上板实测 |
| --- | --- | --- | --- | --- |
| 0 | `0x0010` | `0x000F` | **`0x0010`** | — |
| 32 | `0x20AE` | `0x20AD` | **`0x20AE`** | `0x208D` |
| 64 | `0x414C` | `0x414B` | **`0x414C`** | `0x412B` |
| 96 | `0x61EA` | `0x61E9` | **`0x61EA`** | `0x61C9` |
| 160 | `0x9B46` | `0x9B25` | **`0x9B46`** | `0x9B05` |
| 192 | `0xBBE4` | `0xBBC3` | **`0xBBE4`** | `0xBB83` |
| 224 | `0xDC82` | `0xDC61` | **`0xDC82`** | `0xDC21` |
| 255 | `0xFD20` | `0xFD00` | **`0xFD20`** | — |

`fg=0xFFFF / bg=0xC618`（16x8）：α=0 → `0xBDF7` → **`0xC618`**（期望纯背景）；
α=255 → **`0xFFFF`**。D3（α=128 白叠黑）修复前后都是 `0x7BEF`。

**整批对照**：

| RTL | tb_blt_top | tb_alpha |
| --- | --- | --- |
| 修复前 | **FAILED: 9**（全部是新增 T9 的 9 条断言） | **FAILED: 53**（PASS 62） |
| 修复后 | **ALL PASS**（43 条断言） | **ALL PASS**（62 条断言） |

**穷举 α 扫描**（`vvp … +sweep`）：6 组 fg/bg（含 FFFF/C618、FD20/0010、07E0/F800、1234/ABCD、
0000/FFFF、8410/4210）× 256 个 α = 1536 条 ALPHA 指令，**逐像素等于金标准，0 FAIL**。

### 11.6 专项：ALPHA + 非 16B 对齐 dst 会不会等不到 bg 字（卡死）

ALPHA 的目的侧要先**从对齐基址读** `cover_beats` 个 16B 词、再按 `px_skip` 丢弃行首像素，
读词数天然比"用到的词"多 0~1 个（多出来的那个由行尾 drain 丢）。tb_alpha 新增 48 个几何用例：

- dst lane 1..7（src 对齐）、src lane 1..7（dst 对齐），单行；
- 点名的 `lane=1(W=13)`、`lane=4(W=9)`、`lane=7(W=1)`；
- 多行 + **行距 34B**（非 16B 对齐 → 每行 lane 都不同，L=0..7，W=8,H=6）；
- 多行 + 行距 64B 且 dst/src 都非对齐（W=13,H=4）；
- `lane+W` 正好压在词边界、以及越 1 个像素（L=0..7，H=3）。

每个像素**取不同的值**（错位/取错像素必然暴露），并带**超时判定**（`wait_done` 超时即 FAIL，并把
`st/rstate/proc_r/issue_r/dr_*/pp_run/fifo_empty/reader loaded-lane-first_w/rd_rdy/take` 现场打印）。
结果：**全部跑完且逐像素等于金标准**（无 OVERRUN/UNDERRUN，说明掩码与行尾 drain 也没丢字/多丢字）。
修复前它们同样是"只差展开那 1 个 LSB"，**没有任何一条卡死**。

> ⚠️ **仿真里"卡死"的真凶是测试台从机模型，不是 DUT**：第一次跑 tb_alpha 时 16x8 ALPHA 在最后一行
> 卡死（`bg_empty=1` 永不落、引擎 BUSY 不退，形态与上板残影**极像**）。加 AXI 读事务追踪后看到：
> 16 笔 AR 只回了 15 个 RLAST，从机 `q_cnt=0` 时主设备 `rq_cnt` 还挂着 1 笔。
> 根因在 `rtl/tb/axi_slave_mem.v`：AR 受理 `q_cnt<=q_cnt+1` 与突发收完 `q_cnt<=q_cnt-1` 写在**同一个
> always 块的两处**，同拍发生时后者覆盖前者 → `q_cnt` 永久偏小；累计到"计数为 0 但还有一笔没回数据"
> 时从机就再也不发数据 → 主设备 `rd_busy` 永不落 → 像素通路永远等不到词 → 引擎卡在 BUSY。
> **已修**（两条计数合并成一条表达式）。真实 DDR 控制器没有这个问题，所以它只解释仿真假死，
> **不能解释上板 BUSY 不落**。

**给下一位的提示（上板 BUSY 不落的排查方向）**：ALPHA 数值链已证明干净，本 TB 也无法让 DUT
在非对齐 dst 下卡住。上板那份 `STATUS=0x1(BUSY) + CMD_FIFO_COUNT=30` 更可能来自
(a) 板级读/写通道返回异常（`rd_ready` 信用不回、`wd_busy` 不退，如仲裁器 `axi_wr_arb` 在飞计数
与 B 分路的边界）、或 (b) 上板那份旧镜像里 ALPHA 的**绿展开**还有别的错（11.2 的 R/B 逐位吻合说明
板子镜像确实早于簇 1）；建议先按 11.4 重新出比特流，再看 BUSY 是否复现。

### 11.7 回归（全部 ALL PASS）

脚本：`powershell -NoProfile -ExecutionPolicy Bypass -File rtl/tb/run_regress.ps1`（在仓库根目录跑）

| 测试台 | 结果 |
| --- | --- |
| `tb_blt_top`（含新增 T9） | ALL PASS |
| `tb_blt_apb` | ALL PASS |
| `tb_cmd_fifo` | ALL PASS |
| `tb_regs_axi_lite` | ALL PASS |
| `tb_blt_unalign` | ALL PASS |
| `tb_fifo_full` | ALL PASS |
| `tb_blt_burst` | ALL PASS |
| `tb_alpha`（新增） | ALL PASS |

### 11.8 复现命令

```powershell
$env:PATH = "C:\oss-cad-suite\bin;C:\oss-cad-suite\lib;$env:PATH"
$acc = "rtl/sync_fifo.v rtl/cmd_fifo.v rtl/blt_regs_axi_lite.v rtl/blt_addr_gen.v rtl/axi_rd_master.v rtl/axi_wr_master.v rtl/stream_reader.v rtl/pixel_path.v rtl/blt_engine_fsm.v rtl/blt_top.v"
# ALPHA 专项（+dbg 打印 AXI 读事务，+sweep 跑 6×256 穷举 α）
iverilog -g2001 -s tb_alpha -o al.vvp $acc rtl/tb/axi_slave_mem.v rtl/tb/tb_alpha.v; vvp al.vvp
# A/B：把 pixel_path.v 的三条展开换回旧抽头（px[13:11]/px[7:6]/px[2:0]）另存一份再编，即得"修复前"数据
```

**未改动**：`fulltest.c`（另一代理在改）、`ARC_2DRA/rtl/ddr3_example_top.v` 接线、`software/`；
两个 FIFO 文件的读寄存器形式（`always @(posedge clk) rdata_r <= mem[rptr];`）与 `+127>>8` 公式保持原样。

---

## 12. 上板 BUSY 卡死根因：`axi_wr_arb` 让位那一拍的 AW 握手把在飞计数打漏（B/W 错路）

### 12.0 结论速览

| 项 | 结论 |
| --- | --- |
| 根因 | **`axi_wr_arb.v` 的"防饿死强制让位"分支与 AW 握手同拍**：`wait_b>=32` 时不再要求 `!c_awvalid`，于是 DDR 从机在这一拍受理了 CPU 的 AW（该笔就此在飞），而 owner 同时切给引擎 |
| 后果 1 | 该笔的 **B 按新 owner 分路** → 引擎白吃一个 B（`cnt_b` 下溢 255）或 CPU 的 `cnt_c` 永远 ≥1 → **在飞计数泄漏、不归零** → 端口再也不让给引擎 |
| 后果 2 | 该笔的 **W 也按新 owner 分路** → 引擎的 W 数据被写到 CPU 那个 AW 的地址上（**内存写花**），CPU 的 W 永远发不出去 → DDR 卡在 `WR_W` 等 W |
| 上板现象 | 引擎 `axi_wr_master` 永远等不到 B → `wd_busy=1` 不退 → FSM 停在 `S_WDWAIT` → **STATUS=BUSY 不退、CMD_FIFO 堆积**；引擎写回不下来 → 该擦的精灵没擦掉 → **屏幕留完整精灵残影**。与 `STATUS=0x9`(BUSY+FIFO_EMPTY) 现场完全吻合 |
| 修复 | `axi_wr_arb.v` AW 通道改为**仲裁器自己受理（1 深 skid），再转发给 DDR**（见 12.3）；让位不再依赖"恰好没有握手"的窗口 |
| 新测试台 | `rtl/tb/tb_arb_deadlock.v`：真实三读两写拓扑 + 两级读仲裁 + 不友好从机（随机反压/大 B 延迟/AW-B 同拍）+ 看门狗 + 计数漂移 + 全内存对照 |
| A/B | 修复前：**58 拍即挂死**（1 次不安全让位 + W 错路 + 内存写花 + 读侧一笔没跑）；修复后：ALL PASS（31 万拍、读 1.0 万笔 / 写 8.5 千笔突发、计数全归零、内存零错） |

### 12.1 现象 → 机制：为什么"B 错路"会让 BUSY 不退

`blt_engine_fsm.v`：`busy_out = (st != ST_IDLE)`，而 `ST_WDWAIT` 的出口是 `wd_empty && !wd_busy`。
`axi_wr_master.v` 只有在收到 B 之后才回 `S_IDLE`（`wd_busy=0`）。所以：

```
B 被错路/丢失 → axi_wr_master 停在 S_B → wd_busy=1 不退
             → 引擎停在 ST_WDWAIT → BUSY=1 不退
             → CMD_FIFO 只进不出（CMD_FIFO_COUNT 越堆越多）
             → 该条指令的写回永远不做 → 精灵擦除没执行 → 屏幕不动残影
```

同理 `done_out` 也要求 `wd_empty && !wd_busy`，所以"引擎回了 IDLE 但 DONE=0"也指向 wd 通路。

### 12.2 审计：逐条风险点（真 bug / 安全）

**A. `axi_wr_arb`（真 bug，已修）**

| # | 风险点 | 结论 |
| --- | --- | --- |
| A1 | 0→1 让位条件 `cnt_c==0 && b_awvalid && (!c_awvalid \|\| wait_b>=32)`：`wait_b>=32` 这一路**不排除本拍 CPU 的 AW 握手** | **真 bug（根因）**。DDR 看的是 `m_awvalid && m_awready`，仲裁器把 CPU 的 valid 组合直通，所以这一拍 DDR 会真的收下这笔 AW；而 `cnt_c` 的 +1 用的是 `c_aw_hs`（含同一条件）→ 计数 +1，看似没问题，但 owner 同时翻成 1 → 这笔的 B/W 从此归引擎 |
| A2 | 只在 `c_awready` 上做让位屏蔽（"不受理就行了"） | **不够**（试过）。DDR 的握手是 `m_awvalid && m_awready`，`m_awvalid` 仍是 CPU 的 valid，DDR 照样收下 → 计数照样漏。必须让"DDR 的受理"由仲裁器产生 |
| A3 | 1→0 归还条件 `cnt_b==0 && (!b_awvalid \|\| b_bursts>=4)`：`b_bursts>=4` 这一路同样可能与本拍引擎 AW 握手同拍 | **同构 bug（防御性修复）**。真实 `axi_wr_master` 是 AW→W→B 串行、B 之后至少隔 1 拍才发下一笔 AW，实测踩不到；但只要引擎侧改成 AW 流水就会踩到，TB 的 A2 阶段专门覆盖它 |
| A4 | `cnt_c/cnt_b` 的 +1/−1 口径（AW 握手 +1、B −1） | 表达式本身正确（同拍 +1/−1 写在同一行，不会互相覆盖）；**但它统计的是"仲裁器以为的握手"**，一旦与 DDR 真正受理的 AW 不一致就整体失真 → 修 A1 的本质就是让两者恒等 |
| A5 | owner 在"`cnt_b==0` 但 B 还在飞"的窗口切换 | **安全**：`cnt_b` 在"转发给 DDR 的 AW 握手"那一拍才 +1、收到 B 才 −1，所以 `cnt_b==0` ⟺ 没有未回的 B 该归这一侧 |
| A6 | B 被丢/被分给错的一侧 | 修 A1 后不可能：owner 只在"老 owner 无在飞、无待转发"时切换（`cnt_*==0 && !*q_v`），该笔的 B 必然回到原 owner |
| A7 | `bready` 时序导致 B 未计入 | **安全**：`m_bready = owner ? b_bready : c_bready`，B 由 `m_bvalid && m_bready` 判定，与 master 的 ready 一一对应；引擎侧 `bready` 恒 1 |
| A8 | `wait_b` 让回 CPU 后不复位 | **真 bug（次要，已一并修）**：`wait_b` 是饱和计数器，1→0 归还时若不清零，"刚让回 CPU"下一拍 `wait_b>=32` 仍成立 → 立刻被强制抢走 → CPU 可能长期拿不到写口。现在归零后重新计时 |
| A9 | `b_bid` 没有引出（只有 `c_bid`） | 设计限制：B 归属**纯靠 owner**，引擎看不到 BID。因为同一时刻只有一个 owner 的在飞写突发（A6 保证），安全；但属于"以后不要放宽这个不变式"的约束 |
| A10 | `m_awid` = 引擎用 0、CPU 用 `c_awid` | 与 A9 同理：同一时刻单侧在飞，ID 复用不会引起乱序回程 |

**B. `axi_rd_arb`（本次只做 1 行改动，读通道优先级策略由另一代理接手，故此处仅记录事实）**

| # | 风险点 | 结论 |
| --- | --- | --- |
| B1 | 0→1 让位条件原来用 `!c_arvalid`：CPU/L1 一条**未被受理**（valid 高 ready 低）的 AR 会把高优先级侧永久挡在门外 | **真 bug（优先级反转/饿死）**。已改为 `!c_ar_hs`（只要求"本拍没有真的握手"）→ 见 12.6 的改动行说明 |
| B2 | 若改成"只看握手"，会不会反向丢一笔（本拍刚受理的 AR、owner 已易主）？ | **安全**：`c_ar_hs` 与 DDR 侧握手 `m_arvalid && m_arready` **恒等**（读侧是纯组合直通，没有 A2 那个陷阱），所以"本拍握手 → 不让位"就足够 |
| B3 | 1→0 归还用 `!s_arvalid`（S 侧挂着未受理的 AR 时钉住通道） | **有意为之**：S 侧（扫描输出/引擎）优先级最高，钉住才不会把通道交给 C 侧。`!s_arvalid` 已隐含 `!s_ar_hs`，无同拍泄漏 |
| B4 | 两级级联：L1 的 `m_*` 直连 L2 的 `c_*`，会不会"L2 认为 L1 没有在飞、L1 认为自己在等"？ | **安全**：L1 的 `m_ar_hs` 就是 L2 的 `c_ar_hs`（同一组信号），L1 的 `cnt_s` 只在真正握手时 +1；L2 的 `cnt_c` 也只在真正握手时 +1 → 两侧口径一致，不存在交叉状态 |
| B5 | `m_arid`：引擎侧硬连 `4'h1`，扫描输出侧也硬连 `4'h1`（同一 ID 被两个主机复用） | **当前安全**：L2 保证同一时刻只有一侧有在飞突发（0→1 要 `cnt_c==0`、1→0 要 `cnt_s==0`），所以 DDR 单读口不会同时看到两个主人的 ID=1 请求。**但这是靠"不变式"活着**，一旦放宽（比如允许 C 侧在飞时给 S 侧插入）必须改成不同 ID |
| B6 | `axi_rd_arb` 没有 `s_rid` 端口，BitBlt/扫描输出主机在真实顶层也看不到 rid | R 归属**完全依赖 owner**，仲裁器不校验 rid。TB 的逐拍数据校验就是对这一点的直接检验 |
| B7 | 读侧让位窗口（"让位窗口永不出现"） | **已知设计缺口**（另一代理的 `tb_scanout_bw.v` 已复现）：C 侧背靠背发 AR 时 `cnt_c==0 && !c_ar_hs` 很难成立 → S 侧（扫描输出）拿不到通道。本 TB 里 5 个主机都设了真实的突发间隔（扫描输出还有"行间隔"），所以都能推进；写侧的同类问题已由 12.3 的"停止受理 + skid"彻底解决，读侧建议照抄同一手法 |

**C. 从机模型 / 测试台侧（不是 DUT bug）**

| # | 风险点 | 结论 |
| --- | --- | --- |
| C1 | `axi_slave_mem.v` 的 `q_cnt` 同拍覆盖（11.6 已修） | 已修；本次新 TB 的从机同样把"受理 +1 / 收完 −1"写在同一条表达式里 |
| C2 | 新 TB 从机的 AW 队列用 2 bit 计数（0..3）当 4 深用 → 满标志永远为假 | TB bug（已修成 3 bit） |
| C3 | 新 TB 主机的 `last_prog` 在 `run` 拉高前保持 0 → 使能瞬间看门狗误判 | TB bug（已修：使能沿给 `last_prog` 打时间戳） |
| C4 | 新 TB 的 AW 流水写主机在 `S_B` 不判 `run`，停流量后仍一直发 | TB bug（已修：`S_B` 也判 `run`），否则排空永远等不到 |
| C5 | `axi_wr_master.v` 的 `S_BUF` 合并条件 `e_addr == burst_addr + burst_len*16` 与 `sync_fifo` 的 1 拍读空洞 | **不是死锁，是性能损失**：`sync_fifo` 弹出后下一拍 `empty` 会瞬时为 1（`out_v` 寄存器要等数据回来），`S_BUF` 见 `!wd_empty` 为假就 flush → **每笔 AW 实际只有 1 拍**，写突发合并失效（16 倍 AW/B 事务）。它不会卡死（本次 TB 的写主机就是 1..16 拍可变长度，A/B 都工作），但会放大写口竞争、让 A1 的竞争窗口出现得更频繁。若要做，建议把 `wd_count` 接进 `axi_wr_master`（`blt_top` 里 `.count()` 目前悬空），用 `count==0` 判"真空"而不是 `empty`；本次为保持"卡死修复"改动最小**未改** |
| C6 | 旧单元 TB `tb_axi_wr_arb.v` 的从机太友好（awready 恒 1、B 立刻回、`bready` 恒 1） | 已升级为对抗性：`awready` 随机反压、B 延迟 0..7 拍、master 的 `bready` 随机压低 25%。升级后**新写仲裁器仍 ALL PASS**，且两个主机**公平轮转（CPU 790 笔 / BLT 790 笔）**，两段区间逐字节一致 |
| C7 | 升级 C6 时踩到的 TB 陷阱：`wire c_bready = 1'b1;` 与 master 的 `output reg bready` **双驱动** | 原来两边都驱动 1 所以看不出问题；一旦让 master 随机驱动，net 就变成 **X**，X 顺着 `m_bready` 污染 `cnt_c/cnt_b` → 表现为"CPU 只发了 2 笔、引擎 1460 笔"的假饿死现场。这类"多驱动 net"是排查 RTL 时的经典假象：结论是**先确认激励/监视信号没有 X 再怀疑 DUT** |

### 12.3 修复：AW 受理与转发解耦（`ARC_2DRA/rtl/video/axi_wr_arb.v`）

核心一句话：**让"DDR 受理了哪笔 AW"由仲裁器决定，而不是由主机 valid 与 DDR ready 的组合决定。**

```verilog
/* AW 先入本模块自己的 1 深缓冲，ready 自控；m_awvalid 由缓冲有效位产生 */
reg [AW-1:0] cq_addr; reg [7:0] cq_len; reg [2:0] cq_size; reg [1:0] cq_burst; reg [IDW-1:0] cq_id; reg cq_v;
reg [AW-1:0] bq_addr; reg [7:0] bq_len; reg [2:0] bq_size; reg [1:0] bq_burst;            reg bq_v;

wire m_aw_hs = m_awvalid && m_awready;              // = DDR 真正收下那笔
wire c_m_hs  = m_aw_hs && (owner == 1'b0);
wire b_m_hs  = m_aw_hs && (owner == 1'b1);

assign c_awready = (!cq_v) && !hold_c;              // 受理权完全在仲裁器手里
assign b_awready = (!bq_v);
assign c_wready  = ((owner == 1'b0) && !cq_v) ? m_wready : 1'b0;   // W 不早于 AW
assign m_awvalid = owner ? bq_v : cq_v;

cnt_c <= cnt_c + (c_m_hs ? 1 : 0) - (c_b_hs ? 1 : 0);   // 口径 = DDR 侧握手
cnt_b <= cnt_b + (b_m_hs ? 1 : 0) - (b_b_hs ? 1 : 0);

wire hold_c     = (owner == 1'b0) && bq_v && (wait_b >= 8'd32);   // 引擎等够了 → 停止受理 CPU 新 AW
wire yield_to_b = (owner == 1'b0) && (cnt_c == 8'd0) && !cq_v && bq_v && (hold_c || !c_awvalid);
wire yield_to_c = (owner == 1'b1) && (cnt_b == 8'd0) && !bq_v && (!b_awvalid || (b_bursts >= 4'd4));
```

四个要点：

1. **让位 = 只是"不再受理新 AW"**（`c_awready` 拉低），不是"切换时把老 owner 的 AW 硬塞给 DDR"。
   让位那一拍 `cq_v==0` 保证老 owner 既无在飞、也无待转发 → **切换是原子的**，不存在"已受理但没计入"的在飞。
2. **防饿死不再靠"抢窗口"**：引擎等待 `wait_b>=32` 后 `hold_c` 生效，CPU 的**新** AW 被拒绝，它把手上的
   突发做完（`cnt_c→0`、`cq_v→0`）就让位给引擎。这正好解掉"让位窗口永不出现"（`!c_aw_hs` 永远为假）的死结。
3. **计数口径 = DDR 侧握手**：`cnt_*` 只认 `m_aw_hs`，与 B 的分路口径完全一致 → 计数泄漏在结构上不可能。
4. **W 不早于 AW**：主机的 W 要等本笔 AW 已经转发出去才放行，避免对 DDR 发 W-before-AW（也不给"W 数据配错 AW"留任何缝隙）。

代价：每笔 AW 多 1 拍转发延迟；W 连续数据流不受影响；W 带宽不受影响。
引擎侧同样是 1 深缓冲，但引擎的 `axi_wr_master` 本来就一笔一笔来，实际时序不变。

### 12.4 新测试台 `rtl/tb/tb_arb_deadlock.v`

真实拓扑：CPU/BitBlt → L1 → L2 ← 扫描输出 → DDR 单读口；CPU/BitBlt → 写仲裁 → DDR 单写口。
两个仲裁器都用**端口级监视**（不依赖内部实现）：

- **不安全让位计数器**：`("从机本拍受理了 AR/AW") && ("owner 本拍切换")` 同拍 → 计数，必须为 0。
  这条就是本次根因的形式化判据（修复前=1，修复后=0）。
- **不友好从机**：AR 受理随机反压、读延迟 3..10 拍随机、R 回程随机插 1..4 拍空拍、W 通道随机压
  `wready`、B 延迟 2..9 拍、**AW 队列 4 深且 W/B 期间继续收 AW**（所以能造出"AW 握手与 B 握手同拍"）。
  内存 512KB 上电全填 `pattern(addr)`；从机逐拍校验 W 数据等于"该 AW 地址的 pattern"。
- **5 个主机**：CPU 读（有间隔）、BitBlt 读（背靠背流水）、扫描输出读（带"行间隔"）、
  CPU 写（`aw_pipe=1`，有在飞写时下一笔 AW 已压上 = 板级 CPU 典型）、BitBlt 写（串行 = `axi_wr_master`）。
  各自 64KB 独立区间，突发长度 1..16 随机，逐拍校验收到的 R 数据与 `rlast` 位置。
- **阶段 A（定向，25k 拍）**：CPU 背靠背写 + 引擎同时抢写口，从机把**第一笔 W 压 40 拍** →
  必然走到"引擎等写口 >32 拍 → 强制让位"那条路径（修复前就是在这里 58 拍挂死）。
- **阶段 A2（定向，25k 拍）**：引擎侧改成 AW 流水，专门覆盖"`b_bursts>=4` 归还 CPU 与引擎 AW 握手同拍"
  （第二条强制让位路径）。
- **阶段 B（随机，260k 拍）**：5 主机同时猛发 + 全随机反压。
- **结束检查**：停流量后排空，要求 6 个在飞计数全 0、从机队列/在飞全清；再全内存 512KB 逐字节对照。
- **看门狗**：任一主机 30000 拍无进展、或从机发现"W 数据错路"/"AW 已收但 W 永不来"→ FAIL + dump
  （各仲裁器 owner/计数/`wait_b`/`b_bursts`、从机 `wst`/队列、各主机 FSM）。

### 12.5 实测数字（A/B 同一 TB、同一读仲裁器）

| 指标 | A：修复前 `axi_wr_arb` | B：修复后 |
| --- | --- | --- |
| 结果 | **FAILED（5 类）** | **ALL PASS** |
| 挂死时刻 | **cycle 58**（阶段 A 刚开始） | 无 |
| 不安全让位（写） | **1** | **0** |
| 现场 | `wr owner=1 cnt_c=1 cnt_b=1`、从机 `wst=WR_W` + AW 队列非空 | `/` |
| W 数据错路 | 有（0x408a0/b0/c0/d0 四个 beat） | 0 |
| 内存 pattern 对照 | **112 字节不符**（引擎数据写到 CPU 地址） | 0 字节不符（512KB 全对） |
| 读突发 CPU/BLT/SCAN | 0 / 0 / 0（还没跑到阶段 B 就死了） | 1801 / 4818 / 3648（beat 15520 / 41401 / 31638） |
| 写突发 CPU/BLT | 2 / 1 | 4573 / 3952（beat 38407 / 33699） |
| 从机反压覆盖 | R 空拍 0、wready 压低 80 拍 | R 空拍 16692、wready 压低 152145 拍 |
| 突发长度覆盖 | 1..16 | 1..16（mask=ffff） |
| 总周期 / 排空 | 1225 拍后 fatal | 310134 拍，排空 127 拍 |

旧单元测试台 `rtl/tb/tb_axi_wr_arb.v`（从机很友好）在新写仲裁器下同样 **ALL PASS**（CPU 1251 笔 / BLT 1250 笔，
两段区间逐字节一致）—— 说明修复没有破坏原有的正常路径。
该 TB 已升级为对抗性（`awready` 随机反压 + B 延迟 0..7 拍 + `bready` 随机压低 25%）后**仍然 ALL PASS**，
两个主机**公平轮转 790 : 790**，数据逐字节一致 —— 直接证明新仲裁器在"两侧都背靠背猛发 + 强反压"下
**不会饿死任何一侧**（这正回应了"写侧 `cnt_b==0 && !c_aw_hs` 窗口永不出现"的担心：现在让位不靠抢窗口，
所以窗口不存在也能让位）。

### 12.6 回归（9 个全部 ALL PASS）

`powershell -NoProfile -ExecutionPolicy Bypass -File rtl/tb/run_regress.ps1`（仓库根目录）

| 测试台 | 结果 |
| --- | --- |
| `tb_blt_top` | ALL PASS |
| `tb_blt_apb` | ALL PASS |
| `tb_cmd_fifo` | ALL PASS |
| `tb_regs_axi_lite` | ALL PASS |
| `tb_blt_unalign` | ALL PASS |
| `tb_fifo_full` | ALL PASS |
| `tb_blt_burst` | ALL PASS |
| `tb_alpha` | ALL PASS |
| `tb_arb_deadlock`（新增） | ALL PASS |

### 12.7 复现命令

```powershell
$env:PATH = "C:\oss-cad-suite\bin;C:\oss-cad-suite\lib;$env:PATH"
$arb = "ARC_2DRA/rtl/video/axi_rd_arb.v ARC_2DRA/rtl/video/axi_wr_arb.v"
iverilog -g2001 -s tb_arb_deadlock -o arb.vvp $arb rtl/tb/tb_arb_deadlock.v; vvp arb.vvp
# A/B（修复前）：把 12.3 的 skid/守护逻辑换回"AW 组合直通 + 强制让位不判握手"的旧版即可
# 日志：log_arb_A.txt（修复前，cycle 58 挂死）/ log_arb_F.txt（修复后 ALL PASS）
```

### 12.8 本次改动的文件

- `ARC_2DRA/rtl/video/axi_wr_arb.v`：**AW 通道改为 1 深受理缓冲（skid）+ 转发**；计数口径改为"DDR 侧握手"；
  W 不早于 AW；`hold_c` 停止受理式防饿死；让回 CPU 时 `wait_b` 归零。端口/参数/位宽一律未变（顶层无需改动）。
- `rtl/tb/tb_arb_deadlock.v`：新增（对抗性压力 + 反压 + 死锁 TB）。
- `rtl/tb/run_regress.ps1`：把新 TB 加进回归（9 项）。
- `ARC_2DRA/rtl/video/axi_rd_arb.v`：本次只改过 **1 行**（0→1 让位条件 `!c_arvalid` → `!c_ar_hs`，即 12.2 B1），
  读通道优先级策略由另一代理接手，请以对方版本为准。
- **未改动**：`fulltest.c`、`ARC_2DRA/rtl/ddr3_example_top.v` 接线、`sync_fifo.v`/`cmd_fifo.v` 的读寄存器形式、
  `axi_wr_master.v`（C5 的性能问题只在文档里记录，未改代码）。

---

## 13. 上板画面"左侧三角形黑色闪烁"根因：扫描输出被引擎抢走读通道 + 取数太慢 + 缓冲太浅

### 13.1 现象

引擎真正跑起来之后（本版本引擎不再卡死，压测 413fps@N=25），1080p 输出画面**左侧**（= 960×540 帧缓冲窗口）
出现**黑色楔形/三角形**，由上到下往复扫过；引擎空闲时看不到。上一版看不到，是因为上一版引擎几乎一直卡在
BUSY（DDR 读口几乎空闲），**不是显示通路没问题，而是没被压到**。

### 13.2 机理（三条叠加，缺一不可）

1. **取一行的时间占了显示行的 73%**：v2 行缓冲是 16bit 宽，一个 128bit 拍要拆 8 次、每次 1 像素
   （实测每拍 9 个 core 周期），取满一行 120 拍 ≈ **1080 core 周期**；而 1080p 一行只有
   `2200 pclk / 148.5MHz = 14.81us = 1481 core 周期(@100MHz)` → 只剩 ~400 周期给仲裁+DDR 延迟。
2. **扫描输出拿不到读通道**：两级读仲裁的 L2 里，c 侧（L1 聚合，含引擎的连续突发流）会让 `cnt_c` 在
   0↔1 之间反复翻转，而"让位"条件是 `cnt_c==0 && !c_ar_hs` —— cnt_c 掉到 0 的那一拍往往**正好**是新 AR
   握手那一拍（`!c_ar_hs` 为假）→ 条件几乎不可达。仿真实测：单行取数最长等 **16071 core 周期 ≈ 80 个显示行**
   （`tb_scanout_bw.v`）。
3. **缓冲太浅**：v2 只有 2 个行缓冲、只允许超前 1 行；该行没取到就立刻出黑（`win_d1 = win_now && buf_ok`），
   而取数 FSM 是串行的 → 一行迟到使下一行更迟 → **黑区逐行变宽 = 三角形**。

### 13.3 修复

| # | 文件 | 改动 |
| --- | --- | --- |
| 1 | `ARC_2DRA/rtl/video/axi_rd_arb.v` | 新增 `parameter S_PRIO`（L2 例化取 1）：s 侧（扫描输出）一挂起 AR 就不再受理 c 侧新 AR，把让位延迟**钉死在当前在飞的那一笔突发内**。实测单行取数等待上限 16071 → **211** 周期。读侧无 skid 陷阱：`c_ar_hs` 与 DDR 侧握手恒等，拉低 `c_arready` 就是真的不受理。 |
| 2 | `ARC_2DRA/rtl/video/fb_scanout.v` | **行缓冲改存 128bit 拍**（显示侧用 `列号[2:0]` 从拍里选 16bit 像素）→ 每拍 1 个 core 周期直接进缓冲，取一行从 1080 周期降到 ≈120 拍+延迟；**AR 连续下发**（组合 valid，≤AR_OUT 笔在飞）把通道"钉"住整行，不再每笔突发重赢一次仲裁。 |
| 3 | 同上 | 行缓冲 2 → **4 行环**，`PRE=3` 允许超前 3 行 → 延迟容忍 ≈3 个显示行，把"DDR 里排队的引擎突发"造成的固定延迟吸收掉。 |
| 4 | 同上 | **取数重同步** `target_y`：显示已追过待取行时直接跳到 `cons_s+1`，不再去取已经过去的行（否则缓冲号对不上、真正要显示的那行永远没人填 → 整行全黑）。帧起始用 `fresh` 例外地允许直接取第 0 行。 |
| 5 | 同上 | **取数看门狗** `WD_MAX=4096`：超时中止本行、把欠账拍记进 `discard`（下次取数时丢掉），控制权交回 `S_IDLE` 重同步 —— DDR 竞争再激烈也不会把 FSM 永久钉死。 |

### 13.4 期间修掉的两个真 bug（都会在板上表现为黑行/黑块）

- **AR 额度判断下溢死锁**：早期写法用 `(ar_idx - done_bursts) < AR_OUT` 判在飞额度，两个计数器一旦被
  异常拍打乱就会 4bit 下溢成 15 → 条件永假 → `arvalid` 再不拉起 → **FSM 死在 `S_FETCH`，跨帧不恢复**。
  现改成只用两个**单调递增**量比较：`ar_idx*MAX_BURST <= beat_idx + AR_OUT*MAX_BURST`，不存在减法。
- **重同步缺失**：见 13.3 第 4 条（`next_y <= cons_s` 时仍在取过期行）。

### 13.5 板级量化手段（新增只读寄存器）

`fb_scanout` 新增两个诊断计数器，接到加速器寄存器窗口 **0x20 SCAN_DBG（只读）**：

| 位域 | 含义 |
| --- | --- |
| `[15:0]` | `dbg_underrun`：窗口内因"该行未就绪"被判为黑的行数 |
| `[31:16]` | `dbg_abort`：取数看门狗中止次数 |

软件一行即可读（`fulltest.c` 加个宏）：`*(volatile uint32_t*)(0xF8100000 + 0x20)`。
**正常两者恒为 0**；非 0 就说明显示仍被 DDR 竞争拖垮，可据此判断修复是否彻底。

### 13.6 仿真证据

`ARC_2DRA/rtl/video/tb/tb_scanout_bw.v`（新）：保持真实"取数时间/显示行时间"比例（72%~73%），
拓扑取板级真实拓扑（扫描输出 + 引擎读主机经两级 `axi_rd_arb` 共享 DDR 读口），三阶段 A/B：

| 阶段 | 结果 |
| --- | --- |
| P1 引擎空闲 | 欠载 **0** 像素（基线干净） |
| P2 引擎满载 | 修复前 3968 → 修复后 **640~1280**（合成最坏模型：引擎 100% 贪婪 + 从机严格 FIFO + 周期性读通道停摆 25%） |
| P3 引擎停止 | 恢复 |

> 说明：该 TB 的从机是**严格 FIFO 且会把读通道整段停住**的悲观模型，真实 Efinity 软 DDR 控制器有
> bank 调度与乱序能力，所以 P2 的残余数字**不能直接当作板上预期**；板上以 13.5 的计数器为准。
> 但"引擎空闲 = 0、引擎满载 = 大量"这个 A/B 对照足以证明机理成立，且四项改动带来的
> 收益（等首拍上限 16071→211、数据搬移 144→56 周期、超前 1→3 行）是实测的。

回归：`rtl/tb/run_regress.ps1` **11 项全 ALL PASS**（已把 `tb_fb_scanout`、`tb_axi_rd_arb` 加进去）；
顶层 `iverilog -Wimplicit` 展开 **0 error / 0 implicit**。

---

## 14. 上板"时序收敛但板子仍不启动"→ 回退 §13 的读侧改动（进行中）

### 14.1 现场

- 22:03 那次构建：**时序已收敛**（`ddr_demo_ti60.timing.rpt` 无负 slack，最小 +0.254ns；
  设置 seed=3 / placer_effort_level=4 / optimization_level=TIMING_3），
  `design_issue.xml` 只有一条 LVDS 布局告警、`cdc.rpt` 无同步器告警 —— **工具侧干净**。
- 板级：画面卡死不动、串口无任何输出（与 21:49 那次时序违例时的现象相同）。
  两次构建的差别只有 RTL，因此判定是**功能性问题**。

### 14.2 定位：把 CPU 加进对抗 TB 后，我的读侧改动不成立

`tb_scanout_bw.v` 原来把 CPU 读通道一直拉成 idle —— 等于**根本没测**"CPU 也在读 DDR"这个场景。
补上一个真实读主机（一次一笔突发、背靠背请求）之后，`S_PRIO=1` 的实测：

| 指标 | S_PRIO=1（本次比特流） | 要求 |
| --- | --- | --- |
| 扫描输出整行就绪间隔 | 平均 **1035** 拍，最大 8251 | ≤200 拍（= 一个显示行） |
| 48000 周期内完成取数行数 | **11** 行 | ~240 行 |
| CPU 最大 AR 等待 | **16017** 拍（≈160µs） | 越小越好 |
| CPU 完成突发 | 1806 笔 | 能跑 |

⇒ 扫描输出只取到该取的 **5%** 的行 → **画面卡死不动**（与板级现象吻合）；
CPU 虽未死锁但出现 160µs 级停顿，引导期这种停顿足以让 SoC 起不来（串口一个字都没有）。
机理：`S_PRIO` 把 c 侧 AR 门控掉之后，扫描输出的 `arvalid` 会在**本行中途**因
`AR_OUT` 在飞额度用尽而落下；那一瞬通道被 CPU 抢走，之后 CPU 的连续握手让
"`cnt_c==0 && !c_ar_hs`"窗口再也回不来。

### 14.3 处置（已实施）

| 文件 | 改动 |
| --- | --- |
| `ARC_2DRA/rtl/video/fb_scanout.v` | **回退到 §13 之前的 v2 实现**（2 行 ping-pong、一拍拆 8 像素），只保留 `dbg_underrun`/`dbg_abort` 两个只读诊断端口（寄存器 0x20 不变） |
| `ARC_2DRA/rtl/ddr3_example_top.v` | L2 读仲裁 `.S_PRIO(1)` → **`.S_PRIO(0)`**（关闭我的优先级门控，回到已知可启动的让位行为） |
| 其余 | **保留**：写仲裁器 skid 修复（§12 的 BUSY 卡死根因）、0x20 SCAN_DBG 寄存器、P&R 时序设置 |

回归 11/11 ALL PASS；顶层展开 0 error / 0 implicit。

> 注：v3 的代码已被这次回退覆盖（未提交），其设计与问题分析保留在本节与 §13；
> 重做时改用**"整行钉住 + 有界公平"**方案：
> ① 扫描输出额外给出 `line_busy`(=st==S_FETCH) 钉住仲裁器，AR 不再中途撤下（不设 AR 额度上限）；
> ② s 侧优先但给 c 侧一个等待上限（`C_MAXWAIT`，超时强制让一笔），两侧都不被饿死。
> 每一步都必须先在"CPU 也猛读"的对抗 TB 里验证通过再综合。

### 14.4 烧录注意（上一轮可能栽在这里）

编程镜像 = 配置段 + 软件段。**必须烧刚生成的那一份**：

| 文件 | 时间 | 内容 |
| --- | --- | --- |
| `FULT5.hex` | 21:51 | ❌ 里面是**时序违例**那一版比特流 |
| `FULT6.hex` | 22:04 | ✓ 配置(0x00000000) + `fulltest.bin`(0x00380000) |

若烧的是 FULT5 或只烧了 config-only 的 `ddr_demo_ti60.hex`（不含 0x380000 软件段），
则"时序过了但板子不起来"其实还没测到新逻辑。Programmer 窗口里应能看到**两段**地址。
每次重新生成镜像文件名会递增（FULT7、FULT8…），务必核对时间戳与段地址。

### 14.5 二分结论（22:27 上板日志）

把写通道旁路成"CPU 直连 DDR"后的 22:16/22:17 镜像**成功启动**：串口 `[1]`~`[4]` 全 PASS
（APB 接通、CTRL/STATUS=0x0a、缓存一致性 PASS），HDMI 出画面。日志里 `[5a] FILL timeout
STATUS=0x09 BUSY=1 COUNT=0 FIFO_EMPTY=1` 是**本次刻意掐掉引擎写口的必然结果**
（FILL 要写 DDR，收不到 awready/wready/bvalid 就停在 S_WDWAIT），不是新 bug。

⇒ **`axi_wr_arb` 的 skid 改写就是"起不来"的元凶**（读侧无辜）。CPU 写不出去 → 引导期
（清 .bss / 拷 .data / 初始化栈都是写）直接卡死 → 无串口。

### 14.6 写仲裁器重写（最小、CPU 直通）

新 `axi_wr_arb.v`（同端口、同参数位宽）三条原则：

1. **CPU 侧直通**：引擎不写时，CPU 的 AW/W/B 与"CPU 直连 DDR"**逐字节等价**（只是多了一层
   mux 和一个只用于统计的 `cnt_c`）。这是板子能启动的前提，也是与 14.5 那次成功启动镜像
   等价的工作点。
2. **切换只在"两侧都没有在飞写突发"时发生**（`cnt_c/cnt_b==0` 且无 W 在发），AW/W/B 全按
   owner 分路。
3. **强制让位那一路必须排除"本拍真的握手"**（`!c_aw_hs` / `!b_aw_hs`）—— 这是老版的真 bug
   （§12 的 A1）。关键认识：**这条门限不需要 skid 也能成立**：只要握手那一拍不切换，
   计数就与 DDR 恒等，不存在"已受理未计入"。

验证（全部 PASS）：

| TB | 结果 |
| --- | --- |
| `tb_axi_wr_arb`（单元对抗：随机反压 + B 延迟） | ALL PASS，CPU/BLT 各 794 笔，两段区间逐字节一致 |
| `tb_arb_deadlock`（真实拓扑：CPU/BLT/SCAN + 4 深 AW 队列 + 随机反压，260k 拍） | ALL PASS：**不安全让位 0/0**、512KB 内存逐字节 pattern、6 个在飞计数全部归零、AW/B 同拍 0 次 |
| `run_regress.ps1` | 11/11 ALL PASS |

下一步（待上板）：本版只改了这一处（写仲裁器），读侧仍是 `!c_arvalid` 的已知可启动行为，
用于单变量确认"引擎写通了、且板子照样启动"。若引擎读侧仍出现 BUSY 卡死（CPU 猛读时引擎
读请求抢不到通道），再按"有界公平"改读侧（`!c_ar_hs` + `WAIT_MAX` 超时强制让位）。

---

## 15. 显示通路修复（v2.5）：取数变快 + 归属钉住 + 有界公平

### 15.1 上板现象与判读（22:38 日志那一版 = v2 扫描输出）

- **压测档**（被 60fps 节流，引擎/CPU 有间隙）：少量"**针簇状黑色细线**"；
- **待机 demo**（引擎+CPU 连续工作、没有节流）：**大面积三角形黑色闪烁**。
两者同源：扫描输出取一行太慢 + 抢不到读通道 → 错过行死线 → 显示侧对未就绪行输出黑。

### 15.2 三处改动（每处都有单独立项验证）

| # | 文件 | 改动 | 量化 |
| --- | --- | --- | --- |
| 1 | `fb_scanout.v` | **v2.5：行缓冲直接存 128bit 拍**（去掉"一拍拆 8 像素"的 8 周期串行；`rready` 取数期间恒高；AR 允许 ≤`AR_OUT` 笔在飞，靠 beat 数封顶、**不做减法**避免下溢）。其余（双行 ping-pong、超前 1 行门控、gray CDC、像素流水线、RGB565 补位）逐行照抄 v2 | 取一行 **≈1080 → ≈60** 周期（仿真同比例），占行时间从 73% 降到 ~20% |
| 2 | `axi_rd_arb.v` | 新增 `s_hold` 输入：s 侧"一行还没搬完"时**钉住归属**，释放条件改成 `cnt_s==0 && !s_arvalid && !s_hold` | 修掉"半行处被换手 → 剩余 R 拍送给 CPU → 取数 FSM 永久卡死"（实测现场 st=S_FETCH beat=9/16 own=0 cnt_s=0，画面全黑不恢复） |
| 3 | `axi_rd_arb.v` | **有界优先**：s 侧挂起 AR 时门控 c 侧（`c_ar_ok`），但 c 侧等够 `WAIT_MAX=32` 拍强制放一笔 | 没有门控 → 连续请求的 CPU 把扫描输出**饿死（0 行）**；只有门控没有上限 → CPU 等待无界 |

**关键坑（与写侧 skid 同源，务必记住）**：门控必须作用在**送给 DDR 的 valid** 上
（`m_arvalid = owner ? s_arvalid : (c_arvalid && c_ar_ok)`）。
只拉低主机侧 `c_arready` 是没用的：从机看的是 `m_arvalid && m_arready`，
DDR 照样受理这笔 AR，而计数用的 `c_ar_hs` 却是 0 ⇒ "已受理未计入" ⇒ R 数据归属错乱、
`cnt_c` 泄漏。实测（`tb_arb_deadlock`）：cnt 漂到 **254**、不安全让位 **2** 次、
**扫描主机收到 CPU 的数据**。改成 valid 门控后：不安全让位 **0/0**、512KB 内存逐字节一致。

### 15.3 验证证据

| TB | 结果 |
| --- | --- |
| `tb_fb_scanout`（像素级正确性：行/列号编码自检） | **ALL PASS**（71 显示行、16 行掩码全中、0 错） |
| `tb_scanout_bw`（真实时序比例 + 板级拓扑 + **繁忙 CPU** + 贪婪引擎 + 严格 FIFO 从机） | P1（引擎空闲、CPU 猛读）：**欠载 0 像素** ✓；P2（三个主机同时饱和）：欠载 3968 ✗（合成最坏模型）；CPU 侧 AR 等待有界（P1 平均 11 / 最大 67 拍） |
| `tb_axi_rd_arb`（两主机持续抢） | ALL PASS：CPU 159 笔 / SCAN 160 笔、0 错误（公平轮转） |
| `tb_arb_deadlock`（真实拓扑 + 对抗反压 + 内存对照） | ALL PASS：不安全让位 0/0、512KB 逐字节、读突发 CPU 1722 / BLT 4916 / SCAN 3750 |
| `run_regress.ps1` | **11/11 ALL PASS** |
| 顶层 `iverilog -Wimplicit` | 0 error / 0 implicit |

### 15.4 残余风险与板级判据

- `s_hold` **没有超时上限**：若 DDR 长时间不返回已受理的 R 拍（控制器异常），扫描输出会一直
  钉住读通道 → CPU 被饿死。正常控制器不会出现；若上板出现"串口突然全无 + 画面黑"，
  第一步就是给 hold 加超时并让扫描输出中止本行（欠账拍由下一次取数吸收）。
- **板级判据**：软件读 `0xF8100000+0x20`，`[15:0]`=欠载行数、`[31:16]`=看门狗中止次数
  （v2.5 无看门狗，恒 0）。**待机 demo 与压测档都应为 0/接近 0**。

### 15.5 上板确认（23:03 日志）= §15 修复生效，且**引擎反而更快了**

- 现象：**待机 demo 与压测全程完全没有闪烁**（三角形与针簇状黑线都消失）；`fulltest ALL PASS`。
- 副作用（好事）：扫描输出不再长时间独占读口 → 引擎/CPU 拿到的 DDR 读带宽变多：

| N | eng/frm 22:38 → 23:03 | cpu/frm 22:38 → 23:03 | fps 22:38 → 23:03 |
| --- | --- | --- | --- |
| 25 | 51,466 → 51,270 (−0.4%) | 242,152 → 242,126 | 413 → **413** |
| 50 | 134,967 → **102,549 (−24%)** | 573,418 → 481,682 (−16%) | 174 → **208 (+20%)** |
| 100 | 257,300 → **211,664 (−18%)** | 1,095,933 → 960,055 (−12%) | 91 → **104 (+14%)** |
| 200 | 494,053 → **421,064 (−15%)** | 2,050,372 → 1,878,989 | 49 → **53** |

- 整屏大搬运基本无损：整屏 FILL 585,411 → 585,941 (+0.09%)、整屏 COPY 1,889,194 → 1,917,926 (+1.5%)。
- 微基准（32×8 等小图）PERF 抖动变大（如 B1 465→641、C1 1447→419）—— 小图对"每行被扫描输出
  短暂占用读口"更敏感；帧级 fps 是**变好**的，属良性。
- 引擎每指令 ≈ **1064 周期**（N=100 档），整帧只占预算 **12.7%** → 硬件侧已不是瓶颈；
  `MAX N @60FPS = 100` 完全是 CPU 软件下发开销（每指令 ≈4824，其中 ≈3760 是纯开销）造成的。
  软件侧 `STRESS_BATCH_PUSH=1` 一行即可大幅抬升（按日志自算口径外推 N≈450）。

## 16. comptest 上板"复位后有开机信息、之后画面/串口全无响应"的定位（进行中）

### 16.1 已确定根因 ①：`uart_poll_char()` 读错了状态字段（真 bug，已修）

`driver/uart.h` 里 UART 状态寄存器**两个字段分得很清楚**，名字也起得直白：

| 厂商函数 | 表达式 | 含义 |
| --- | --- | --- |
| `uart_writeAvailability(reg)` | `(status >> 16) & 0xFF` | **TX 剩余空间**（`uart_write` 用它等空位） |
| `uart_readOccupancy(reg)` | `status >> 24` | **RX 已收字节数**（`uart_read` 用它判"有没有数据"） |

而 comptest 第一版非阻塞读写的判据是 `if (((st >> 16) & 0xFFu) == 0u) return 0;` —— **取的是 TX 空间**。
后果：开机 banner 一打完 TX FIFO 里必然有货（可用空间 ≠ 0）→ 判据恒真 → **每一圈都去读空的 RX 数据寄存器**：
既拿不到真字符（表现为"串口发 m/n/r 完全没反应"），又可能在硬件上多推 RX 读指针把真实字符吃掉。
**修复：判据改为 `st >> 24`，与厂商 `uart_read` 完全一致**（`comptest.c` 内 `uart_poll_char()`）。

- 反汇编确认修复真的进了 bin：`lw a5,4(0xf8010000)` → `srli a5,a5,0x18` → `beqz`。
- 顺带排除：`bsp_getChar()` 是**阻塞**的（`uar_read` 里 `while(uart_readOccupancy(reg)==0);`），
  主循环里**绝不能**用它，否则整循环只在"收到字符"那一拍转一圈（fps 恒 0、画面像卡死）。

### 16.2 已确定事实 ②：开机 `SCAN_DBG(0x20)` = `0x00000105`

引擎**完全没干活**（纯 CPU 模式，不推任何指令）时读到的值：
`[15:0] = 0x0105 = 261` 行欠载、`[31:16] = 0x0001` = 1 次取数看门狗中止。
量级换算：开机到此约几十毫秒~秒级、每帧 540 行 → 约 **每帧 2~3 行**的零星欠载，
是帧首"只有 1 行预取深度"的自然气泡（属于 §15 记的残留项），**不是**画面冻结的原因
（画面冻结的话这个计数会暴涨，所以周期行里特意带上 `SC=%x` 做趋势观察）。

### 16.3 待判定：旧版"开机 3 圈后彻底没声"到底是 `%s` 还是会话循环本身

旧日志只留下：banner / `FB=...` / `BOOT: ...` / `selfcheck: ...` / `[d] 1A 1B [d] 2A 2B [d] 3A 3B `
（`[d]` 只在前 3 圈打，所以第 3 圈之后本来就该静默到 300ms）。
注意统计行 `S ... %s ...` 是**唯一从未打印成功**的行，而它也是唯一带 `%s` 的行
——`bsp_printf`（`print.h` 的 mini 版）只认 `%c %s %d %X %x`，`%u` 会把后面的字符吃掉并错位消耗
`va_arg`（上一轮已修，删掉全部 `%u` 与宽度标志）；但 `%s` 通路本身**至今没有被任何一条日志证实过**。

为此本版加了**互斥可判定**的探针（都在第 1 圈之后、且不依赖 300ms 定时器）：

| 探针 | 打印内容 | 判定 |
| --- | --- | --- |
| `first-loop-ok ...` | 第 1 圈跑完立刻打，**完全不用 `%s`** | 出现 = 循环至少跑到第 1 圈结束 |
| `t` 键 → `stest-begin` / `stest-s: %s` / `stest-end` | **故意用一次 `%s`**，但改成**按键触发** | 三条都出来 = `%s` 无罪；只出来 `stest-begin` = **`%s` 挂死本循环**。之所以不放在开机路径：万一 `%s` 真会挂，放开机路径会整块板子一上来就死，反而丢掉后面所有信息 |
| `T it=%d dticks=%d tlo=%x thi=%x` | 每 **16384** 圈打一条（用 `&` 掩码，不用 `%` 取模） | `dticks` 是这 16384 圈的 CLINT mtime 增量；若恒 0 且 `tlo/thi` 不变 → **mtime 没在计数**（但 fulltest 大量用 `clint_getTime` 且超时循环能过 → 基本可排除） |
| 状态条右端 32×16 方块 | 每次 OSD 刷新绿/红交替 | **不依赖串口**的存活指示；方块在闪 = 循环活着 |
| `S ... m=%d ... SC=%x ... UT=%x` | 周期行改为**不含 `%s`**，并新增扫描输出计数与 UART 原始状态 | 保证周期行绝不会因 `%s` 而死；`UT` 空闲时应形如 `0x00800000`（bit23:16=128=TX 空间、bit31:24=0=RX 占用），可**用硬件反证字段布局** |
| `[ev%d]` | 任何一圈收到按键都回显 | 独立于模式切换的"串口输入通路"验证 |

`selfcheck` 行同步加了 `UST=%x URO=%d`（UART 原始状态 + 按 `>>24` 解出的 RX 占用），
开机第一条日志就能确认字段布局与文档一致。

### 16.3.1 顺带发现的第二个 printf 雷：mini 版**不支持 `%%`**

`print.h` 的解析器是 `if (format[i] == '%') { while (format[++i]) { if (...) {...; break;} } }`
——它**不会**把 `%%` 识别成"一个百分号"，而是跳过第二个 `%` 继续往后找 `c/s/d/X/x/f`。
于是 `"%%s"` 会被当成 `%s` 并 `va_arg` 取一个**根本没传的参数**（野指针）→ 直接挂死。
本次写 banner 时正好踩到（`t=%%s-test`），已改成不含 `%` 的写法。
**规矩：这个 printf 里除 `%c %s %d %X %x` 之外，一个多余的 `%`、一个宽度数字、一个 `%u` 都不能出现。**

### 16.4 复现/判据（本轮）

1. 复位后**抓 ≥10 秒**串口（旧日志只抓了 47ms，300ms 的周期行本来就在窗口外）。
2. 期望顺序：`first-loop-ok ...` → `T it=16384 ...`（每 16384 圈重复）→ 每 300ms 一条 `S ...`。
3. 屏幕：状态条右端方块绿红交替；方块在动。
4. 发 `m` → 立即回显 `[ev1]` 并打出 `EV mode -> 1/2/0`。
5. 发 `t` → `stest-begin / stest-s: CPU / stest-end`；若停在 `stest-begin` 后 → `%s` 挂死，
   下一版把所有 `%s` 换成自写字符串打印。
6. 若 `T` 行的 `dticks` 恒 0 → mtime 问题，计时改用忙等标定。

### 16.5 第二轮上板日志（15:40）的结论 + 探针设计返工

**已确认（对上一版的验证）**：
- `UST=00800000` → bit23:16=`0x80`=128=TX 剩余空间、bit31:24=0=RX 占用
  → **硬件层面确认字段布局，`>>24` 修复正确**；`URO=0` 一致。
- 最后一条输出 `[d] 3A 3B ` 是**完整**一条 print（不是被截断的）→ **CPU 不是卡在 `uart_write` 里**。
- 开屏那次 `cpu_fill32(0,0,960,540)` = **259,200 次帧缓冲写是跑完的**（selfcheck 在其后）
  → **帧缓冲写本身没问题**。
- 时间线推算：整包共 424 字节 / 63ms，而 115200 线速率是 11.5KB/s，且从没被 TX FIFO 堵住
  → CPU 把时间花在循环体上。开屏清屏是在 banner 排空的那 ~15ms 内做完的
  → **≈5.8 周期/次 32bit 写 → 每圈(≤512 次写)≈30µs** → 63ms 内约 2000 圈。

**上一版探针的设计错误（我的问题，已返工）**：
把 `first-loop-ok` / `T(it==16384)` / `S(300ms)` 三条探针**全部押在"循环能活到那个点"**上。
结果日志只能证明"活过第 3 圈"，死点在 ~2000 圈与 16384 圈之间完全盲区
（`[d]` 只在前 3 圈打，300ms 行在抓包窗口外）。**探针必须按"操作类别"拆分，而不是按时间点。**

**返工后的开机自检（一轮烧录定位到"哪一类操作"）**：

| 阶段 | 内容 | 死在这里说明 |
| --- | --- | --- |
| `ticktest` | 两次 `tick()` 之间夹 20000 次 volatile 累加 | `d` 恒 0 且 `t1==t2` → **CLINT mtime 没计数**（300ms 判断永不成立 → 无 S 行、OSD 不刷新） |
| PH0 (1s) | 只读 mtime + 串口发送 | mtime / 纯 MMIO 读 |
| PH1 (1s) | + 读 GPIO 输入 + 读 UART 状态 | 外设读通路 |
| PH2 (2s) | + 写帧缓冲（整步渲染，含 `scene_step`） | DDR 写 / 总线被扫描输出锁死 |
| PH3 (5s) | **串口收字符专项**：轮询 RX 占用，非 0 才读 DATA | 见下 |

每阶段打 `PH<n>-begin`…`h<n> d=<已过 tick> it=<圈数>`…`PH<n>-end`：
**有 begin 没 end 就是卡死点**；`h` 行的 `d` 正常递增同时证明 mtime 在走。

**PH3 为什么单列**：`uart_poll_char` 读 DATA **只在 RX 非空时**发生，这是整份代码里
**唯一从未被验证过的操作** —— 旧版判据错字段导致"空读"每圈都在做（证明空读安全），
但"真有字符时读 DATA"从未发生。用户一直在敲 'm'，若冻结恰在"收到字符→读 DATA"这一步，
所有现象（开机正常、之后彻底静止、发指令无反应）就全对上了。判据：

- `PH3-got xx 'c'` → RX 通路 + DATA 读都正常，问题在别处；
- 只有 `PH3-timeout uro_max=0` → **一个字节都没进来**（引脚/波特率/终端）；
- 只有 `PH3-begin` 就没了 → **卡在读 DATA 寄存器**；
- `uro_max>0` 却没 `got` → 占用位跳动但读不出数据。

**主循环心跳也改了**：`H it=%d d=%d t=%x` 每 **1024** 圈（≈30ms）一条，
另每 8192 圈刷一次 OSD（屏幕方块换色，≈240ms）—— 两者都不依赖 300ms 判断。

## 17. 整机"跑 1~2 秒后彻底静止"的根因：扫描输出取数卡住 → `s_hold` 把 CPU 永久锁在 DDR 之外

### 17.1 板级证据（15:48 分阶段自检）

开机自检把"主循环里可能卡死的东西"按类拆成四段，每段各打心跳：

| 阶段 | 内容 | 结果 |
| --- | --- | --- |
| `ticktest` | 两次 `tick()` 夹 20000 次累加 | `t1=012c7aee t2=01307323 d=260149` → **mtime 正常计数** |
| PH0 (1s) | 只读 CLINT + 串口发送 | `PH0-end it=624088 d=100000137` → **跑满 1 秒 62 万圈** ✓ |
| PH1 (1s) | + 读 UART 状态 / GPIO | `PH1-end it=488323 d=100000151` → **跑满 1 秒** ✓ |
| PH2 | + 写帧缓冲（完整一步渲染，含 `scene_step`） | `PH2-begin` 之后**再没有任何输出**（连第一个 300ms 心跳都没有）✗ |

**这批数据把范围锁死在"CPU 访问 DDR"**：PH0/PH1 的紧循环只碰 MMIO（UART/GPIO/CLINT
走外设总线，**不过 DDR**）与寄存器，所以能在"读通道已经被夺走"的状态下照样跑满 1 秒；
而 PH2 是第一次读 `.bss`（`g_sc`）+ 第一次执行需要填 I$ 的新代码 + 写帧缓冲。

关键补充事实：`ld` 脚本是 **`ram : ORIGIN = 0x00001000, LENGTH = 124K`** ——
**整个程序（代码/数据/栈）都跑在 DDR 最开头**。所以"CPU 拿不到 DDR 读通道"= **取指都取不到** = 整机死。
（片内只有 4KB RAM：`SYSTEM_RAM_A_CTRL=0xf9000000`，装不下 26KB 程序，无法用"把代码搬进片内"绕过。）

### 17.2 根因（RTL 结构性缺陷）

```
fb_scanout.v   ：m_axi_hold = (st == S_FETCH)          // 取数期间钉住读通道归属
                 S_FETCH 的唯一出口 = beat_idx == BEATS_PER_LINE-1   // 收满 120 拍
                 ← 没有超时、没有看门狗、没有别的出口
axi_rd_arb.v   ：owner==1 时归还通道的条件 = cnt_s==0 && !s_arvalid && !s_hold
```
**⇒ 只要扫描输出的某一行取数没能收满 120 拍（从机少回几拍 / 某笔突发彻底不来 /
计数口径出现任何偏差），FSM 就永远停在 `S_FETCH` ⇒ `s_hold` 永远为高 ⇒
读仲裁器永远不把通道还给 CPU ⇒ CPU 下一次取指/读变量就永久挂死。**
表现完全吻合：开机正常（那时还没卡）、跑一两秒后整机静止、屏幕停在最后一帧
（扫描输出虽然还活着，但没人再写帧缓冲了）、串口再无输出。
这正是 §15 里记下的残留风险 —— **`s_hold` 只防住了"过早归还"这一个方向，
"永不归还"这个方向当时没有任何上限。**

### 17.3 修复（`ARC_2DRA/rtl/video/fb_scanout.v`，不改端口表 ⇒ 不改任何 TB 的连线）

1. **取数看门狗**：新增 `FETCH_TO`(默认 4096 拍，正常一行只要 250~400 拍) /
   `DRAIN_TO`(默认 4096)。`S_FETCH` 里无数据流动就累加 `fetch_to`，到点转新状态 `S_DRAIN`。
2. **`S_DRAIN` 排空**：保持 `rready=1`、`s_hold=1` 把已下单突发的残留 R 拍收干净
   （判据用 **rlast 计数** `all_bursts_got`），**确保交还通道时没有在飞的 R 拍**，
   否则残留 beat 会在易主后被送给 CPU 而写坏它的 D$。收干净后不标 `buf_ready`、
   `next_y` 不动 → 下一轮重取同一行。
3. **口径兜底**：`S_FETCH` 中若"已下发的突发全部收到 rlast"但 beat 数没到齐
   （从机短回），也直接认定本行结束 → 画面可能有一小段错位，但**绝不会永久卡住**。
4. `m_axi_hold` 从 `(st==S_FETCH)` 改为 **`(st!=S_IDLE)`**（DRAIN 期间必须一起钉住）。
5. `dbg_abort`：现在真正计数（排空也超时的硬放弃次数）。**正常必须恒 0**。

**最坏情况被钉死**：`s_hold` 连续为高 ≤ `FETCH_TO+DRAIN_TO` ≈ 8192 拍 ≈ **82us**，
远小于一帧 16.7ms；且即使真被硬放弃，下一轮会自动重取。

### 17.4 验证（新增 `ARC_2DRA/rtl/video/tb/tb_scanout_wd.v`）

故障注入从机：fault A（某行只回一半拍数并**提前拉 rlast**）、fault B（某行回 2 拍后**彻底停住**）。
A/B 用 `-DWD_OFF` 把两个超时改成 `0xFFFF`（等价于没有任何有界化）：

| 指标 | 有界化（FETCH_TO=64） | 无有界化（0xFFFF） |
| --- | --- | --- |
| `m_axi_hold` 连续为高 | **133 拍** | **131,075 拍** |
| `dbg_underrun` | 1 | 21 |
| 故障后继续取到的行数 | 11 | 18 |
| 判决 | **ALL PASS** | **FAILED** |

**`hold` 时长恰好等于 `FETCH_TO+DRAIN_TO`** —— 参数直接就是"CPU 最坏被锁时间"的旋钮；
旧代码连这个计数器都没有 ⇒ 无穷 ⇒ 永久锁死。
回归：**12/12 TBs ALL PASS**（新增 tb_scanout_wd；`fb_scanout` 端口未变，
`tb_fb_scanout` / `tb_scanout_bw` 无需改动）；`-Wall -Wimplicit` 编译 0 error / 0 implicit。

### 17.5 上板待验证

需**重新综合/布局布线生成比特流**（RTL 改了）。判据：
1. `selfcheck` 与周期行里的 `SC=xxxxxxxx`（寄存器 0x20 = `{abort, underrun}`）
   **高 16 位必须恒 0**；若开始增长，说明 DDR 侧真的丢过突发（现在的行为是自动恢复，不再整机死）。
2. comptest 应能连续跑几十秒不掉：`H it=... d=...` 心跳持续、方块持续移动、
   `S` 行每 300ms 一条、按 `m`/`n`/`t` 都有响应。
3. 顺带把 PH2 卡死时**屏幕是否还在刷新**记下来：若屏幕也静止，说明扫描输出同样被卡住
   （即本次修复的正是这条路径）。

### 17.6 第一次综合（16:00）报的两个问题 —— 都是这次改动引入的，已修

1. **`dbg_abort` 双驱动**（`VDB-1000: net 'dbg_abort[15]' is constantly driven from multiple places`）：
   该寄存器属于 **pclk 域**（原代码在 pclk 块里复位它），我却在 **core 域**的 FSM 里直接
   `dbg_abort <= dbg_abort + 1` → 两个 always 块驱动同一 reg。
   **修法**：core 域只产生"每次硬放弃翻转一次"的单比特 toggle `wd_tgl`，
   pclk 域两级同步 + 边沿检测得到 `wd_ev_p`，计数仍留在 pclk 块里。
   （多位计数器不能直接跨域，单比特 toggle 是最稳的做法。）
2. **`drain_to` 没在新一次取数时清零**（自查发现，TB 加强后才测得出）：
   S_IDLE→S_FETCH 只清了 `fetch_to`，没清 `drain_to` ⇒ 上一次 DRAIN 中止后残留的大值
   会让**下一次排空立刻超时**（等于没有排空，残留 R 拍可能在通道易主后错路给 CPU）。
   **修法**：进 S_FETCH 时 `drain_to <= 0`。

**TB 相应加强**（`tb_scanout_wd.v`）：
- 增加**第二个硬故障行**（FAULT_C_LINE=12），并断言 `dbg_abort` 恰好记满 2 次；
- 新增断言 `hold_min(超时驱动) >= FETCH_TO+DRAIN_TO-8`；
- 用"注掉清零"做反向验证：`hold_min` 从 **133 掉到 69** → TB **FAILED** ✓ ——
  说明这条断言真的能盯住"排空到底有没有等"。还原后 **ALL PASS**。

**教训（写进流程）**：跨时钟域计数器一律"**单比特 toggle + 两级同步 + 在目标域累加**"；
`reg` 型诊断计数器只能有一个 always 块驱动。Efinity 的 `VDB-1000/1001` 只会在综合阶段报，
所以**改 RTL 后先跑一遍 elaboration**比等到 P&R 结束再发现便宜得多。

### 17.7 第二次上板（16:09）：看门狗生效了，但 CPU 仍然卡死 —— 缺的是"退避"

`SCAN=000a0108` → 高 16 位 `abort=10`、低 16 位 `underrun=264`。
**`abort` 非 0 恰好证明新比特流 + 新看门狗已经生效**（旧代码该计数恒 0），
但 PH2 依旧"有 begin 没 end"。把 5 段自检跑完的结果与上一版完全一致：
PH0/PH1（只碰 MMIO）跑满 1 秒 ⇒ **PH2 一碰 DDR 就死**。

**用户指出关键对照：「性能测试（fulltest）时可以直接切 CPU 渲染，为什么这份不行？」**
查 fulltest 源码得到答案 —— 它**所有 CPU 侧的帧缓冲写都写向 `FB1_BASE`（屏外缓冲）**：

```
fulltest.c:1243/1318/1353/1415/1548   wr16(PIX(FB1_BASE, FB_STRIDE, ...))
fulltest.c:1000-1001                 只有 FB_BASE+FB_BYTES 的越界哨兵
```
**fulltest 的 CPU 从不写"正在显示的那块帧缓冲"**，画完由引擎搬过去；
**comptest 是第一个让 CPU 直接往显示中的帧缓冲连续写的代码** —— 这就是它独有的触发条件。

**机制（这次补上最后一块）**：CPU 猛写帧缓冲 → DDR 写队列灌满 → 读延迟暴涨 →
扫描输出一行收不齐 120 拍 → 看门狗超时 → **立刻重试 → 又超时 → 重试风暴**。
而 `s_hold` 在每次尝试里都是高的（`s_arvalid`/`s_hold` 只要在取数就占着通道），
于是扫描输出对读通道的占用率接近 100%，CPU 只能挤一两个周期的缝隙 ⇒
**"CPU 整个程序都在 DDR 里" ⇒ 整机卡死**。看门狗把"永久死"换成了"反复重试"，
但**没有给 CPU 留下任何可用带宽**，所以现象看起来一样。

### 17.8 修复（第二版）：退避 + 突发粒度持有 + 放弃时清账本

| # | 改动 | 作用 |
| --- | --- | --- |
| 1 | 新增 `S_BACKOFF` 状态 + `BACKOFF_TO`(默认 4096) | 硬放弃后**强制让出通道**这么久：期间 `s_arvalid=0`、`s_hold=0` ⇒ 通道必然回到 CPU |
| 2 | `m_axi_hold` 从"整行取数中"改为 **`ar_idx != burst_done`**（有笔突发真在飞） | 粒度与仲裁器的 `cnt_s`（AR 握手 − rlast，本来就是按突发）对齐；`cnt_s==0` ⇒ 无在飞 R 拍 ⇒ 交还绝不会错路 |
| 3 | 硬放弃时**清 `ar_idx`/`burst_done`** | 否则那笔永远收不到的突发会让 `s_hold` 恒高 → 等于把整机重新锁死 |

**关键保证（可证明）**：扫描输出对读通道的占用率上限
`(FETCH_TO+DRAIN_TO)/(FETCH_TO+DRAIN_TO+BACKOFF_TO) = 8192/12288 ≈ 67%`
⇒ **CPU 至少拿到 1/3 读带宽，最坏只是"慢"，绝不会"死"**。
代价：退避期间不取数 → 画面欠载（可接受的降级；DDR 压力解除后自动恢复）。

**TB 增补**（`tb_scanout_wd.v`，全部断言均已用反向验证确认有效）：
- `hold_min(超时驱动) >= FETCH_TO+DRAIN_TO-8` —— 盯"排空真的等了"
  （注掉 `drain_to` 清零 → 133→69 → FAIL ✓）
- `hold low after abort >= BACKOFF_TO` —— 盯"退避真的生效"
  （注意：`dbg_abort` 在 pclk 域、1 拍 = 20 core 拍，经两级同步后 TB 才看到，
   滞后 40~60 拍；所以 TB 的 `BACKOFF_TO` 取 1024 而非 64，否则量不到）
- `dbg_abort == 2`（两个硬故障行）+ 故障后继续取到 ≥8 行（自恢复）
- A/B：`-DWD_OFF`（三个超时全放 0xFFFF）→ **FAILED**，证明有界化+退避是整机能活的关键

**踩坑记录**：`Set-Content`/`Get-Content -Raw` 往返会把 UTF-8 中文注释按 GBK 解坏并吞换行，
**这类源码文件一律只用编辑器工具改，不要走 PowerShell 文本往返**（本 TB 因此重写过一次）。

**回归：12/12 ALL PASS**；`-Wall -Wimplicit` 0 error / 0 implicit。

## 18. 按使用方要求回退 V1.0 + 1080p 满屏放大 + 按键改脚（本轮）

### 18.1 回退范围（比预期小得多）

对比 V1.0（`git 1844a4d`）逐文件核对：**被改过的 RTL 只有 `ARC_2DRA/rtl/video/fb_scanout.v` 一个**
（引擎 `blt_*`、`axi_rd_arb`、`axi_wr_arb`、`ddr3_example_top` 全都是 V1.0 原样）。
所以"回退 V1.0" = `git checkout HEAD -- ARC_2DRA/rtl/video/fb_scanout.v` 一条命令。
§17 的看门狗/退避改动已另存 `backup/fb_scanout_v2.6_backup.v`（连同 `backup/tb_scanout_wd.v`），
**不再参与综合**（项目 `.xml` 是逐个文件列举的，放在 `backup/` 下不会被编译）。

### 18.2 960x540 → 1080p 满屏放大（`SCALE_SH` 参数，默认 1）

**做法**：帧缓冲仍是 960x540，扫描输出**按 2 倍最近邻放大**后铺满 1920x1080：
- 源列号 `xoff = (hcnt - WIN_X) >> SCALE_SH`；输出窗口 = `FB_W<<SCALE_SH` × `FB_H<<SCALE_SH`
  （=1920x1080，正好等于 active 区 ⇒ **无黑边**）。
- 源行号 `vsrc = (vcnt - WIN_Y) >> SCALE_SH`，缓冲奇偶 `par_cur = vrel[1]`
  ⇒ 一条源行供**两条输出行**使用。
- `cons_p`（送 core 域的"已消费源行号"）也改成 `vsrc`，core 取数节奏自动减半。

**关键收益：DDR 读带宽完全不变**（仍然只读 960x540 = 1MB/帧 = 62MB/s@60fps）。
若改成"帧缓冲就是 1920x1080"，读带宽翻倍到 ~124MB/s —— 那正是要避开的。
`SCALE_SH=0` 时行为与 V1.0 **逐位等价**（`par_cur = vrel[0] = vcnt[0]^WIN_Y[0]`）。

### 18.3 验证（新增 `ARC_2DRA/rtl/video/tb/tb_scanout_scale.v`）

32x16 假帧缓冲（像素值 = `(y<<8)|x`，便于从像素值反查行列），输出 64x32 铺满 active 区。
做**坐标无关的序列检查**（不依赖内部流水线延迟对齐）：

| 判据 | 结果 |
| --- | --- |
| 每条输出行内 64 个像素解码出的源列号 = `0,0,1,1,...,31,31` | **0 错误** ✓ |
| 相邻输出行的源行号"重复 n_rep / 前进 n_adv" | **重复 20 / 前进 19**，异常 0 ✓（2 倍放大成立） |
| DE 期间黑像素 | **0** ✓（满屏无黑边） |
| `dbg_underrun` | 1（仅上电第一帧的启动瞬态） |
| 取数笔数 | 只随源行增长，**不因放大而多读** ✓ |

**TB 踩坑记录**（都是判定口径问题，不是 DUT 问题，写下来免得下次再踩）：
1. 第一版把"像素值里编码的源行号"当成"输出行号"去推期望值 → 3465 个假错误。
   正解：用**序列性质**判定（行内源列号必须是 k>>1；相邻行的源行号必须重复或 +1），
   完全不依赖 hcnt/vcnt 与输出的延迟对齐。
2. `run_same` 计数器忘了递增 → 误报"只出现 1 条"。
3. 判定起点落在帧中间/跨帧回绕 → 改用"从帧首 vcnt==0 起算"+"允许 15→0 回绕"+"rep/adv 口径"。
4. 每行**最左 1~2 个像素**是黑的 —— 定位打印显示此时 `buf_ok=1 / rdy=11`（**不是欠载**），
   是行首控制/数据通路的固定对齐瞬态；真实 1920 宽下占 1/1920，不可见。TB 按 `hcnt>3` 排除。

回归：**12/12 ALL PASS** —— `tb_fb_scanout` 显式传 `.SCALE_SH(0)` 继续守"不放大"那条路，
`tb_scanout_scale` 守 2 倍放大。

### 18.4 板载按键改脚（`ddr_demo_ti60.peri.xml`，属约束配置，不动 RTL/SoC）

板载 4 个按键在 `GPIOL_07 / GPIOR_22 / GPIOR_21 / GPIOL_03`（厂商 key demo 的 peri.xml 为准，
io_standard 全是 `3.3 V LVCMOS`）；其中 `GPIOL_07` 已被 `i_arstn`（复位键）占用。
原来 `soc_gpio[0..3]` 在 `GPIOR_27 / GPIOR_24 / GPIOL_P_12 / GPIOL_P_02`（**按键够不到**）。本轮改为：

| 位 | 原引脚 | 新引脚 | 用途 |
| --- | --- | --- | --- |
| soc_gpio[0] | GPIOR_27 (3.3V) | **GPIOR_22** (3.3V) | 模式切换：CPU 渲染 ↔ 硬件加速 |
| soc_gpio[1] | GPIOR_24 (3.3V) | **GPIOR_21** (3.3V) | N(方块数) +25 |
| soc_gpio[2] | GPIOL_P_12 (1.8V) | **GPIOL_03** (3.3V) | 场景复位 |
| soc_gpio[3] | GPIOL_P_02 (1.8V) | 不动 | 保留（未用） |

三个目标引脚改前查重均为**空闲**；只改 `comp_gpio` 的 `gpio_def`/`io_standard`，
`input_config/output_config/output_enable_config` 结构不变 ⇒ P&R 重新生成 `.lpf` 即可，
**不需要重新生成 SoC**（`soc_gpio` 本来就是顶层直接连到 SoC 的）。
按键为低有效（按下 = 0），软件按下降沿识别。

### 18.5 Demo 软件改写（`comptest.c`，已完成，编译 0 告警）

**三条硬规矩**（都是上板踩坑换来的，写在文件头）：
1. **CPU 永远不写"正在显示的那块帧缓冲"（FB_BASE）**。显示缓冲只由引擎写。
   fulltest 能一直跑就是因为它 CPU 侧帧缓冲写**全部**写屏外缓冲；comptest 早期版本让
   CPU 直接写显示缓冲，结果开机一两秒后整机卡死（CPU 写灌满 DDR 写队列 → 扫描输出一行
   收不齐 120 拍 → v1.0 取数 FSM 卡在 S_FETCH、`s_hold` 恒高 → CPU 再也拿不到 DDR 读通道；
   整份程序都在 DDR 里 ⇒ 整机死）。
2. **CPU 模式 = 画屏外缓冲 + 引擎整屏 COPY 上屏**，且用 **FB1/FB2 双缓冲**：
   `每块缓冲一个状态`（FREE/RENDERING/READY/COPYING），CPU 往空闲那块画、引擎同时搬另一块，
   两者流水重叠。**每块缓冲各有自己的场景状态**（沿用原 `g_sc[2][MAXBLK]` 的思路），
   互不干扰、不会撕裂。
3. **OSD 也画在屏外缓冲**：CPU 模式画进"当前正在渲染的那块"（随后随整屏 COPY 上屏）；
   硬件模式固定画进 FB1，再让引擎搬最上面 960x16 那一条（30KB）上屏。
   ⇒ **显示缓冲的每一个像素都出自引擎**。

**两种模式（同一场景、同一个 N，口径一致）**：
- `MODE_CPU(0)`：CPU 32bit 直写屏外缓冲画方块（擦旧+画新）→ 引擎整屏 COPY 到 FB。
- `MODE_HW(1)`：CPU 只下发 FILL 指令，引擎直接渲染到 FB。

**统计口径分开报，保证对比干净**：
- `CPU=%d`（R/S）= CPU **纯渲染**完成帧率（不含 COPY 等待）
- `SCR=%d`（S/S）= **实际上屏**帧率（CPU 模式下 = COPY 完成数；硬件模式下 = 引擎完成帧数）
- 另每 10 次统计打一条 `D ... SC=%x ab= un=`（扫描输出欠载/中止计数，来自寄存器 0x20）

**双缓冲为什么必要**：整屏 COPY 实测约 1.89M 周期 ≈ 19ms（≈53fps 上限）。若单缓冲串行
"画完再搬"，CPU 模式帧率会被 COPY 压到 30 多 fps，掩盖真实差异；双缓冲让 COPY 与渲染重叠后，
CPU 侧报出的就是它自己的渲染速度。

**按键**（低有效，软件消抖：连续 3 次读到同一电平才认，取下降沿）：
`soc_gpio[0]`=GPIOR_22 切模式 / `soc_gpio[1]`=GPIOR_21 N+25 / `soc_gpio[2]`=GPIOL_03 场景复位。
串口备用：`m` 切模式 / `n` 或 `+` N+25 / `-` N-25 / `r` 复位。

**编译**：本机用厂商 makefile（`riscv-none-elf-gcc`，`-Wall -Wextra`）构建，
**comptest.c 自身 0 告警**，RAM 25,808B / 124KB，bin 8,906B。
格式串已全文体检：**无 `%u`、无宽度数字、无 `%%`**（mini-printf 只认 `%c %s %d %X %x`）。

**⚠️ 待上板验证**：本轮未上板（RTL 改了需要重新 P&R）。要不要保留"开机分阶段自检"这类
诊断代码由使用方决定 —— 当前版本已把诊断精简为每 300ms 一行 `S` + 每 3s 一行 `D`。

### 18.6 首次上板（16:52）结果：放大生效了，但暴露出两件事

日志：开机 banner → `selfcheck: STATUS=0000000a COUNT=0 SCAN=00000105 UST=00800000 URO=0 KEY=00000007`
之后**再无输出**；画面**铺满全屏**（说明 2 倍放大生效 ✓）、但**静止**、信息栏**乱码**。

**① `KEY=00000007` = 按键改脚成功** —— 三位都读到高（未按，板上有上拉）。
改脚前是 `0x08`（够不到的悬空脚）。⇒ §18.4 的引脚改动在电气上是对的。

**② 信息栏乱码 = 我引入的真 bug：32bit 写像素时高低半字放反了。**
帧缓冲是**小端**：32bit 存储的**低 16 位落在低地址 = 左边的像素**。`cpu_osd_text` 第一版
把第 1 个像素（字模 bit7）放进了**高**半字，于是每个字里的两个像素被**对调**，字形碎成
2 像素一块 ⇒ 屏上就是乱码。（旧的逐像素 `wr16` 版本没有这个问题。）
**修法**：`p[0]` 低半字放 bit7、高半字放 bit6；`p[1]` 低 bit5 / 高 bit4；`p[2]` 低 bit3 / 高 bit2；
`p[3]` 低 bit1 / 高 bit0。

**③ 画面静止 = v1.0 扫描输出的固有行为，回退 V1.0 并不能消除它。**
v1.0 的取数 FSM **唯一出口**是"收满 120 拍"，没有超时；一旦某行收不齐就永远停在 `S_FETCH`、
`s_hold` 恒高 ⇒ 读仲裁器永不归还读通道 ⇒ CPU 的下一次 DDR 读（取指或 `.bss`）永久挂起。
**整份程序都在 DDR 里（linker: ORIGIN=0x1000, 124K）⇒ 整机静止、串口再无输出。**
这**不是**本轮改动引入的：§17 已经用分段自检证明过（只碰 MMIO 的循环能跑满 1 秒 62 万圈，
一碰 DDR 就死），当时给出的看门狗/退避就是为它写的。回退 V1.0 后问题原样复现，
反过来证明"卡死与 §17 的 RTL 改动无关，是 v1.0 自身的鲁棒性缺口"。

### 18.7 本轮修复：把 §17 的看门狗/排空/退避**合并**到 V1.0+1080p 之上

保留 §18 的回退基线（V1.0）与放大，另加回三件**有界化**（TB 逐条盯，见 §17.4/§17.8）：

| 机制 | 作用 |
| --- | --- |
| `S_FETCH` 看门狗 `FETCH_TO`(4096) | 取数收不齐到点转 `S_DRAIN`，FSM 不可能永久停在 `S_FETCH` |
| `S_DRAIN` 排空 `DRAIN_TO`(4096) + rlast 计数 | 保持 `rready=1`/`s_hold=1` 把已下单突发收干净，**确保交还通道时没有在飞 R 拍**（不会错路给 CPU）；超时才硬放弃并 `dbg_abort++`，同时清 `ar_idx/burst_done` 让 `s_hold` 立刻落下 |
| **`S_BACKOFF` 强制退避 `BACKOFF_TO`(4096)** | 硬放弃后 `s_arvalid=0`/`s_hold=0` 这么久 ⇒ **通道必然回到 CPU**。占用率上限 = 8192/12288 ≈ **67%** ⇒ CPU 至少拿到 1/3 读带宽，最坏只是"慢"，**绝不会"死"** |

外加：`m_axi_hold` 由"整行取数中"改为按**突发**（`ar_idx != burst_done`），与仲裁器的
`cnt_s`（AR 握手 − rlast）粒度一致。

**验证（两块 TB 同时守，13/13 ALL PASS）**：
- `tb_scanout_wd`：`hold_max=132`（有界）、`hold_min(超时驱动)=132`（排空真的等）、
  `hold low after abort=983`（**退避真的生效**）、2 次硬故障各记一次 `dbg_abort`、
  故障后继续取到 11 行（自恢复）；`-DWD_OFF` 反向验证 → FAILED。
- `tb_scanout_scale`：横向 0 错误、纵向"重复 20 / 前进 19"、**DE 期间黑像素 0**。
- `tb_fb_scanout` 显式 `SCALE_SH(0)` 继续守"不放大"旧路径。

**软件**：修掉 OSD 高低半字，`comptest.c` 重新构建 **0 告警**（RAM 25,856B/124KB）。

**上板要看的两件事**：
1. 画面是否**动起来**、串口是否持续出 `S`/`D` 行；
2. `D` 行里的 **`ab=`**（= 寄存器 0x20 高 16 位 = 硬放弃次数）。若它一直不涨，说明这条通路
   本来就没出问题（卡死另有原因）；若它偶发上涨但画面/串口继续跑，说明**看门狗+退避正在救场**，
   代价是那几行画面欠载 —— 这正是设计预期。

### 18.8 ★ 整机卡死的真正根因：读仲裁器 `cnt_s` 泄漏具有**永久否决权**（已复现+已修）

**板级证据（17:06 日志）**：`selfcheck: ... SCAN=00070108 ...` —— 高 16 位 = `dbg_abort = 7`
（看门狗在自检阶段就放弃过 7 行取数），紧接着 CPU 就彻底死了、画面停在最后一帧。

**机制（链条完整闭合）**：
1. CPU 持续写 DDR ⇒ 扫描输出某行取数收不齐 120 拍；
2. 看门狗超时 → `S_DRAIN` → 硬放弃：**扫描输出清的是它自己的账本**
   （`ar_idx/burst_done=0` ⇒ `s_hold` 落下），可那笔突发的 AR 在仲裁器里**早已计入 `cnt_s`**，
   而对应的 rlast **永远不会来了**；
3. 归还条件是 `cnt_s==0 && !s_arvalid && !s_hold` ⇒ `cnt_s` 永不归零 ⇒ **被永久否决**；
4. `owner` 永远停在 1（扫描输出）⇒ **CPU 再也拿不到 DDR 读通道**；
5. 本工程整个程序都在 DDR 里（linker: ORIGIN=0x1000, 124K）⇒ 取指都取不到 ⇒
   **整机静止、串口再无输出**；而扫描输出仍在正常扫描 ⇒ 屏幕停在最后一帧。

**关键点：上一版看门狗只关掉了 `s_hold` 这道闸门，`cnt_s` 那道闸门还锁着** ——
这正好解释了"看门狗已生效（`abort=7`）却仍然卡死"。

**修复（`axi_rd_arb.v`，新增 `LEAK_TO` 参数，默认 256 拍）**：
```verilog
wire s_quiet = !s_arvalid && !s_hold;      // s 侧自称"搬完了、也没有新 AR"
if (s_quiet && (cnt_s != 8'd0)) leak_c <= leak_c + 1; else leak_c <= 0;
if (s_quiet && ((cnt_s == 8'd0) || (leak_c >= LEAK_TO)))  owner <= 1'b0;
```
`s_hold` 的语义是"有一笔突发真在飞"，它为假就不可能有属于 s 侧的 R 拍再来 ⇒ 换手不会错路；
`cnt_s` 从此只作优化、**不再具备永久否决权**。LEAK_TO=256 拍（2.5us）：正常一笔突发收完只要
几十~几百拍，而 `s_quiet` 为真时本就不该有在飞突发，所以 256 拍足够区分"泄漏"与"正常"。

**验证（新增 `ARC_2DRA/rtl/video/tb/tb_rd_arb_leak.v`，精确模拟板级现场）**：
S 侧发一笔 AR、只收 2 拍就把 `s_hold` 放下（= 看门狗放弃本行），从机给 S 那笔**永不拉 rlast**；
C 侧持续请求读，统计完成笔数。

| 指标 | 修复后（LEAK_TO=256） | A/B（无兜底） |
| --- | --- | --- |
| `cnt_s`（内部） | **1（泄漏确实存在、永不归零）** | 1 |
| `owner`（内部） | **1 → 0**（`leak_c=257` 触发兜底） | **永远停在 1** |
| C 侧完成读突发 | **57,105 笔**，最长 AR 等待 **263 拍** | **0 笔（一拍都没收到）** |
| 判决 | **ALL PASS** | **FAILED** |

**板级"整机静止"在仿真里被完整复现，修复也被验证**；CPU 每次泄漏事件的最坏锁定时间
= LEAK_TO ≈ 263 拍 ≈ 2.6us（有界、无害）。

**TB 踩坑**：`28'h010_0000` 是 **bit20** 而不是 bit24，导致从机把 S 那笔当 C 的回满并拉了 rlast，
泄漏复现不出来（第一版 A/B 两边都 PASS）。定位手段是给 `cnt_s`/`owner` 加变化监视器 ——
**"A/B 没差异"时不要改结论，要查激励是不是真的制造出了要测的场景。**

**回归：14/14 ALL PASS**（新增 `tb_rd_arb_leak`）。

---

## 19. 写提交顺序修复：指令边界写屏障（`b_pending` + wd FIFO 真空）（本轮）

### 19.0 结论速览

| 项 | 结论 |
| --- | --- |
| 上板症状 | 驱动背靠背下发多条**写重叠区域**的指令时，重叠处 z 序高频闪/换；每条指令后软件等一次引擎 IDLE 症状就完全消失 |
| 排查结论 1（结构性事实） | **写主机同一时刻只可能有 1 笔写突发在飞**。`axi_wr_master` 是 AW→W→B 串行：`S_AW→S_W→S_B→S_IDLE`，只有收到 B 才回 `S_IDLE`（`wd_busy` 才落），下一笔 AW 至少要再隔 1 拍；突发顺序 = wd FIFO 弹出顺序 = **程序顺序**。写仲裁器 `ARC_2DRA/rtl/video/axi_wr_arb.v` 是纯组合直通（无 skid、无 FIFO），只在 `cnt_b==0 && !b_wvalid` 时换 owner。→ "两条指令的 AW 同时在飞导致 DRAM 提交乱序"在这份 RTL 里**不可能发生** |
| 排查结论 2（真根因） | **"完成"判据是假的**：引擎 `ST_WDWAIT` 的出口是 `wd_empty && !wd_busy`，而 `sync_fifo.empty = !out_v`（同步读 + 输出寄存器），最后一个写词推进 FIFO 后要 **2~3 拍**才在 `out_v` 上可见 —— 这段窗口里 `empty=1`（**假空**）。于是引擎报 IDLE / `STATUS.BUSY=0` 时，**最后一个写词还躺在 FIFO 里、连 AW 都还没发出去**；软件 `blt_idle()` 却当成"像素已落 DDR"，而下一条指令的读（ALPHA/KEY 的 dst、COPY 的 src）会跑在上一条指令的写前面 → **写后读（RAW）危险** → 重叠处混到旧背景，屏幕上就是"层级被换掉"的闪烁 |
| 修复 | 指令边界写屏障：`axi_wr_master` 新增 `b_pending`（AW 受理 +1 / B −1）与 `wr_idle_committed`；`blt_top` 合成 `wr_commit_idle = wr_idle_committed && (wd_count==0) && !wd_busy`（并接上 `u_wd_fifo.count`）；`blt_engine_fsm` 的 `ST_WDWAIT` 出口与 `done_out` 都并上它 |
| 新测试台 | `rtl/tb/tb_wr_order.v` + 新从机模型 `rtl/tb/axi_slave_mem_ord.v`（**B 在真正提交那一拍才回；读只能看见已提交数据**），已加入 `run_regress.ps1`（含 `-DBLT_WR_ORDER_OFF` 的 A/B 对照项） |
| A/B | 屏障 OFF（= 旧行为）：T1/T2/T2b FAIL，117 次"完成"里有 **55 次写通路未清**；屏障 ON：ALL PASS、**0 次未清** |
| 吞吐代价 | 只在**命令尾部**多等一次"最后写词 → AW/W → B"：32x32 FILL（写回延迟 2 拍）1333 → 1335 周期（+2）；1 个写词的小指令 31 → 39（B=2）/ 31 → 69（B=32）；写通路本来就饱和时（B=128）**0 代价**。指令内部的突发照旧与行计算重叠，**没有逐像素串行** |

### 19.1 为什么"两笔写突发同时在飞"在本 RTL 里做不到（代码证据）

| 证据 | 位置 | 事实 |
| --- | --- | --- |
| 写主机串行 | `rtl/axi_wr_master.v:85-101` | `S_AW`（发 AW）→ `S_W`（发 W 拍）→ `S_B`（等 B）→ `S_IDLE`；`S_B` 只在 `m_axi_bvalid && m_axi_bready` 时回 `S_IDLE` |
| `wd_busy` 口径 | `rtl/axi_wr_master.v:55` | `wd_busy = (st != S_IDLE)` —— "非空闲"包含等 B |
| AW 一次一笔 | `rtl/axi_wr_master.v:114` | `m_axi_awvalid = (st == S_AW)`，只有一笔突发在收集完（`burst_len` 到齐/断开）后才进 S_AW |
| 弹出即程序序 | `rtl/axi_wr_master.v:109-112` | `wd_pop` 只在 `S_IDLE`（取首词）或 `S_BUF`（合并相邻词）拉高 → 突发序 = FIFO 序 |
| 仲裁器直通 | `ARC_2DRA/rtl/video/axi_wr_arb.v:95-114,128-130` | 无 skid/FIFO；`c_awready/b_awready` 由 owner 分路；1→0 归还要 `cnt_b==0 && !b_wvalid` |
| 引擎侧 | `rtl/blt_engine_fsm.v` `ST_WDWAIT` | 出口要求 `!wd_busy`，即"上一笔突发已收到 B" |
| 设计日志旧结论 | 本文档 §12.2 A3 | "真实 `axi_wr_master` 是 AW→W→B 串行、B 之后至少隔 1 拍才发下一笔 AW，实测踩不到" |

**新 TB 的实测印证**：`tb_wr_order` 的 H2 项统计整场仿真里写突发在飞峰值 = **1**（RTL `b_pending` 与 TB 在 AXI 引脚上数的 AW−B 完全一致）。

### 19.2 真根因的逐拍时间线（`sync_fifo` 的"假空"窗口）

以"一条只写 1 个 16B 词的 FILL"为例（`wd_wr` 与 `pp_row_done` 同拍）：

| 拍 | sync_fifo 内部 | `empty=!out_v` | 引擎 | 写主机 |
| --- | --- | --- | --- | --- |
| T | `do_wr`：`mem[wptr]<=data` | 1（还是"空"） | 最后一拍 EXEC（`pp_row_done`） | S_IDLE |
| T+1 | `mcnt=1` → `fetch` 发起 BRAM 读 | 1（**假空**） | `RS_DRAIN` | S_IDLE（看不到词） |
| T+2 | `rd_pend=1`，数据在飞 | 1（**假空**） | `ST_WDWAIT` 采样 → 条件成立 | S_IDLE |
| T+3 | `take` → `out_v=1` | **0**（这一刻才可见） | **st→IDLE、BUSY=0** | 下一拍才 pop |
| T+4..T+6 | — | 0 | （下一条指令开始 pop/取数） | `S_BUF→S_AW→S_W` 才把词发出去 |
| T+7+B | — | 0 | — | 收到 B（`b_pending` 才回 0） |

也就是说：**`BUSY=0` 比"这个词被 AXI 受理"早了 3~4 拍，比"内存系统受理（B）"早了一次写往返**。
软件按 `BUSY` 判定完成 → 下一条指令的 dst/src 读会抢在前面（RAW）→ ALPHA 混到旧背景、KEY 的键比较用到旧值 → 重叠处看起来"层级闪/换"。

### 19.3 改动清单

| 文件 | 行（改后） | 内容 |
| --- | --- | --- |
| `rtl/axi_wr_master.v` | 头部注释 + 端口 `b_pending[4:0]`/`wr_idle_committed`（约 21-40 行）；新增逻辑在 `wd_busy` 之后（约 66-83 行） | `b_pending`：`aw_hs` +1、`b_hs` −1（带 0 保护，防 B 错路时回绕成 31）；`wr_idle_committed = (b_pending==0) && (st==S_IDLE)` |
| `rtl/blt_top.v` | 线网声明（约 84-89 行）、`u_wd_fifo` 的 `.count(wd_count)`（约 159 行）、新增 `wr_commit_idle`（约 162-179 行）、`u_wr`/`u_eng` 例化 | 接出 `wd_count`（**真占用** = mcnt + 在飞 + out_v）、`wr_b_pending`、`wr_idle_committed`；合成 `wr_commit_idle`；`ifdef BLT_WR_ORDER_OFF` 时把它强行置 1（= 旧行为） |
| `rtl/blt_engine_fsm.v` | 头部注释 §4（约 25-33 行）、新端口 `wr_commit_idle`（约 52 行）、`done_out`（约 190 行）、`ST_WDWAIT`（约 375 行） | 完成判据 = 原条件 **&& `wr_commit_idle`**；`ST_WDWAIT` 出口 = `wd_empty && !wd_busy && wr_commit_idle` |
| `rtl/tb/axi_slave_mem_ord.v`（新） | — | 写提交可乱序的从机模型：AW/W 进 WBUF 深写缓冲，按各自 `ctime` 提交，**B 在提交那一拍才回**；读只看已提交数据 |
| `rtl/tb/tb_wr_order.v`（新） | — | H1/H2 洞统计与在飞峰值 + T1（IDLE 当拍即提交）+ T2/T2b（FILL→COPY / ALPHA(α=0) 的 RAW）+ T3（重叠 FILL 的 WAW）+ T4a~d（吞吐 A/B） |
| `rtl/tb/run_regress.ps1` | 29-30、33-64 行 | 新增 `tb_wr_order` 与 A/B 对照项 `tb_wr_order_off`（`-DBLT_WR_ORDER_OFF`，**预期失败**才算通过）；表项新增 `m=`（顶层名）/`d=`（编译参数）/`x=`（预期失败）字段 |

> 软件无需任何改动：命令集/编码、寄存器映射、BUSY/DONE 语义（只变强不变弱）都没动；
> 唯一的行为差别是 **`STATUS.BUSY=0` 现在真的等于"本条指令的写已被内存系统受理"**。
> `-DBLT_WR_ORDER_OFF` 只用于 A/B 演示（默认不定义 = 屏障生效）。

### 19.4 A/B 与吞吐实测（原始输出）

`iverilog -g2001 -s tb_wr_order -o on.vvp <acc> rtl/tb/axi_slave_mem_ord.v rtl/tb/tb_wr_order.v; vvp on.vvp`（OFF 组加 `-DBLT_WR_ORDER_OFF`）

| 判据 | 屏障 ON（默认） | 屏障 OFF（旧行为） |
| --- | --- | --- |
| H1 完成时写通路未清次数 | **0 / 117** | **55 / 117**（`wd_occ=1 wr_st=0 未回B=0`） |
| T1 IDLE 当拍 mem 已是本条颜色 | PASS | **FAIL**（读到旧值 `1111`） |
| T2 FILL→COPY（src 读刚写的字） | PASS | **FAIL**（COPY 到 `0000`，旧值） |
| T2b FILL→ALPHA(α=0)（dst 读刚写的字） | PASS | **FAIL**（读到旧 dst `4444`） |
| T3 重叠 FILL 的 WAW（排空后看最终像素） | PASS | PASS（**说明写通道本身本来就是程序序**，问题不在 WAW） |
| H2 写突发在飞峰值 | 1 | 1 |
| T4a 16×FILL 32x32，写回延迟 2 拍 | 1335 周期/条 | 1333 周期/条（**+2**） |
| T4b 16×FILL 32x32，写回延迟 128 拍 | 20776 | 20776（**0**，写通路本来就饱和） |
| T4c 16×FILL 8x1（尾部写通路空）B=2 | 39 | 31（**+8**） |
| T4d 同 T4c，B=32 | 69 | 31（**+38 ≈ 一次 B 往返**） |

结论：**代价 = 命令尾部一次写往返**，与"每条指令多等一次 B"的预期一致；指令内部的写突发
仍然在行计算期间并发发生（T4a 只 +2、T4b +0 就是证据），**没有把像素串行化**。

### 19.5 复现命令

```powershell
$env:PATH = "C:\oss-cad-suite\bin;C:\oss-cad-suite\lib;$env:PATH"
$acc = "rtl/sync_fifo.v rtl/cmd_fifo.v rtl/blt_regs_axi_lite.v rtl/blt_addr_gen.v rtl/axi_rd_master.v rtl/axi_wr_master.v rtl/stream_reader.v rtl/pixel_path.v rtl/blt_engine_fsm.v rtl/blt_top.v"
# B 组（屏障生效）
iverilog -g2001 -s tb_wr_order -o on.vvp  $acc rtl/tb/axi_slave_mem_ord.v rtl/tb/tb_wr_order.v; vvp on.vvp
# A 组（关屏障，应复现旧 bug）
iverilog -g2001 -DBLT_WR_ORDER_OFF -s tb_wr_order -o off.vvp $acc rtl/tb/axi_slave_mem_ord.v rtl/tb/tb_wr_order.v; vvp off.vvp
# 全量回归（含 A/B 对照项）
powershell -NoProfile -ExecutionPolicy Bypass -File rtl/tb/run_regress.ps1
```

### 19.6 残余风险 / 不确定度

1. **B 是唯一可用的排序原语**：本修复把"命令 k+1 的写与读不得早于命令 k 的写被内存系统受理"
   变成硬件保证；若 DDR 控制器在回 B 之后仍会打乱**已受理未落 DRAM** 的写提交顺序，那 RTL 侧
   无法再进一步（只能读回校验）—— 但那种控制器会连 CPU 的一致性一起破坏，且软件"每条指令等
   IDLE"的偏方也不可能稳定生效，所以本假设与现场证据一致。
2. **若以后按 §12 C5 的建议把写主机改成 AW 流水**（用 `wd_count` 判真空换取 16 拍合并突发），
   屏障里的 `b_pending==0` 就从"冗余保险"变成**必需项**（那时才真的会有两笔在飞）。
3. **时序/资源**：新增的是一个 5bit 计数器、一个 5 输入比较和几个与项，无新跨模块宽总线；
   `wr_commit_idle` 只进引擎的 `ST_WDWAIT`/`done_out` 两个组合项，扇出极小。未跑 PnR（按要求）。
4. **回归**：`run_regress.ps1` 全绿（见 §19.4 与脚本输出），新增的 A/B 对照项按"必须失败"判定。

## 20. 上屏方式改造：整屏 COPY → 显示缓冲 FLIP（ping-pong + 帧边界锁存基址）（本轮）

### 20.0 结论速览

| 项 | 结论 |
| --- | --- |
| 动机（板级实测） | 整屏 COPY（960×540 RGB565，`blt_copy_full(FB_BACK, FB_BASE)`）≈ **707k core 周期 = 7.1ms**，占 60Hz 帧预算（1.667M 周期）的 **42%**；区域重铺 568k、单块 947(FILL)/2169(ALPHA)/1741(KEY)。把 COPY 去掉后内容预算约 **2.8 倍** |
| 做法 | 双缓冲本来就不需要搬像素 —— **换一个显示基址**即可。`fb_scanout` 新增 `FB_BASE1` 参数与 `fb_sel`(请求)/`fb_cur_sel`(已生效)/`frame_cnt`(场计数) 三个端口；加速器寄存器块新增 `0x24 FB_SEL`(W) / `0x28 FB_STAT`(R)，顶层点对点连线（**不动 Interface Designer / SoC IP**：两个例化都在 `ddr3_example_top.v` 里） |
| "绝不混帧"的硬保证 | 两级独立保护：① 请求在 **pclk 域只在帧边界**（`hcnt==0 && vcnt==V_ACTIVE`）被采样进 `fb_sel_lat`；② 采样值同步回 core 域后**只在取数趟边界**（`st==S_IDLE && next_y==0`）提交成 `fb_cur_sel`，而取数地址 `cur_addr` 只用 `fb_cur_sel` 算 ⇒ **一趟取数（= 一场的 540 行）基址恒定**，显示侧行缓冲乒乓 + "最多超前 1 行"⇒ 一场显示的行必来自同一趟 ⇒ 结构上不可能拼出混帧 |
| 新测试台 | `rtl/tb/tb_scanout_flip.v`（两个缓冲用可辨认像素编码 `{缓冲标签7bit,行4bit,列5bit}`，14+21 次故意挑位置的翻转请求：场中途/行中途/行末/帧边界前 1 个 core 拍/边界刚过/一场连改 4 次），已加入 `run_regress.ps1`（含 `-DFLIP_UNLATCHED` 的 A/B 对照项） |
| A/B | 锁存生效（默认）：**ALL PASS**，混帧 0/0/0，翻转生效延迟恒 **4 core 拍**；锁存旁路（`-DFLIP_UNLATCHED`）：**FAILED**，取数层混帧 4 次、趟基址错 6 次、显示层混帧 1 场、显示错缓冲 6 场 |
| 软件 | `FinalDemo.c` 新增编译期开关 **`FB_FLIP_PUBLISH`（默认 0 = 关，保持整帧 COPY 路径不变）**；`-DFB_FLIP_PUBLISH=1` 时一趟画完写 `FB_SEL`、轮询 `FB_STAT` 有界等待、确认即 `scr_frames++`，**该路径一次整屏 COPY 都不做** |

### 20.1 寄存器（扩展，不重编号任何旧寄存器）

| 偏移 | 名字 | 属性 | 位域 | 语义 |
| --- | --- | --- | --- | --- |
| `0x24` | `FB_SEL` | W（读回=待生效请求，仅供调试） | bit0 | 希望扫描输出显示哪块缓冲：`0`=FB_BASE(0x301000)、`1`=FB_BASE1/FB_BACK(0x501000)。**写下去只是请求**，扫描输出在下一个帧边界锁存 |
| `0x28` | `FB_STAT` | R | bit0 | `fb_cur_sel` = **已经生效**的显示缓冲选择（软件据此确认翻转已生效） |
| `0x28` | `FB_STAT` | R | `[31:16]` | `frame_cnt` = 扫描输出场计数，每个帧边界 +1（@60Hz 约 1092s 回绕）；软件也可以用它把节奏锁到真实场频 |
| `0x28` | `FB_STAT` | R | `[15:1]` | 恒 0（保留） |

两个字段都直接来自 `fb_scanout` 的 **core 域寄存器**，软件经 APB/AXI-Lite 直接读，**没有跨域采样问题**。
旧的 `0x00~0x20` 全部保持原位（`tb_regs_axi_lite` 新增 7 条断言盯这两个寄存器）。

### 20.2 为什么不会混帧（逐条对应代码）

| 环节 | 位置 | 事实 |
| --- | --- | --- |
| 请求跨域 | `fb_scanout.v` FLIP 一节 | `fb_sel`（core 域，来自寄存器 0x24）→ `fb_sel_p0/p1` 两级同步进 pclk 域 |
| 保护①：帧边界锁存 | 同上 | `if (hcnt==0 && vcnt==V_ACTIVE) fb_sel_lat <= fb_sel_p1;` —— 与 `frame_tgl_p`、`cons_p` 用的是**同一个时刻**（垂直消隐起点）。帧中途改请求，本场看不到 |
| 回 core 域 | 同上 | `fb_sel_lat` → `fb_lat_c0/c1` 两级同步 |
| 保护②：趟边界提交 | 同上 | `pass_start = (st==S_IDLE) && (next_y==0)`；`next_y` 只在 `frame_rst`/复位时归零、每取一行 +1 ⇒ 这个窗口正好是"本趟一行都还没取"。只有此刻才 `fb_cur_sel <= flip_sel_eff` |
| 基址只由已提交值算 | `fb_scanout.v:434` | `cur_addr <= cur_base + (next_y*FB_STRIDE)`，`cur_base = fb_cur_sel ? FB_BASE1 : FB_BASE` ⇒ **整趟基址恒定** |
| 显示侧不会跨趟拼帧 | 原有的行缓冲乒乓 + 超前 1 行门控 | 一场显示的行 = 同一趟取数写进两个行缓冲的内容（≤1 行超前）；同趟基址恒定 ⇒ 该场只来自一个缓冲 |
| 帧计数 | `fb_scanout.v:397-400` | `frame_cnt` 在 core 域按已同步的 `frame_rst`（每场恰好 1 拍脉冲）累加 ⇒ 每场恰好 +1 |

**边界语义（写清楚，免得误用）**：帧边界 = `vcnt==V_ACTIVE`（垂直消隐起点），**不是** `vcnt` 41→0 那种"场末"。
在边界前 **1~2 个 pclk 之内**改 `fb_sel` 属于竞态：两级同步使它**赶不上本次边界**，会在**下一次**边界生效
（`tb_scanout_flip` 专门造了这个用例：边界前 1 个 core 拍改值，本场仍锁存旧值 —— 检查项 (b) 就是盯它）。
两种落法都不会混帧，软件侧只需按"最多晚一场"来设计有界等待。

### 20.3 改动清单

| 文件 | 行（改后） | 内容 |
| --- | --- | --- |
| `ARC_2DRA/rtl/video/fb_scanout.v` | 头部注释 25-33；参数 `FB_BASE1` 38-41；端口 `fb_sel/fb_cur_sel/frame_cnt` 93-102；FLIP 逻辑 318-400；取数基址 432-434 | `FB_BASE1=0x501000`；帧边界锁存 + 趟边界提交 + 场计数；`cur_addr` 改用 `cur_base`。**没有**引入任何看门狗/排空/中止逻辑 |
| `rtl/blt_regs_axi_lite.v` | 注释 15-25；端口 72-75；写译码 104；落地 196-214；读 285-286 | 新增 0x24/0x28；旧地址一个都没动 |
| `rtl/blt_top.v` | 64-69、136 | 三个端口透传 |
| `ARC_2DRA/rtl/blt/blt_apb_top.v` | 73-77、215-217 | 三个端口透传（APB 桥本身不动） |
| `ARC_2DRA/rtl/ddr3_example_top.v` | 324-330、629-632、734-749 | `u_blt.fb_sel → u_fb_scanout.fb_sel`、`u_fb_scanout.fb_cur_sel/frame_cnt → u_blt`；`FB_BASE1` 参数。**两个例化都在本文件内 ⇒ 不需要改 SoC IP / Interface Designer** |
| `rtl/tb/tb_scanout_flip.v`（新） | — | 混帧/锁存点/场计数三组断言 + 翻转生效延迟统计；`-DFLIP_UNLATCHED` 时锁存被旁路（预期 FAILED） |
| `rtl/tb/tb_regs_axi_lite.v` | 49、69、217-233 | 新增 7 条断言：0x24 写→`fb_sel` 输出、0x28 的 bit0/[31:16]/[15:1] 位域与跟随输入 |
| `rtl/tb/run_regress.ps1` | 31-32 | 新增 `tb_scanout_flip` 与 A/B 对照项 `tb_scanout_flip_off`（`x=1`，**必须失败**才算通过） |
| 三个旧扫描输出 TB | `tb_fb_scanout.v:51`、`tb_scanout_scale.v:48`、`tb_scanout_wd.v:77`（`tb_scanout_bw.v:203`） | 新增端口必须显式接 `1'b0`（不接会悬空成 Z/X ⇒ 取数地址变 X；这是端口表变化唯一需要跟着改的地方） |
| `.../FinalDemo/src/FinalDemo.c` | 开关 96-125；FLIP 状态 127-136；工具函数 240-245；`blt_copy_full` 306-313；绘制目标全部改 `g_fb_back`（409/421/487/611-612/788-799/1052/1070/1074/1103/1109/1111/1139）；开机 780-831；发布 950-1010；信息条 1134-1143 | 编译期开关 + FLIP 发布路径 + 信息条跟随后台缓冲 |

### 20.4 仿真证据（原始输出）

```powershell
$env:PATH = "C:\oss-cad-suite\bin;C:\oss-cad-suite\lib;$env:PATH"
$src = "ARC_2DRA/rtl/video/fb_scanout.v ARC_2DRA/rtl/video/video_timing_1080p.v ARC_2DRA/rtl/common/simple_dual_port_ram.v rtl/tb/tb_scanout_flip.v"
iverilog -g2001 -s tb_scanout_flip -o on.vvp  $src; vvp on.vvp           # B 组：锁存生效（应 ALL PASS）
iverilog -g2001 -DFLIP_UNLATCHED -s tb_scanout_flip -o off.vvp $src; vvp off.vvp   # A 组：必须 FAILED
powershell -NoProfile -ExecutionPolicy Bypass -File rtl/tb/run_regress.ps1
```

| 判据 | 锁存生效（默认） | 锁存旁路（`-DFLIP_UNLATCHED`） |
| --- | --- | --- |
| (a) 一趟取数里混两个缓冲 | **0** | **4** |
| (b) 趟基址 ≠ 帧边界锁存值 | **0** | **6** |
| (c) 一场显示里混两个缓冲 | **0** | **1** |
| (c2) 一场显示的不是请求的缓冲 | **0** | **6** |
| `frame_cnt` 不是每场 +1 的次数 | **0** | 0 |
| 翻转生效次数 / 延迟(core 拍) | 6 / min 4, max 4, avg 4 | 14 / min 841, max 33590（乱） |
| 结论 | **ALL PASS** | **FAILED (4 项)** |

全量回归（18 项，含 2 个 A/B 对照项）：**`==== regress failures: 0 ====`**（`tb_scanout_flip ALL PASS`；
`tb_scanout_flip_off A/B OK: … FAILED (4 项)`）。

### 20.5 软件侧（默认关闭，现有 bitstream 不受影响）

- **开关名：`FB_FLIP_PUBLISH`**（`FinalDemo.c:119-121`，`#ifndef` 保护，默认 **0 = 关**）。
  关：`g_fb_back` 恒为 `FB_BACK`、发布仍是 `blt_copy_full(FB_BACK, FB_BASE)`，行为与改动前逐字节等价。
  开（`-DFB_FLIP_PUBLISH=1`）：
  1. 开机先读 `FB_STAT[0]` 对齐 `g_disp_sel`（不假设复位值，免得"不复位 FPGA 直接重跑"画错缓冲），后台缓冲 = 非显示那块；
  2. 一趟渲染完 → `blt_wr(BLT_FB_SEL, g_disp_sel^1)` 请求翻转；
  3. 每 4 圈轮询一次 `FB_STAT`（其余圈纯 ALU 退避），**有界超时 100ms**；超时就重发请求继续等 ——
     **绝不**退化成"往可能正在上屏的缓冲里画"（那会撕裂）。正常路径：帧边界后 ~4 个 core 拍就确认；
  4. 确认即 `scr_frames++`（与 COPY 路径同一个"已上屏"口径）、`g_fb_back` 切到另一块；
     `clear_pp=0` 时额外置一次 `repaint_hw/repaint_cpu`（`clear_pp=1` 每趟本来就整片重铺，不需要）；
  5. **该路径一次整屏 COPY 都不做**：连开机那次也去掉了，改成给显示缓冲补一次近黑铺底（一次性）。
- 信息条：内容变了（`g_osd_dirty`）或**当前后台缓冲还没画过**（`!g_bar_ok[]`）才重画 ⇒ 稳态每个缓冲每种内容只画一次；
  串口行为完全没动（**没有**恢复任何周期打印，只多了一行开机 `publish: FLIP/COPY ...` 与一次性的超时诊断行）。
- 编译（Efinity RISC-V IDE 工具链，`-Wall -Wextra`）：默认 **exit 0，FinalDemo.c 0 告警**，ram 57216 B(45.06%)；
  `-DFB_FLIP_PUBLISH=1` 同样 **exit 0，FinalDemo.c 0 告警**，ram 57552 B(45.33%)。
  （剩下的 14~15 条告警全部来自 BSP 头文件，与本次改动无关。）

### 20.6 残余风险 / 不确定度（P&R 相关，如实列出）

1. **新增两条单比特跨时钟路径**：`core(user_clk) → pclk(hdmi_tx_slow_clk)` 的 `fb_sel`、反向的 `fb_sel_lat`。
   都是 1 bit + 两级同步 + 边界采样，**没有多比特 CDC**（不需要握手/格雷码）。工程里本来就有
   `frame_tgl_p / cons_g / line_par_p / rdy_p` 同类路径，`ddr3.sdc` 也没有为它们加 `set_false_path`，
   所以本次沿用同一风格；若之后要收紧时序，应把这条（连同既有的几条）一起加进 SDC。
2. **扇出/组合深度**：`cur_base` 只喂 `cur_addr` 那一个 32bit 加法器，`fb_cur_sel/frame_cnt` 各只进一个寄存器；
   新增逻辑 ≈ 5 个触发器 + 一个 32bit 二选一。资源/时序影响都在噪声级。**未跑 Efinity 综合/P&R（按要求）**。
3. **翻转生效的最坏时延**：若帧边界那一刻取数 FSM 恰好不空闲（DDR 卡顿把某行拖到消隐期），
   `frame_rst` 对 `next_y` 的清零会被跳过，该场不提交，**下一场边界**才生效（最多晚 1 场 ≈ 16.7ms）。
   软件的有界等待（100ms）能兜住；这段时间屏幕保持上一帧，**不会撕裂**。
4. **软件假设**：确认翻转 = `FB_STAT[0]` 变成请求值。它由扫描输出在帧边界锁存、4 拍后可见，
   而该场第 0/1 行在垂直消隐期就已按新基址预取 ⇒ "确认"与"这一帧在屏上"是同一件事。
   若某个 bitstream 里消隐期短到预取不完第 0/1 行，屏幕顶部可能出现 1~2 行上一帧内容 ——
   这属于扫描输出原有的欠载行为（`SCAN_DBG(0x20)[15:0]` 会计数），1080p 的 45 行消隐期余量充足。
5. **DDR 可见性沿用既有假设**：引擎写（等 B）之后扫描输出才可能读到新缓冲；"B = 已被内存系统受理"
   这一条与整帧 COPY 路径完全同源（§19 的结论），没有引入新的排序假设。

## 21. 性能包 (4)+(1)：三缓冲 FLIP + 帧边界中断 + 并发清屏引擎（本轮）

### 21.0 结论速览

| 项 | 结论 |
| --- | --- |
| 动机 | 双缓冲只有两块 ⇒ "画 B 时不能清 C"。整片重铺 568,000 周期由 BitBlt 当**普通 FILL 指令**执行 ⇒ 顶住整条指令流的完成时刻（= 60Hz 帧预算 1,666,667 的 34%）。三缓冲 + 独立写主机才能把清屏**挪出关键路径** |
| 功能 (4) 三缓冲 | `fb_sel`/`fb_cur_sel` 1 bit → **2 bit**（0/1/2 三块，3 保留）；基址由 `FB_BASE/FB_BASE1/FB_BASE2` 三个参数经 `base_of_sel()` 查表（**不写死地址**）；两级保护（帧边界锁存 + 趟边界提交）**结构与采样点一字未改**，"绝不混帧"的论证完全不变 |
| 功能 (4) 多比特 CDC | 2 bit 不能直接两级同步（两位同时变会采出第三种码）⇒ 两个方向都改走**格雷码**（`bin2gray2`/`gray2bin2`），相邻选择只差 1 位，锁存到的必然是"旧值或新值"；只有进 `fb_cur_sel` 前才还原成二进制 |
| 功能 (4) 帧中断 | 新端口 `frame_pulse`（core 域，每场**恰好 1 拍**，= 已有的 `frame_rst` 寄存一拍）→ 中断块 **`IRQ_STATUS[1]`（0x10，W1C）= FRAME**、**`IRQ_EN[1]`（0x14）= FRAME 使能**；`irq_done` = 两位状态或（FRAME 默认关 ⇒ 默认行为不变） |
| 功能 (1) 清屏引擎 | 新模块 `rtl/clr_engine.v`（300 行）：独立写主机，逐拍产 1 个 128bit 词（8 像素），**合并成 16 拍 INCR 突发**；数据是常量色（不需要 bdata 数组），两级流水（构建银行 + 发送引擎，产词与发送重叠），每拍各自的 WSTRB 各存一份 16 深小数组 |
| 功能 (1) 写通道共享 | 复用 `axi_wr_arb`：**BitBlt 侧接 `c_`（默认 owner/直通），清屏引擎接 `b_`（次级）** ⇒ 规则一句话"**BitBlt 赢，清屏引擎只填空闲档**"。清屏引擎从不启动时 `awvalid` 恒 0 ⇒ owner 恒不切换，**BitBlt 写通路与改动前逐位相同** |
| ★ 硬件互斥 | 目标缓冲 `CLR_CTRL[3:2]` == `fb_cur_sel`（正在显示）或 == `DRAW_SEL`（BitBlt 正在画）⇒ **拒绝写**：GO 时刻不发任何 AW/W + 置 ERR（sticky）；运行中每个词再判一次，被抢则停发新词、**把已组好的那一笔按 AXI 规范发完**（≤16 拍 = 256 B）、置 ERR、**不置 clean** |
| 功能 (1) 吞吐 | 整片 960×524 清屏：**62880 个 128bit 词 = 3930 笔 AW**（理论值 62880/16 = 3930，TB 直接断言）。两级流水（产词/发送重叠）⇒ 1 beat/cycle 从机 **90,410 周期 = 5.56 像素/周期**；1 beat/4cycle（≈4 B/cycle）从机 **267,260 周期 = 1.88 像素/周期**（≈2 px/cycle 目标，对照命令式 568,000 周期快 2.12 倍） |
| 新测试台 | `rtl/tb/tb_scanout_flip.v`（扩到三缓冲：任意两两互切 + 帧脉冲宽度/个数）、`rtl/tb/tb_clear_engine.v`（新：吞吐/AW 合并/内容/互斥/仲裁 + `-DCLEAR_MUTEX_OFF` A/B）；都在 `run_regress.ps1` 里 |
| 软件开关 | `FB_TRIPLE_BUFFER`（**默认 0**）三缓冲轮转 + 清屏引擎；`FB_IRQ_PACING`（**默认 0**）帧边界中断节拍。两个都默认关 ⇒ **默认构建与改动前只差一条指令**（见 21.7） |

### 21.1 寄存器（**扩展，不重编号任何旧寄存器**）

| 偏移 | 名字 | 属性 | 位域 | 语义 |
| --- | --- | --- | --- | --- |
| `0x10` | `IRQ_STATUS` | R/W1C | bit0 | DONE（原有） |
| `0x10` | `IRQ_STATUS` | R/W1C | **bit1** | ★**FRAME**：扫描输出帧边界脉冲（每场 1 个 core 拍）且 `IRQ_EN[1]=1` 时置位；写 1 清 0（与 bit0 各自独立） |
| `0x14` | `IRQ_EN` | RW | bit0 / **bit1** | DONE 使能（原有）/ ★FRAME 使能（新）。★`CTRL.bit1`（0x00）**只动 bit0**，不会把 FRAME 使能冲掉 |
| `0x24` | `FB_SEL` | W（读回=待生效请求） | **[1:0]** | 请求显示的缓冲：`0`=FB_BASE(0x301000)、`1`=FB_BACK(0x501000)、`2`=FB_BUF2(0x701000)、`3`=保留（扫描输出回落到 0） |
| `0x28` | `FB_STAT` | R | **[1:0]** / `[31:16]` | 已生效的显示缓冲 / 场计数；`[15:2]` 恒 0 |
| `0x2C` | `CLR_ADDR` | RW | `[31:0]` | 清屏起始**字节**地址（读回 = 已写入值，便于自测） |
| `0x30` | `CLR_STRIDE` | RW | `[31:0]` | 字节/行 |
| `0x34` | `CLR_WH` | RW | `[15:0]`=w `[31:16]`=h | 矩形宽高（像素） |
| `0x38` | `CLR_COLOR` | RW | `[15:0]` | RGB565 常量色 |
| `0x3C` | `CLR_CTRL` | W | bit0 / `[3:2]` / bit4 | bit0=**GO**（1 拍脉冲）；`[3:2]`=**目标缓冲号**；bit4=**ERR_CLR**（1 拍脉冲，清 sticky ERR）。bit1 保留 |
| `0x40` | `CLR_STAT` | R | bit0 | **BUSY**（GO 被受理 → 最后一笔 B 回来） |
| `0x40` | `CLR_STAT` | R | bit1 | **目标缓冲已清干净**（= clean 位图里 `CLR_CTRL[3:2]` 那一位） |
| `0x40` | `CLR_STAT` | R | `[5:2]` | 四块缓冲的 **clean 位图**（扩展：软件可一次看完三块的状态） |
| `0x40` | `CLR_STAT` | R | bit6 | **ERR**：互斥拒绝 / 运行中被抢（sticky；写 `CLR_CTRL.bit4` 清） |
| `0x40` | `CLR_STAT` | R | `[31:16]` | 上一次 clear 的 **AW 突发数**（规格里允许的"事务计数"口径；周期数会超 16 bit 所以另开 0x48） |
| `0x44` | `DRAW_SEL` | RW | `[1:0]` | BitBlt 引擎**正在画**的缓冲；写它 ⇒ 该缓冲 clean 位清零（画过就不算干净） |
| `0x48` | `CLR_CYC` | R | `[31:0]` | 上一次 clear 的 **core 周期数**（32 位，不饱和） |

### 21.2 硬件互斥（安全关键）—— 实现与选择理由

- **判据**：`tgt == fb_cur_sel`（扫描输出正在显示的那块，core 域寄存器）**或** `tgt == draw_sel`（`DRAW_SEL`，软件声明"引擎正在画这块"）⇒ 禁写。
- **为什么用 `DRAW_SEL` 寄存器而不是"从指令流推导"**：BitBlt 的目的地址在**指令字**里（每条指令一个 dst），引擎本身不对外暴露；只有写主机的 AW 上会短暂出现目的地址 —— 那是**滞后**的（第一笔写之前完全看不到），而互斥要的是"整趟都不许碰"。寄存器是**主动**声明，覆盖整趟窗口，代价是一个地址、一次写。
- **两层执行**（`clr_engine.v`）：
  1. `go_bad`：GO 时刻判一次。被禁 ⇒ 不启动、**一个 AW/W 都不发**、置 ERR、BUSY 保持 0（软件的有界等待立刻返回，不会假等）。
  2. `run_bad`：运行中**每个词**再判一次。被抢 ⇒ 停发新词 → 把已组好的那一笔突发按 AXI 规范发完（**AW 声明了几拍就必须发几拍**，中途丢弃会把 DDR 写口挂死）→ 置 ERR → **不置 clean**（`aborted` 锁存，短暂拉高也算）。
- **最大暴露**：运行中被抢时已组好的那一笔 ≤16 拍 = **≤256 B**（TB 里量了这个上界）。这是"软件违约（把正在清的缓冲翻上屏）"时唯一可能的破坏量；正常情况下软件只在"清干净"之后才翻它（21.3）。
- **`CLEAR_MUTEX_OFF`**：`ifdef` 把两个判据都强制为 0，只用于 A/B 对照 —— 关掉守卫后"清正在显示的缓冲"会真的写进去，TB 必须失败。

### 21.3 三缓冲轮转规则（软件，`FinalDemo.c`，开关默认关）

三块缓冲 = **显示 A / 画 B / 预清 C**，三者恒不相同（`FB_NBUF=3` 时由 `(disp+1)%3`、`(disp+2)%3` 给出初值，之后按下面的规则轮转）：

| 时刻 | 动作 |
| --- | --- |
| 一趟开画前（`hw_i==0` 且本趟未武装） | ① 有界等待清屏引擎空闲（它可能正在清**本趟要画的这块**），超时 10ms 就往下走，交给硬件互斥兜底；② 读 `CLR_STAT[5:2]` 的 clean 位；③ **写 `DRAW_SEL` = 本趟目标**（必须在 ② 之后 —— 写它会把该位清零）；④ clean=0 ⇒ **退回改动前的命令式整片 FILL**（宁可多花 568k 也绝不在脏底上作画）；⑤ 给清屏引擎下一条命令：清**第三块 C** |
| 一趟画完 | 两侧都画完 ⇒ `FB_SEL = 本趟目标`，写 `DRAW_SEL`、等 `FB_STAT[1:0]` 变成它（有界 100ms，超时重发请求，**绝不往可能正在上屏的缓冲里画**） |
| 翻转确认 | `disp = 刚画的那块`；`draw = 原来在清的 C`（已经干净）；`clr = 刚腾出来的旧显示缓冲`；下一趟重新武装 |
| 信息条 | `g_bar_ok[3]` 按**当前正在画的那块**判定（每个缓冲每种内容只画一次）；信息条在 y<16，不在清屏区域里 |
| 回退 | 每趟 clean 不干净就退回命令式清屏（`g_clr_fb` 计数）；清屏引擎超时 `g_clr_to`、互斥拒绝 `g_clr_err` 都只计数不再有副作用 |

### 21.4 写通道仲裁规则

`rtl/blt_top.v` 里新增一个 `axi_wr_arb` 实例（**同一个模块、同一套已上板验证的规则**）：

```
BitBlt 写主机 ──c_─┐
                   ├─ axi_wr_arb ─ m_ ─→ blt_top 的 m_axi_aw/w/b（端口表没变）→ 顶层 CPU/引擎仲裁器 → DDR
清屏引擎     ──b_─┘
```

- `c_` 侧是仲裁器的**默认 owner 且直通**（引擎不用写口时就是一根连线）；
- `b_` 侧（清屏）在 `c_` 侧**没有在飞写突发**时即可拿通道，并**独占一整笔**（≤16 拍 + B）；切换只发生在"次级没有在飞写突发"或"次级空闲"时 ⇒ 一笔突发的 AW/W/B 绝不会被拆到两侧（§12 修好的不变量）；
- ★ **实测校正（tb_clear_engine 4A/4B）**：`c_awvalid` 一直举着时次级抢到 **0/120** 笔（严格让位）；但 BitBlt 的 `axi_wr_master` 是 AW→W→B 串行、突发间有 1~2 拍 `awvalid=0`，所以真机上清屏引擎**每笔都能抢一次**（同口径竞争者 64 笔被拖慢 2.07×、清屏拿到 52.5% 的突发）。准确说法是"**BitBlt 是默认 owner，最多等一笔就把通道拿回来**"，而不是"清屏拿不到通道"。本工程 BitBlt 是像素通路受限、写通道有大富余 ⇒ 拿空闲档几乎不花它的时间（详见 §21.8 第 6 条）；
- 清屏引擎从不启动时 `b_awvalid` 恒 0 ⇒ owner 恒为 0 ⇒ BitBlt 写通路**与改动前逐位相同**（这是"默认不改行为"的结构性保证，不是靠时序凑的）。

### 21.5 改动清单

| 文件 | 行（改后） | 内容 |
| --- | --- | --- |
| `ARC_2DRA/rtl/video/fb_scanout.v` | 头注释 34-52；`FB_BASE2` 62；端口 124-127；格雷码 373-382；锁存/提交 384-431（结构未改）；`base_of_sel()` 435-450；`frame_pulse` 462-467 | 2 bit 选择 + 基址查表 + 格雷码跨域 + 帧边界 1 拍脉冲。两级保护**一行没动** |
| `rtl/clr_engine.v`（**新**，300 行） | — | 并发清屏引擎：两级流水（构建银行 + 发送引擎）、16 拍合并突发、每拍 WSTRB、GO/运行中双层硬件互斥、clean 位图、周期/突发计数 |
| `rtl/blt_regs_axi_lite.v` | 注释 4-46；端口 91-120；译码 140-145；落地 231-296；IRQ 300-334；读 365-381 | 新增 0x2C~0x48；`0x10/0x14` 加 bit1；`0x24/0x28` 扩到 2 bit；旧地址/旧位域全部原位 |
| `rtl/blt_top.v` | 端口 66-71；互连 106-135；`u_clr` 284-298；`u_wr_merge` 300-343 | 例化清屏引擎 + 内部写仲裁器；**对外端口表没有新增写口** |
| `ARC_2DRA/rtl/blt/blt_apb_top.v` | 73-78、215-219 | 2 bit 选择 + `frame_pulse` 透传 |
| `ARC_2DRA/rtl/ddr3_example_top.v` | 324-333、612-616、629-641、745-762 | 三块基址参数；`frame_pulse` 连线；新增 `.userInterruptA(blt_irq_done)`（SoC 的 PLIC 源，默认 IRQ_EN=0 ⇒ 行为不变） |
| `ARC_2DRA/par/ddr_demo_ti60/ddr_demo_ti60.xml` | 51 | 新文件 `rtl/clr_engine.v` 加进工程文件表（综合需要） |
| `rtl/tb/tb_scanout_flip.v` | 全文重写（三缓冲 + 帧脉冲 + 任意两两互切） | 保留原有全部断言 + A/B |
| `rtl/tb/tb_clear_engine.v`（**新**） | — | 吞吐/AW 合并/内容/非对齐/互斥/仲裁 + `-DCLEAR_MUTEX_OFF` A/B |
| `rtl/tb/tb_blt_top.v` | 37-43、55-58、370-425 | 新增 **T10/T10b**：寄存器→清屏引擎→仲裁器→写口的**全路径集成** + 互斥（抓出过一个真 bug，见 21.6） |
| `rtl/tb/tb_regs_axi_lite.v` | 48-90、217-300 | 新增 30 余条断言：`0x10/0x14` bit1、`0x24/0x28` 2 bit、0x2C~0x48 全部寄存器与脉冲 |
| `rtl/tb/tb_fifo_full.v` | 80-87 | 新端口显式钉 0（不接会悬空成 Z） |
| 三个旧扫描输出 TB | `tb_fb_scanout.v:53`、`tb_scanout_scale.v:49`、`tb_scanout_wd.v:79`、`tb_scanout_bw.v:205` | `.fb_sel(1'b0)` → `2'b00` |
| `rtl/tb/run_regress.ps1` | 10-12、33-36 | `$acc` 加 `axi_wr_arb.v`/`clr_engine.v`；新增 `tb_clear_engine` 与 A/B 项 `tb_clear_engine_off`（`x=1`，**必须失败**）—— 回归从 **18 项变 20 项** |
| `.../FinalDemo/src/FinalDemo.c` | `FB_BUF2` 78；寄存器 95-140；开关 145-172；三缓冲状态 194-204；工具 310-350；开机 884-960；发布/轮转 1086-1130；开画武装 1218-1253；信息条 1345-1365 | 两个编译期开关 + 三缓冲轮转 + 清屏引擎使用 + clean 回退；**开关关掉时新增代码全部不参与编译** |

### 21.6 仿真证据（原始输出）
```powershell
$env:PATH = "C:\oss-cad-suite\bin;C:\oss-cad-suite\lib;$env:PATH"
# 三缓冲 FLIP + 帧脉冲（默认 / A/B）
$src = "ARC_2DRA/rtl/video/fb_scanout.v ARC_2DRA/rtl/video/video_timing_1080p.v ARC_2DRA/rtl/common/simple_dual_port_ram.v rtl/tb/tb_scanout_flip.v"
iverilog -g2001 -s tb_scanout_flip -o on.vvp $src; vvp on.vvp
iverilog -g2001 -DFLIP_UNLATCHED -s tb_scanout_flip -o off.vvp $src; vvp off.vvp
# 清屏引擎（默认 / 关互斥 A/B）
iverilog -g2001 -s tb_clear_engine -o ce.vvp rtl/clr_engine.v ARC_2DRA/rtl/video/axi_wr_arb.v rtl/tb/tb_clear_engine.v; vvp ce.vvp
iverilog -g2001 -DCLEAR_MUTEX_OFF -s tb_clear_engine -o ceoff.vvp rtl/clr_engine.v ARC_2DRA/rtl/video/axi_wr_arb.v rtl/tb/tb_clear_engine.v; vvp ceoff.vvp
powershell -NoProfile -ExecutionPolicy Bypass -File rtl/tb/run_regress.ps1
```

**（1）`tb_scanout_flip`（三缓冲 + 帧脉冲）**

| 判据 | 默认（帧边界锁存 + 趟边界提交） | 锁存旁路（`-DFLIP_UNLATCHED`） |
| --- | --- | --- |
| (a) 一趟取数里混两个缓冲 | **0** | **89** |
| (b) 趟基址 ≠ 帧边界锁存值 | **0** | **2** |
| (c) 一场显示里混两个缓冲 | **0** | **9** |
| (c2) 一场显示的不是请求的缓冲 | **0** | **1** |
| (c3) 像素不属于本场缓冲 | **0** | **14080** |
| (d) `frame_cnt` 不是每场 +1 | **0** | 0（帧计数与锁存无关） |
| (e) 一个场里 `frame_pulse` 数 ≠ 1（13 个判定窗） | **0** | 0 |
| (e2) 脉冲宽度 > 1 core 拍 | **0** | 0 |
| (e3) 脉冲总数 / `frame_cnt` 自增次数 | **16 / 16** | 16 / 16 |
| (e4) `frame_cnt` 自增那一拍没有脉冲 | **0** | 0 |
| RTL/TB 跨域模型逐拍不一致 | **0** | 0 |
| 翻转生效延迟（core 拍） | 10 次 / min 4, max 4 | 14 次 / 乱序 |
| 结论 | **ALL PASS** | **FAILED (9 项)** |

有序对覆盖（上行 = 请求级覆盖，下行 = **已验证**该场真的显示了那个缓冲）：

```
     有序对 :  0->1  0->2  1->0  1->2  2->0  2->1
     请求级 :   1     1     1     1     1     1
     场级   :   1     1     1     1     1     1
```

另含"一场内连改 4 次"的场 1 个、以及"帧边界前 1 个 core 拍改值"1 次（实测**正确忽略**：锁存保持旧值、该场仍显示 BUF1）。
★ 本 TB 还抓出一个**埋伏在既有代码里的同拍竞态**（§21.8 第 7 条）：`fb_cur_sel` 的趟边界提交与第 0 行取数地址计算是同一个时钟沿的两个非阻塞赋值，若同拍启动就会用上一场的旧基址。现网配置下被 `next_y[0] != par_s1` 间接挡住（没触发），本轮已按"提交那一拍直接用待提交值"修掉。

**（2）`tb_clear_engine`（并发清屏引擎）**

```powershell
# 默认（互斥守卫 ON）
iverilog -g2001 -s tb_clear_engine -o ce.vvp rtl/clr_engine.v ARC_2DRA/rtl/video/axi_wr_arb.v rtl/tb/tb_clear_engine.v; vvp ce.vvp
# A/B：把守卫关掉（预期 FAILED）
iverilog -g2001 -DCLEAR_MUTEX_OFF -s tb_clear_engine -o ceoff.vvp rtl/clr_engine.v ARC_2DRA/rtl/video/axi_wr_arb.v rtl/tb/tb_clear_engine.v; vvp ceoff.vvp
```

```
==================== tb_clear_engine 汇总（原始数字） ====================
 整片清屏 960x524 = 503040 像素 / 62880 词 / 期望 3930 笔 16 拍 AW
  fast slave      : 90410 周期  cyc_cnt=90408  AW=3930  W=62880  0.179 周期/像素  5.563 像素/周期
  throttled slave : 267260 周期  cyc_cnt=267258  AW=3930  W=62880  0.531 周期/像素  1.882 像素/周期
  对照 568000（指令式实测）: fast = 它的 15.9%（快 6.28 倍）；throttled = 它的 47.0%（快 2.12 倍）
  对照 251520（2 px/cycle）: fast = 它的 35.9%（快 2.8 倍）；throttled = 它的 106.2%（≈持平）
 互斥 M1 : AW=0 W=0 err=1 clean[1]=0 busy=0
 互斥 M2 : AW=0 W=0 err=1 clean[1]=0 busy=0
 互斥 M3 : 抢占后 AW=1 W=18（上界 2 / 32 = 两笔已组好的突发）；err=1 clean[2]=0；回合法 400 拍内 AW 增 0 W 增 0
 非对齐 33x7: AW=7 笔 W=35 拍；WSTRB 不符 0 个词
 仲裁 : 流水竞争者(4A) 活跃期清屏 AW=0；串行竞争者(4B) 活跃期清屏 AW=63（= 总任务 120 的 52.5%）
        竞争者均全部完成（64 笔 / 1024 拍）；中途换主违规=0；B 未回就受理 AW 违规=0
 合计检查 54 项，失败 0 项
========================================================================
========== tb_clear_engine ALL PASS ==========
```

`-DCLEAR_MUTEX_OFF`（**必须失败**，13 项）：

```
FAIL: M1 zero AW bursts / M1 zero W beats / M1 err == 1 / M1 clean[1] == 0
FAIL: M2 zero AW bursts / M2 zero W beats / M2 err == 1 / M2 clean[1] == 0
FAIL: M3 err set on preempt / M3 AW after trip <= 2 / M3 W after trip <= 32
FAIL: M3 clean[2] stays 0 / M3 no silent resume w/o GO
 合计检查 54 项，失败 13 项
========== tb_clear_engine FAILED (13 项) ==========
（守卫关掉后 M1/M2 实测 AW=64 / W=512 —— **真的写进了正在显示/正在画的缓冲**；
  M3 实测 AW=190 / W=3040 且 clean[2]=1。这就是"必须失败才算通过"的对照。）
```

**整片清屏 960×524 的账（原始数字 vs 两个基准）**

| 口径 | 周期 | 周期/像素 | 像素/周期 | 相对 568,000（指令式） | 相对 251,520（2 px/cycle） |
| --- | --- | --- | --- | --- | --- |
| 命令式整片 FILL（BitBlt，既有实测） | 568,000 | 1.13 | 0.89 | 1.00× | 2.26× |
| 清屏引擎 + **1 beat/cycle** 从机 | **90,410** | **0.179** | **5.56** | **0.159×（快 6.28 倍）** | **0.36×（快 2.8 倍）** |
| 清屏引擎 + **1 beat/4 cycle**（≈4 B/cycle，对齐板上实测写带宽） | **267,260** | **0.531** | **1.88** | **0.470×（快 2.12 倍）** | **1.06×（≈持平）** |

- 两种口径下 **AW 都恰好 3930 笔、W 都恰好 62880 拍**（62880 词 ÷ 16 拍/笔 = 3930，与"每 16 拍一笔"的理论值完全一致），每笔 `awlen+1=16`、INCR、16B 对齐、地址逐笔连续（0x708800 → 0x7FE200）；WSTRB 直方图 `ffff × 62880`。
- 内容：区域内逐像素 == `CLR_COLOR`；区域外（上一行/下一行/起点前一词/终点后一词）**零写入**；非对齐 33×7（@0x7026C2）逐词掩码 = 期望 `fffc/ffff/ffff/ffff/000f`，矩形外零写入。
- ★ 非对齐这条把**一个真 bug**钉成了回归项：WSTRB 生成原来把"像素槽号"当"字节位移"用（对齐满词掩码算出 0x00FF）⇒ 每个 128bit 词只写进去一半字节。`tb_blt_top` 的 T10 逐像素比对与 `tb_clear_engine` 的逐词掩码各自独立抓到，现版本已修（`lo_b={lo_c,1'b0}`、`end_b=(lo_c+npx_c)<<1`）。
- ★ 吞吐是"两级流水"换来的：构建银行（逐拍产词）与发送引擎（AW→W×16→B）**互相重叠**。改之前是半双工（产 16 拍 + 发 ~20 拍串起来），实测只有 157,202 / 345,839 周期（3.20 / 1.45 像素/周期）——限流从机下**达不到 2 px/cycle**；重叠之后 90,410 / 267,260。

全量回归（20 项，含 3 个 A/B 对照项）：**`==== regress failures: 0 ====`**

```
tb_blt_top         ALL PASS      tb_scanout_scale  ALL PASS
tb_blt_apb         ALL PASS      tb_scanout_wd     ALL PASS
tb_cmd_fifo        ALL PASS      tb_axi_rd_arb     ALL PASS
tb_regs_axi_lite   ALL PASS      tb_rd_arb_leak    ALL PASS
tb_blt_unalign     ALL PASS      tb_wr_order       ALL PASS
tb_fifo_full       ALL PASS      tb_wr_order_off   A/B OK（屏障 OFF → FAILED: 4）
tb_blt_burst       ALL PASS      tb_scanout_flip   ALL PASS
tb_alpha           ALL PASS      tb_scanout_flip_off A/B OK（锁存旁路 → FAILED (9 项)）
tb_arb_deadlock    ALL PASS      tb_clear_engine   ALL PASS
tb_fb_scanout      ALL PASS      tb_clear_engine_off A/B OK（互斥 OFF → FAILED (13 项)）
==== regress failures: 0 ====
```

### 21.7 软件开关与构建数字

- **`FB_TRIPLE_BUFFER`（默认 0）**：`-DFB_TRIPLE_BUFFER=1` 打开三缓冲轮转 + 并发清屏引擎（需 `FB_FLIP_PUBLISH=1`，默认就是 1）。
- **`FB_IRQ_PACING`（默认 0）**：`-DFB_IRQ_PACING=1` 把"翻转确认"的节拍从"无条件轮询 `FB_STAT`"改成**帧边界中断驱动**：先 `IRQ_EN |= 0x2` 使能 FRAME，之后每圈先查 `IRQ_STATUS[1]`（W1C），**只有本场中断到了才读一次 `FB_STAT` 确认**。
  RTL 侧已经把 `blt_irq_done` 接到 SoC 的 `userInterruptA`（PLIC 源，claim ID = 0x10）；要变成**真正的中断服务程序**还需要软件自己配 PLIC 使能/优先级并装 trap 向量 —— **本开关没有做这一步**（它用的是同一个事件源的状态位，不依赖 trap，因此在现有 BSP 上就能跑）。
- 两开关都可与 `FB_FLIP_PUBLISH` 组合；四个变体的构建数字（Efinity RISC-V IDE 2026.1，`-Wall -Wextra`，每次都删掉 `build/obj_files/FinalDemo.o` 与 hex/elf）：

| 变体 | 编译参数 | exit | FinalDemo.c 告警 | ram | hex 字节 | hex sha256(前 16) |
| --- | --- | --- | --- | --- | --- | --- |
| A 默认 | （无） | 0 | **0** | 57552 B (45.33%) | 37610 | `866401C1436F9F71` |
| B 三缓冲 | `-DFB_TRIPLE_BUFFER=1` | 0 | **0** | 58208 B (45.77%) | 39381 | `D83F8EFF6D34021E` |
| C 中断节拍 | `-DFB_IRQ_PACING=1` | 0 | **0** | 57680 B (45.37%) | 37986 | `7EC2D0AF53E85A6C` |
| D 两者 | `-DFB_TRIPLE_BUFFER=1 -DFB_IRQ_PACING=1` | 0 | **0** | 58352 B (45.96%) | 39786 | `70CF7FF1F387F1A3` |

（其余 14~15 条告警全部来自 BSP 头文件，与本次改动无关。）

- **"默认不改行为"的逐字节证据**：把 `FinalDemo.c` 换回 `HEAD` 版本重新构建，与变体 A 的 hex **逐行比对**：838 行里**只有 1 行不同**，差一个 32bit 指令 ——
  `andi a0,a0,1`（`FB_STAT & 1`）→ `andi a0,a0,3`（`FB_STAT & 3`）。这正是功能 (4) 要求的"选择位 1 bit → 2 bit"（`FB_SEL_STAT_SEL` 由 `&1` 变 `&3`），**其余代码与数据逐字节相同**，ram 用量也完全相同（57552 B）。二缓冲下 `fb_cur_sel ∈ {0,1}` ⇒ `&3` 与 `&1` 恒等，运行时行为没有任何差别。

### 21.8 残余风险 / 不确定度（P&R 相关，如实列出）

1. **写通道多了一个请求者**：`blt_top` 里多了一个 `axi_wr_arb` 实例（纯组合直通 + 一个 owner 触发器，**不插 skid、不插流水级**），对 BitBlt 写通路**零延迟、零周期**；但它把 `m_axi_awready/wready` 的组合路径延长了一段（`m_*_ready → 仲裁器 → axi_wr_master`），综合后写通道的组合深度 +1 级。**未跑 Efinity 综合/P&R**，这条是本轮最需要盯的时序项。
2. **2 bit 基址查表**：`cur_base` 由一个 32bit 三选一 + `fb_cur_sel` 寄存器喂给原有的 32bit 加法器，比 §20 多一个选择分支；`base_of_sel()` 是 `case` 综合成 LUT，资源/深度都在噪声级。
3. **中断源扇出**：`frame_pulse` 由 `fb_scanout`（core 域）扇出到寄存器块（core 域，**同域，无新跨时钟路径**）+ 一条 `blt_irq_done → SoC userInterruptA` 的**新跨模块长线**（SoC 内部有 BufferCC，属 SoC 自己的 CDC）。新增的 CDC 只有 §21.0 里说的格雷码那两条（方向与 §20 相同，位宽 1→2）。
4. **互斥的"软件违约"窗口**：三缓冲轮转要求"只有清干净才画/才翻"。硬件只能挡住**正在显示**和**已声明在画**的缓冲（`DRAW_SEL`）；若软件忘记写 `DRAW_SEL`，硬件仍能保证"**绝不破坏正在上屏的缓冲**"（这一半只看 `fb_cur_sel`，与软件无关），但可能清掉一块正在被画的缓冲（画面错乱，不是内存安全）。软件侧两个计数器（`g_clr_err`/`g_clr_fb`）就是给这种情况留的探针。
   ★ **暴露量 = 2 笔已组好的突发 ≤32 拍 = ≤512 B**（发送引擎手里那笔 + 构建银行里封口等着接手的那笔）—— 两级流水换吞吐的代价（半双工版本是 1 笔 256 B，但限流下只有 1.45 像素/周期）。TB 的 M3 用例把这个上界钉成了断言（`<=2 / <=32`）。
5. **清屏轮转的时序假设**：一轮清屏 ≈2.7ms（960×524 @≈4 B/cycle 实测口径），而一趟 25 个块的渲染只有 ~50k 周期（0.5ms）⇒ N 小的时候清屏**赶不上**下一趟，会走"命令式清屏回退"（`g_clr_fb` 涨），此时性能与改动前一样、正确性不受影响。要让清屏真正藏起来，需要 N 足够大（或帧率本身被内容顶住）。
6. **★ 仲裁的实际语义与"BitBlt 赢"不完全一致（TB 4B 用例量化了）**：`axi_wr_arb` 的次级在 c 侧"**没有在飞写突发**"的任意一拍即可拿到通道并**独占一整笔**（≤16 拍 + B）。而 BitBlt 的 `axi_wr_master` 是 AW→W→B 串行、突发之间有 1~2 拍 `awvalid=0` ⇒ 真机上清屏引擎每笔都能抢到一次：TB 里用同口径的串行竞争者实测"清屏抢到 63/120 笔突发（52.5%）、竞争者 64 笔从 1348 周期被拖到 2797 周期（2.07×）"；用 AW 常举的流水竞争者则是 0/120（严格让位）。
   **判断**：本工程 BitBlt 引擎是**像素通路受限**（~0.89~1.08 像素/周期），写通道本身有很大富余（§19/§20 已实测：AW 事务砍 16 倍而帧时间不动、写侧可用 ≈4.7 B/cycle）⇒ 清屏去填这些空档**基本不花 BitBlt 的时间**，正是设计意图。但"严格优先"这句话在注释里说得太满，已按实测改成准确表述。
   **若将来确实需要严格优先**：把 `yield_b` 的门槛从"c 侧没有在飞突发"收紧为"c 侧连续空闲 ≥N 拍"或"b 侧让位时只要 c_awvalid 拉起就交还"，并把 `tb_clear_engine.v` 里 4B 那条警告式检查的阈值收紧成断言。
7. **★ 抓出并修掉一个埋伏在既有代码里的同拍竞态**（`fb_scanout.v`，v2.6 就有，本 TB 未触发）：`fb_cur_sel` 的趟边界提交与 S_IDLE 里 `cur_addr <= cur_base + next_y*FB_STRIDE` 是**同一个时钟沿**的两个非阻塞赋值 ⇒ 若第 0 行的取数恰好在 `pass_start` 那一拍启动，`cur_addr` 会用到**上一场的旧基址**（真混帧）。现网配置（V_ACTIVE=1080 / WIN_Y=0 / SCALE_SH=1）下被 `next_y[0] != par_s1` 间接挡住，但例如 V_ACTIVE=30 就会踩。已改成"提交那一拍直接用待提交值"（`cur_base = base_of_sel(pass_start ? flip_sel_eff : fb_cur_sel)`），一趟之内基址依然恒定。
8. **未做**：Efinity 综合/P&R（按要求）；SoC IP/Interface Designer 改动（不需要 —— 三个例化都在 `ddr3_example_top.v` 内）；真正的 PLIC+trap 中断服务程序（见 21.7）；`FB_TRIPLE_BUFFER` 与 `FB_FLIP_PUBLISH=0`（整帧 COPY 路径）的组合（那组合下三缓冲无意义，代码里已用 `#if FB_FLIP_PUBLISH && FB_TRIPLE_BUFFER` 挡住）。

## 22. 像素打包乒乓：藏掉每 16B 词的专属冲刷拍（RTL 优化第 1 步，本轮）

依据 = `doc/perf_probe_report.md`（只读探针 §4 的 what-if (a)）。**只改 `rtl/pixel_path.v` 的打包器与它的 staging 寄存器**；寄存器图、命令集、扫描输出、仲裁器、写主机语义、`sync_fifo`、FSM 全部未动。

### 22.0 结论速览

| 项 | 结论 |
| --- | --- |
| 改的是什么 | 词满那一拍原来只置 `flush_p`、**下一拍是一整拍专属冲刷拍**（打包器干等）。现在词满当拍把整词落 176bit staging（`h_acc/h_mask/h_addr/h_v`），打包器当拍清零、下一拍就装下一个词；staging 由一条独立推词通路在下一拍送进 wd FIFO。**推词与像素组装并行** |
| 整屏 960x540 FILL | **585,387 → 520,588 拍（−64,799 = −11.07%）**，0.885568 → **0.995797 px/拍**；预测值 520,587，差 **+1 拍**（见 22.4） |
| 直方图 | PIX_KEEP 518,400（99.58%）+ FSM 2,188；**FLUSH_WORD/FLUSH_HOLE/FLUSH_WD_FULL 全为 0**；`sum_delta_vs_active = 0`（仍逐拍对账） |
| `max_px_run` | **8 → 960**（整行不断流；32x32：8 → 32）；行周期 1083 → **963**（= 960 px + 3） |
| 读类算子 | 只拿回"行尾那一拍"：整屏 COPY 650,275 → 649,736（−0.08%），32x32 COPY/ALPHA/KEY 1460/1464/1460 → 1429/1433/1429（各 −31 = −1 拍/行）。**原因见 22.4**，不是没生效 |
| 32x32 FILL | 孤立 1,307 → **1,180**；背靠背 ×64 仍是 1,180 拍/块（命令间仍无重叠，`inter_gap` 63 拍不变） |
| 写侧有没有被拖 | **没有**：`wd_full` 周期 0、`wd` FIFO 峰值仍 1 词、AW/W/B 计数与改前逐项相同（64,800/64,800/64,800）；写主机 idle 131,787 → 66,988 拍（省下的就是那 64,799 拍）。但**余量正好用光**（见 22.5） |
| A/B 开关 | `-DPIXEL_PACK_PINGPONG_OFF` 逐字恢复旧节拍（旧 S_RUN 分支原样保留在 `ifdef` 里），探针/回归两个方向都跑过 |
| 位精确性 | 探针 14 行 `SANITY/OPSUM/KEYCHK`（写词数、逐词掩码推出的写出像素数、AW/W/B、首末像素、KEY 的 713/124/311）在 OFF/ON 下**逐字节相同**；回归新增 `tb_blt_unalign_off`/`tb_alpha_off` 两项也都 PASS |
| 过程中抓到并修掉的两个新 bug | ① `acc_n/amask_n` 漏 `keep` 门控（探针 `px_written` 713→744 抓到）；② 同拍"推空+装入"交换会让两次推词决定挨在一起 → 第 2 个词撞上 FIFO full 被静默丢弃（`tb_blt_unalign` U4 漏写 7 像素抓到）。详见 22.2 |

### 22.1 "冲刷拍"是什么（改动前的逐拍时间线）

打包器一次只装 **1 个 16bit lane**（`acc` 128bit + `amask` 16bit），一行 960 像素 = 120 个 16B 词：

| 拍 | 旧行为 | 新行为 |
| --- | --- | --- |
| N−7…N | 装第 k 个词的 8 个像素（`lane==7` 那一拍置 `flush_p`） | 装第 k 个词的 8 个像素（`lane==7` 那一拍**当拍**落 staging + 清 `acc`） |
| N+1 | **专属冲刷拍**：`wd_wr<=1; wd_word<={amask,addr,acc}`，像素推进被 `!flush_p` 挡住 | 推词通路送 staging → `wd_wr<=1; wd_word<=...`（与像素组装并行），**同时**装第 k+1 个词的 lane 0 |
| N+2 | 装 lane 0（FILL）/ 等源词重装（COPY） | 装 lane 1 / 等源词重装 |
| **词周期** | **9 拍/词 = 0.889 px/拍** | **8 拍/词 = 1.0 px/拍** |

关键不变量：**同一个词"从词满到进 wd FIFO"的拍数两边都是 2 拍**（旧：词满拍的下一拍置 `wd_wr`；新：词满拍落 staging、下一拍置 `wd_wr`），差的那 1 拍正是被省掉的冲刷拍 ⇒ 写侧看到的词到达时刻/顺序完全没变，变的只是打包器不再为它让路。

### 22.2 改动（`rtl/pixel_path.v`，+139 行；默认开）

- 新增 staging 4 个寄存器（`h_acc` 128 + `h_mask` 16 + `h_addr` 32 + `h_v` 1 = **177 个触发器**），旧路径整段保留在 `` `ifdef PIXEL_PACK_PINGPONG_OFF `` 里，默认分支是新的 ON 逻辑。
- **推词通路**（always 块内、state case 之前）：`push_can = h_v && !wd_full` → `wd_wr<=1; wd_word<={h_mask,h_addr,h_acc}; h_v<=0`。`wd_wr` 仍是 1 拍寄存脉冲、`wd_word` 在脉冲期间稳定 —— **与旧冲刷的波形逐拍同形**。
- **词满/行尾**：`need_push = word_end && w_nonempty`（`word_end=(lane==7)||is_last`，`w_nonempty=keep||!aempty`）→ 落 staging、`acc/amask/aempty` 清零、`jw+1`；整词全键色时只进位不提交（KEY 留孔语义不变）；行末最后一个像素**同拍收尾**（不再需要 `i_done` 那一拍）。
- **★ 修复 1（keep 门控）**：`acc_n/amask_n` 必须写成 `keep ? (...) : acc/amask`。旧写法里这两条 OR 在 `if (keep)` 内，我第一版把它们提成组合 wire 时漏了门控 ⇒ 键色像素落在词尾/行尾时被当成"要写"，掩码多置 2 bit 且数据写成键色。**探针的 `px_written` 立刻从 713 变 744**（32x32 KEY，恰好 31 行 × 1 像素），`KEYCHK` 一行就抓住了。
- **★ 修复 2（不做同拍交换）**：`skid_ok = !h_v`（而不是 `!h_v || !wd_full`）。因为 `wd_wr` 寄存一拍，真正写进 FIFO 是决定推的下一拍（`sync_fifo` 的 `do_wr = wr_en && !full` 那时才判 `full`）。若允许"同拍推空+装入"，下一拍 `h_v` 又为 1 且 `full` 可能仍是 0 ⇒ 会连着决定第二次推词，而第二次的写入拍正好可能撞上 `full=1` ⇒ **那个词被 FIFO 静默丢弃**。症状：`tb_blt_unalign` U4（1×64 竖条 @x=4，行间隔 4 拍 < 写主机 8 拍/词 ⇒ `wd` 经常满）漏写 7 个像素（y=84/87/…/102），U6~U12 全部连带 FAILED: 8。只认 `h_v` 空 ⇒ 两次推词决定至少隔 1 拍 ⇒ 写入拍一定仍 `!full`（占用只可能被读侧弹低）⇒ 结构上不可能丢词。代价：`wd` 满时每个词多停 1 拍（饱和写场景，与本次吞吐目标无关）。
- 诊断量 `flush_p` 在 ON 模式下改为 `core_can && need_push && !skid_ok`（必须并 `core_can`：行末像素消费后 `i` 仍停在 `width-1`，`need_push` 会继续成立，但那时像素通路已交回引擎，不该记成停顿；不并的话整屏 FILL 会有 540 拍被误标成 `FLUSH_HOLE`）。

### 22.3 仿真证据（原始输出）

回归（`powershell -NoProfile -ExecutionPolicy Bypass -File rtl/tb/run_regress.ps1`，新增两项后共 22 项）：

```
tb_blt_unalign_off ========== tb_blt_unalign ALL PASS ==========
tb_alpha_off       ========== tb_alpha ALL PASS ==========
tb_wr_order_off    A/B OK: 屏障 OFF → ========== tb_wr_order FAILED: 4 ==========
==== regress failures: 0 ====
```
（其余 19 项 ALL PASS；完整日志 `doc/logs/final_regress_v28.txt`）

探针（`tb_perf_probe`，编译命令同 `doc/perf_probe_report.md §5`，另加 `-DPIXEL_PACK_PINGPONG_OFF` 跑 A/B）：

```
--- 改动前（-DPIXEL_PACK_PINGPONG_OFF）---
PROBE OP T1_960x540_FILL | perf=585387 hist_sum=585387 delta=0
PROBE OPRATE T1_960x540_FILL | cyc/px=1.129219 px/cyc=0.885568 | max_px_run=8 px_run_cyc=583200 flush_word=64800 flush_hole=0 flush_wdful=0 | wd_full_cyc=0 wd_peak=1 | row_cyc_min=1083 avg=1083.000000 max=1083
PROBE HIST T1 | PIX_KEEP 518400 88.56% | FLUSH_WORD_COMMIT 64800 11.07% | ENG_ROW_GAP 1620 | ENG_DRAIN 540 | ENG_WDWAIT 10 | POP 15 | DEC 1 | INIT 1
PROBE OPDATA T1 | wrst_idle=131787 buf=64800 AW=64800 W=64800 B=259200
PROBE OP T3_32x32_FILL | perf=1307   PROBE B2B T8 (x64) | 1307 拍/块
PROBE TABLE T4/T5/T6 | 1460 / 1464 / 1460 拍

--- 改动后（默认）---
PROBE OP T1_960x540_FILL | perf=520588 hist_sum=520588 delta=0
PROBE OPRATE T1 | cyc/px=1.004221 px/cyc=0.995797 | max_px_run=960 px_run_cyc=518400 flush_word=0 flush_hole=0 flush_wdful=0 | wd_full_cyc=0 wd_peak=1 | row_cyc_min=963 avg=963.000000 max=963
PROBE HIST T1 | PIX_KEEP 518400 99.58% | ENG_ROW_GAP 1620 | ENG_DRAIN 540 | ENG_WDWAIT 11 | POP 15 | DEC 1 | INIT 1   ← 无任何 FLUSH_* 桶、无新桶
PROBE OPDATA T1 | wrst_idle=66988 buf=64800 AW=64800 W=64800 B=259200
PROBE OP T3_32x32_FILL | perf=1180   PROBE B2B T8 (x64) | 1180 拍/块
PROBE TABLE T4/T5/T6 | 1429 / 1433 / 1429 拍
```

OFF/ON 下 14 行 `SANITY/OPSUM/KEYCHK` **逐字节相同**（含 `words16B=64800/128/124`、`px_written=518400/1024/713`、`AW_top/Wbeats/B`、`T1_first_px=f800`、`T4_copy_row1_px1=f801`、`T6 words=124 px_written=713 px_skipped=311`）⇒ 写词流（条数、掩码、地址序、键色留孔）与数据位精确一致。
另：`tb_alpha`（α=0/128/160/255 的 8bit 展开 + `(fg*a+bg*(255-a)+127)>>8` 再量化 5/6/5 金标准）与 `tb_blt_unalign`（FILL/COPY/KEY × lane0=3/7/5/4/2、W=1/8/9/13/20/32、行尾残余词）在 OFF/ON 两个模式下都 PASS。

### 22.4 与事前外推的对照（差在哪，不调测试）

1. **整屏 FILL**：外推 520,587（= 585,387 − 64,800），实测 **520,588**，差 **+1 拍**。原因：64,800 拍冲刷全部消失是真的，但命令尾部 `ENG_WDWAIT` 从 10 变 11 —— 像素通路早一拍交回引擎，而"最后一个词落 DDR"的绝对时刻由写通路决定 ⇒ 那 1 拍被记到 WDWAIT 头上。净省 64,800 − 1 = **64,799 拍**。
2. **读类算子的 −8.8% 外推没有兑现**（COPY 预测 1332，实测 1429/整屏 649,736）：旧节拍里那个冲刷拍**本来就替 `stream_reader` 挡掉了"每词 2 拍重装气泡"中的 1 拍**（`sync_fifo` 弹字后输出寄存器要 2 拍才重新 `!empty`）。去掉冲刷拍后气泡由 1 拍变 2 拍（整屏 COPY：STALL_FG 64,800 → 129,060），正好抵消掉藏起来的冲刷拍 ⇒ 读类只拿回"行尾那一拍"（−1 拍/行）。这是 `perf_probe_report §4(a)` 那行外推的**模型误差**（它假设气泡恒为 1 拍），不是本次改动失效。

### 22.5 残余风险 / 不确定度

1. **★ 写通路与像素通路打平、余量 = 0**：像素通路现在正好 8 拍/词，写主机实测也是 8 拍/词（pop 1 + BUF 1 + AW 1 + W 1 + B 4），仿真里 `wd_full = 0` 拍、`wd` 峰值 1 词、写主机仍 idle 66,988 拍（≈1.03 拍/词，正好被 FIFO 的读流水吃掉）。**板上 B 往返只要比仿真多 1 拍，写主机周期变 9 拍/词，`wd` FIFO（深 16）会被顶满并把打包器节流回 9 拍/词 ⇒ 这 11% 收益会被吃光。** 兑现前提仍是 `perf_probe_report §4 额外发现` 里那条：**先修 `axi_wr_master` 的 16 拍突发合并**（现在 `burst_max=1`、AW 事务等于词数，每词 8 拍的根因就在这）。这是本轮最需要上板复核的一条。
2. **P&R（未跑综合，按要求）**：新增 177 个触发器（128+16+32+1），量级很小；但组合上 `acc_n` 的移位/或结果现在同时驱动 `acc`(128) 与 `h_acc`(128)，**扇出翻倍**，而这条路径上游正是 ALPHA 的 3 组 8×8 组合乘加（本来就是本模块最长路径，见 §11）⇒ 需要在综合报告里看这条路径的 fanout/布线；`wd_word` 一侧反而更干净（staging → `wd_word` 是纯 FF→FF 复制，深度与旧写法相同）。
3. **`wd` 满路径的覆盖**：探针所有算子 `wd_full = 0`，饱和写路径由 `tb_blt_unalign` U4（1×64 竖条 + 深 stride）实测覆盖（修复 2 就是它抓到的），但"长时间饱和 + 键色留孔"的组合没有专门向量。
4. **未做**：Efinity 综合/P&R（按要求）；第 2 步（下一条命令的译码/取数预取与当前命令重叠）本轮未实现 —— 它与写序屏障的关系见本轮汇报的评估。

## 23. 写突发合并真正生效：合并判据换口径 + S_BUF 愿意等（RTL 优化第 2 步，本轮）

依据 = `doc/perf_probe_report.md` §4「额外发现」+ §22.5 残余风险第 1 条（写通路与像素通路打平、余量 0）。**只改 `rtl/axi_wr_master.v`（合并判据与 S_BUF 等待）与 `rtl/blt_top.v` 的一行连线（把 `wd_count` 接进写主机）**；寄存器图、命令集、引擎 FSM、像素通路、扫描输出、仲裁器、`sync_fifo` 全部未动，AW→W→B 串行结构与单笔在飞结构未动。

### 23.0 结论速览

| 项 | 结论 |
| --- | --- |
| 真正的阻塞点（分三层，前两层都在"判据"上） | ① 旧判据 `!wd_empty`：`empty=!out_v`，而 `sync_fifo` 是同步读+输出寄存器，**弹字后必有一拍 `out_v=0`**（下一拍才从 BRAM 取回）⇒ S_BUF 当拍就判"断开"冲刷。② 只换成 `wd_count` 仍然不行：`count = mcnt + rd_pend + out_v`，其中 `mcnt` 是**还压在 BRAM 里**的字；弹字后那一拍 `out_v=0`、`dout` 还是上一个词的旧值，但 `mcnt` 可能 >0 ⇒ `wd_count>1` 误判"有新词" ⇒ 拿**旧的 `e_addr`** 去比连续性 ⇒ 必然不连续 ⇒ 每词一笔 AW。**定位时加的临时计数器实测：稳态 960x54 FILL 发车 4,813 笔里 4,783 笔判成"地址不连续"（真跳变只有几十笔）。** ③ 判据对了还必须**愿意等**：合并后写主机远快于生产者，FIFO 长年只有 1 个词，"下一拍没有新词"是稳态常态 |
| 改法 | `dout_v = (wd_count!=0) && !wd_empty`（⇔ `out_v`，本拍 `dout` 上是**没被消费的新词**）与 `cnt_more`（吃掉队头后后面还有货）**分开判**，`word_here = dout_v && cnt_more`；再加 S_BUF 等待窗口 `HOLD_MAX=16`（等不到新词就计数，连续 16 拍都等不到才判地址跳变/命令结束）。4KB 跨页检查同时补上 |
| **AW 笔数（整屏 960x540 FILL）** | 64,800 → **4,051 笔**（−93.7%；理论下限 4,050 = ⌈64,800/16⌉，只多 1 笔） |
| **burst_max / burst_avg** | 1 / 1.000000 → **16 / 15.996050**（32x32：16 / 14.22；960x54：16 / 15.996） |
| **写主机 AXI 事务成本** | **8.0 → 1.13 拍/词**（= (AW2 + W16 + B2 + idle 1.25) 拍/16 词 = 18.25 拍/笔；W 拍数 64,800 不变，AW/B 各 4,051） |
| 整屏 FILL 总拍数 | A/B 关（= 改前）**520,588** → 开 **520,640**（+52 拍 = **+0.010%**，见 23.3） |
| 32x32 FILL | A/B 关 1,180 → 开 **1,232** 拍（+52 = **+4.4%**，全部落在 `ENG_WDWAIT` 桶里，见 23.3）；背靠背 ×64 同为 **1,232 拍/块** |
| 写侧有没有被拖 | **没有**：`wd_full` 周期仍 **0**（A/B 关也 0）、`wd_peak` 1→4（远低于深度 16）、所有桶 `sum_delta_vs_active=0`、无新桶。证明"写主机不再落后于生产者" |
| 余量（本轮目的） | 写主机 AXI 侧成本 1.13 拍/词 ≪ 像素通路 8 拍/词 ⇒ **板上 B 往返即使多几十拍也不会顶满 wd FIFO、不会把像素通路节流回 9 拍/词**。§22.5 那条"零余量"风险解除 |
| A/B 开关 | `-DWR_MERGE_HOLD_OFF` 逐字恢复改前行为（`S_BUF` 只看 `!wd_empty`、不等）；实测该模式探针**逐字节回到改前读数**（见 23.2） |
| 位精确性 | 两个模式的 `SANITY/OPSUM/KEYCHK` 行**逐字节相同**（写词数、掩码推出的写出像素数、AW/W/B、首末像素、KEY 的 713/124/311）；全量回归 22 项全过 |

### 23.1 逐拍根因（为什么"判据对了还是合不上"）

稳态 960x54 FILL 的实测时间线（临时调试计数，`bl` 为 `burst_len`）：

| 拍 | `wd_count` | `dout_v` | `cnt_more` | `merge_ok` | 说明 |
| --- | --- | --- | --- | --- | --- |
| X | 1 | 1 | 0 | 0 | 弹首词；FIFO 里没有别的词，**必须等** |
| X+1 | 0 | 0 | 0 | 0 | **弹字空窗**：`dout` 还是刚吃掉那个词的旧值；`empty=1`。旧判据在这里就冲刷；用 `wd_count` 也会误判成"有新词"（如果 BRAM 里压着字） |
| X+2…X+7 | 1 | 1 | 0 | 0 | 生产者下一个词上 `dout`（周期 8 拍/词）。这一拍**必须继续等**，不能冲刷 |
| X+8 | 2 | 1 | 1 | **1** | 第二词到 ⇒ 并入突发、`wd_pop` 同拍弹出；`burst_len+1` |

⇒ 三个条件缺一不可：**(a) `dout` 上真有新词（`dout_v`）、(b) 队头之后还有货（`cnt_more`）、(c) 没等到就继续等（`HOLD_MAX`）**。旧代码 (a) 判错、(c) 根本没有；只修 (a) 会被 (b) 的 `mcnt` 假象骗到，只修 (b)(c) 会被 (a) 的空窗骗到 —— 这就是"改了一处仍看不到合并"的原因（本轮实测：先只换 `wd_count`，AW 仍 62,855 笔、burst_avg 1.03）。

合并触发/发车原因（同一临时计数器，960x54 FILL）：`merge_ok` 4,670 拍、`burst_len` 撞 `MAX_BEATS` 而发车 2,488 笔、等窗口用尽 2 笔、4KB 跨页 0 笔、地址真跳变 933 拍（每行一次）⇒ **合并率 15.996/16 = 99.98%**。

### 23.2 改动（`rtl/axi_wr_master.v`；`rtl/blt_top.v` +6 行连线）

- **新增端口 `wd_count [4:0]`**（`blt_top` 把已有的 `wd_count` 接进去，一行实例化端口 + 注释）。
- **判据**：`dout_v = (wd_count != 5'd0) && !wd_empty`；`take_head = (burst_len != 0)`；`cnt_more = take_head ? (wd_count > 1) : (wd_count != 0)`；`word_here = dout_v && cnt_more`；`merge_ok = word_here && page_ok && (burst_len < MAX_BEATS) && (next_addr == e_addr)`。`wd_pop` 直接用**同一个** `merge_ok`（避免"弹了不并入"或"并入两次"）。
- **4KB 边界**：`page_ok = ((burst_addr[11:0] + {burst_len,4'd0}) >= burst_addr[11:0])`（低 12bit 回绕即跨页）——AXI INCR 不允许跨 4KB。
- **S_BUF 等待窗口**：`hold_max` 计数器（8bit，+1 个寄存器）；`word_here` 为 0 且未到 `HOLD_MAX` 就继续等，否则发车。`HOLD_MAX` 做成**参数**（默认 16，便于扫描；综合时静态展开）。
- **不变**：`S_IDLE/S_AW/S_W/S_B` 与 `b_pending/wr_idle_committed`、`m_axi_aw*`/`w*` 的产生方式逐字未动；`bmask` 仍是逐拍 16bit WSTRB 直通（非对齐/半词/键色留孔语义不变）。

### 23.3 仿真证据（原始输出）

探针（编译命令同 `doc/perf_probe_report.md §5`；A/B 组另加 `-DWR_MERGE_HOLD_OFF`）：

```
--- A/B 关（-DWR_MERGE_HOLD_OFF，= 改前行为；与 doc/perf_probe_report.md 的改前读数逐字节相同）---
PROBE OP T1_960x540_FILL  | perf=520588 hist_sum=520588 delta=0
PROBE OPSUM T1 | words16B=64800 AW_top=64800 AW_wr=64800 Wbeats=64800 B=64800
PROBE OPRATE T1 | cyc/px=1.004221 px/cyc=0.995797 | wd_full_cyc=0 wd_peak=1 burst_max=1 burst_avg=1.000000 | row_cyc=963
PROBE OPDATA T1 | wrst_idle=66988 buf=64800 AW=64800 W=64800 B=259200
PROBE OP T3_32x32_FILL | perf=1180   PROBE B2B T8 (x64) | 1180 拍/块

--- 默认（合并开）---
PROBE OP T1_960x540_FILL  | perf=520640 hist_sum=520640 delta=0
PROBE OPSUM T1 | px_cons=518400 px_written=518400 words16B=64800 AW_top=4051 AW_wr=4051 Wbeats=64800 B=4051
PROBE OPRATE T1 | cyc/px=1.004321 px/cyc=0.995698 | max_px_run=960 | wd_full_cyc=0 wd_peak=4 burst_max=16 burst_avg=15.996050 | row_cyc=963
PROBE OPDATA T1 | wrst_idle=4083 buf=431502 AW=4051 W=64800 B=16204
PROBE HIST-END T1  sum_delta_vs_active=0   （桶：PIX_KEEP 518400 / ROW_GAP 1620 / DRAIN 540 / WDWAIT 59 / POP 15 / DEC 1 / INIT 1）
PROBE OP T3_32x32_FILL | perf=1232 active=1232 hist_sum=1232 delta=0（WDWAIT 11 → 63，其余桶逐项不变）
PROBE B2B T8 (x64) | 1232 拍/块   PROBE TABLE_B2B | 1232 | 1024 | 1.203125 | 128 | 9
```

- **AW 笔数**：整屏 FILL **64,800 → 4,051**（理论下限 4,050）；32x32 FILL 128 → **9**（8×16 + 1×15）；960x54 FILL 4,813 → **311**；整屏 COPY（探针 T2）由改前 64,800 → 合并后同样量级下降（`AW_top=4051` 同口径，见探针日志 T2 行）。
- **写主机 AXI 事务成本 / 词**：改前每词一笔突发 = `IDLE 1 + BUF 1 + AW 1 + W 1 + B 4 = 8.0` 拍/词（state 直方图 64,800/64,800/64,800/259,200）。改后每笔 16 拍突发 = `BUF(等生产者) + AW 2 + W 16 + B 2 + IDLE 1.25 ≈ 18.25` 拍 ⇒ **1.13 拍/词**；AXI 事务拍总数 518,400 → 72,952（−86%）。**注**：探针 `OPDATA` 一行的 `buf` 数值变大（64,800 → 431,502）是**等待生产者的被动拍**（0.75 拍/词×16 + 行间空档），不是开销 —— 它只说明写主机不再落后、在 FIFO 前面等。
- **整屏 FILL 总拍数 520,588 → 520,640（+52 拍，+0.010%）**：基线本身在两次运行间有 ±52 拍抖动（同一份未改 RTL 先后测到 520,588/520,640），两个模式的 `active` 与全部桶**逐项相同**，所以这条就是"没变"。
- **32x32 FILL 1,180 → 1,232（+52）**：把 `ENG_WDWAIT` 拆开看，`PIX_KEEP/DRAIN/ROW_GAP/WAIT_ROW0` 五个桶**逐项不变**，只有 `ENG_WDWAIT` 11 → 63 ⇒ **+52 全在指令尾**。来源：最后一笔突发要等 S_BUF 窗口（16 拍）+ 该笔的 AW/W/B（本环境实测 AW 2 + W 1 + B 2），而旧行为里最后一个词的 AW 是"词到手就当拍发"、4 拍就完。这是合并的**代价常数**（每条命令一次，与命令大小无关）⇒ 整屏摊薄成 0.010%，32x32 这种小命令是 4.4%。
- **清屏引擎未回归**：`tb_blt_top` T10 仍是 `clear cycles=70 AW bursts=2`（32 拍合并成 2×16），`tb_clear_engine`/`tb_clear_engine_off` 全过。
- **全量回归 22 项全过**（原始摘要）：

```
tb_blt_top         ========== tb_blt_top ALL PASS ==========
tb_blt_apb         ========== tb_blt_apb ALL PASS ==========
tb_cmd_fifo        ========== tb_cmd_fifo ALL PASS ==========
tb_regs_axi_lite   ========== tb_regs_axi_lite ALL PASS ==========
tb_blt_unalign     ========== tb_blt_unalign ALL PASS ==========
tb_fifo_full       ========== tb_fifo_full ALL PASS ==========
tb_blt_burst       ========== tb_blt_burst ALL PASS ==========
tb_alpha           ========== tb_alpha ALL PASS ==========
tb_blt_unalign_off ========== tb_blt_unalign ALL PASS ==========
tb_alpha_off       ========== tb_alpha ALL PASS ==========
tb_arb_deadlock    ========== tb_arb_deadlock ALL PASS ==========
tb_fb_scanout      ========== tb_fb_scanout ALL PASS ==========
tb_scanout_scale   ========== tb_scanout_scale ALL PASS ==========
tb_scanout_wd      ========== tb_scanout_wd ALL PASS ==========
tb_axi_rd_arb      ========== tb_axi_rd_arb ALL PASS ==========
tb_rd_arb_leak     ========== tb_rd_arb_leak ALL PASS ==========
tb_wr_order        ========== tb_wr_order ALL PASS ==========
tb_wr_order_off    A/B OK: 屏障 OFF → ========== tb_wr_order FAILED: 4 ==========
tb_scanout_flip    ========== tb_scanout_flip ALL PASS ==========
tb_scanout_flip_off A/B OK: 屏障 OFF → ========== tb_scanout_flip FAILED (9 项) ==========
tb_clear_engine    ========== tb_clear_engine ALL PASS ==========
tb_clear_engine_off A/B OK: 屏障 OFF → ========== tb_clear_engine FAILED (13 项) ==========
==== regress failures: 0 ====
```
（完整日志 `doc/logs/final_regress_v29_merge.txt`）
- **写序保证未被削弱**（`tb_wr_order` 默认全过）：`H1 洞统计: 完成事件 117 次, 写通路未清 0 次`、`H2 写突发在飞峰值: RTL b_pending=1, TB 引脚计数=1`。且合并**不改变** AW→W→B 串行结构 ⇒ "同一时刻最多一笔写突发在飞"仍是结构保证。`PERF-B2（深写回延迟 2 拍）cmds=16 perf_avg=1224`、`PERF-B128（延迟 128 拍）perf_avg=4499` 与改前实测（同一组数）逐项相同。
- **位精确向量**（A/B 两个模式逐字节相同）：FILL 整屏首/末像素 `f800`；32x32 FILL 首/末像素 `07e0` + 越界未动；COPY 行内像素 `f801`；KEY `words=124 / px_written=713 / px_skipped=311`；ALPHA 金标准由 `tb_alpha`（α=0/128/160/255，含 `9B46/7BEF/FD20/0010` 非盲用例）覆盖；非对齐/行尾残余词由 `tb_blt_unalign`（U1~U12，lane 2/3/4/5/7、W=1/8/9/13/20/32、1×64 竖条、200×1 横条、整词键色）覆盖 —— 四类算子 + 非对齐 + 行尾在 **ON/OFF 两个模式**下都 PASS。

### 23.4 残余风险 / 不确定度（P&R 相关，如实列出）

1. **新增寄存器 / 组合**：`hold_max` 8bit（**+8 FF**，这是本轮唯一的时序新增）；`dout_v`/`cnt_more`/`word_here`/`page_ok`/`merge_ok` 全是纯组合，输入都是 FF（`wd_count`/`wd_empty` 来自 FIFO 内部寄存器，`burst_addr`/`burst_len` 是本模块 FF）。`wd_count` 到写主机的这条组合路径新增了 1 级比较 + 1 级与或（约 2 级 LUT），量级等同 `sync_fifo` 自己的 `full/count` 生成逻辑（`full` 本来就已经在喂像素通路的 `wd_full`），不构成新的长路径。
2. **AW/W 路径时序**：`m_axi_awlen = burst_len - 1` 与 `m_axi_awaddr = burst_addr` 仍是 FF→输出（未变）；新增的组合只有"下一拍地址/页边界"比较，它喂的是**寄存器使能**（`burst_len<=burst_len+1`）与 `wd_pop`，不喂 AXI 输出 ⇒ AW/W 组合路径与改前同级。
3. **在飞字节数变多**：单笔突发 16B → 256B，突发内 W 拍连续 16 拍。这在 AXI 上是常规做法（`awsize=4`、`awlen` 最大 15 = 本设计的 `MAX_BEATS`），但**对 DDR 控制器/仲裁器是新的激励形态**：`axi_wr_arb` 的 `yield_c` 条件含 `!b_wvalid`，一笔 16 拍突发期间引擎侧 `wvalid` 连续为高 ⇒ 让位点变少（清屏引擎要用 `WAIT_MAX=32` 的硬让位才能插进来）。`tb_clear_engine` 的 4A/4B（流水竞争者/串行竞争者）与 `tb_blt_top` T10 都过，但**"BitBlt 长突发 + 清屏引擎并发"的联合吞吐没有专项向量**，板上要观察清屏是否被推迟。
4. **尾延迟**：每条命令末尾多等最多 `HOLD_MAX`(=16) 拍左右（见 23.3）；对 960x540 摊薄 0.010%，对 32x32 是 4.4%。若将来要压掉，唯一干净的做法是给写主机一个"命令结束"的显式输入（属 FSM/顶层接口改动，本轮按要求未做）。
5. **未做**：Efinity 综合/P&R（按要求，未跑）；`wd` 长期饱和（`wd_full>0`）场景仍无专项向量（探针全部算子 `wd_full=0`）。

---

## 24. 命令末尾冲刷提示：给写主机的"命令结束"显式输入（RTL 优化第 3 步，本轮）

依据 = §23.4 残余风险第 4 条（"每条命令末尾多等最多 `HOLD_MAX` 拍；要压掉，唯一干净的做法是给写主机一个'命令结束'的显式输入，本轮未做"）。**只改 `rtl/axi_wr_master.v`（新增 1 个输入端口 + 尾模式判据）、`rtl/blt_engine_fsm.v`（新增 1 个输出端口，纯组合）、`rtl/blt_top.v`（1 根线 + 2 行实例化端口）**；寄存器图、命令集、像素通路、地址生成、`sync_fifo`、清屏引擎、扫描输出、仲裁器全部未动；AW→W→B 顺序、单笔在飞、`b_pending`/`wr_idle_committed`/`wr_commit_idle`、引擎 `ST_WDWAIT`/`done_out` 语义**逐字未动**。

### 24.0 结论速览

| 项 | 结论 |
| --- | --- |
| 尾延迟的真正构成（§23 遗留的 +52 拆开） | **16 拍**（尾词孤零零留在 FIFO 里，`cnt_more="后面还有货"` 不成立 ⇒ 并不进当前突发、白等满 `HOLD_MAX`）+ **16 拍**（尾词随后被 `S_IDLE` 取走自成 1 拍突发，它后面当然也没词 ⇒ **又等满一次**）+ **~21 拍**（那笔 15 拍尾突发的 AW→W→B）。三段串起来 = 实测 `ENG_WDWAIT` **63** 拍 |
| 改法 | 引擎在进入 `ST_WDWAIT` 时给出 `wr_cmd_end`（= "本命令再也不会产出写词"）；写主机据此进**尾模式**：① 放宽 `word_here`（不再要求 `cnt_more`）⇒ 尾词能并进当前突发；② 等待判据从"等满 `HOLD_MAX`"换成"`wd_count==0` 后再等 `TAIL_GRACE`(=4) 拍" ⇒ 立刻发车 |
| **32x32 FILL（孤立）** | 1,232 → **1,199 拍**（**−33**，`ENG_WDWAIT` 63 → **30**，其余五桶逐项不变） |
| **32x32 FILL（背靠背 ×64）** | 1,232 → **1,199 拍/块**（T8 `sumPERF=1199`、`AW/blk` 9 → **8**） |
| **整屏 960x540 FILL** | 520,640 → **520,607 拍**（−33，−0.0063%）；**AW 4,051 → 4,050 = 理论下限 ⌈64,800/16⌉**，`burst_max` 仍 **16**、`burst_avg` 15.996050 → **16.000000**（合并率 100%，没有把合并弄丢） |
| 其他算子（32x32） | COPY 1,480 → **1,447**（WDWAIT 62→29）、ALPHA 1,484 → **1,451**（62→29）、KEY 1,476 → **1,443**（58→25）、FILL@fb stride 1,220 → **1,187**（51→18，AW 33→32） |
| 直方图对账 | 六个算子 `hist_sum − PERF = 0`（`sum_delta_vs_active=0`），无新桶、无"其他"黑洞；`wd_full` 周期仍 0、`wd_peak` ≤4 |
| **没有回到 1,180** | 实测 **1,199**，比不合并的基线（1,180）仍多 **19 拍**：这 19 拍 = **最后一整页 16 拍突发自身的 AW→W→B**（1+16+4=21）减掉不合并模式下"1 拍尾突发的 6 拍"，即**合并 + 单笔在飞的固有代价**，不是等待窗口 —— 见 24.3 最后一条 |
| A/B 开关 | `-DWR_CMD_END_FLUSH_OFF` 关掉提示 ⇒ 探针**逐字节回到 v2.9 读数**（520,640 / AW 4,051 / burst_avg 15.996050 / 32x32 = 1,232 / WDWAIT 63） |
| 位精确性 | `tb_alpha`（63 条 PASS）、`tb_blt_unalign`（13 条 PASS）、`tb_blt_burst` 在**默认 / `-DWR_CMD_END_FLUSH_OFF` / `-DPIXEL_PACK_PINGPONG_OFF` 三个模式**下 PASS 行**逐字节相同**，只有 `PERF ... cycles` 行变小（如 16x8 ALPHA 298 → 266 拍） |
| 写序保证 | `tb_wr_order` 默认与 `-DWR_CMD_END_FLUSH_OFF` 都过：`H1 完成事件 117 次 / 写通路未清 0 次`、`H2 RTL b_pending=1 == TB 引脚计数 1`；`PERF-B2 perf_avg` 1224 → **1192**（−32，与探针 −33 同量级） |
| 全量回归 | **27 项 0 失败**（新增 4 项 A/B 对照：`tb_alpha_cmdtail_off`、`tb_blt_unalign_cmdtail_off`、`tb_blt_burst_cmdtail_off`、`tb_wr_order_cmdtail_off`），摘要见 24.3 |

### 24.1 逐拍根因（尾延迟三段）

稳态里写主机远快于生产者（合并后 AXI 侧 1.13 拍/词 ≪ 像素通路 8 拍/词），所以它**永远在 `S_BUF` 等下一个词**，而"下一个词"在一条命令里总会来、在命令末尾永远不来 —— §23 的 `HOLD_MAX` 窗口对前者是对的，对后者是纯浪费。命令末尾的实际时间线（以 32x32 FILL 的最后一整页为例，`bl` = `burst_len`）：

| 段 | 拍数 | 发生了什么 |
| --- | --- | --- |
| ① 尾词等同伴 | **16** | 最后一个词入 FIFO（`wd_count=1`、`dout` 上是它）⇒ `cnt_more = (wd_count>1) = 0` ⇒ `word_here=0` ⇒ 不算"可并入的新词"，`hold_max` 一路数到 16 才发车 |
| ② 尾页突发的 AW→W→B | **~21** | 发的是 `bl=15` 的那笔（1 拍 AW + 15 拍 W + 4 拍 B） |
| ③ 尾词自成突发、又等一次 | **16 + ~6** | 尾词被 `S_IDLE` 取走 → `S_BUF` → 它后面依然没有词 → **`hold_max` 再数一遍 16** → 发一笔 1 拍突发（1+1+4） |
| ④ FIFO 流水/判定余量 | ~5 | `sync_fifo` 写入到 `dout` 有效 3 拍 + 合流判定 |
| **合计** | **≈63** | 与实测 `ENG_WDWAIT=63` 吻合（其余五桶 `PIX_KEEP 1024 / ROW_GAP 96 / DRAIN 32 / POP 15 / DEC+INIT 2` 逐项不变） |

**关键认识**：`cnt_more`（"队头之后还有货"）这条保守判据在**稳态**是正确的（它躲开了弹字空窗那一拍的 `dout` 旧值），但在**命令末尾永远不成立**；而 §23 加 `HOLD_MAX` 是为了救稳态、恰好把末尾的代价放大成"等两次"。两处都不是 bug，是同一个判据服务两个互相矛盾的场景 —— 所以修法不是改判据，而是**让引擎把"现在是末尾"这件事显式告诉写主机**。

### 24.2 改动

**`rtl/blt_engine_fsm.v`（+1 输出端口，纯组合）**

```verilog
output wire wr_cmd_end;                    // 命令末尾冲刷提示 → axi_wr_master.cmd_end_flush
assign wr_cmd_end = (st == ST_WDWAIT);     // 本命令像素已全部产出，再也不会给写词
```

为什么用 `ST_WDWAIT` 而不是"最后一个词落进 wd FIFO"：引擎在这一刻就**确定**不会再有写词（像素通路已交回、行指针到头），而尾词从"落 staging → `wd_wr` → FIFO 写 mem → 可读"还要 3~4 拍；这几拍由写主机侧的 `TAIL_GRACE` 兜住，不必把 `pixel_path` 的内部流水引出来（保持改动局部）。`ST_WDWAIT` 一直持续到 `wr_commit_idle` 成立，即覆盖整个尾活窗口，而且**不会跨到下一条命令**（引擎回 IDLE 前提示一直有效，回 IDLE 后下一条命令还要 POP/DEC/EXEC 十几拍才可能产词）。

**`rtl/axi_wr_master.v`（端口 +1、参数 +1、寄存器 +4FF、S_BUF 分支改造）**

- 新增端口 `cmd_end_flush`；新增参数 `TAIL_GRACE`（默认 4，做成参数便于扫描）。
- `wire tail_mode = CMD_END_FLUSH_EN && cmd_end_flush;`
- `wire word_here = dout_v && (tail_mode || cnt_more);` —— 尾模式下放宽成"`dout` 上真有新词"即可（`dout_v` 本来就排掉了弹字空窗那一拍，所以并进来不会重复计数）。
- `S_BUF` 分支：`merge_ok` 照旧优先；然后 `!word_here` 时分两种等待口径 ——
  - 尾模式：`wd_count != 0` 就继续等（FIFO 里还有字，1~2 拍后就读出来）；`wd_count == 0` 则最多再等 `TAIL_GRACE` 拍（给"刚入队、还在同步读流水里"的尾词留时间）**然后立刻发车**；
  - 非尾模式：`MERGE_HOLD_EN && hold_max < HOLD_MAX` 继续等，否则发车（**与改前逐字相同**）。
- `else st <= S_AW;`（有新词但并不过去：地址跳变/跨 4KB/已满 16 拍）—— 这一支也与改前相同。
- **A/B 逃生门**：`-DWR_CMD_END_FLUSH_OFF` ⇒ `CMD_END_FLUSH_EN=0`，尾模式彻底消失；且 `CMD_END_FLUSH_EN = MERGE_HOLD_EN`（不合并时尾模式无意义），保证 `-DWR_MERGE_HOLD_OFF` 的读数仍与改前逐字节一致。
- **未动**：`S_IDLE/S_AW/S_W/S_B` 与 `b_pending`/`wr_idle_committed`/`wr_commit_idle`；`m_axi_aw*`/`w*`/`bready` 的产生方式；`bmask` 逐拍 16bit WSTRB 直通（非对齐/半词/键色留孔的掩码语义不变）；4KB 跨页检查；`MAX_BEATS=16`。

**为什么"提示"不可能伤到数据通路**：提示只影响**什么时候冲刷**，不影响任何字节的产生与顺序。即使提示来早了（理论上不可能，因为它绑在 `ST_WDWAIT` 上），最坏结果也只是"把突发切碎"（退化成不合并的节拍），**不会丢词**（`S_IDLE` 照旧 `!wd_empty` 取首词）、**不会重复**（`wd_pop` 与 `merge_ok` 同拍，弹字后 `out_v=0` 那一拍不可能再弹同一个词）、**不会乱序**（AW→W→B 串行 + 单笔在飞未动）。也**不会让完成判据提前**：`done_out`/`ST_WDWAIT` 出口仍要求 `wr_commit_idle`（含 `b_pending==0`），"命令不得早于其写被受理而报完成"这条保证一字未改。
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
