pekeppp/2D_Rendering_Acceleration-deprecated-v3.2/(commit log)

2026-09-25 初始提交：RISC-V + FPGA 异构 2D 渲染加速引擎（赛题二）
    基于 Efinity Ti60F225 + Sapphire RISC-V SoC 的 BitBlt 2D 加速器，含：
    - rtl/ 加速器 RTL（v3.2：显示列表 / 透明块掩码 / 双 lane 像素通路 /
    属性侧口 + scissor + 扫描输出颜色 LUT）+ 全部 testbench
    - ARC_2DRA/ Efinity 工程与嵌入式软件（FinalDemo / AdDemo / GameDemo 等 demo）
    - doc/ 赛题、方案设计、性能优化成果、开发问题与解决记录、仿真与自检日志
    - tools/ 串口上位机（Web Serial）、主机自检、一键构建流水线
    - firmware/ 可直接烧写的位流与固件镜像
    本次新增：GameDemo —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
    [external.cfg, flash.cfg, flash_softTap.cfg, flash_ti.cfg, flash_tz.cfg, ftdi.cfg, ftdi_ti.cfg, ftdi_tz.cfg]
2026-09-27 补充赛题二设计实现与测试报告、后续提升方向对照，并修正 logs 目录指引
